instructorJasonWhite/c3-scout-robot/05-Factory-CarrierC-v10/README.txt

C3 SCOUT CARRIER C — FACTORY REVISION v10
2026-10-05 America/New_York

Upload these together:
1. C3-CarrierC-v10-Gerbers.zip
2. C3-CarrierC-v10-BOM.csv
3. C3-CarrierC-v10-CPL.csv

Board v10 / schematic v6 saved through Fusion MCP. Native DRC: zero errors; ERC: same 13 power-net-name warnings. 24 BOM groups / 45 placements: 44 SMT + C1 through-hole. Hand-install only U1 SuperMini.

Q1 C7419210; U4 C351410; C1 C713389; J5 C456012. USB-C footprint now has four 0.6 x 1.4 mm plated slots; finished copper lands 1.1 x 1.9 mm after Fusion pad rules. J5 CPL uses body centre (28.6,24), R90. C1 positive pad (23.75,14).

See UPLOAD-GUIDE.html for drawings, source, verification and protection-component qualification notes. New Gerbers are required; do not mix with v8. No order placed.
