instructorJasonWhite/c3-scout-robot/01-Electronics-CarrierC/Carrier-Review.html

SCOUT / Carrier C

Earlier design review · current release is Carrier C v10. Embedded diagrams and part selections below document the earlier design. Q1, U4, C1 and the USB-C connector have since been updated. Open the current factory package, BOM, board previews and Fusion PDFs.

NATIVE FUSION DESIGN · REV C

# A small board. A proper design.

One carrier for the whole rover. Charging, cell protection, motor control and clean logic power—organized around a solder-on ESP32-C3 SuperMini.

Explore the board ↘Schematic PDF ↓

Rebuilt and routed in Fusion Electronics through Fusion MCP.
Circuit review · 04 October 2026 · Silk 03 update · 05 October 2026 · Hardware validation pending.

Carrier C routed board with top and bottom traces

32 × 82 MM2 LAYERS / 1 OZ

Manufacturing corrections verified · Fusion board v8: all nine silk clearance findings, three mask slivers and three copper notches are resolved. Both Genies and component positions are preserved. Native DRC and unrouted count are zero. Read the corrected JLCPCB report ↗. Final CAM and prototype validation remain.

04organized schematic sheets

46fitted components / 56 references

0unrouted connections in Fusion

0reported board DRC errors

ERC contains 13 reviewed supply-name warnings. This is an electrically checked design review; physical fit, current, temperature and assembly availability still require confirmation.

01 / Circuit architecture

## Each function has a place.

Keep high motor current on the cell rail. Generate 5 V for the controller, and isolate its logic signals when the motor supply is off.

USB-C charge inputJ5 · separate 5.1 kΩ CC resistors

→

TP4056 chargerU3 · 500 mA nominal · two status LEDs

→

One 18650 cellJ1 · 4.2 V full · DW01A + FS8205A return protection

Protected cell + RUNF1 2 A hold · J4 offboard switch

→

Two power branchesVMOTOR → TC1508A
MT3608 → 5.10 V → D4

→

Drive + controlTwo N20 motors
SuperMini, ADC and TXU0104

01

### Charge & protect

The raw cell negative is kept separate from the protected ground. Charger thermal pad, bypass capacitors and both USB-C CC resistors are explicit in the schematic.

02

### Switch & regulate

The RUN switch disconnects the drive rail. A compact 4.7 µH boost stage supplies the SuperMini through a blocking diode; the motor supply follows the cell.

03

### Control & measure

A four-channel level translator drives the motor inputs. Pull-downs establish disabled defaults; a 330 kΩ / 100 kΩ divider filters the battery measurement.

Operating rule: RUN OFF while charging or programming. This circuit has no charge-and-run load sharing. TP4056 TEMP is grounded, so cell-temperature sensing is disabled.

02 / Native schematic

## Four sheets. Every part visible.

Functional boundaries, actual pin names, conventional symbols, local wiring and named nets. These previews are printed from the linked Fusion schematic.

01 Charging & protection02 Power & boost03 Controller & sensing04 Motor interface

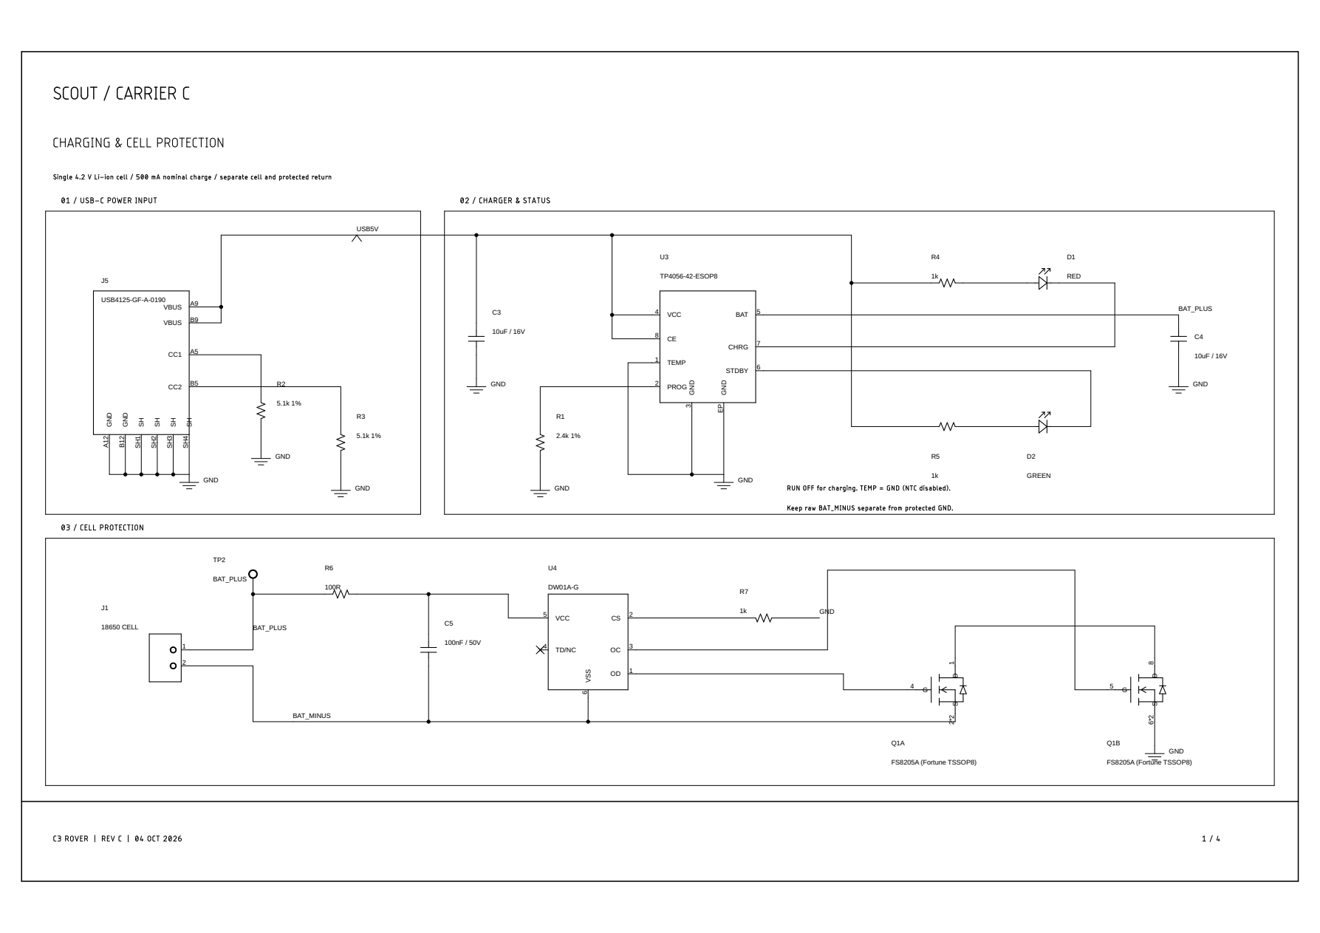
[picture p2: 01-Electronics-CarrierC/assets/schematic-1.png]
Native schematic sheet 1: Charging and cell protection


Sheet 1 / 4 · Charging and cell protection · Select the image to open the vector PDF.

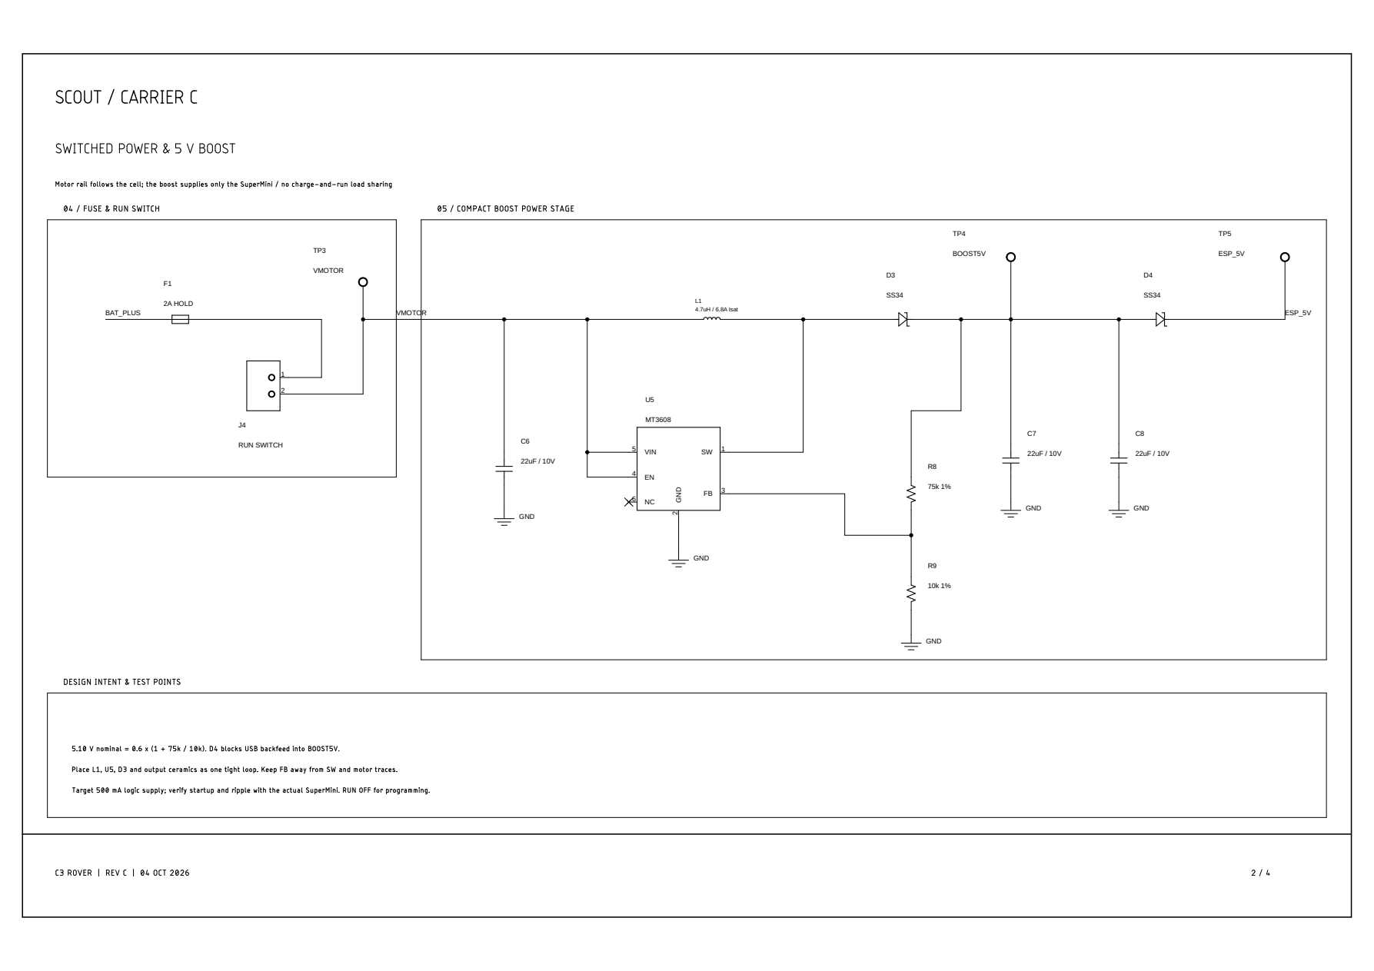
[picture p3: 01-Electronics-CarrierC/assets/schematic-2.png]
Native schematic sheet 2: Switched power and 5 V boost


Sheet 2 / 4 · Switched power and 5 V boost · Select the image to open the vector PDF.

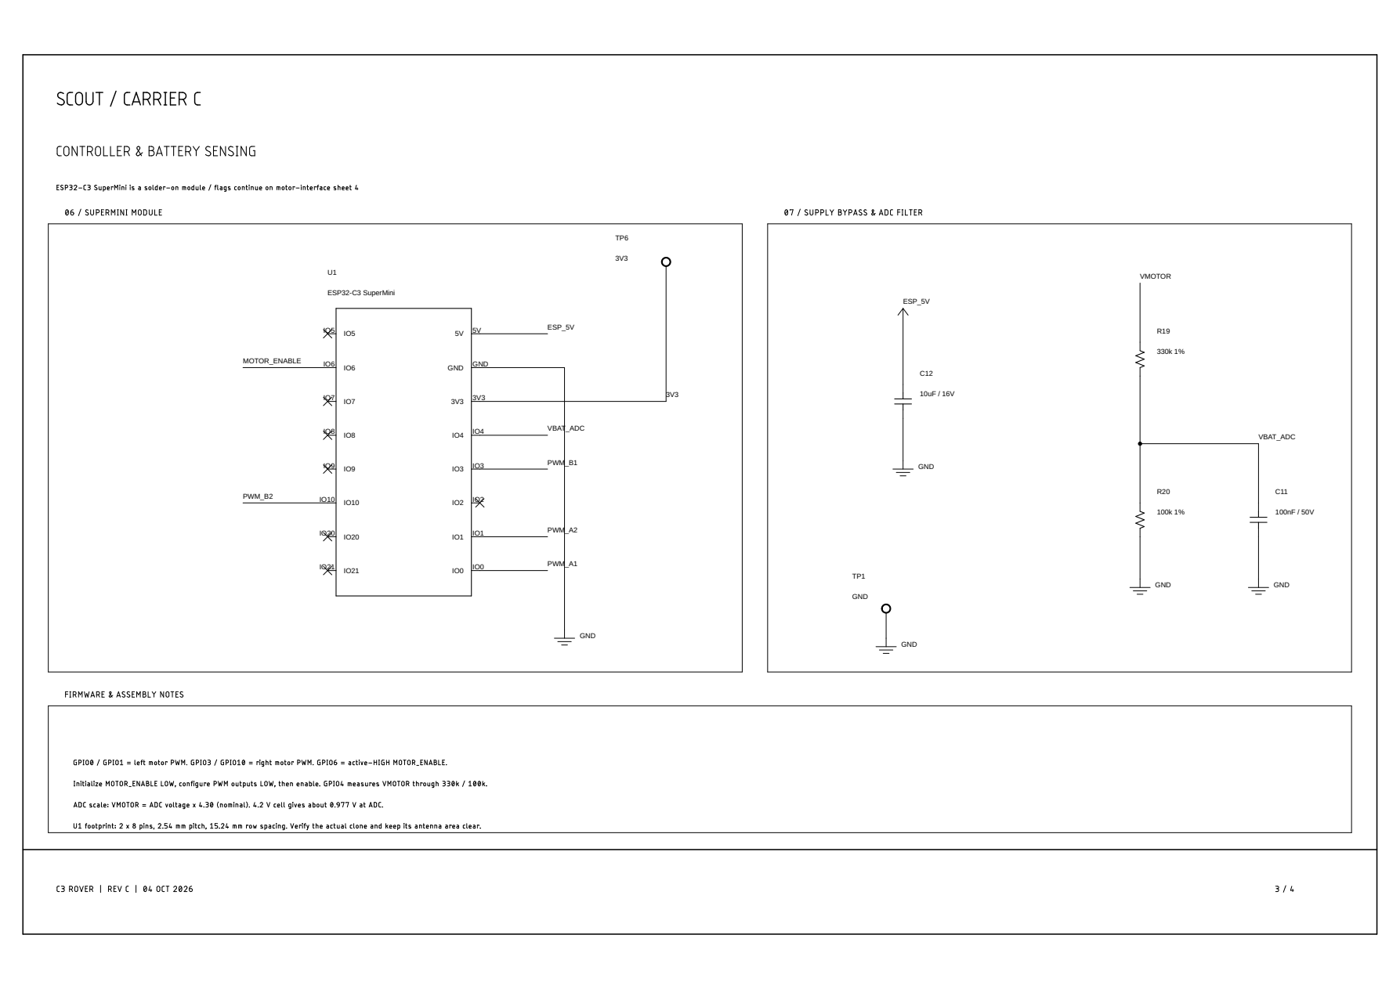
[picture p4: 01-Electronics-CarrierC/assets/schematic-3.png]
Native schematic sheet 3: Controller and battery sensing


Sheet 3 / 4 · Controller and battery sensing · Select the image to open the vector PDF.

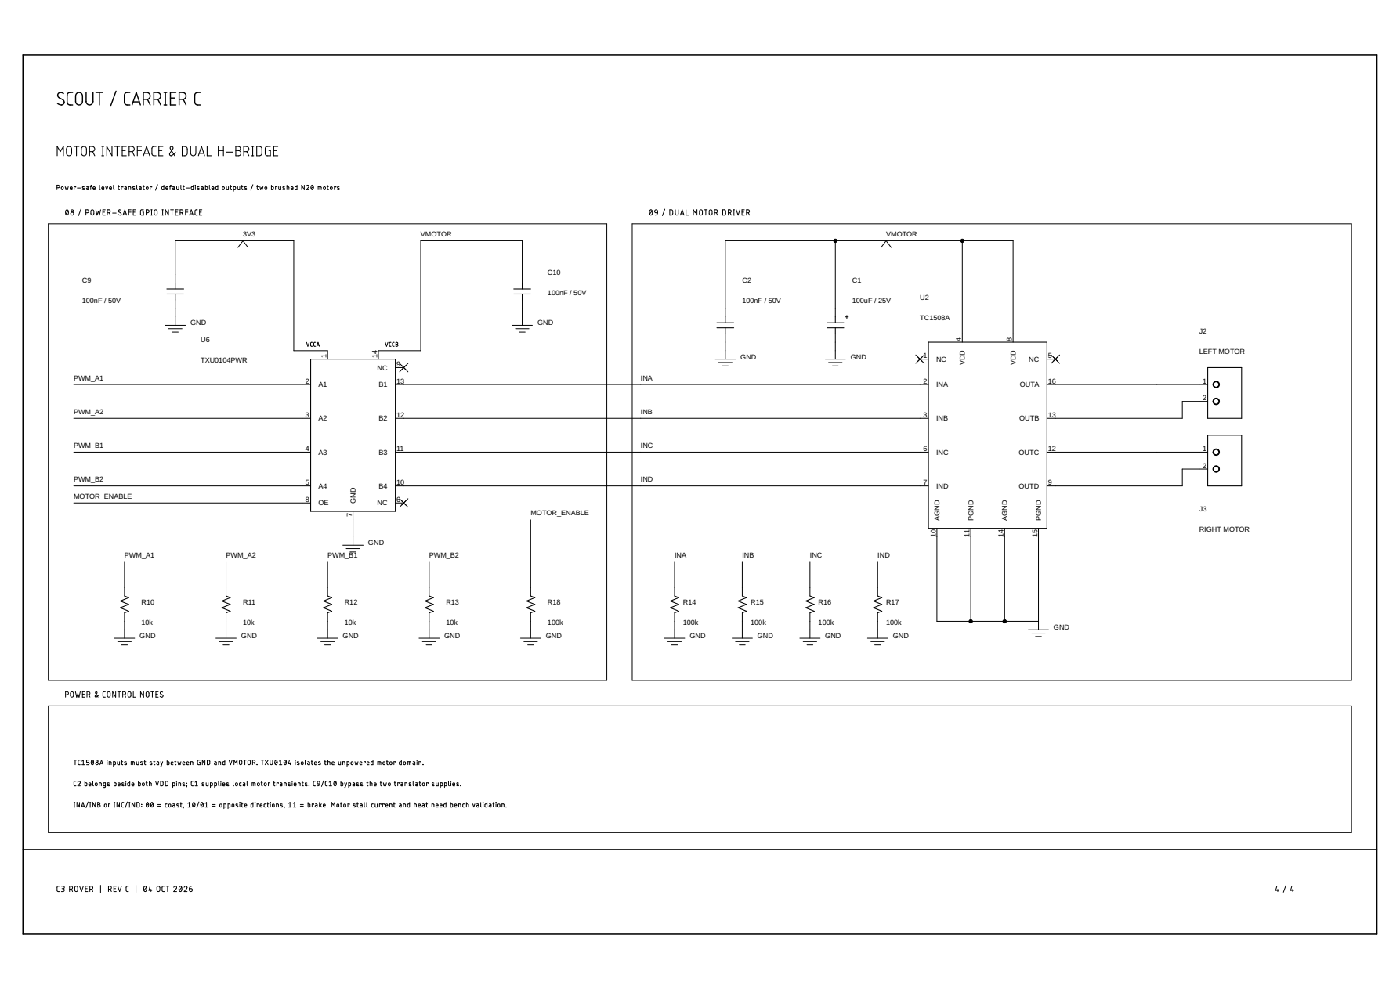
[picture p5: 01-Electronics-CarrierC/assets/schematic-4.png]
Native schematic sheet 4: Motor interface and dual H bridge


Sheet 4 / 4 · Motor interface and dual H bridge · Select the image to open the vector PDF.

Open all four sheets ↗Editable schematic ↓

03 / Placement & routing

## Follow the copper.

Choose a net to isolate its traces. Select a reference to see its value, footprint, position and connections. Both layers are viewed from the top.

Top copperBottom copper

### Board explorer

Top traces and padsBottom traces and padsComponent referencesHighlight a netFind a component

EnlargeReset

Selected component

### U5

MT3608 · 5 V boost regulator

Click any reference on the board to inspect the native placement.

Coordinate-based view of the exported Fusion board. Ground fills are omitted to expose routing. Hatched zones show antenna and M3 screw clearance. Body outlines are assembly graphics.

### Motor end

U2 sits beside the two motor wire pads. C1 supplies transient current; C2 bypasses the driver rail. Motor routing uses 0.6 mm traces with wider supply spines.

### Power island

The USB input and charger share the side opening. U4/Q1 protect the cell return. L1/U5/D3 and the boost capacitors form the regulation section.

### Controller end

The SuperMini sits above the carrier with an antenna cutout. C11/R19/R20 form the ADC filter. Four 3.4 mm holes preserve the M3 chassis interface.

Native board prints: top traces, bottom traces, assembly and underside labels

Fusion’s native trace print retains solid restriction overlays at the antenna and screws. The PDF explains these explicitly; they represent copper exclusions. Ground fills are hidden for trace review.

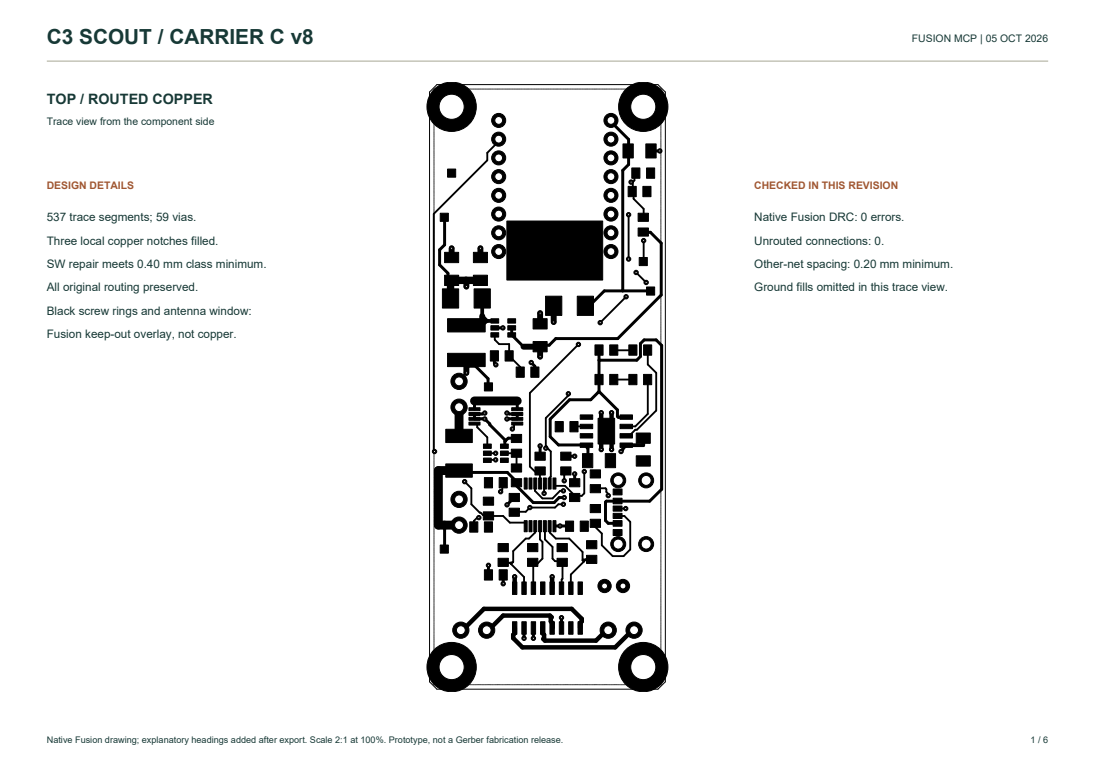
[picture p6: 01-Electronics-CarrierC/assets/layout-1.png]
Top traces, fills hidden


Top traces, fills hidden

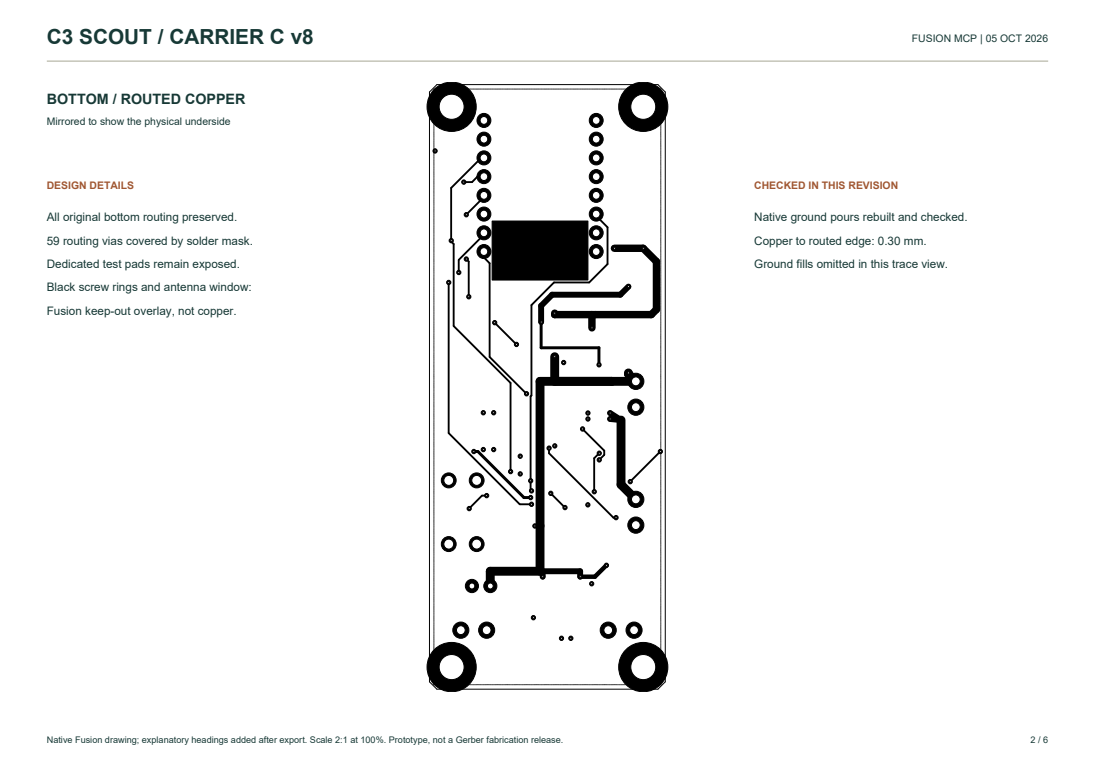
[picture p7: 01-Electronics-CarrierC/assets/layout-2.png]
Bottom traces, viewed through top


Bottom traces, viewed through top

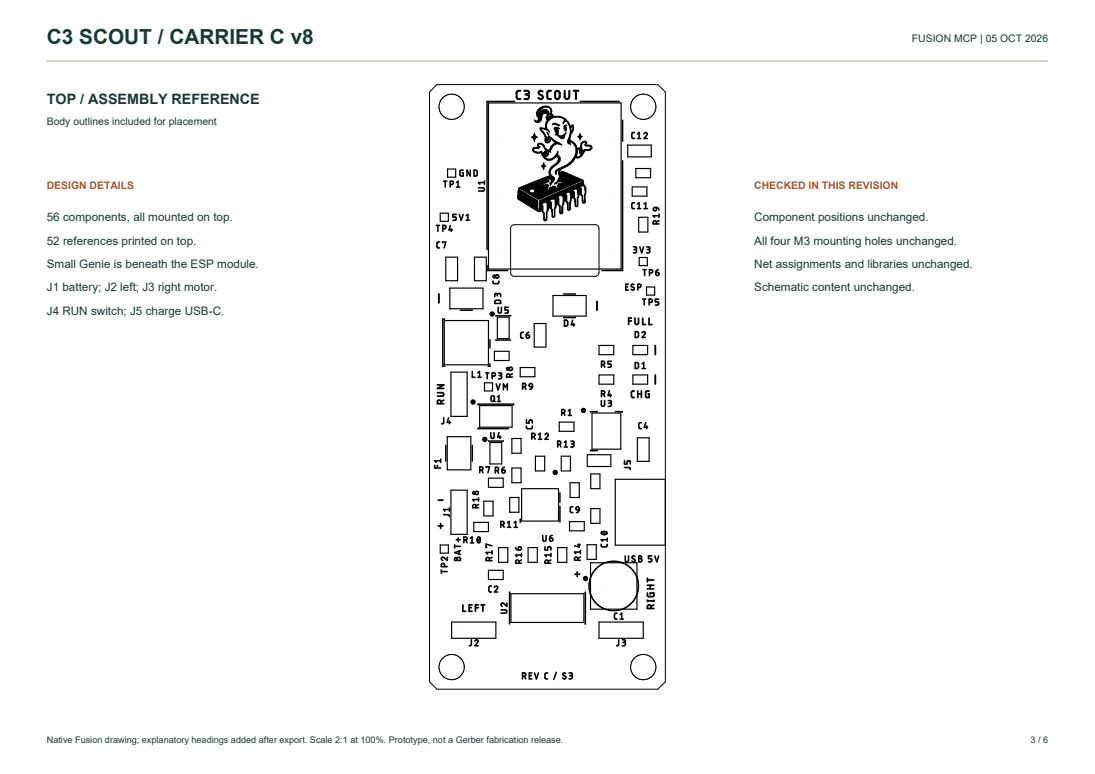
[picture p8: 01-Electronics-CarrierC/assets/layout-3.png]
Top assembly references


Top assembly references

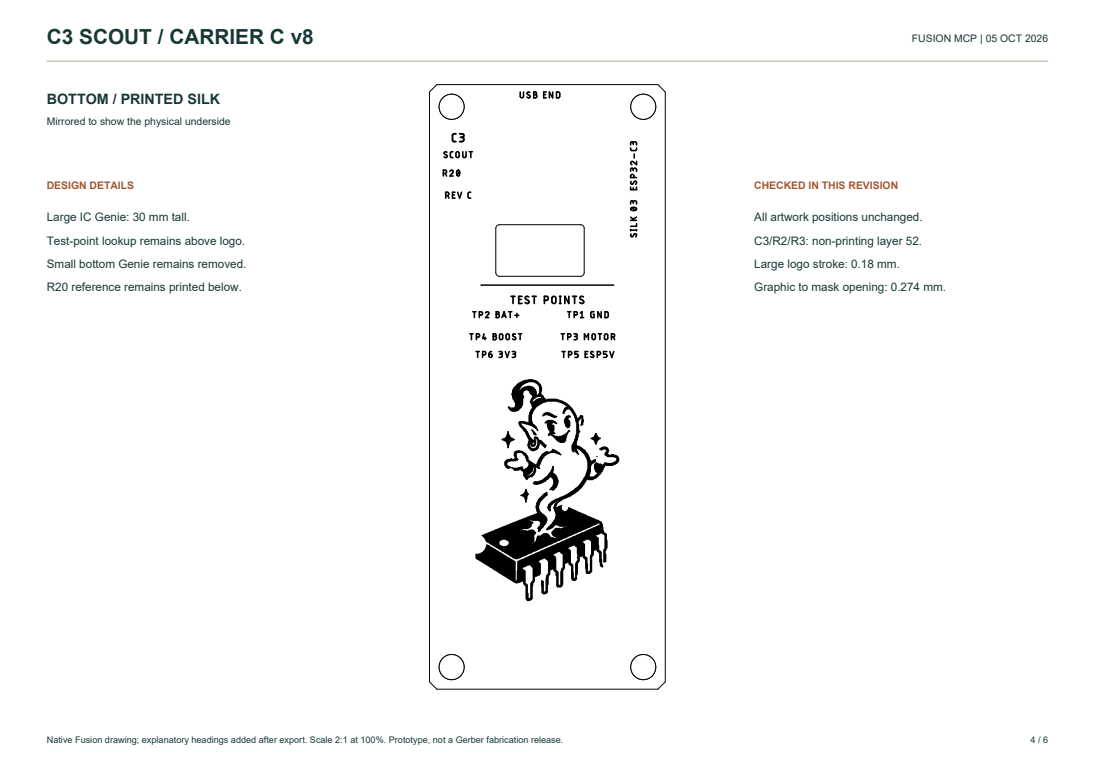
[picture p9: 01-Electronics-CarrierC/assets/layout-4.png]
Underside service silkscreen / Silk 03


Underside service silkscreen / Silk 03

Board layout PDF ↓

04 / Assembly & operation

## Designed to be understood.

All components are on the top. The underside carries readable reference labels. Hand-solder the SuperMini, USB connector and radial bulk capacitor.

### External connections

Reference | Connection | Notes
J1 | 18650 cell | 1 = BAT_PLUS; 2 = raw BAT_MINUS
J2 | Left N20 motor | 1 = OUTA; 2 = OUTB
J3 | Right N20 motor | 1 = OUTC; 2 = OUTD
J4 | RUN switch | 1 = fused battery; 2 = VMOTOR. Use ≥3 A DC switch.
J5 | USB-C charging | 5 V input. No USB data.
U1 USB | Programming | RUN OFF. Verify actual SuperMini clone pinout.

### Controller assignments

GPIO | Function
0 / 1 | Left motor PWM_A1 / PWM_A2
3 / 10 | Right motor PWM_B1 / PWM_B2
6 | MOTOR_ENABLE, active high
4 | VMOTOR ADC; nominal voltage = ADC × 4.30

### Firmware startup intent

Control sequence for implementation; no new firmware is supplied in this revision.

Hold MOTOR_ENABLE low

R18 also holds the translator disabled during startup.

Configure all four PWM outputs low

Input and output pull-downs prevent floating motor commands.

Measure the cell rail

Calibrate GPIO4 ADC. A full 4.2 V cell produces about 0.977 V at the divider.

Enable drive only when ready

Raise GPIO6, then apply PWM. Stop on undervoltage or control loss; choose the threshold for the actual cell and load.

Disable before charging or programming

Set outputs low, disable drive and turn RUN OFF.

### Bench measurement points

TP1 / TP2 | Protected GND / raw cell positive
TP3 | Switched cell rail, VMOTOR
TP4 / TP5 | 5.10 V nominal boost / diode-isolated ESP_5V
TP6 | SuperMini 3V3

Fit checks before fabrication: confirm the actual SuperMini’s 15.24 mm row spacing and 2.54 mm pitch. J5 retains four 1.35 mm round shell holes from the chassis design instead of the connector’s recommended 0.6 × 1.2 mm slots; trial-fit its stakes. Carrier C preserves the board outline and mounting interface; the chassis 3D assembly has not been regenerated in this electrical revision.

05 / Sourcing

## Orderable parts. Visible exceptions.

27 grouped BOM rows cover all 56 references. 43 components are SMT assembly candidates; 3 are planned for hand assembly. Ten references are PCB wire pads or test points.

### Catalog matched

Motor driver, charger, MOSFET, boost IC, translator, inductor, capacitors and common passives have specific JLC/LCSC candidate codes.

### Stock is unresolved

Fortune DW01A-G is cataloged by JLC, but LCSC reports it unavailable. R1, R8 and R19 have LCSC matches; their JLC assembly availability is unverified.

### Quote when ready

Catalog presence is not a stock reservation. No live assembly quote or purchase is included. Recheck stock, extended-part fees and placement rotations when ordering.

BOM workbook ↓

27 grouped rows

References / package | Qty | Specification | Exact candidate | Assembly status | Source / notes
U12 x 8 / 2.54 mm | 1 | ESP32-C3 SuperMiniUser module | ESP32-C3 SuperMini | Hand solderUser supplied | User / PCB featureVerify clone pinout and 15.24 mm row spacing. Antenna over cutout; component side above carrier.
U2SOP-16 | 1 | Dual motor driverShenzhen Fuman | TC1508AC5142992 | ExtendedJLC catalog confirmed; stock not verified | Catalog ↗ (https://jlcpcb.com/partdetail/Shenzhen_FumanElec-TC1508A/C5142992)Validate actual N20 stall current and package temperature.
U3ESOP-8 with exposed pad | 1 | 500 mA chargerTop Power | TP4056-42-ESOP8C16581 | ExtendedJLC catalog confirmed; stock not verified | Catalog ↗ (https://jlcpcb.com/partdetail/TP4056-42-ESOP8/C16581)R1 = 2.4 kohm. RUN OFF while charging. TEMP grounded; no cell-temperature sensing.
U4SOT-23-6 | 1 | Cell protectionFortune | DW01A-GC61503 | ExtendedJLC catalog confirmed; LCSC reports unavailable | Catalog ↗ (https://jlcpcb.com/partdetail/FortuneSemicon-DW01AG/C61503)Source or pre-order exact part. Do not substitute DW01+ without reviewing thresholds.
Q1TSSOP-8 | 1 | Dual common-drain N-MOSFETFortune | FS8205AC14212 | ExtendedJLC catalog confirmed; stock not verified | Catalog ↗ (https://jlcpcb.com/partdetail/LCSC-FS8205A/C14212)Exact Fortune TSSOP-8 pinout. SOT-23-6 parts sharing the name are not equivalent.
U5SOT-23-6 | 1 | 5.10 V boostAerosemi | MT3608C84817 | ExtendedJLC catalog confirmed; stock not verified | Catalog ↗ (https://jlcpcb.com/partdetail/C84817)Nominal 0.6 x (1 + 75k/10k). D4 drop precedes SuperMini 5V input.
U6TSSOP-14 | 1 | 4-channel level translatorTexas Instruments | TXU0104PWRC2938871 | ExtendedJLC catalog confirmed; stock not verified | Catalog ↗ (https://jlcpcb.com/partdetail/TexasInstruments-TXU0104PWR/C2938871)OE pulled low; separates 3V3 control from switched motor domain.
L16 x 6 x 4.5 mm max | 1 | 4.7 uH / 4.5 A Irms / 6.8 A IsatBourns | SRN6045TA-4R7MC2044594 | ExtendedJLC catalog confirmed; stock not verified | Catalog ↗ (https://jlcpcb.com/partdetail/BOURNS-SRN6045TA4R7M/C2044594)Manufacturer land pattern: 5.1 x 1.8 mm pads, 4.7 mm centers. Footprint updated in Fusion.
D3, D4SMA | 2 | SS34 / 3 A / 40 VMDD | SS34C8678 | BasicJLC catalog confirmed; stock not verified | Catalog ↗ (https://jlcpcb.com/partdetail/Mdd-SS34/C8678)Pad 1 = cathode.
F11812 | 1 | 2 A hold / 16 V PTCLittelfuse | 1812L200/16DRC439873 | ExtendedJLC catalog confirmed; stock not verified | Catalog ↗ (https://jlcpcb.com/partdetail/Littelfuse-1812L20016DR/C439873)3.5 A trip rating; temperature derating applies.
D10805 | 1 | Red indicatorNationStar | NCD0805R1C84256 | BasicJLC catalog confirmed; stock not verified | Catalog ↗ (https://jlcpcb.com/partdetail/NCD0805R1/C84256)Footprint pad 1 = anode; verify assembly-library rotation.
D20805 | 1 | Green indicatorKento | KT-0805GC2297 | BasicJLC catalog confirmed; stock not verified | Catalog ↗ (https://jlcpcb.com/partdetail/Hubei_KentoElec-KT0805G/C2297)Footprint pad 1 = anode; verify assembly-library rotation.
C1Radial 6.3 x 11.2 mm; 2.5 mm pitch | 1 | 100 uF / 25 V / low impedancePanasonic | EEUFR1E101 | Hand solderManufacturer dimensions verified; distributor quote required | Catalog ↗ (https://industrial.panasonic.com/kr/products/pt/aluminum-cap-lead/models/EEUFR1E101)Positive pad 1. 455 mA rms ripple at 100 kHz; 130 mohm impedance max.
C2, C5, C9, C10, C110805 | 5 | 100 nF / 50 V / X7R / 10%Samsung | CL21B104KBCNNNCC1711 | CatalogJLC catalog confirmed; stock not verified | Catalog ↗ (https://jlcpcb.com/partdetail/CL21B104KBCNNNC/C1711)
C3, C4, C121206 | 3 | 10 uF / 16 V / X7R / 10%Murata | GRM31CR71C106KA12LC97954 | ExtendedJLC catalog confirmed; stock not verified | Catalog ↗ (https://jlcpcb.com/partdetail/MurataElectronics-GRM31CR71C106KA12L/C97954)
C6, C7, C81206 | 3 | 22 uF / 10 V / X7R / 20%KEMET | C1206C226M8RACTUC2167682 | ExtendedJLC catalog confirmed; stock not verified | Catalog ↗ (https://jlcpcb.com/partdetail/KEMET-C1206C226M8RACTU/C2167682)Confirm effective capacitance under DC bias when qualifying the boost supply.
R10805 | 1 | 2.4 kohm / 1% / 0.125 WUNI-ROYAL | 0805W8F2401T5EC17526 | VerifyLCSC catalog confirmed; JLC availability unverified | Catalog ↗ (https://www.lcsc.com/product-detail/C17526.html)
R2, R30805 | 2 | 5.1 kohm / 1% / 0.125 WUNI-ROYAL | 0805W8F5101T5EC27834 | BasicJLC catalog confirmed; stock not verified | Catalog ↗ (https://jlcpcb.com/partdetail/0805W8F5101T5E/C27834)
R4, R5, R70805 | 3 | 1 kohm / 1% / 0.125 WUNI-ROYAL | 0805W8F1001T5EC17513 | BasicJLC catalog confirmed; stock not verified | Catalog ↗ (https://jlcpcb.com/partdetail/0805W8F1001T5E/C17513)
R60805 | 1 | 100 ohm / 1% / 0.125 WUNI-ROYAL | 0805W8F1000T5EC17408 | BasicJLC catalog confirmed; stock not verified | Catalog ↗ (https://jlcpcb.com/partdetail/0805W8F1000T5E/C17408)
R80805 | 1 | 75 kohm / 1% / 0.125 WUNI-ROYAL | 0805W8F7502T5EC17819 | VerifyLCSC catalog confirmed; JLC availability unverified | Catalog ↗ (https://www.lcsc.com/product-detail/C17819.html)
R9, R10, R11, R12, R130805 | 5 | 10 kohm / 1% / 0.125 WUNI-ROYAL | 0805W8F1002T5EC17414 | BasicJLC catalog confirmed; stock not verified | Catalog ↗ (https://jlcpcb.com/partdetail/0805W8F1002T5E/C17414)
R14, R15, R16, R17, R18, R200805 | 6 | 100 kohm / 1% / 0.125 WUNI-ROYAL | 0805W8F1003T5EC149504 | BasicJLC catalog confirmed; stock not verified | Catalog ↗ (https://jlcpcb.com/partdetail/0805W8F1003T5E/C149504)
R190805 | 1 | 330 kohm / 1% / 0.125 WUNI-ROYAL | 0805W8F3303T5EC17629 | VerifyLCSC catalog confirmed; JLC availability unverified | Catalog ↗ (https://www.lcsc.com/product-detail/C17629.html)
J5USB4125 custom round-stake footprint | 1 | USB-C power inputGCT | USB4125-GF-A-0190 | Hand solderManufacturer part selected; JLC listing not found | Catalog ↗ (https://gct.co/connector/usb4125)Round 1.35 mm shell holes retained. Trial-fit connector before ordering boards; manufacturer drawing specifies slots.
J1, J2, J3, J42-wire solder pads, 3.5 mm pitch | 4 | Battery / motors / RUN switchPCB feature | No fitted connector | PCB featureNo purchased component | User / PCB featureJ4 connects to external switch rated at least 3 A DC. Harness is outside carrier BOM.
TP1, TP2, TP3, TP4, TP5, TP61.1 mm exposed pad | 6 | Rail test pointPCB feature | Test pad | PCB featureNo purchased component | User / PCB feature

Package-specific choices matter. Q1 is the Fortune FS8205A in TSSOP-8, not a same-marking SOT-23 device. L1 uses the Bourns SRN6045TA-4R7M recommended footprint. C1 is the 25 V Panasonic part with 2.5 mm lead spacing.

Silk 03 / 05 October 2026

## Clearer assembly. A finished identity.

Saved in Fusion as Carrier C v8. All 56 component references remain attached to their parts: 52 on top, one below, three on non-printing assembly layer 52. Artwork and placement are unchanged; v8 includes the local copper and mask corrections.

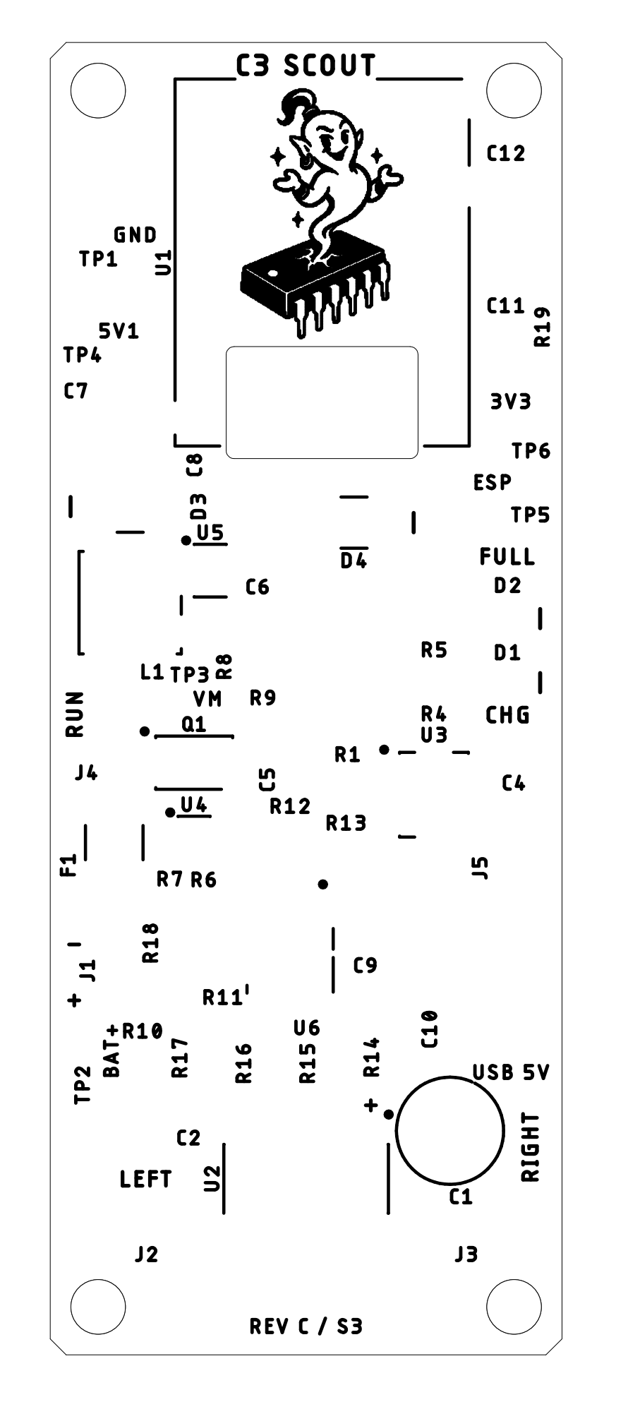
[picture p10: 01-Electronics-CarrierC/assets/top-silk.png]
Native top silkscreen artwork


Top: small IC Genie beneath the ESP, connector labels, polarity, pin 1 and assembly references.

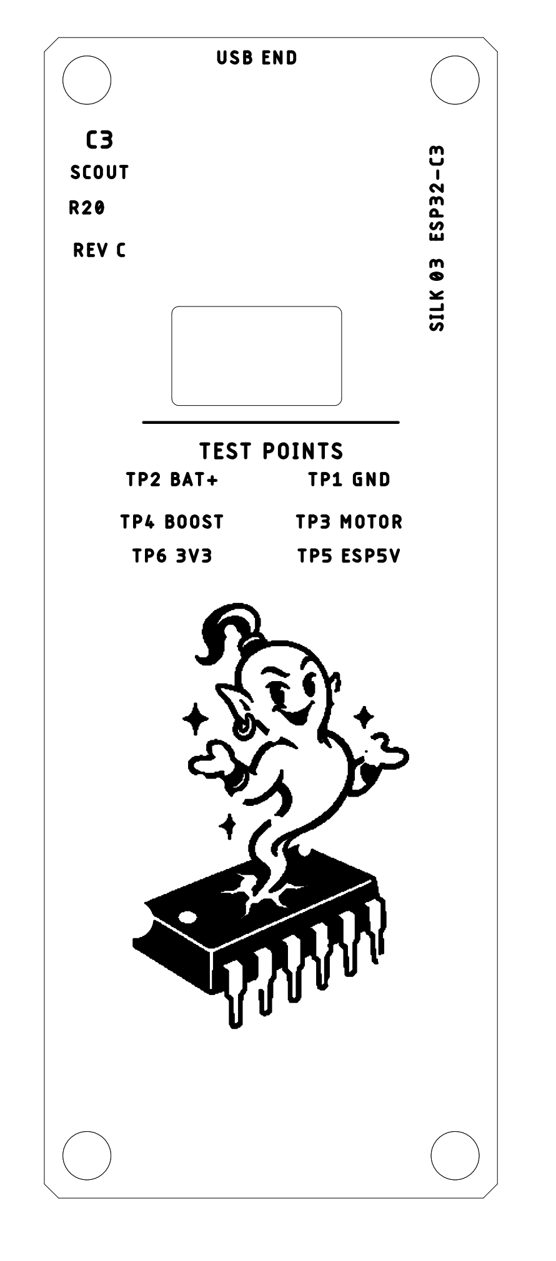
[picture p11: 01-Electronics-CarrierC/assets/bottom-silk.png]
Native bottom silkscreen artwork


Bottom: large IC Genie mascot, compact identity and test-point key.

Explore the silkscreenSilkscreen PDF

Native DRC: 0 errors. Text: at least 1.0 mm high with 0.20 mm strokes. R20 is printed underneath; C3/R2/R3 remain on non-printing assembly layer 52. Verification report.

06 / Verification record

## Measured checks. Documented limits.

The files below contain the actual native Fusion ERC/DRC results and independent connectivity and geometry audit results.

✓

Fusion DRC: 0 errors

Full board check, including copper restrictions, drill clearance and silkscreen checks. No remaining unrouted connections.

✓

Linked schematic and board

56 references, 37 nets and 162 connected contacts match. All native values and packages match. 173 schematic symbol pins inspected.

✓

Independent geometry audit

771 discrete copper objects checked. 537 trace segments and 59 vias. Minimum observed clearance 0.20 mm; minimum drill gap 0.50 mm.

✓

Native drawings visually reviewed

Four schematic sheets, both trace layers, top assembly and the Silk 03 printed artwork. The sourcing workbook covers every reference exactly once.

The independent geometry audit covers discrete traces, pads and vias. Native Fusion DRC verifies filled-plane connectivity and clearance; the independent checker does not reproduce Fusion’s pour engine.

Hardware validation remains

### Before ordering a batch

Trial-fit U1 and J5. Check the actual motor stall current, driver temperature, protection trip behavior and 500 mA charge temperature. Measure boost startup, Wi-Fi load transients and ripple on the actual SuperMini.

Review component orientation in JLC’s assembly preview and resolve the DW01A sourcing gap. No pick-and-place file or fabrication release is claimed from these checks alone.

The electrical design is saved in Fusion as C3 Carrier C. Rev B is preserved.

Why 13 ERC warnings remain

All are Fusion code 104 supply-pin naming warnings. A power pin’s generic name differs from its intentionally named circuit rail—for example VDD on VMOTOR. The DW01A VSS connection to BAT_MINUS is intentional and preserves cell protection. These warnings remain visible in the native report; they are not silently deleted.

Part | Supply pin | Connected net
U1 | 5V | ESP_5V
U2 | VDD | VMOTOR
U2 | VDD | VMOTOR
U2 | AGND | GND
U2 | PGND | GND
U2 | AGND | GND
U2 | PGND | GND
U3 | VCC | USB5V
U4 | VCC | DW_VCC
U4 | VSS | BAT_MINUS
U5 | VIN | VMOTOR
U6 | VCCA | 3V3
U6 | VCCB | VMOTOR

JLCPCB-based design rules

Parameter | Carrier C | Basis / interpretation
Stackup | 2 layers, 1.6 mm FR-4, 1 oz | Ordinary two-layer process
Trace width | 0.20 mm rule; 0.254 mm actual minimum | Above JLC’s listed 0.10 mm minimum for 1 oz two-layer copper
Copper spacing | 0.20 mm | Conservative margin above process minimum
Via drill / diameter | 0.30 / 0.60 mm | 0.15 mm annular ring
PTH annular ring | ≥0.25 mm | JLC recommended value
Drill spacing | ≥0.45 mm rule; 0.50 mm observed | Hole-edge to hole-edge
Copper to routed edge | ≥0.30 mm | Also enforced around antenna cutout
M3 screws | 3.4 mm NPTH; 3.35 mm copper exclusion radius | Cap-head clearance around all four mounts

Source: JLCPCB PCB capabilities (https://jlcpcb.com/capabilities/pcb-capabilities/), reviewed 04 October 2026. The included DRU is a user-generated conservative profile based on those capabilities, not an official JLC-issued rule file.

07 / Review package

## Keep the editable source.

Native electrical files, checked drawings, sourcing information and verification evidence in one folder.

Schematic PDF ↗4 native Fusion sheets · A3 landscapeBoard layout PDF ↗6 native board views, including both mask layersSourcing BOM ↓Filterable workbook · exact candidates and source linksEditable schematic ↓Fusion-exported EAGLE-compatible SCHEditable routed board ↓Matching native BRD exportComponent library ↓Symbols, packages and device pin mappingsDesign rule profile ↓JLCPCB-based conservative rulesNative check summary ↗Linked status and ERC / DRC countsWhole robot project ↗Return to the project file index

Detailed evidence: ERC warnings · DRC results · Connectivity audit · Geometry audit

SCOUT / CARRIER C
One-cell, two-motor rover carrier.Fusion MCP · native schematic + routed PCB
Design review, 04 October 2026
