instructorJasonWhite/c3-scout-robot/01-Electronics-CarrierC/Silkscreen-Review.html

Earlier design review · current release is Carrier C v10. Embedded diagrams and part selections below document the earlier design. Q1, U4, C1 and the USB-C connector have since been updated. Open the current factory package, BOM, board previews and Fusion PDFs.

C3 SCOUT / CARRIER C / SILK 03

# Read the board at a glance.

Your IC Genie artwork on both faces: the compact 15.6 mm mascot is on the top silkscreen beneath the ESP module, and the 30 mm mascot remains underneath below the test-point legend. The updated silkscreen is saved in Fusion; the circuit and component positions are unchanged.

Manufacturing corrections verified · Fusion board v8: all nine silk clearance findings, three mask slivers and three copper notches are resolved. Both Genies and component positions are preserved. Native DRC and unrouted count are zero. Read the corrected JLCPCB report ↗. Final CAM and prototype validation remain.

56component-linked references

0native Fusion DRC errors

1.0 mmminimum text height

0.20 mmminimum text stroke

Silkscreen PDFBoard layout PDFEditable Fusion board

Printed silk Show assembly outlines

Actual top silkscreen printed in Fusion

Top / Assembly and wiringSmall genie under ESP, 52 references, connector functions, polarity and pin-one marks.

Actual underside silkscreen printed in Fusion, mirrored for reading

Bottom / IC Genie and test pointsPhysical underside view. The large mascot stays below the test points. The small mascot has moved to the top face under the ESP.

## Assemble with confidence

Solid dots mark pin 1 on the six IC packages. Cathode bars follow the actual schematic mapping: LED pad 2 and rectifier pad 1. Battery and electrolytic polarity are explicit.

## Legible after assembly

References sit outside component bodies where space allows. R20 remains beneath its component. C3, R2 and R3 are retained on non-printing assembly layer 52, keeping the lower artwork clear. All 56 references remain attached to their components.

## A consistent identity

The supplied IC Genie is converted to native silkscreen strokes. The small top-side mascot sits between the ESP header pads and is covered by the installed module. The large underside mascot stays below the test-point legend. The small top logo has no flagged pad-clearance location; the underside logo now clears exposed pads after tenting the routing vias, as documented in the corrected manufacturing review.

Verified: zero DRC errors and zero unrouted connections. Artwork, placement, holes and library geometry match the cleaned v7 export. Manufacturing corrections update via masking, mask rules and three local copper notches. Comparison report · Fusion save record · Matching schematic.
Text remains at least 1.0 mm high with 0.20 mm strokes. The small and large mascots use 0.15 mm and 0.18 mm native strokes, respectively, meeting JLCPCB's published minimum stroke (https://jlcpcb.com/capabilities/pcb-capabilities/). This remains a prototype design; the existing electrical and mechanical validation work is unchanged.

Native drawings printed through the Fusion MCP server. Only board-outline registration and the selected drawing layers are shown; the assembly toggle includes non-printing library body outlines.
Silkscreen update / 05 October 2026
