instructorJasonWhite/c3-scout-robot/01-Electronics-CarrierC/assets/IC-Genie-source.png

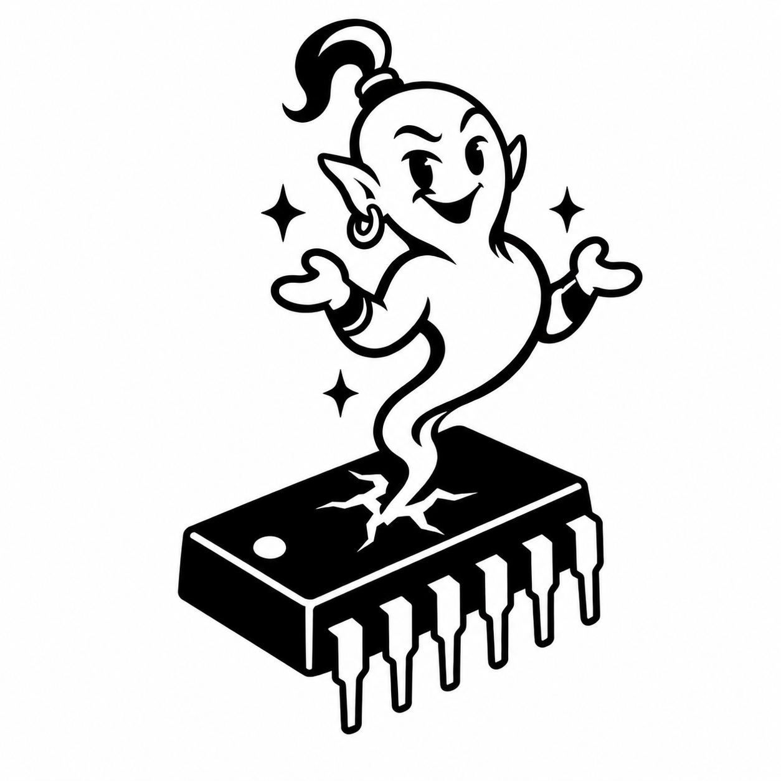
01-Electronics-CarrierC/assets/IC-Genie-source.png
