instructorJasonWhite/c3-scout-robot/02-Mechanical-RevB/C3-Carrier-rover.png

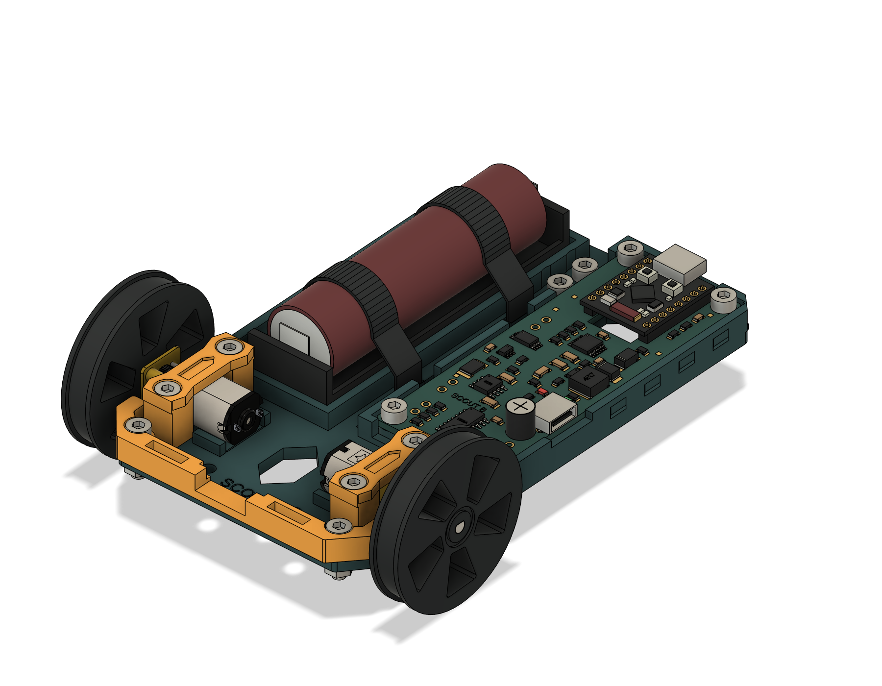
02-Mechanical-RevB/C3-Carrier-rover.png
