instructorJasonWhite/c3-scout-robot/02-Mechanical-RevB/Carrier-in-bay.png

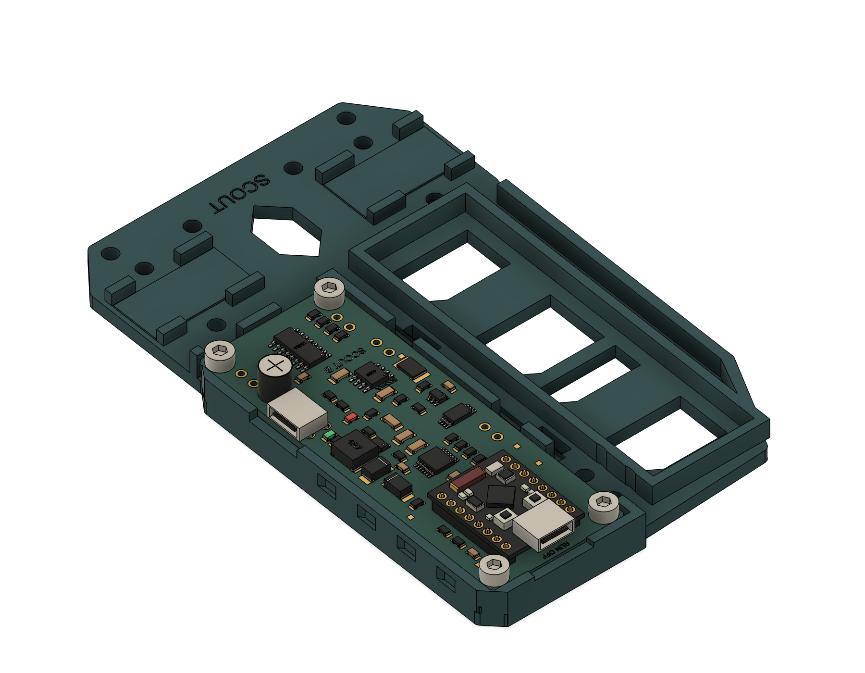
02-Mechanical-RevB/Carrier-in-bay.png
