instructorJasonWhite/c3-scout-robot/02-Mechanical-RevB/Integral-chassis.png

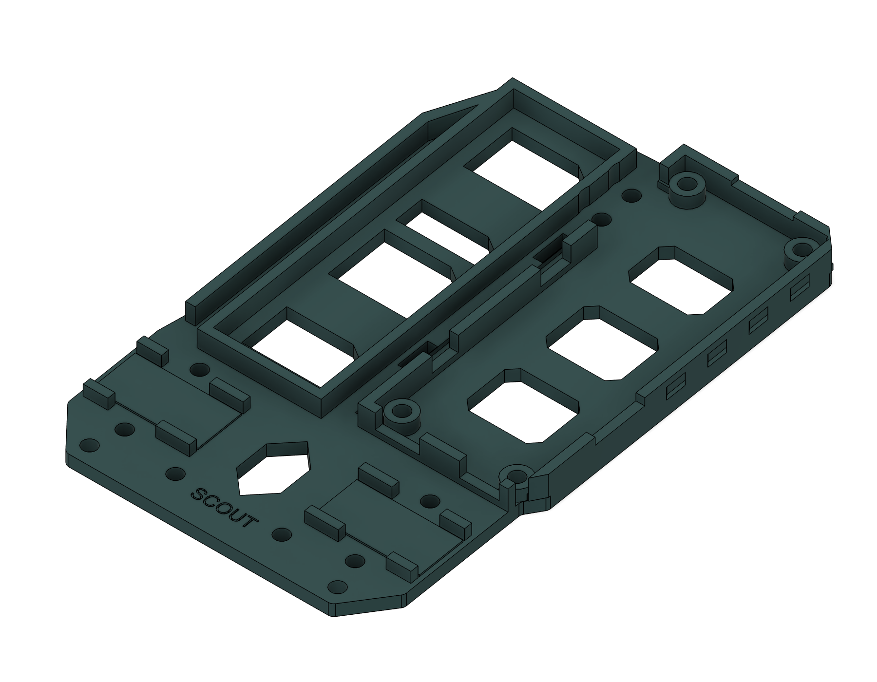
02-Mechanical-RevB/Integral-chassis.png
