instructorJasonWhite/c3-scout-robot/02-Mechanical-RevB/Populated-Carrier-RevB.png

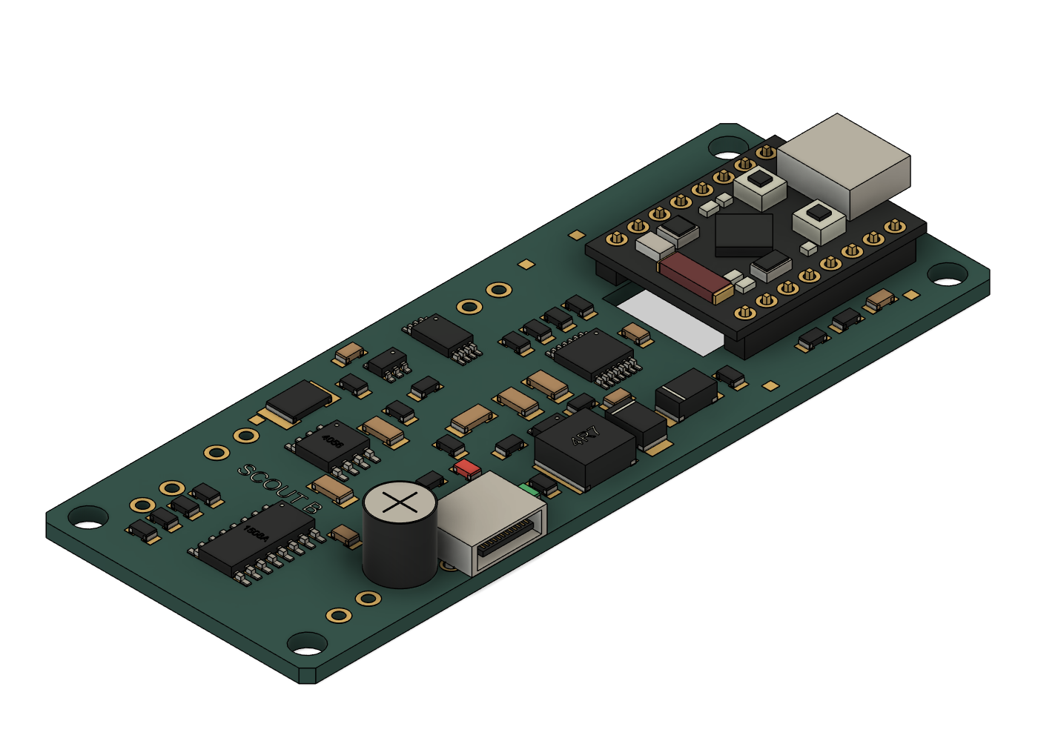
02-Mechanical-RevB/Populated-Carrier-RevB.png
