instructorJasonWhite/c3-scout-robot/07-Bumper-Options/ESP32-CAM/mount-with-camera.png

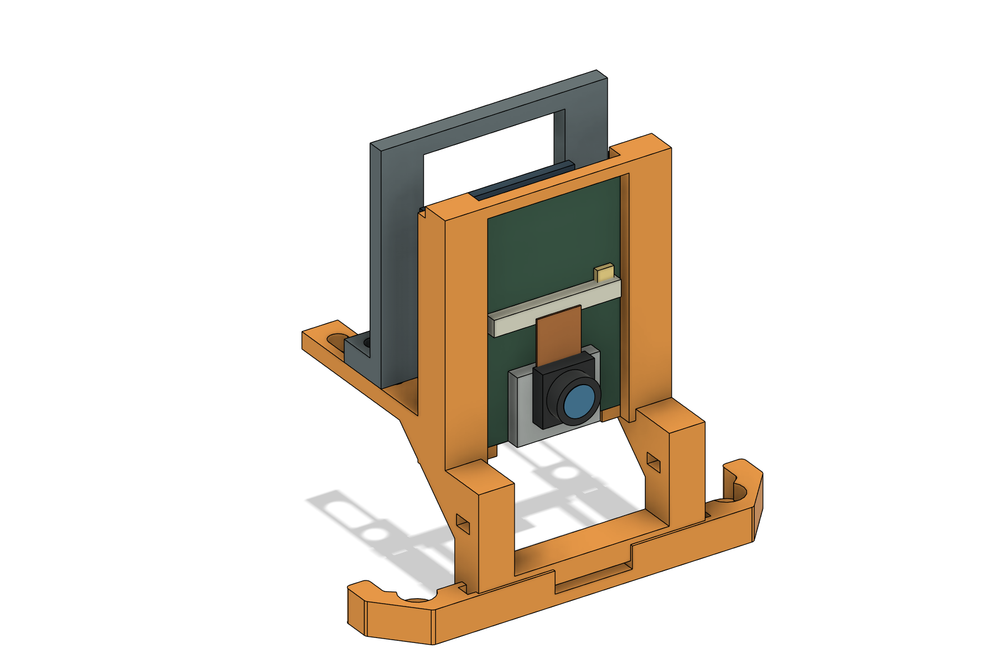
07-Bumper-Options/ESP32-CAM/mount-with-camera.png
