instructorJasonWhite/c3-scout-robot/07-Bumper-Options/ESP32-CAM/scout-camera-detail.png

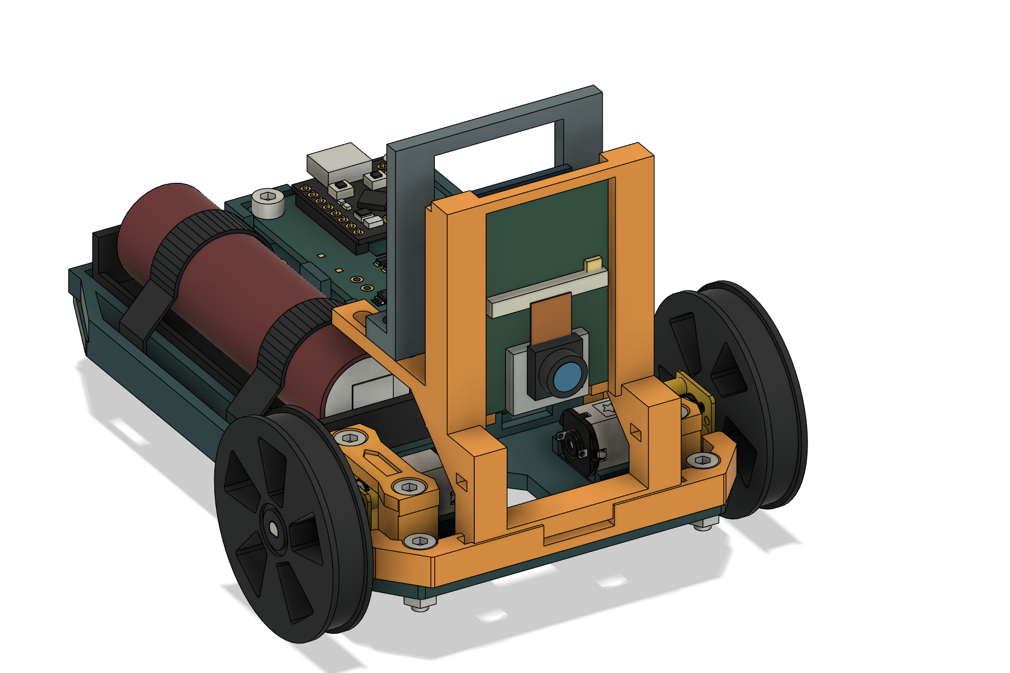
07-Bumper-Options/ESP32-CAM/scout-camera-detail.png
