instructorJasonWhite/c3-scout-robot/07-Bumper-Options/OLED/bumper-with-oled.png

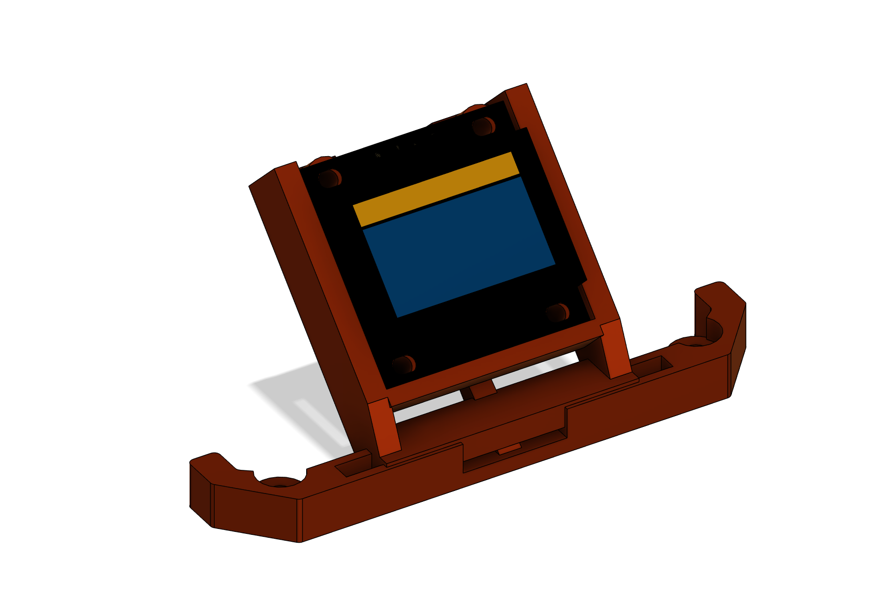
07-Bumper-Options/OLED/bumper-with-oled.png
