instructorJasonWhite/c3-scout-robot/07-Bumper-Options/OLED/scout-oled-detail.png

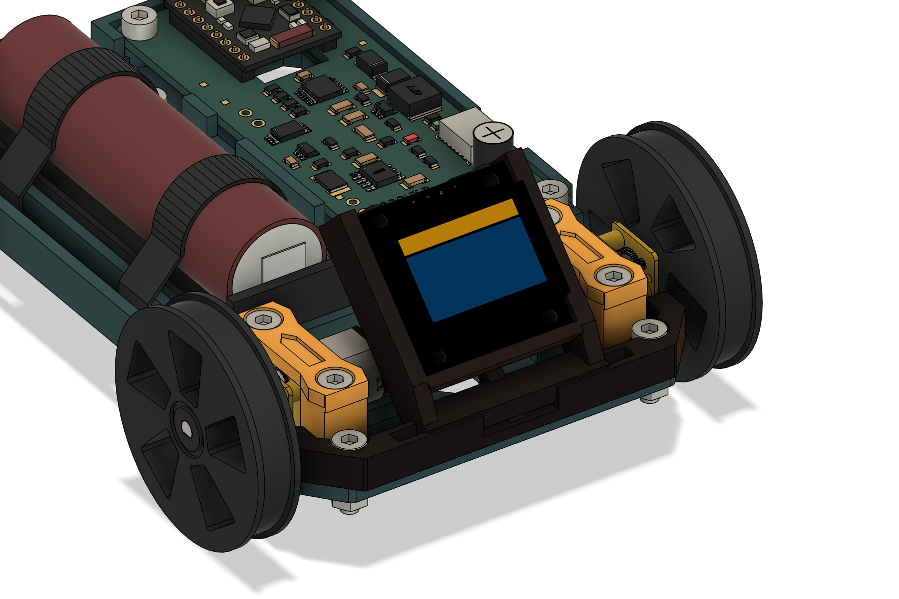
07-Bumper-Options/OLED/scout-oled-detail.png
