instructorJasonWhite/c3-scout-robot/08-Storage-Cases/Bumper/Scout-Bumper-Case-v8-fit.png

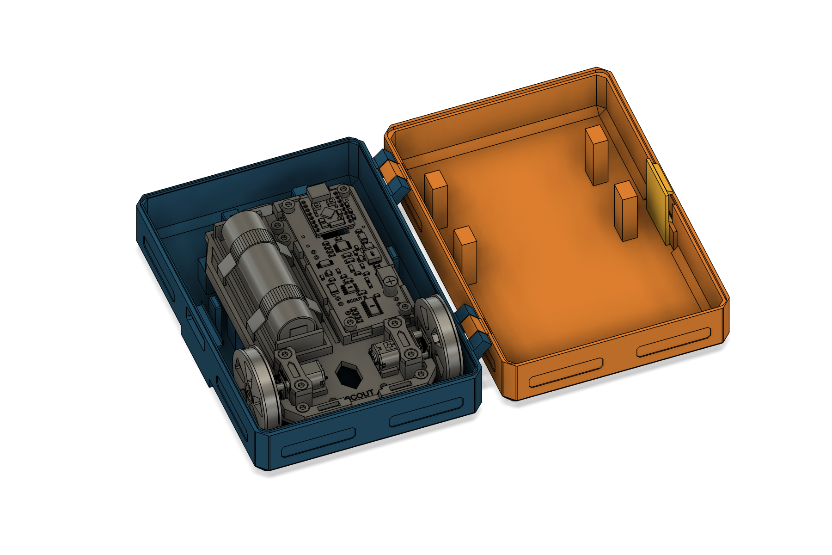
08-Storage-Cases/Bumper/Scout-Bumper-Case-v8-fit.png
