instructorJasonWhite/c3-scout-robot/08-Storage-Cases/ESP32-CAM/Scout-ESP32-CAM-Case-v8-closed.png

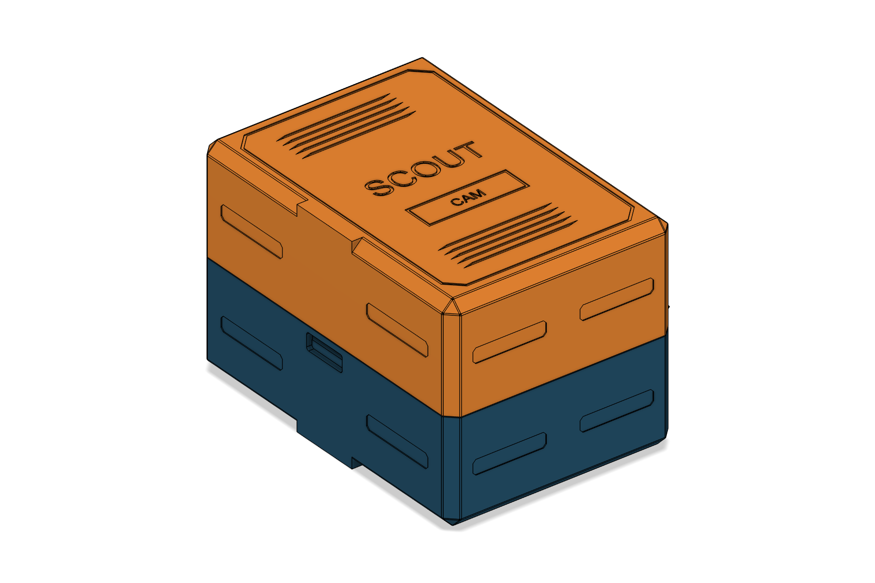
08-Storage-Cases/ESP32-CAM/Scout-ESP32-CAM-Case-v8-closed.png
