instructorJasonWhite/c3-scout-robot/08-Storage-Cases/OLED/Scout-OLED-Case-v8-open.png

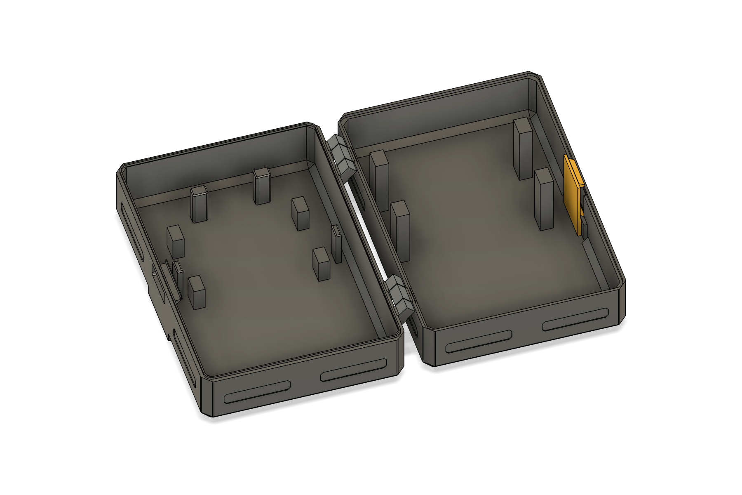
08-Storage-Cases/OLED/Scout-OLED-Case-v8-open.png
