instructorJasonWhite/c3-scout-robot/assets/accessories/oled-bumper.png

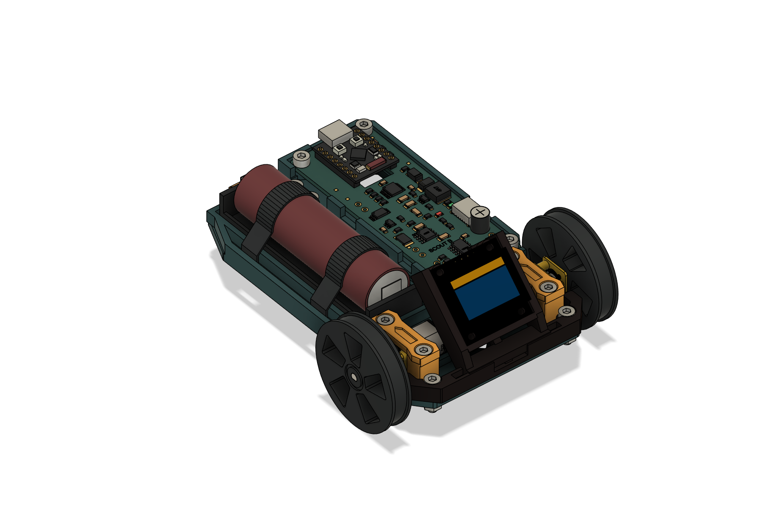
assets/accessories/oled-bumper.png
