instructorJasonWhite/c3-scout-robot/assets/cases/Scout-Bumper-Case-v8-closed.png

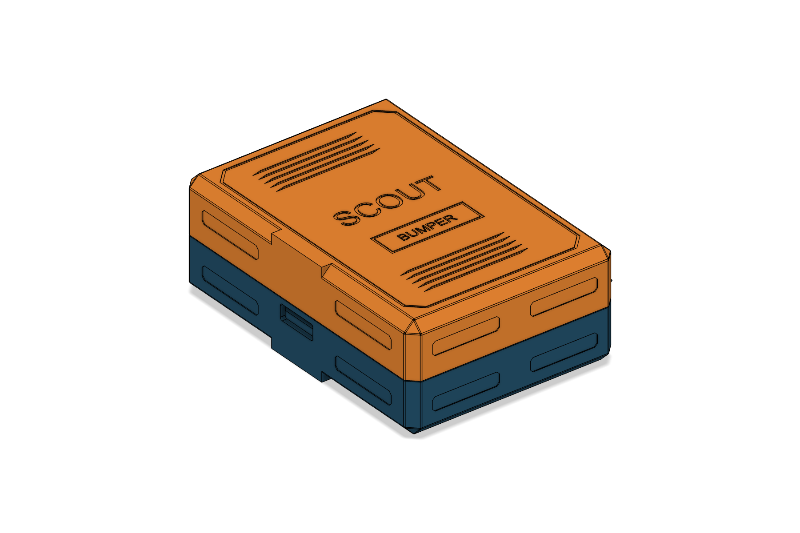
assets/cases/Scout-Bumper-Case-v8-closed.png
