instructorJasonWhite/c3-scout-robot/assets/cases/Scout-Bumper-Case-v8-open.png

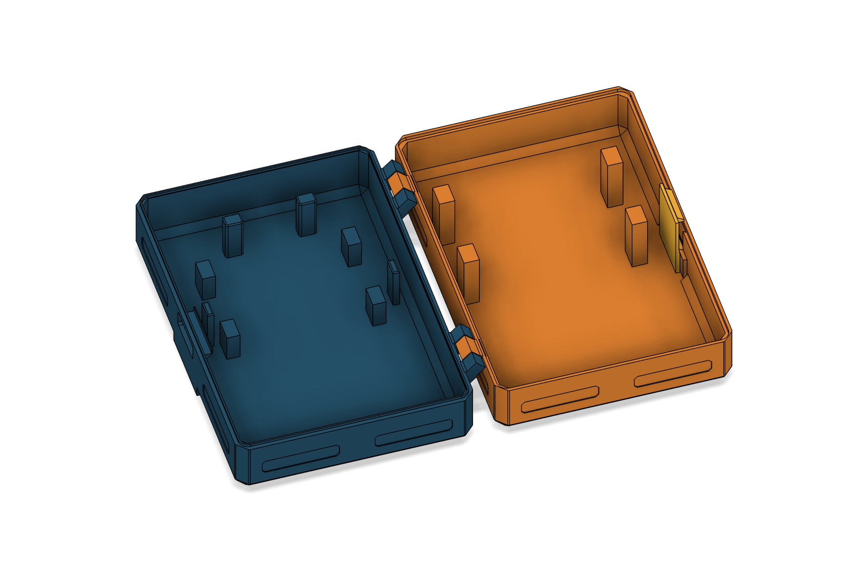
assets/cases/Scout-Bumper-Case-v8-open.png
