instructorJasonWhite/c3-scout-robot/assets/cases/Scout-OLED-Case-v8-closed.png

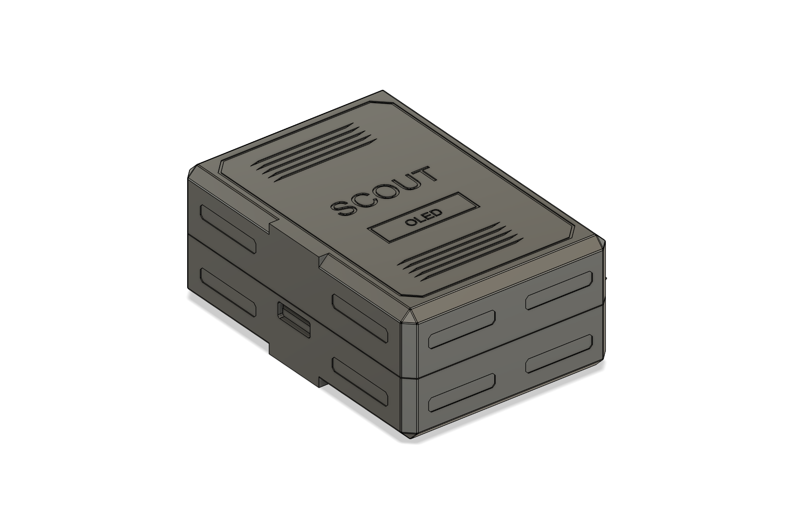
assets/cases/Scout-OLED-Case-v8-closed.png
