instructorJasonWhite/c3-scout-robot/assets/code/faces.gif

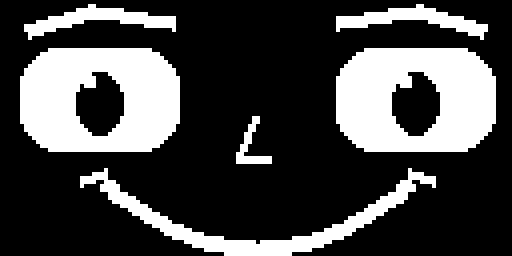
assets/code/faces.gif
