instructorJasonWhite/c3-scout-robot/assets/code/faces.png

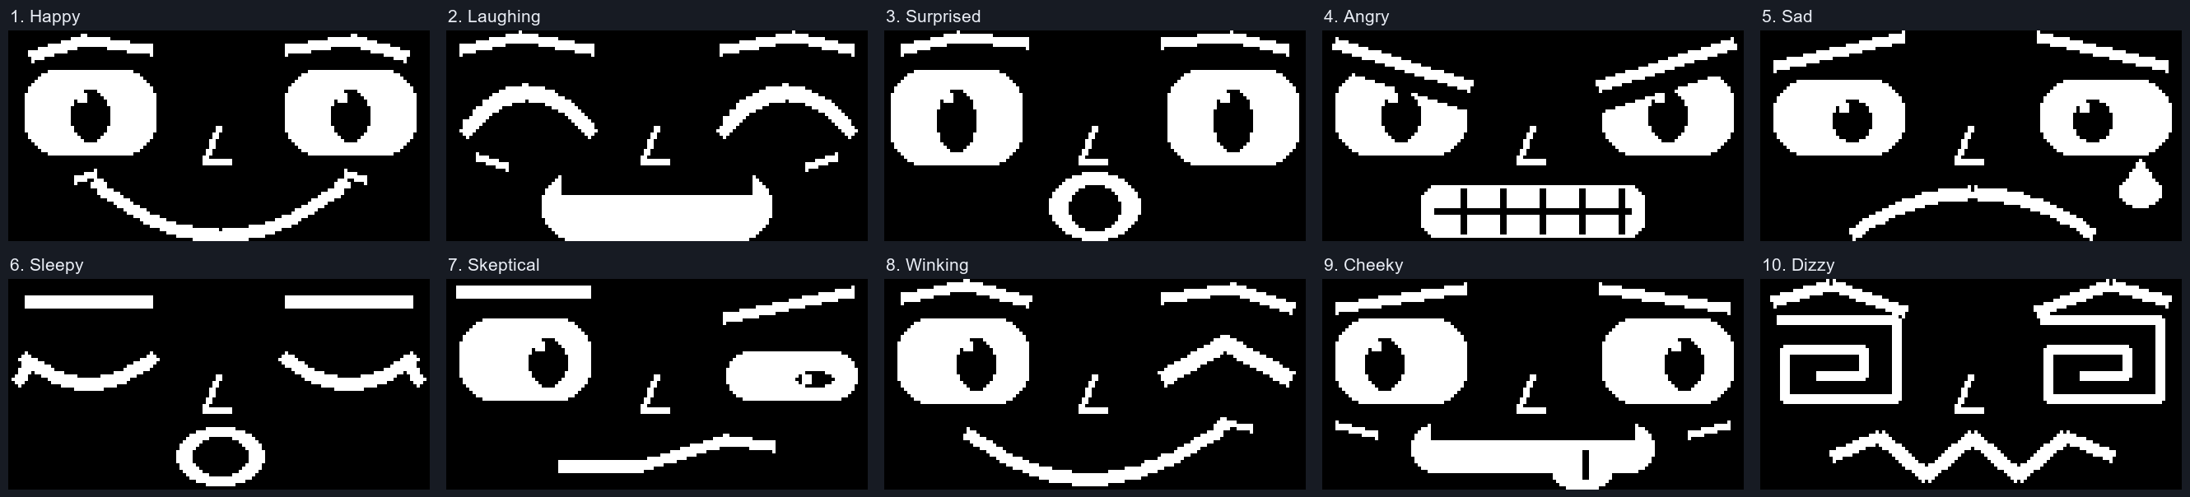
assets/code/faces.png
