instructorJasonWhite/c3-scout-robot/assets/code/web-controller.png

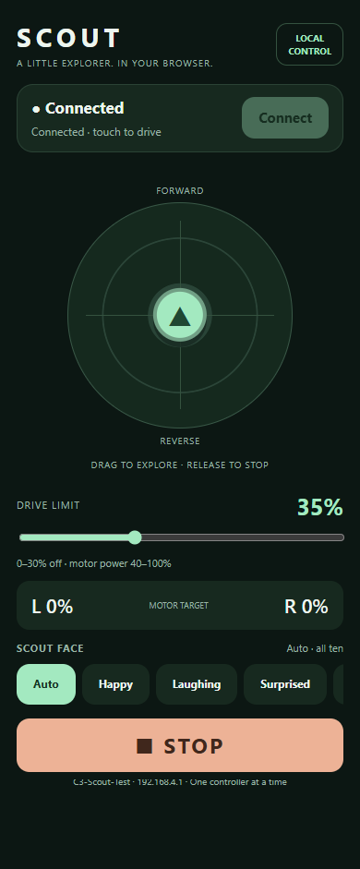
assets/code/web-controller.png
