instructorJasonWhite/c3-scout-robot/04-Component-References/REFERENCE-NOTES.txt

CURRENT v10 SUBSTITUTIONS — 5 October 2026
Q1 TECH PUBLIC 8205A / C7419210; U4 PUOLOP DW01A / C351410;
J5 SHOU HAN TYPE-C 6P / C456012. Exact supplied datasheets are included
under filenames beginning Q1-, U4- and J5-. C1 is Panasonic EEUFM1E101 /
C713389. Consult the v10 upload guide and sourcing workbook for current parts.
The earlier DW01A.pdf, FS8205A.pdf and USB4125.pdf describe superseded selections.

EARLIER REFERENCE RECORD
C3 SCOUT — PERTINENT COMPONENT REFERENCES

Manufacturer/reference CAD and PDFs retain their original ownership.

Motor: Pololu precious-metal micro gearmotor, no encoder. A generic N20
family reference for the user's Coliao motors, not a verified exact match.
Source: https://www.pololu.com/product/992/resources
Read the original included Pololu-Motor-Model-README.txt for variants.
Do not substitute Pololu electrical ratings for the purchased motors.

SuperMini: supplier dimensional reference (not an Espressif board drawing).
Source: https://dl.artronshop.co.th/ESP32-C3%20SuperMini%20datasheet.pdf
Board variants exist; measure the user's actual module and verify pinout.

TC1508A: Fine Made manufacturer datasheet, S&CIC2159, version 1.0.
Source: https://atta.szlcsc.com/upload/public/pdf/source/20221108/FA704C761D3E1A3F8A261A261F561E1F.pdf

DW01A, FS8205A, TP4056, MT3608, TXU0104 and USB4125 PDFs are the
documents used in the Carrier C component/pinout audit. Exact ordering
codes and catalog sources are in 01-Electronics-CarrierC's BOM and review.
FS8205A is specifically the Fortune TSSOP-8 implementation.
TXU0104 manufacturer: https://www.ti.com/product/TXU0104
USB connector: https://gct.co/connector/usb4125

Bourns-SRN6045TA.pdf is the selected inductor family datasheet:
https://www.bourns.com/docs/Product-Datasheets/SRN6045TA.pdf

Alternate DRV8833 and old DIP/socket/boost-module references have been
omitted from this current package; those circuits are no longer used.
