instructorJasonWhite/c3-scout-robot/01-Electronics-CarrierC/C3-Carrier-RevC-BOM.xlsx

Carrier C sourcing BOM
46 fitted components / 45 factory assembly / 1 user module / reviewed 2026-10-05
Catalog listings are not stock reservations. JLC placement rotations require assembly-preview review.
References | Qty | Specification | Package | Manufacturer | MPN | LCSC / JLC code | Assembly category | Availability evidence | Source | Assembly notes
U1 | 1 | ESP32-C3 SuperMini | 2 x 8 / 2.54 mm | User module | ESP32-C3 SuperMini |  | Hand solder | User supplied |  | Verify clone pinout and 15.24 mm row spacing. Antenna over cutout; component side above carrier.
U2 | 1 | Dual motor driver | SOP-16 | Shenzhen Fuman | TC1508A | C5142992 | Extended | JLC catalog confirmed; stock not verified | https://jlcpcb.com/partdetail/Shenzhen_FumanElec-TC1508A/C5142992 | Validate actual N20 stall current and package temperature.
U3 | 1 | 500 mA charger | ESOP-8 with exposed pad | Top Power | TP4056-42-ESOP8 | C16581 | Extended | JLC catalog confirmed; stock not verified | https://jlcpcb.com/partdetail/TP4056-42-ESOP8/C16581 | R1 = 2.4 kohm. RUN OFF while charging. TEMP grounded; no cell-temperature sensing.
U4 | 1 | Cell protection | SOT-23-6 | PUOLOP | DW01A | C351410 | Extended | JLC stock verified 2026-10-05; user selected | https://jlcpcb.com/partdetail/DW01A/C351410 | Pin-compatible SOT-23-6; 2.5 V cutoff / 2.9 V recovery, 150 mV current sense. Allows 0 V battery charging; verify protection behavior.
Q1 | 1 | Dual common-drain N-MOSFET | TSSOP-8 | TECH PUBLIC | 8205A | C7419210 | Extended | JLC stock verified 2026-10-05; user selected | https://jlcpcb.com/partdetail/TECHPUBLIC-8205A/C7419210 | TSSOP-8, common drain at pins 1/8. Lower RDS(on) raises overcurrent trip current; verify prototype protection.
U5 | 1 | 5.10 V boost | SOT-23-6 | Aerosemi | MT3608 | C84817 | Extended | JLC catalog confirmed; stock not verified | https://jlcpcb.com/partdetail/C84817 | Nominal 0.6 x (1 + 75k/10k). D4 drop precedes SuperMini 5V input.
U6 | 1 | 4-channel level translator | TSSOP-14 | Texas Instruments | TXU0104PWR | C2938871 | Extended | JLC catalog confirmed; stock not verified | https://jlcpcb.com/partdetail/TexasInstruments-TXU0104PWR/C2938871 | OE pulled low; separates 3V3 control from switched motor domain.
L1 | 1 | 4.7 uH / 4.5 A Irms / 6.8 A Isat | 6 x 6 x 4.5 mm max | Bourns | SRN6045TA-4R7M | C2044594 | Extended | JLC catalog confirmed; stock not verified | https://jlcpcb.com/partdetail/BOURNS-SRN6045TA4R7M/C2044594 | Manufacturer land pattern: 5.1 x 1.8 mm pads, 4.7 mm centers. Footprint updated in Fusion.
D3, D4 | 2 | SS34 / 3 A / 40 V | SMA | MDD | SS34 | C8678 | Basic | JLC catalog confirmed; stock not verified | https://jlcpcb.com/partdetail/Mdd-SS34/C8678 | Pad 1 = cathode.
F1 | 1 | 2 A hold / 16 V PTC | 1812 | Littelfuse | 1812L200/16DR | C439873 | Extended | JLC catalog confirmed; stock not verified | https://jlcpcb.com/partdetail/Littelfuse-1812L20016DR/C439873 | 3.5 A trip rating; temperature derating applies.
D1 | 1 | Red indicator | 0805 | NationStar | NCD0805R1 | C84256 | Basic | JLC catalog confirmed; stock not verified | https://jlcpcb.com/partdetail/NCD0805R1/C84256 | Footprint pad 1 = anode; verify assembly-library rotation.
D2 | 1 | Green indicator | 0805 | Kento | KT-0805G | C2297 | Basic | JLC catalog confirmed; stock not verified | https://jlcpcb.com/partdetail/Hubei_KentoElec-KT0805G/C2297 | Footprint pad 1 = anode; verify assembly-library rotation.
C1 | 1 | 100 uF / 25 V / low impedance | Radial 6.3 x 11.2 mm; 2.5 mm pitch | Panasonic | EEUFM1E101 | C713389 | THT assembly | JLC: 1130 in stock; 1097 orderable on 2026-10-05 | https://jlcpcb.com/partdetail/PANASONIC-EEUFM1E101/C713389 | FM substitutes FR: same 100 uF/25 V, 6.3 x 11.2 mm, 2.5 mm pitch, 455 mA ripple and 130 mohm impedance. Endurance 2000 h vs 5000 h at 105 C. Pad 1 positive. JLC wave soldering; Economic/Standard supported.
C2, C5, C9, C10, C11 | 5 | 100 nF / 50 V / X7R / 10% | 0805 | Samsung | CL21B104KBCNNNC | C1711 | Catalog | JLC catalog confirmed; stock not verified | https://jlcpcb.com/partdetail/CL21B104KBCNNNC/C1711
C3, C4, C12 | 3 | 10 uF / 16 V / X7R / 10% | 1206 | Murata | GRM31CR71C106KA12L | C97954 | Extended | JLC catalog confirmed; stock not verified | https://jlcpcb.com/partdetail/MurataElectronics-GRM31CR71C106KA12L/C97954
C6, C7, C8 | 3 | 22 uF / 10 V / X7R / 20% | 1206 | KEMET | C1206C226M8RACTU | C2167682 | Extended | JLC catalog confirmed; stock not verified | https://jlcpcb.com/partdetail/KEMET-C1206C226M8RACTU/C2167682 | Confirm effective capacitance under DC bias when qualifying the boost supply.
R1 | 1 | 2.4 kohm / 1% / 0.125 W | 0805 | UNI-ROYAL | 0805W8F2401T5E | C17526 | Verify | LCSC catalog confirmed; JLC availability unverified | https://www.lcsc.com/product-detail/C17526.html
R2, R3 | 2 | 5.1 kohm / 1% / 0.125 W | 0805 | UNI-ROYAL | 0805W8F5101T5E | C27834 | Basic | JLC catalog confirmed; stock not verified | https://jlcpcb.com/partdetail/0805W8F5101T5E/C27834
R4, R5, R7 | 3 | 1 kohm / 1% / 0.125 W | 0805 | UNI-ROYAL | 0805W8F1001T5E | C17513 | Basic | JLC catalog confirmed; stock not verified | https://jlcpcb.com/partdetail/0805W8F1001T5E/C17513
R6 | 1 | 100 ohm / 1% / 0.125 W | 0805 | UNI-ROYAL | 0805W8F1000T5E | C17408 | Basic | JLC catalog confirmed; stock not verified | https://jlcpcb.com/partdetail/0805W8F1000T5E/C17408
R8 | 1 | 75 kohm / 1% / 0.125 W | 0805 | UNI-ROYAL | 0805W8F7502T5E | C17819 | Verify | LCSC catalog confirmed; JLC availability unverified | https://www.lcsc.com/product-detail/C17819.html
R9, R10, R11, R12, R13 | 5 | 10 kohm / 1% / 0.125 W | 0805 | UNI-ROYAL | 0805W8F1002T5E | C17414 | Basic | JLC catalog confirmed; stock not verified | https://jlcpcb.com/partdetail/0805W8F1002T5E/C17414
R14, R15, R16, R17, R18, R20 | 6 | 100 kohm / 1% / 0.125 W | 0805 | UNI-ROYAL | 0805W8F1003T5E | C149504 | Basic | JLC catalog confirmed; stock not verified | https://jlcpcb.com/partdetail/0805W8F1003T5E/C149504
R19 | 1 | 330 kohm / 1% / 0.125 W | 0805 | UNI-ROYAL | 0805W8F3303T5E | C17629 | Verify | LCSC catalog confirmed; JLC availability unverified | https://www.lcsc.com/product-detail/C17629.html
J5 | 1 | USB-C charging inlet | USB-C-SHOUHAN-6P-C456012 | SHOU HAN | TYPE-C 6P | C456012 | Extended | JLC stock verified 2026-10-05; user selected | https://jlcpcb.com/partdetail/C456012 | 6-contact power-only 5 V / 3 A. Footprint updated in Fusion board v9: four 0.60 x 1.40 mm plated slots, 1.00 x 1.80 mm copper lands; body-center placement 28.6,24 mm, R90. Factory SMT assembly; 3000 mating cycles.
J1, J2, J3, J4 | 4 | Battery / motors / RUN switch | 2-wire solder pads, 3.5 mm pitch | PCB feature | No fitted connector |  | PCB feature | No purchased component |  | J4 connects to external switch rated at least 3 A DC. Harness is outside carrier BOM.
TP1, TP2, TP3, TP4, TP5, TP6 | 6 | Rail test point | 1.1 mm exposed pad | PCB feature | Test pad |  | PCB feature | No purchased component
