instructorJasonWhite/c3-scout-robot/03-Print-STL/Fasteners-M3.csv

Location | Item | Quantity | Note
Carrier | M3 x 8 mm ISO 4762 socket cap screw | 4 | 2.5 mm Allen key
Motor clamps | M3 x 16 mm ISO 4762 socket cap screw | 4 | 2.5 mm Allen key
Bumper | M3 x 10 mm ISO 4762 socket cap screw | 2 | 2.5 mm Allen key
Tail skid | M3 x 10 mm ISO 4762 socket cap screw | 2 | 2.5 mm Allen key
All | M3 DIN 934 hex nut | 12 | 5.5 mm across flats; 2.4 mm thick
