instructorJasonWhite/c3-scout-robot/03-Print-STL/Tail-skid-M3.stl

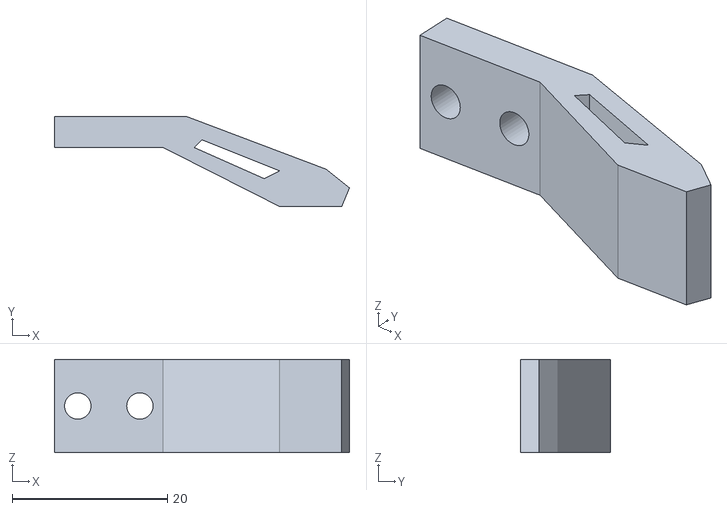
[picture p35: CAD file, 2026-10-04]
03-Print-STL/Tail-skid-M3.stl
38.0 x 11.6 x 12.0
