instructorJasonWhite/c3-scout-robot/04-Component-References/Pololu-Micro-Gearmotor-Precious-Metal-No-Encoder.step

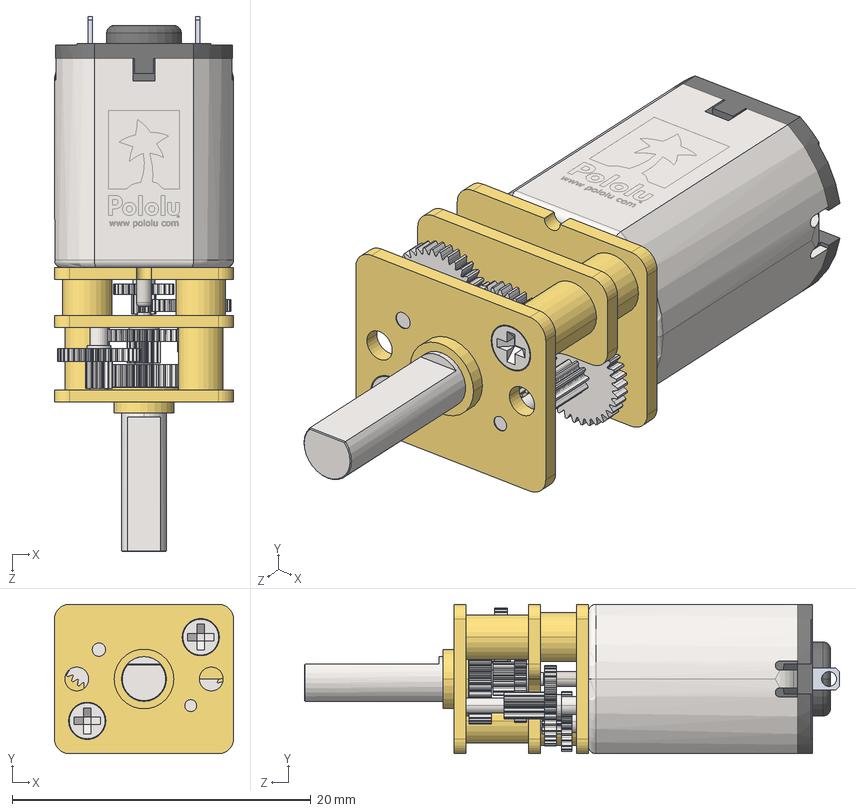
[picture p36: CAD file, 2026-10-04]
04-Component-References/Pololu-Micro-Gearmotor-Precious-Metal-No-Encoder.step
12.0 x 10.0 x 35.8 mm
