instructorJasonWhite/c3-scout-robot/07-Bumper-Options/ESP32-CAM/Scout-ESP32-CAM-Bumper-v1.step

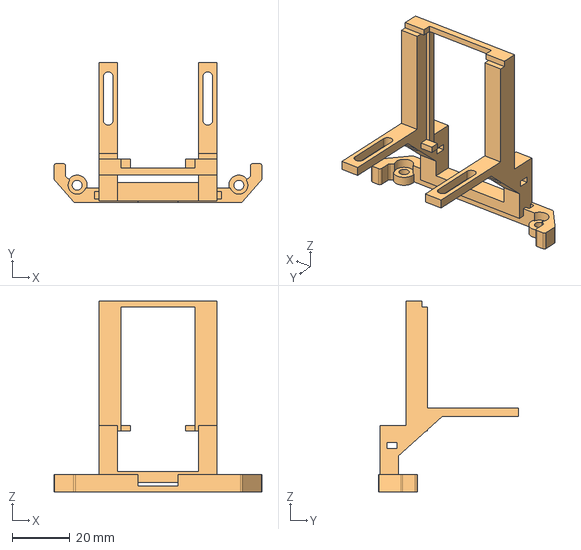
[picture p37: CAD file, 2026-10-22]
07-Bumper-Options/ESP32-CAM/Scout-ESP32-CAM-Bumper-v1.step
72.0 x 48.5 x 66.0 mm
