instructorJasonWhite/c3-scout-robot/07-Bumper-Options/OLED/Scout-OLED-Bumper-v1.step

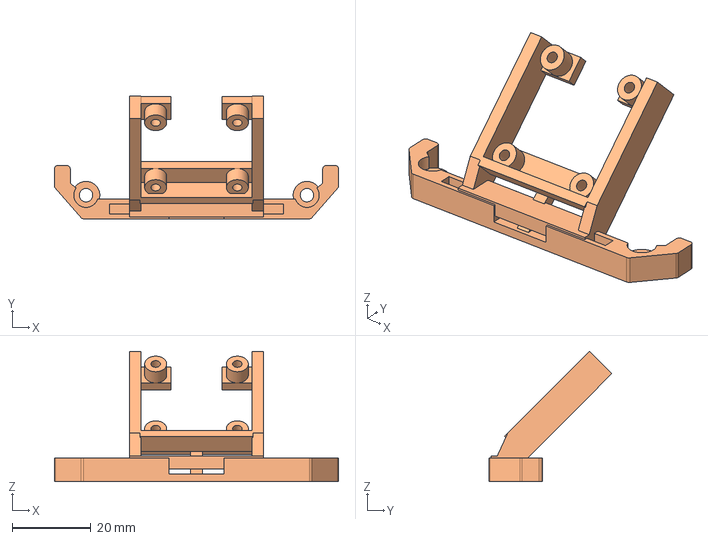
[picture p38: CAD file, 2026-10-22]
07-Bumper-Options/OLED/Scout-OLED-Bumper-v1.step
72.0 x 31.1 x 33.1 mm
