instructorJasonWhite/c3-scout-robot/08-Storage-Cases/ESP32-CAM/Scout-ESP32-CAM-Case-v8-Latch.stl

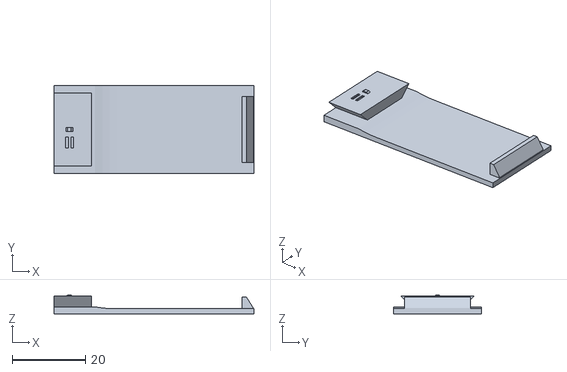
[picture p39: CAD file, 2026-10-22]
08-Storage-Cases/ESP32-CAM/Scout-ESP32-CAM-Case-v8-Latch.stl
54.5 x 24.0 x 5.10
