instructorJasonWhite/c3-scout-robot/08-Storage-Cases/OLED/Scout-OLED-Case-v8-Box.stl

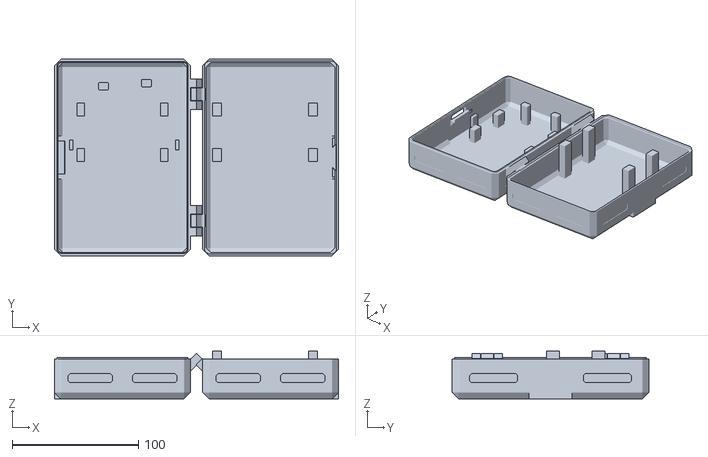
[picture p40: CAD file, 2026-10-22]
08-Storage-Cases/OLED/Scout-OLED-Case-v8-Box.stl
224.8 x 155.6 x 37.8
