instructorJasonWhite/c3-scout-robot/02-Mechanical-RevB/Integral-Chassis-M3-RevB.step

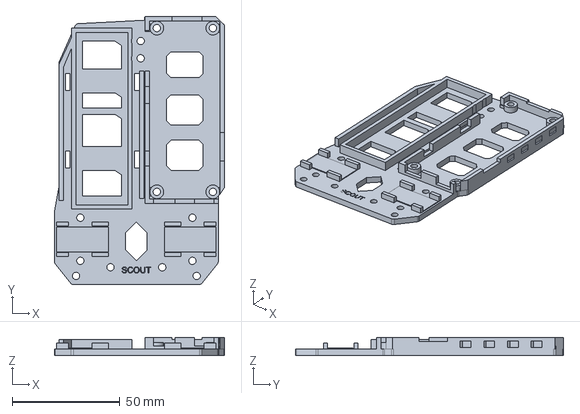
[picture p41: CAD file, 2026-10-04]
02-Mechanical-RevB/Integral-Chassis-M3-RevB.step
78.9 x 124.4 x 8.40 mm
