instructorJasonWhite/c3-scout-robot/03-Print-STL/Wheel-right.stl

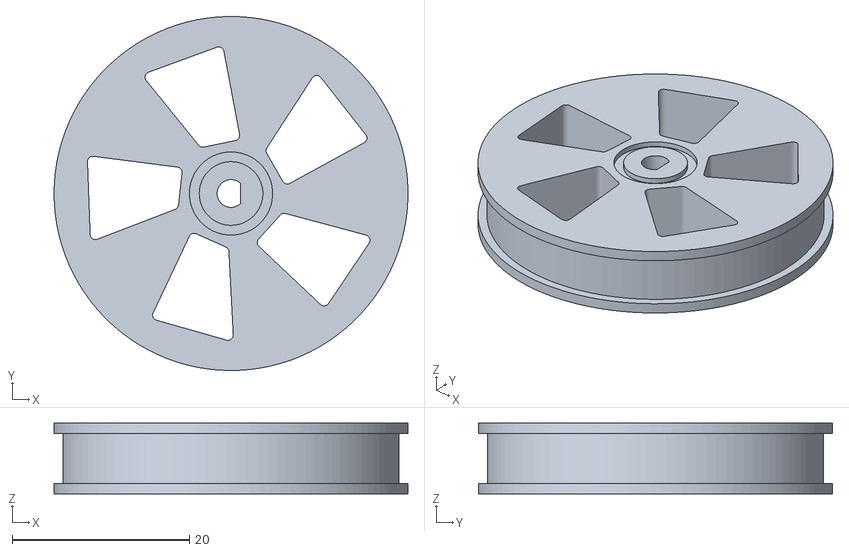
[picture p42: CAD file, 2026-10-04]
03-Print-STL/Wheel-right.stl
40.0 x 40.0 x 8.00
