instructorJasonWhite/c3-scout-robot/07-Bumper-Options/ESP32-CAM/Scout-ESP32-CAM-Rear-Support-v1.step

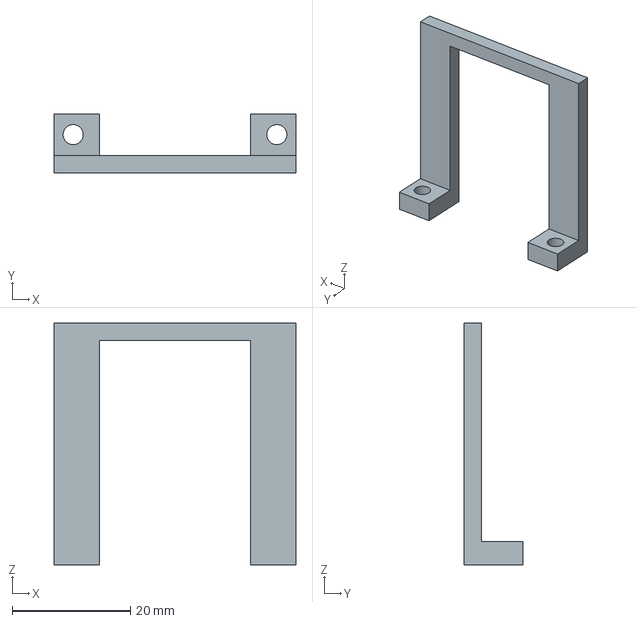
[picture p43: CAD file, 2026-10-22]
07-Bumper-Options/ESP32-CAM/Scout-ESP32-CAM-Rear-Support-v1.step
41.0 x 10.0 x 41.0 mm
