instructorJasonWhite/c3-scout-robot/08-Storage-Cases/Bumper/Scout-Bumper-Case-v8.step

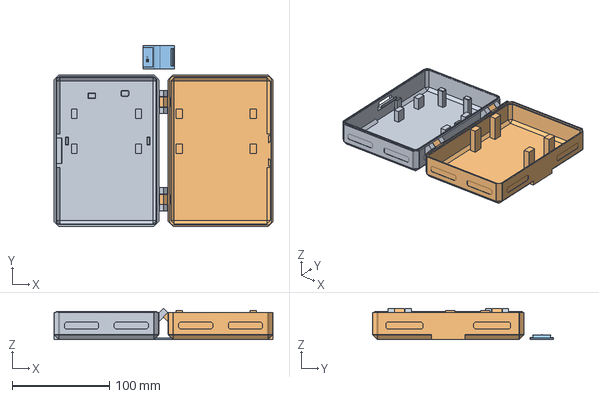
[picture p44: CAD file, 2026-10-22]
08-Storage-Cases/Bumper/Scout-Bumper-Case-v8.step
224.8 x 185.8 x 32.0 mm
