instructorJasonWhite/c3-scout-robot/08-Storage-Cases/ESP32-CAM/Scout-ESP32-CAM-Case-v8.step

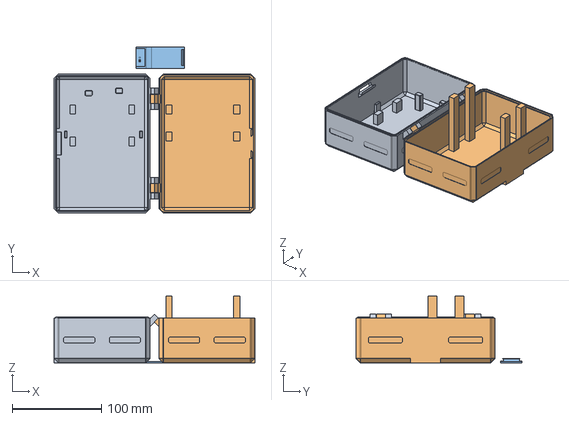
[picture p45: CAD file, 2026-10-22]
08-Storage-Cases/ESP32-CAM/Scout-ESP32-CAM-Case-v8.step
224.8 x 185.8 x 74.8 mm
