instructorJasonWhite/c3-scout-robot/08-Storage-Cases/OLED/Scout-OLED-Case-v8-Latch.stl

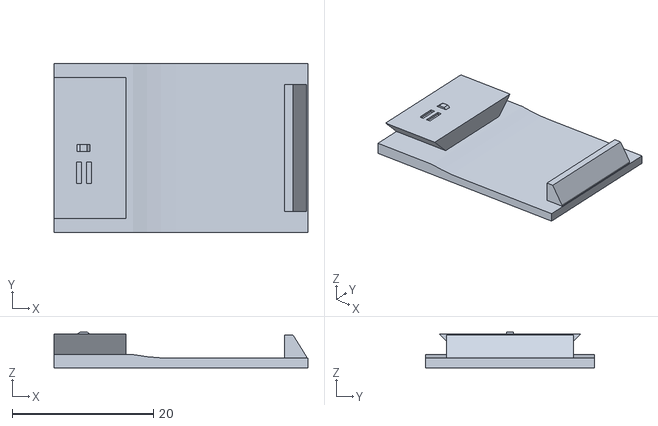
[picture p46: CAD file, 2026-10-22]
08-Storage-Cases/OLED/Scout-OLED-Case-v8-Latch.stl
36.0 x 24.0 x 5.10
