instructorJasonWhite/c3-scout-robot/02-Mechanical-RevB/Populated-Carrier-RevB-Mechanical.step

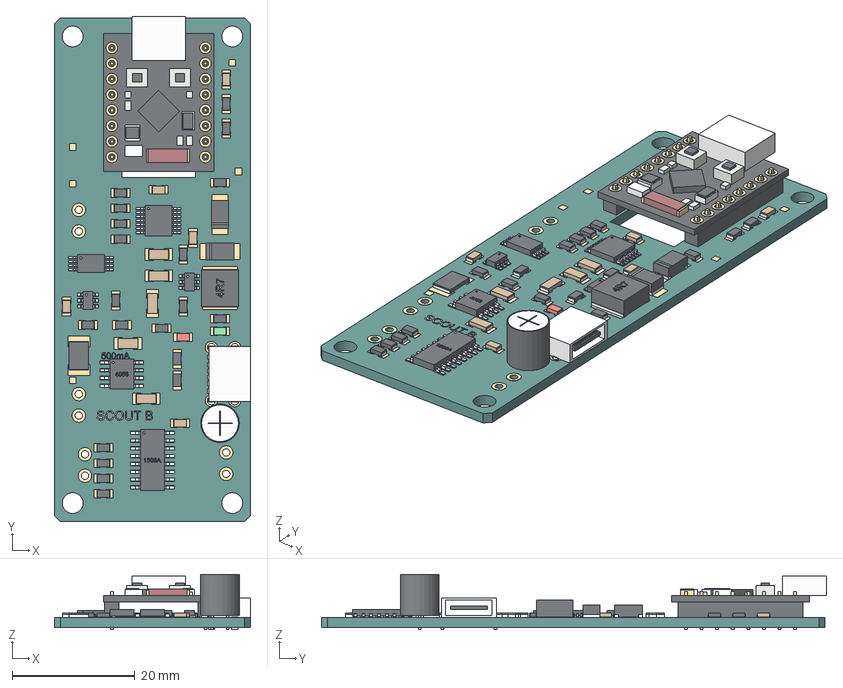
[picture p47: CAD file, 2026-10-04]
02-Mechanical-RevB/Populated-Carrier-RevB-Mechanical.step
32.0 x 82.2 x 9.03 mm
23 ESP32-C3 SUPERMINI - measured-outline reconstruction
41 U2 - TC1508A
41 U3 - TP4056-42-ESOP8
41 U4 - DW01A-G
41 Q1 - FS8205A (Fortune TSSOP8)
41 U5 - MT3608
41 U6 - TXU0104PWR
41 J5 - USB4125-GF-A-0190
41 F1 - 2A hold PTC
41 C1 - 100uF 10V low ESR
41 C2 - 100nF 25V X7R
41 C3 - 10uF 16V X7R
41 C4 - 10uF 10V X7R
41 R1 - 2.4k 1% (500mA)
41 R2 - 5.1k 1%
41 R3 - 5.1k 1%
41 D1 - RED / CHARGING
41 D2 - GREEN / FULL
41 R4 - 1k
41 R5 - 1k
41 R6 - 100R
41 R7 - 1k
41 C5 - 100nF 25V X7R
41 L1 - 4.7uH shielded >=3A sat
41 D3 - SS34 3A Schottky
41 D4 - SS34 3A isolation
41 C6 - 22uF 10V X7R
41 C7 - 22uF 10V X7R
41 C8 - 22uF 10V X7R
41 R8 - 75k 1%
41 R9 - 10k 1%
41 R10 - 10k
41 R11 - 10k
41 R12 - 10k
41 R13 - 10k
41 R14 - 100k
41 R15 - 100k
41 R16 - 100k
41 R17 - 100k
41 R18 - 100k
41 C9 - 100nF 25V X7R
41 C10 - 100nF 25V X7R
41 R19 - 330k 1%
41 R20 - 100k 1%
41 C11 - 100nF 25V X7R
41 C12 - 10uF 10V X7R
42 SUPERMINI SOLDER HEADERS - 2.5 mm spacer
40 CARRIER PCB - Rev B - M3 clearance
