instructorJasonWhite/c3-scout-robot/03-Print-STL/Bumper-M3.stl

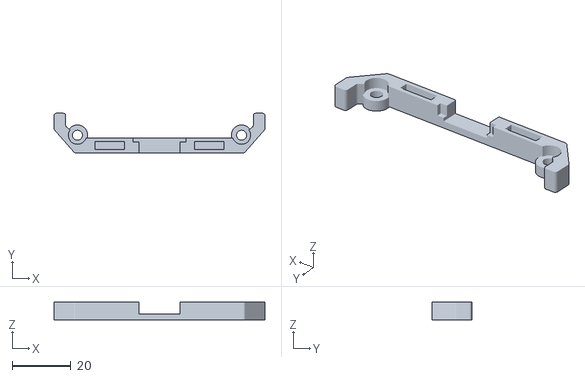
[picture p48: CAD file, 2026-10-04]
03-Print-STL/Bumper-M3.stl
72.0 x 13.5 x 6.00
