instructorJasonWhite/c3-scout-robot/08-Storage-Cases/Bumper/Scout-Bumper-Case-v8-Box.stl

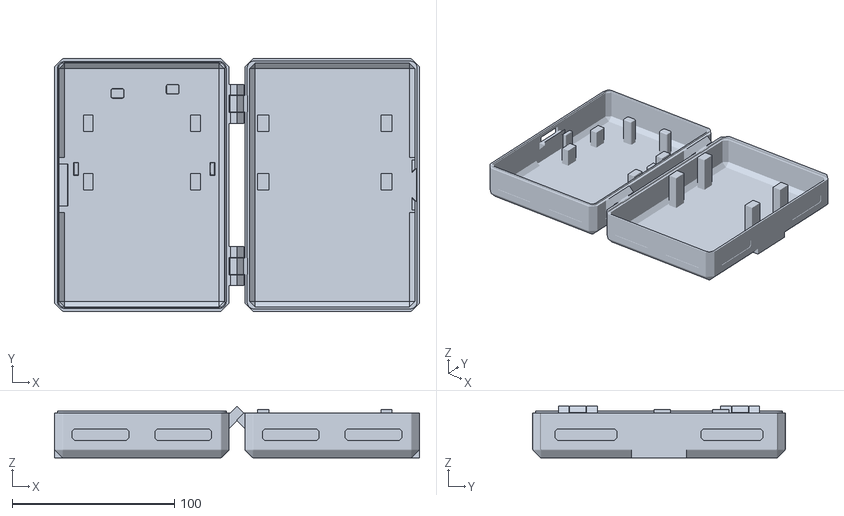
[picture p49: CAD file, 2026-10-22]
08-Storage-Cases/Bumper/Scout-Bumper-Case-v8-Box.stl
224.8 x 155.6 x 32.0
