instructorJasonWhite/c3-scout-robot/08-Storage-Cases/OLED/Scout-OLED-Case-v8.step

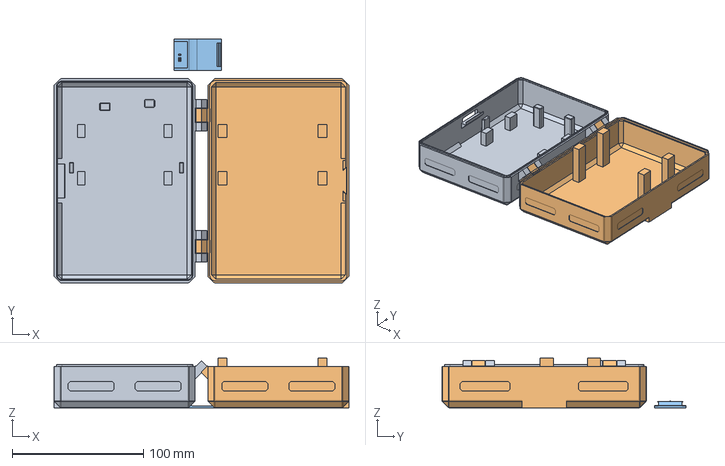
[picture p50: CAD file, 2026-10-22]
08-Storage-Cases/OLED/Scout-OLED-Case-v8.step
224.8 x 185.8 x 37.8 mm
