instructorJasonWhite/c3-scout-robot/03-Print-STL/Optional-Shaft-Fit-Coupon.stl

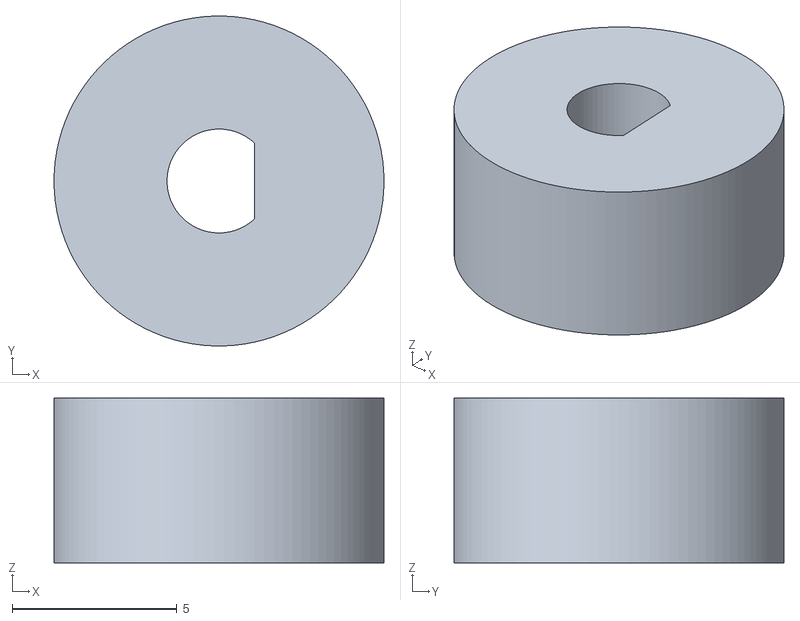
[picture p51: CAD file, 2026-10-04]
03-Print-STL/Optional-Shaft-Fit-Coupon.stl
10.0 x 10.00 x 5.00
