instructorJasonWhite/c3-scout-robot/08-Storage-Cases/Bumper/Scout-Bumper-Case-v8-Latch.stl

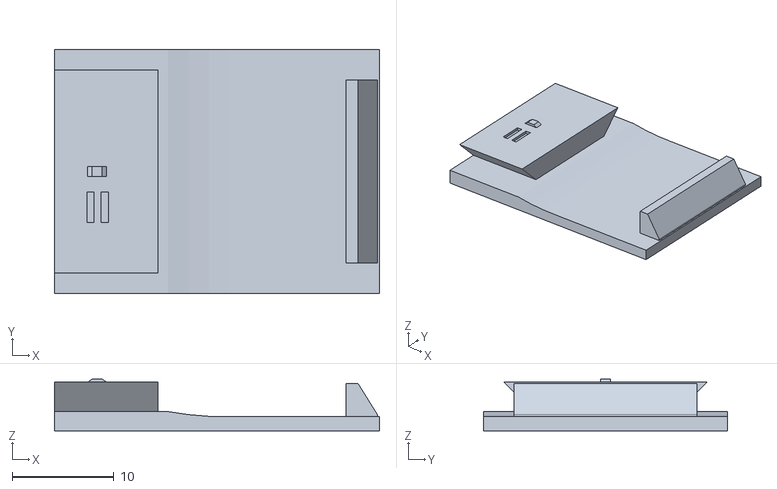
[picture p52: CAD file, 2026-10-22]
08-Storage-Cases/Bumper/Scout-Bumper-Case-v8-Latch.stl
32.0 x 24.0 x 5.10
