instructorJasonWhite/c3-scout-robot/08-Storage-Cases/ESP32-CAM/Scout-ESP32-CAM-Case-v8-Box.stl

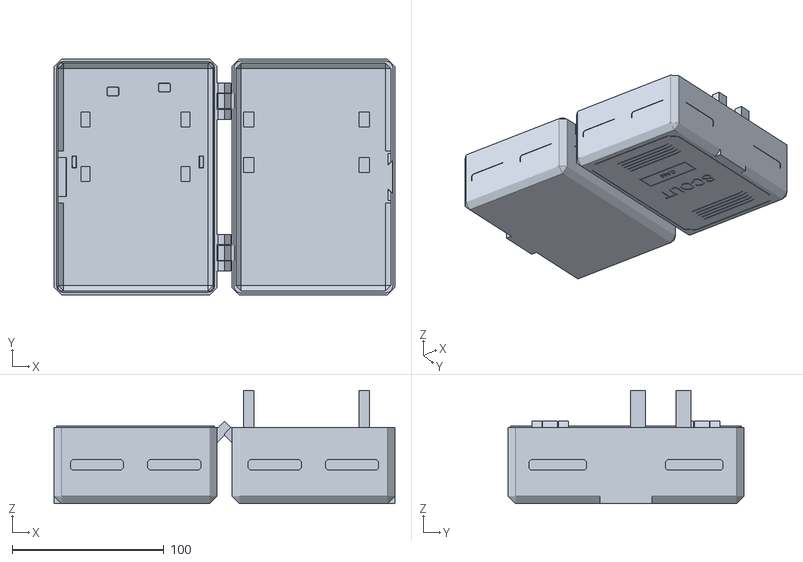
[picture p53: CAD file, 2026-10-22]
08-Storage-Cases/ESP32-CAM/Scout-ESP32-CAM-Case-v8-Box.stl
224.8 x 155.6 x 74.8
