instructorJasonWhite/c3-scout-robot/03-Print-STL/Motor-clamp-left-M3.stl

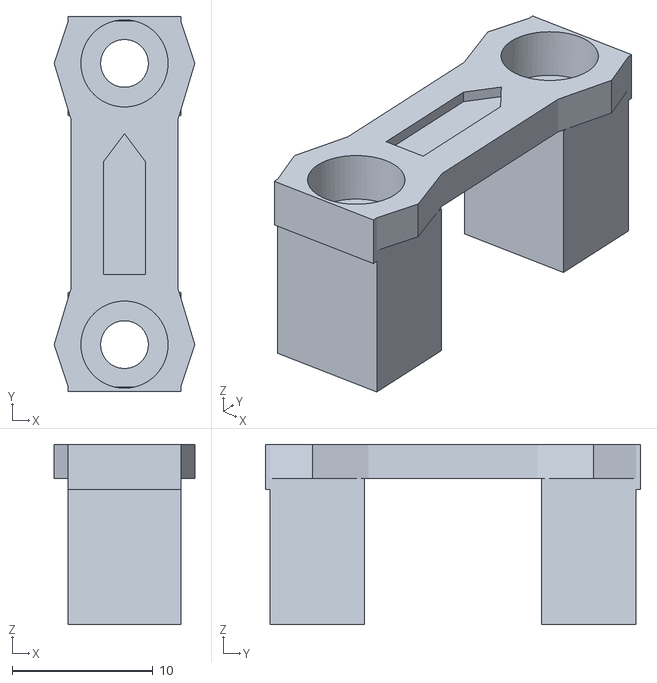
[picture p54: CAD file, 2026-10-04]
03-Print-STL/Motor-clamp-left-M3.stl
10.0 x 26.7 x 12.8
