instructorJasonWhite/c3-scout-robot/(list of files, cad)

Other CAD files:
08-Storage-Cases/Bumper/Scout-Bumper-Case-v8-P1S-PLA-print.gcode.3mf
08-Storage-Cases/ESP32-CAM/Scout-ESP32-CAM-Case-v8-P1S-PLA-print.gcode.3mf
08-Storage-Cases/OLED/Scout-OLED-Case-v8-P1S-PLA-print.gcode.3mf
08-Storage-Cases/Bumper/Scout-Bumper-Case-v8-P1S-PLA-print.3mf
08-Storage-Cases/ESP32-CAM/Scout-ESP32-CAM-Case-v8-P1S-PLA-print.3mf
08-Storage-Cases/OLED/Scout-OLED-Case-v8-P1S-PLA-print.3mf
03-Print-STL/Integral-chassis-M3.stl
02-Mechanical-RevB/C3-Scout-Carrier-RevB.f3d
02-Mechanical-RevB/Integral-Chassis-M3-RevB.f3d
02-Mechanical-RevB/Populated-Carrier-RevB-Mechanical.f3d
07-Bumper-Options/ESP32-CAM/Scout-ESP32-CAM-Adjustable-Mount-v1.f3d
07-Bumper-Options/ESP32-CAM/Scout-ESP32-CAM-Assembly-v1.f3d
07-Bumper-Options/ESP32-CAM/Scout-ESP32-CAM-Bumper-v1.f3d
07-Bumper-Options/ESP32-CAM/Scout-ESP32-CAM-Bumper-v1.stl
07-Bumper-Options/ESP32-CAM/Scout-ESP32-CAM-Rear-Support-v1.f3d
07-Bumper-Options/ESP32-CAM/Scout-ESP32-CAM-Rear-Support-v1.stl
07-Bumper-Options/OLED/Scout-OLED-Assembly-v1.f3d
07-Bumper-Options/OLED/Scout-OLED-Bumper-v1.f3d
07-Bumper-Options/OLED/Scout-OLED-Bumper-v1.stl
08-Storage-Cases/Bumper/Scout-Bumper-Case-v8.f3d
08-Storage-Cases/Bumper/Scout-Bumper-Case-v8.stl
08-Storage-Cases/ESP32-CAM/Scout-ESP32-CAM-Case-v8.f3d
08-Storage-Cases/ESP32-CAM/Scout-ESP32-CAM-Case-v8.stl
08-Storage-Cases/OLED/Scout-OLED-Case-v8.f3d
08-Storage-Cases/OLED/Scout-OLED-Case-v8.stl
