instructorJasonWhite/c3-scout-robot/build.html

Skip to content

SCOUTTHE BUILDER GUIDE

Scout / The Build

# Put Scout together.

Nine illustrated steps, the right hardware at each stage, and the current printable and editable files.

Rev B mechanicsGuide updated 21 October 2026

On this page

See how it fits together.Get your bearingsPrint seven partsSet out the M3 hardwareNine steps from parts to chassisOne picture for all the wiringUse the model, then check the real partsBuild files and editable CAD

Print Scout’s seven mechanical parts, set out the M3 hardware, and build the chassis in nine illustrated steps. Each step tells you what to add and what to check before moving on.

Start with the matching revision.

This guide uses the latest completed Rev B integral chassis. The pictures show a Rev B populated board. The current Carrier C v10 keeps the mounting outline, but its changed components have not been checked in this mechanical model. Trial-fit your actual board, motors and cable plugs as you build. The CAD checks passed; printed fit and the complete Carrier C assembly still need physical validation.

Print the parts Set out the hardware Follow the assembly Wire the robot Get the files

## See how it fits together.

Annotated Scout exploded assembly drawing with parts and fastener sizes

Rev B mechanics. Open the drawing for the full-size view.

Download the assembly drawing · SVG

The mechanical layout

## Get your bearings

The bumper and the word SCOUT mark the front. The swept tail skid is at the rear. Throughout these instructions, left and right mean Scout’s sides when looking forward toward the bumper.

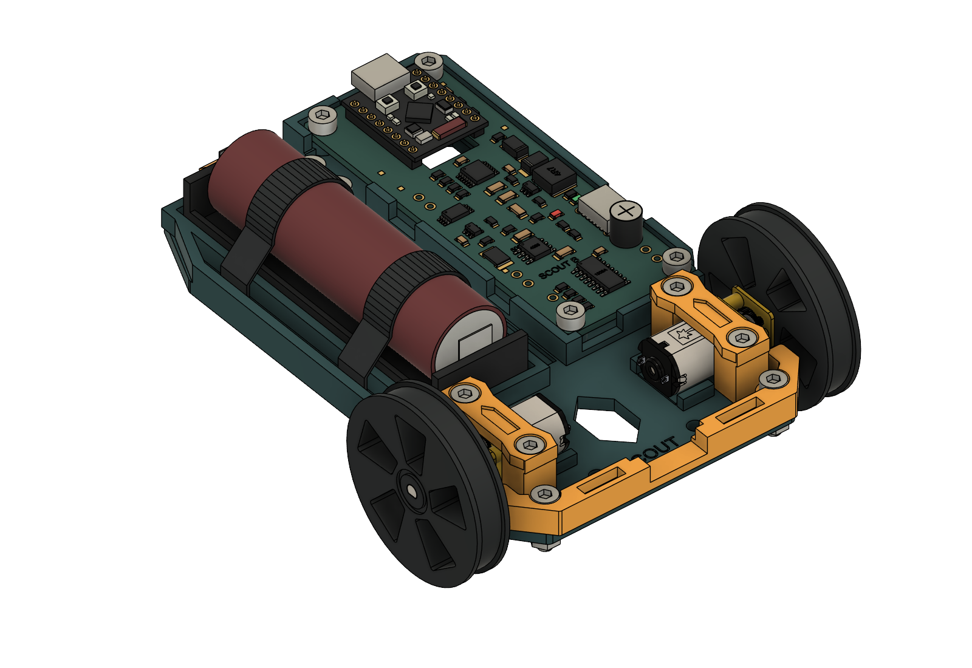
[picture p55: assets/build/09-completed.png]
Assembled Rev B Scout CAD model with the bumper at the front, two drive wheels, a rear tail skid, carrier board and reference battery holder.


Completed Rev B arrangement for orientation. The battery and holder shown are reference geometry; keep the real cell removed throughout the mechanical build.

Remove the battery and unplug both USB connections before starting. Have the populated carrier board, two actual N20 motors and your chosen empty battery holder available for fit checks. Use the Board guide for electrical connections and power procedures.

Before assembly

## Print seven parts

Use the Rev B M3 files together. Print one of each file below; the optional shaft-fit coupon is an extra test piece rather than part of the finished robot.

Part | Quantity | Print orientation
Integral chassis | 1 | Flat
Left motor clamp | 1 | Bridge against the bed
Right motor clamp | 1 | Bridge against the bed
Front bumper | 1 | Flat
Tail skid | 1 | On its side
Left wheel | 1 | On a wheel face
Right wheel | 1 | On a wheel face

Check the orientation in your slicer. The STL units are millimetres, and the files retain their component coordinates. Importing a file does not necessarily place its intended print face on the bed. The two named clamp files are identical, as are the two wheel files; keep the filenames together so the set remains easy to identify.

Clean loose debris from the holes, nut pockets and seating surfaces. Try a real M3 screw and nut before assembly. The design uses 3.4 mm clearance holes and 5.8 mm nut pockets, but your printed result is the fit that matters. Use the optional shaft-fit coupon on both actual motors before fitting the wheels.

No physically validated material and slicer profile is supplied for this Rev B set. Establish fit with your printer and material before committing to the complete build. Read the original Rev B print notes alongside these instructions.

One fastener system

## Set out the M3 hardware

Hardware | Quantity | Where it goes
M3 × 8 mm ISO 4762 socket-cap screw | 4 | Carrier board · Step 5
M3 × 16 mm ISO 4762 socket-cap screw | 4 | Motor clamps · Steps 3 and 4
M3 × 10 mm ISO 4762 socket-cap screw | 4 | Front bumper and tail skid · Steps 6 and 7
M3 DIN 934 hex nut | 12 | 4 carrier, 4 motor clamps, 2 bumper, 2 tail skid

Total: 12 screws and 12 nuts. Screw lengths are measured beneath the head. The specified nuts are 5.5 mm across flats and 2.4 mm thick. No washers are specified in the hardware list; the modeled carrier mounting uses none.

### Tools to have nearby

A 2.5 mm Allen key fits every specified screw. Calipers help check the motor, holes and pockets. Keep your actual charging and programming cable plugs handy for the final unpowered clearance check.

### Tighten gently

Start the screws before tightening the joint, and bring paired screws down evenly. No tightening torque is supplied for these printed parts. The current chassis uses M3 hardware throughout; older M2.5 clamp instructions belong to an earlier build.

Download the fastener checklist

Build in this order

## Nine steps from parts to chassis

The underside carrier nuts and wire routes go in early because the board covers them later. Complete each check before adding the next part. These steps organize the existing CAD design for builders; they do not represent a physically validated assembly trial.

01

### Sort the parts and check the shaft fit

Exploded Rev B Scout showing the integral chassis, two motors and clamps, two wheels, front bumper, tail skid and carrier board.

The front is the SCOUT and bumper end at lower right; the rear is the tail-skid end at upper left. Hardware and battery parts are omitted to show the main pieces.

New hardware

None. Sort 4 × M3 × 8 mm, 4 × M3 × 16 mm, 4 × M3 × 10 mm screws, and 12 M3 nuts.

1. Identify all seven printed parts and compare their mating surfaces with the picture. Remove loose print debris from the seats, holes and nut pockets.
2. Check a real screw and nut in their printed interfaces. Correct a poor print fit before fastening parts together.
3. Align the coupon’s D-flat with each motor shaft and try the fit without forcing the gearbox. Resolve a tight or loose bore before fitting either wheel.

Ready to continue: all parts and hardware are identified, the printed interfaces accept their hardware, and both actual shafts have been checked.

The pictured motors use generic Pololu reference geometry. Confirm the dimensions of the motors you bought.

02

### Fit the carrier nuts and plan the leads

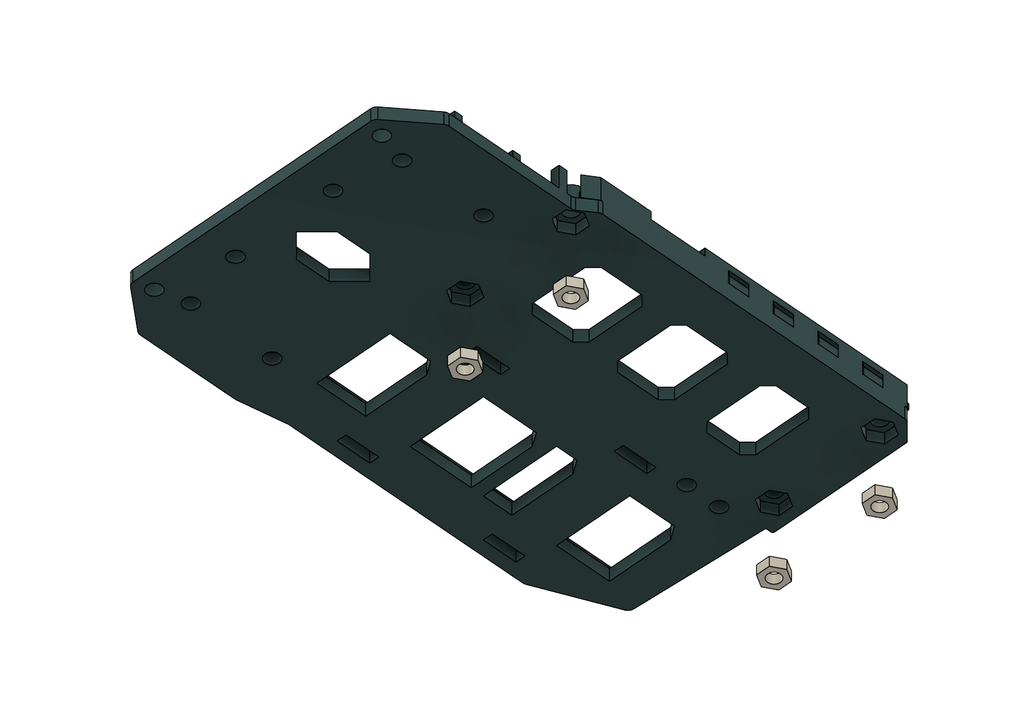
[picture p56: assets/build/02-underside-nuts.png]
Underside of the empty chassis with four carrier mounting nuts separated from their hexagonal pockets.


Underside view. Each of the four nuts fits into a pocket directly below a carrier-board seat.

New hardware

4 × M3 DIN 934 hex nuts. Keep these same nuts in place for Step 5.

1. Turn the empty chassis over. Place one nut into each of the four carrier pockets, flat and aligned with the screw hole.
2. Support the nuts while turning the chassis upright. An added retainer is not specified, so check that none has dropped out.
3. Plan the motor, battery-holder and RUN-switch lead routes through the bay. Keep the board seats, mounting holes and wheel areas clear.
4. Pass any prepared loose leads through before the board covers the bay. Leave room to install both motors, then recheck the routes in Step 5.

Ready to continue: four nuts sit beneath the carrier seats, and the planned leads cross no seating or fastening surface.

This is a routing step. Follow the Board guide for the electrical connections.

03

### Secure the left motor and clamp

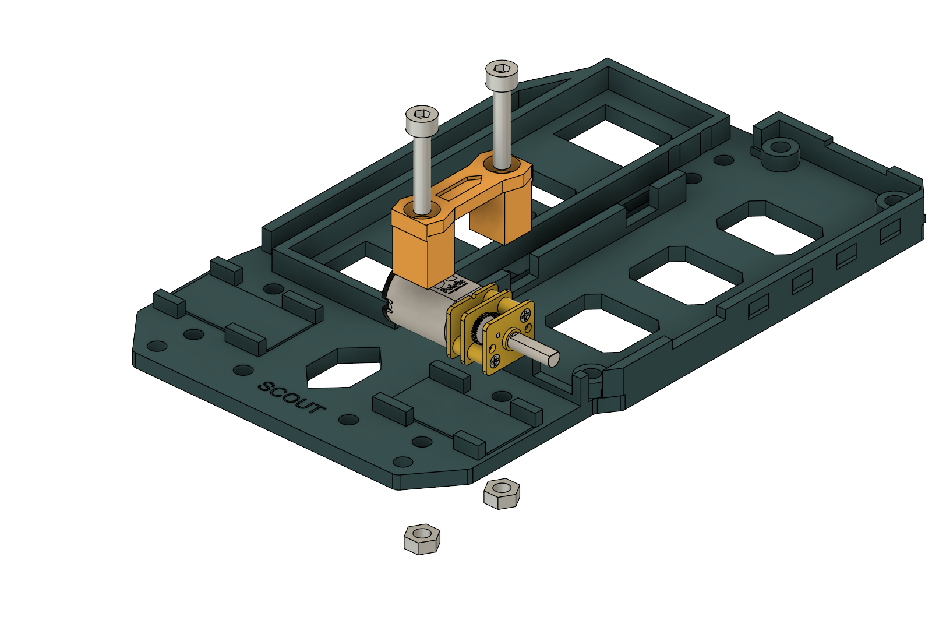
[picture p57: assets/build/04-motor-clamp.png]
Left motor attachment stack showing two screws above the clamp and motor, with two nuts beneath the chassis.


Left motor stack, from top to bottom: screws, clamp, motor, chassis and nuts. Other fitted parts are hidden for clarity.

New hardware

2 × M3 × 16 mm screws + 2 × M3 hex nuts.

1. Place the left motor into its seat with the gearbox face and output shaft toward the outside of the chassis.
2. Guide its paired leads toward the bay. Keep them out from under the motor, clamp and mounting holes.
3. Place the clamp over the motor and align both holes. Insert the two screws from above and fit the nuts beneath the chassis.
4. Tighten gently and evenly with the 2.5 mm Allen key until the motor is held in its seat.

Ready to continue: the left motor is held securely, its shaft is clear, and no wire is pinched.

04

### Secure the right motor and clamp

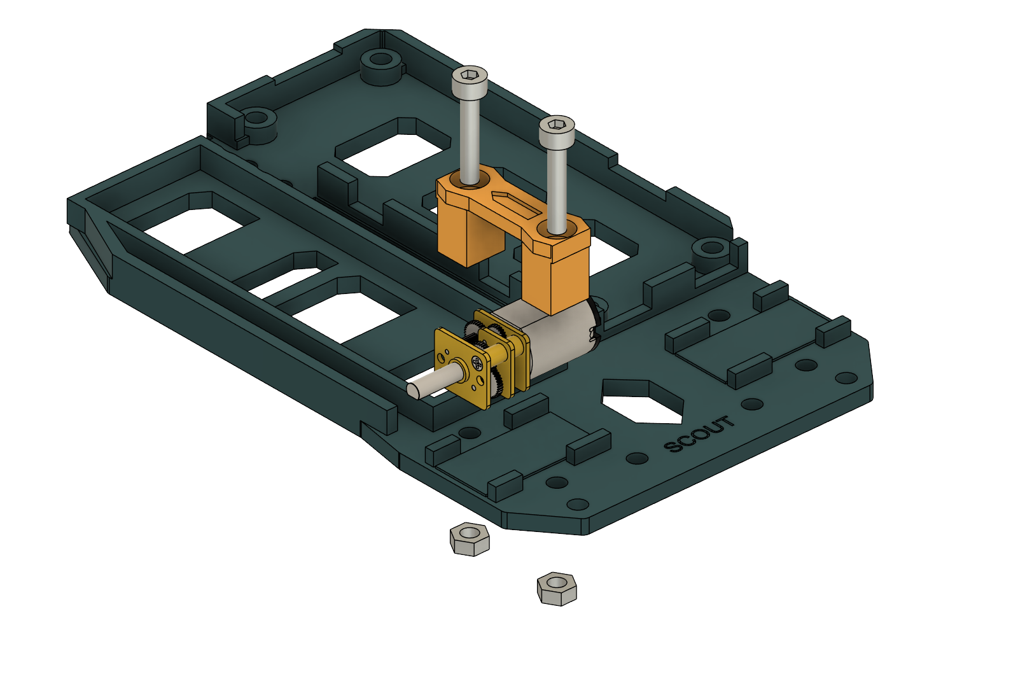
[picture p58: assets/build/03-motor-clamp.png]
Right motor attachment viewed from the opposite side, with the motor, clamp, two screws and two underside nuts separated.


The view changes sides to keep the right motor’s shaft and underside nuts visible. Left and right still refer to Scout looking forward.

New hardware

2 × M3 × 16 mm screws + 2 × M3 hex nuts.

1. Seat the second motor on the right, with its output shaft facing outward.
2. Route its lead pair toward the bay without crossing a clamp seat or screw hole.
3. Fit the clamp, insert both screws from above, and fit the two nuts below the chassis floor. Tighten the screws gently and evenly.
4. Check both motors together. Their shafts should be accessible for the wheels, and both lead pairs should remain free of the clamps.

Ready to continue: both motors are seated and clamped, with all four clamp screws and four clamp nuts installed.

05

### Seat and fasten the carrier board

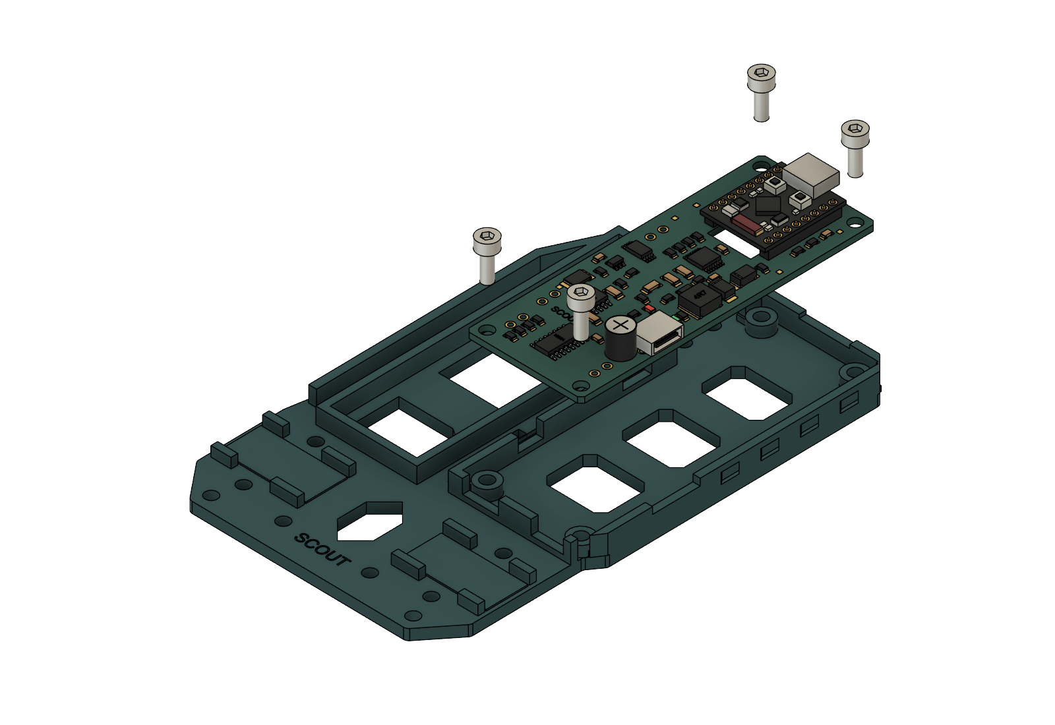
[picture p59: assets/build/05-carrier.png]
Rev B populated carrier board above its four integral chassis seats, with four screws above and four nuts already beneath the chassis.


The screws enter from above. The four nuts installed in Step 2 stay in the underside pockets. This picture shows the Rev B board population.

New hardware

4 × M3 × 8 mm screws. Reuse the 4 carrier nuts from Step 2. No washers.

1. Compare your actual board, components and connectors with the bay. For Carrier C v10, check its changed component placement before treating this Rev B picture as a fit guide.
2. Re-seat the four underside nuts and check the leads again. Orient the board with the SuperMini programming connector toward the rear.
3. Lower the board onto all four integral seats. Its holes should align, and the board should sit flat without being pulled down by screws.
4. Start all four screws into their nuts, then tighten gently from above. Check beneath and around the board for trapped wires, solder tails or components touching the chassis.

Ready to continue: the board rests on all four seats, all four screws engage their nuts, and the actual board and leads clear the chassis.

Do not use screw pressure to overcome a clearance problem. No approved added spacer or washer stack is supplied for this mounting.

06

### Attach the front bumper

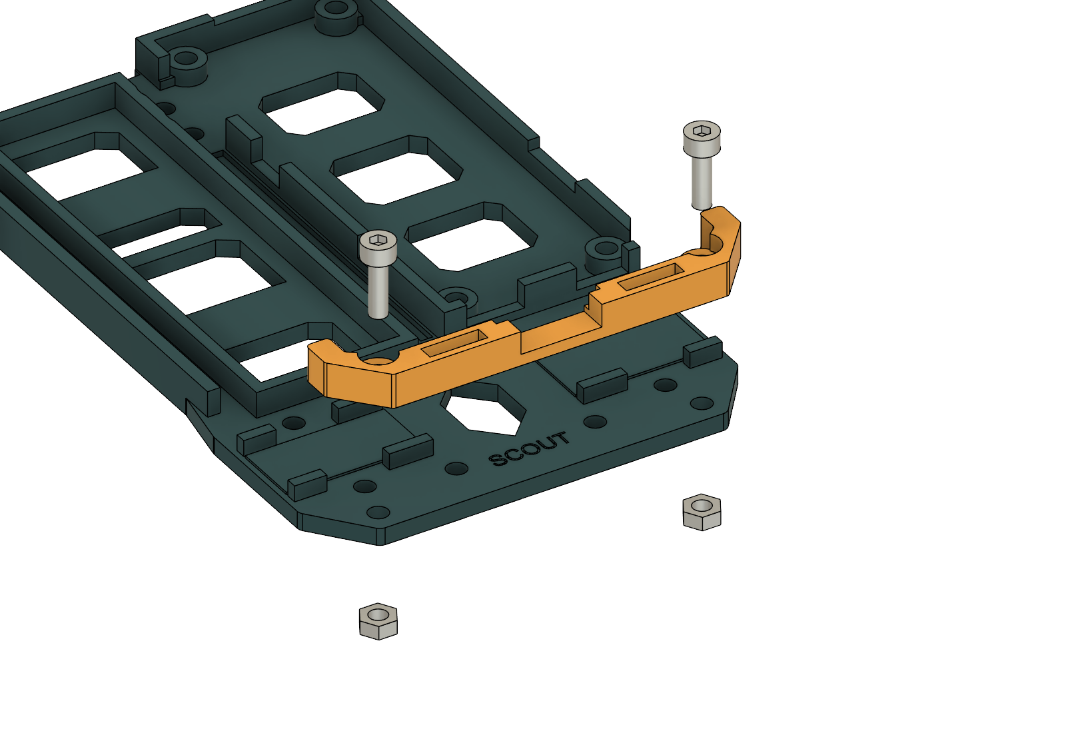
[picture p60: assets/build/06-bumper.png]
Wraparound front bumper aligned with the SCOUT end of the chassis, showing two screws above and two nuts below.


Fit the bumper at the SCOUT end. Its wraparound ends face rearward; the screws pass down through the bumper and chassis into the nuts.

New hardware

2 × M3 × 10 mm screws + 2 × M3 hex nuts.

1. Place the Rev B bumper against the front of the chassis and align its two attachment holes.
2. Insert the screws from above and fit the nuts beneath. Start both screws before tightening either one.
3. Tighten gently and evenly, keeping the mating surfaces seated and the nearby motor leads clear.

Ready to continue: the bumper is seated and held by both screws and nuts, with no nearby lead pinched.

Want a face or camera instead? See the optional OLED and ESP32-CAM replacement bumpers and their separate assembly instructions before choosing the front attachment.

07

### Attach the tail skid

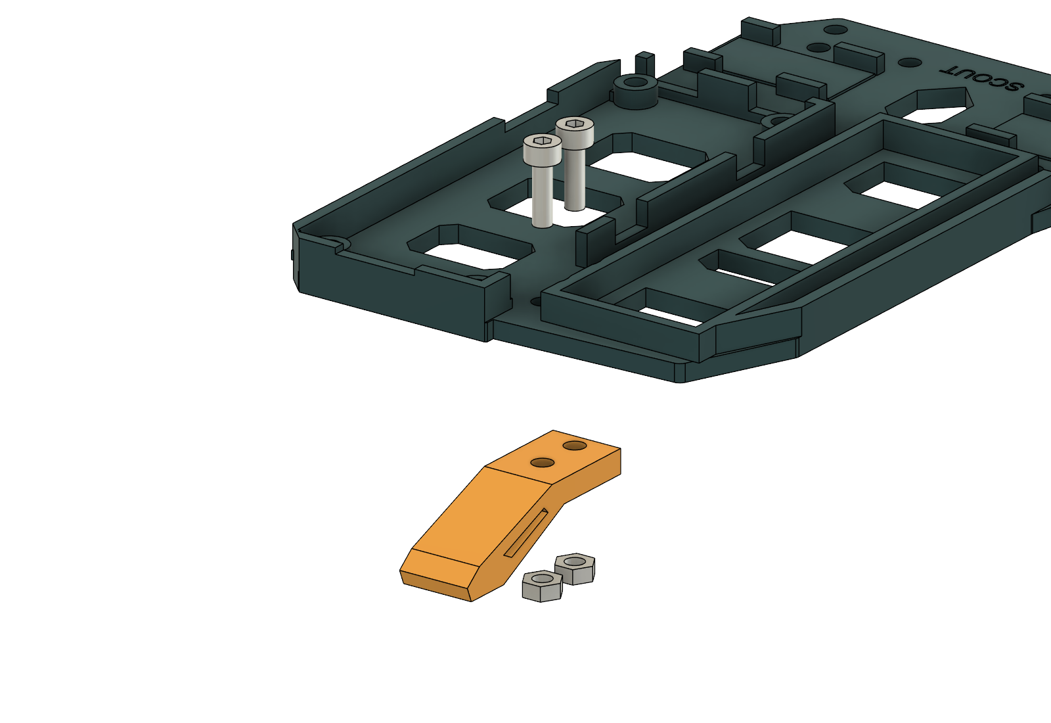
[picture p61: assets/build/07-tail.png]
Rear chassis and swept tail skid separated, with two screws entering from above and nuts beneath the skid.


The skid fits beneath the rear of the chassis, with its toe extending rearward and down. Keep access to both screw heads from above.

New hardware

2 × M3 × 10 mm screws + 2 × M3 hex nuts.

1. Position the skid beneath the rear attachment points and align both holes.
2. Insert the screws from above. Fit the nuts beneath the skid and tighten gently while keeping the skid seated.
3. With the carrier installed, try the Allen key on both screws. Keep wires out of the vertical tool path.

Ready to continue: the tail skid is secure, its toe faces the ground, and both screw heads remain accessible.

The model passed an 8 mm diameter driver-clearance check. Confirm the result with your actual tool, printed parts and board.

08

### Fit the wheels

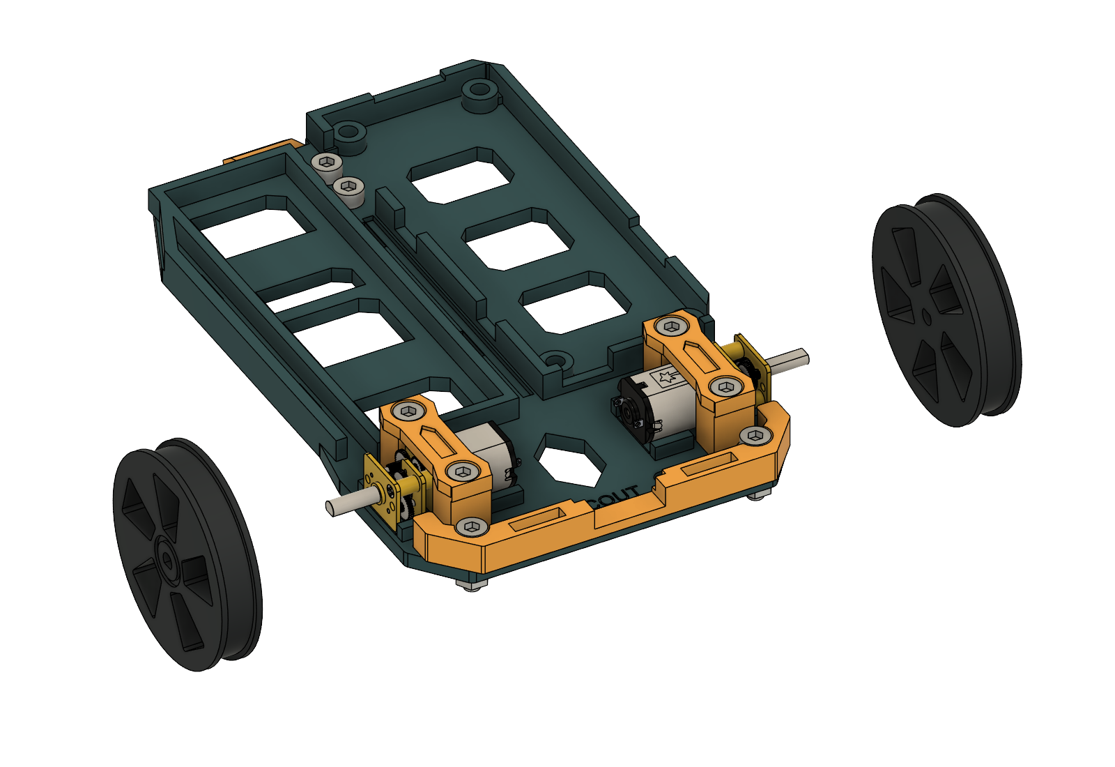
[picture p62: assets/build/08-wheels.png]
Two wheels separated outward along the fitted motors’ shaft axes, showing their D-bore attachment positions.


Slide each wheel inward along its motor shaft, matching the D-flat. The previously fitted board is hidden in this view for clarity.

New hardware

None specified. The modeled wheel interface is a D-bore press fit.

1. Confirm that the shaft-fit check passed on both motors. Align each wheel’s D-shaped bore with its shaft flat.
2. Fit the wheel carefully while supporting the motor. Do not hammer it on or force the gearbox to accept a tight bore.
3. Rotate each wheel gently through a full revolution. Check clearance around the chassis, clamps and bumper.
4. Check that the wheels stay on during gentle handling. Correct a tight or loose fit before proceeding.

Ready to continue: both wheels fit their actual shafts, stay in place during a gentle hand check, and turn without rubbing.

No retaining screw, adhesive, clip or tested retention force is specified. The printed fit still needs a physical check.

09

### Trial-fit the holder and check the whole assembly

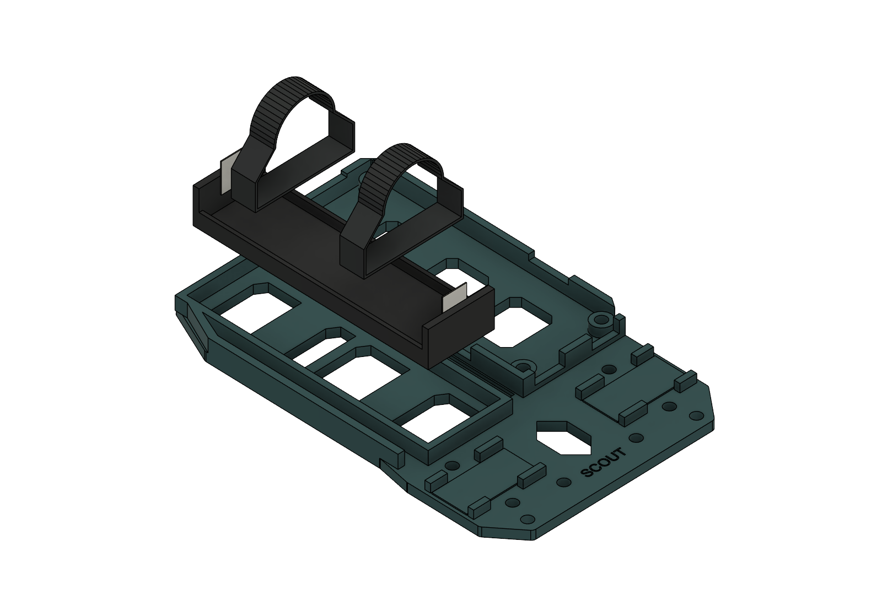
[picture p63: assets/build/09-holder-straps.png]
Reference battery holder and two fabric straps separated above the chassis floor slots, with no battery installed.


Holder and strap placement reference. The modeled straps are 8 mm fabric references; the exact purchased holder, strap length and closure are not specified.

New hardware

No additional M3 hardware specified. Check the installed total: 12 screws and 12 nuts.

1. Trial-fit the actual empty battery holder. Compare it with the bay and floor-slot arrangement shown. Establish a suitable retention method with your chosen holder and straps; this reference view does not establish a tested attachment.
2. Count four M3 × 16 mm clamp screws, four M3 × 8 mm board screws, four M3 × 10 mm bumper/skid screws, and twelve nuts. Check every joint by hand without overtightening.
3. Set the chassis on a level surface. Check the wheel gaps, skid contact and lead routes. Keep loose leads away from the wheels.
4. With the robot still unpowered, insert and remove your actual charging and programming plugs. Check both tail-screw tool paths again.
5. Resolve the battery-holder retention, offboard RUN-switch mounting, wire retention and any Carrier C clearance differences before powered commissioning.

Mechanical handoff: the hardware count matches, wheels and skid clear their surroundings, and actual tool and plug access has been checked. Any unresolved fit or attachment is corrected before adding power.

Keep the cell removed while moving to the Board guide for electrical checks. Use the Code guide when you are ready to load the matching firmware.

Connect the whole robot

## One picture for all the wiring

Use this component-side view for the current Carrier C v10 / Silk 03. It shows the battery holder, both motors, the external RUN switch and the optional OLED together. Remove the cell and unplug both USB cables before soldering or changing any connection. Left and right mean Scout's sides when looking forward toward the bumper.

Complete Scout Carrier C v10 wiring: battery positive to J1 pad 1 and negative to pad 2, left motor to J2, right motor to J3, RUN switch across J4, and OLED to SuperMini 3V3, GND, GPIO5 SDA and GPIO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

Top / component side, with the SuperMini USB at the top. Lines show electrical connections, not the physical cable route. Open the full-size wiring diagram · Download the wiring diagram · SVG

1. Battery holder → J1. Positive goes to pad 1 / BAT_PLUS (lower pad in this view); negative goes to pad 2 / BAT_MINUS (upper pad). Use one 18650 cell. BAT_MINUS is the raw cell return: never join it directly to protected GND.
2. Left motor → J2; right motor → J3. Each motor uses both pads of its connector. These are reversing motor outputs, so neither lead is a permanent ground. Check each motor's direction with the wheels raised and use the controller's saved direction setting if needed.
3. RUN switch → J4. Connect a two-terminal on/off switch between pad 1 / FUSED_BAT (lower) and pad 2 / VMOTOR (upper). Open is off; closed is RUN. This is a two-wire connection across J4, with no ground wire.
4. Optional OLED → U1 header solder joints. VCC goes to 3V3, GND to protected GND, SDA to GPIO5 and SCL to GPIO7. Follow the OLED's printed signal labels; its connector order can vary. The carrier has no separate OLED connector. See the enlarged SuperMini pinout for all header positions.
5. Retain and inspect the leads. Leave service slack, keep wires clear of wheels and screw access, and check battery polarity and solder joints before inserting the cell. Continue with the first-power procedure.

Before using USB: open RUN before connecting the SuperMini's USB cable, and unplug that cable before closing RUN. Keep RUN open while charging through the carrier's J5 USB-C port. The carrier has no charge-and-run load sharing.

What the drawings establish

## Use the model, then check the real parts

The Rev B assembly reported no solid interferences or timeline issues, and the standalone chassis and board files were reopened in Fusion. Tool and representative USB-plug envelopes also cleared the modeled assembly. Those checks help you understand the layout; they do not establish the fit of a particular print, motor, battery holder or cable.

The pictured populated board is Rev B. Carrier C v10 component placement still needs a mechanical fit check. Flexible straps and hidden alternative modules were excluded from the interference checks.

For the underlying results, read the mechanical checks, service-access checks and standalone Fusion reopen checks.

Make it your own

## Build files and editable CAD

Use the print package for a matching set of STL files and hardware notes. Choose the CAD package to inspect or adapt the chassis in Fusion or another STEP-compatible design tool.

Download Rev B print set Download Fusion and STEP CAD

### Individual print files

- Integral chassis · STL
- Left motor clamp · STL
- Right motor clamp · STL
- Standard front bumper · STL
- Tail skid · STL
- Left wheel · STL
- Right wheel · STL
- Optional shaft-fit coupon · STL
- Print notes · Fastener checklist · CSV

### Individual CAD files

- Complete Rev B assembly: Fusion · STEP
- Standalone integral chassis: Fusion · STEP
- Standalone populated Rev B board: Fusion · STEP

The complete assembly retains the full parametric history. The standalone populated board is a component/body snapshot of Rev B; it does not represent Carrier C v10 placement.

← All four guidesContinue to The Board →

Scout builder documentation · Rev B mechanics · Carrier C v10 · web firmware 19 October 2026 · ScoutFaces 1.0.0 · v8 cases

Back to Scout
