instructorJasonWhite/c3-scout-robot/06-Scout-Control/CONTROL-GUIDE.html

C3 SCOUT ROBOT PROJECTGUIDE UPDATED · 19 OCTOBER 2026

Carrier C v10 · Browser controls + Android app 1.2.0 · SCOUT 2

# Scout Web Control and Firmware Guide

Drive Scout with a virtual joystick over its own Wi-Fi network. The ESP32-C3 serves its own controller: joystick, speed limit, Stop, saved motor directions and animated OLED face buttons. Open it from a phone, tablet or computer on Scout Wi-Fi. Browser updates run every 100 ms, replies time out after 800 ms, and the ESP stops browser driving after one second without a valid command. Android retains its 400 ms cutoff.

Wi-Fi local controlProtocol 2Bench tested on Motorola Android 10

Download app, firmware and sourceDownload Android APKFirmware codeAndroid code

The HTML guide contains complete source listings and works offline. The software ZIP includes this guide, editable source, tests, build helpers, the debug APK and matching firmware images.

Scout browser controller showing joystick, drive limit, face selection and Stop

Scout web console · device bench capture

## Drive Scout from a web browser

No app installation is required. Scout serves the controller itself, so a phone, tablet or computer can drive over its local Wi-Fi. Keep the controller tab visible and use one controller at a time.

1. Before connecting ESP USB or uploading firmware, keep RUN OPEN/OFF. The current firmware is included in the software download.
2. Before powered driving, unplug ESP USB, lift the wheels for the first direction check, then close RUN.
3. Join C3-Scout-Test, password ScoutTest42. Choose to stay connected even though it has no Internet.
4. Open http://192.168.4.1/ in your browser, then press Connect. This address works while connected to Scout, not from the public Internet.
5. Start at the default 35% drive limit. Drag the joystick to move and release to send zero. Press Stop to end the session; reconnect deliberately to drive again.

### Controls and animated faces

The page includes the joystick, speed limit, motor targets and a pinned Stop button. Expand Motor directions after stopping to save each motor’s reverse setting. On this Scout both reverse flags are ON; a normal firmware upload preserves them.

Choose Auto to cycle all ten expressions, or choose Happy, Laughing, Surprised, Angry, Sad, Sleepy, Skeptical, Winking, Cheeky or Dizzy. The eyes keep blinking and looking around while driving. Swipe the face row to see every choice. The 128×64 SSD1306 uses SDA GPIO5, SCL GPIO7, 3V3 and GND; the tested address is 0x3C. If the OLED is unavailable, the controller disables the face buttons while retaining motor control.

### 19 October steering and connection update

Reverse turns now follow the intended steering direction. Straight forward/reverse travel and turning on the spot retain their confirmed mapping. Keep both saved motor reverse flags ON for this Scout.

The browser sends the current joystick command every 100 ms without waiting for each earlier reply. Its reply timeout is 800 ms. Browser sessions on the ESP expire after 1 second without an accepted drive command; Android sessions retain their existing 400 ms timeout. Release sends zero immediately, and Stop ends the session immediately when received. After a lost connection the motors may continue for up to one second before the ESP cutoff.

Operator feedback: after the timing update, Scout is reported to be working “way better,” and the direction is confirmed correct. This is a successful driving check, not a range or endurance qualification. Reload the controller page after updating firmware to load the current steering and timing. If a session expires or replies are delayed, check Scout Wi-Fi and press Connect deliberately; movement never automatically resumes.

A hidden page, lost focus, a browser UI stalled for more than 250 ms, missing replies or excessive send backlog still ends control. Face selection does not renew the motor lease. Release blocks a new movement until its zero command is acknowledged. Duplicate, future and stale replies cannot keep a session alive.

### What was verified

- Twelve browser regression test groups, 310 firmware host checks, Android compatibility suites and browser layouts at 390×844, 375×667 and 844×390 passed. Tests cover 600 ms reply latency, the 100 ms update interval, exact timeout boundaries, release, Stop and controller ownership.
- The installed build uses 1,182,293 bytes of application flash and 40,792 bytes of static RAM. Flash hashes verified on COM3; serial checks confirmed ready, OLED ready, zero motor targets, driver disabled, preserved calibration and the 1000 ms browser timeout.
- The operator confirms improved wireless driving after installation. Longer wireless stress, range and endurance tests remain separate work.

### Build and compatibility

The download includes the current ESP firmware, browser sources and tests, Android app 1.2.0, and ScoutFaces 1.0.0. The Android app uses the same single-controller session and protocol 2. Stop the current controller before switching between app and browser.

Install Arduino WebSockets 2.7.2, Adafruit SSD1306/GFX and the included ScoutFaces library. The build helper generates the compressed page from source/firmware/web before compiling. The ESP serves HTTP on port 80, browser drive on WebSocket port 81, and retains UDP 4210 for the Android app. Source and build instructions are included below; local tool paths may need adjustment on another computer.

## Android app setup (optional)

1. Before programming: open RUN or remove its jumper before connecting the ESP module's USB port to the computer. Load the matching SCOUT 2 firmware.
2. Install Scout-Control-debug.apk on the Android phone. It is a debug-signed test build; Android may ask you to allow installation from the app opening the APK.
3. Before powering the motors: unplug the ESP USB cable, lift the wheels clear for the first direction check, then close RUN. Keep RUN open while charging or programming; this carrier has no charge-and-run load sharing.
4. Open Scout, tap Connect, grant the requested Wi-Fi permission, and approve C3-Scout-Test in Android's prompt. On Android 10–12, also turn on the phone's Location switch. The app does not read GPS location.
5. For Android 8–9, join C3-Scout-Test manually first, using password ScoutTest42, and choose to stay connected without Internet.
6. Start at the default 35% drive limit. Push up for forward, down for reverse, or sideways to turn. Release to stop. At full forward travel, 35% requests about 44% motor power.
7. Press STOP to end the session. Tap Connect for a new session; it begins at zero and requires a new joystick touch.

Use Android app 1.2.0 with SCOUT 2 / protocol 2. TEST 04 and SCOUT 1 are earlier firmware and do not support this app's packet drive channel.

## Direction settings

Steering correction in app 1.2.0. After both motor directions were reversed, the original steering mix turned the wrong way. This patch reverses only the steering differential: steering = turn while moving forward or turning on the spot, and −turn while reversing; left = forward − steering, right = forward + steering, before power mapping. Straight forward and reverse commands are unchanged. Keep both saved reverse flags ON for this Scout. The browser correction requires the current ESP firmware; the included APK also contains the reverse-turn correction.

The tested Scout had forward and reverse swapped with the initial motor wiring. Both saved motor-direction switches are now ON: Reverse left motor and Reverse right motor. Saving and reading the settings back from the board confirmed the change.

1. Press Stop, then open Motor directions.
2. For this Scout, enable both reverse switches and tap Save directions.
3. Reconnect and check forward with the wheels lifted. Other builds may need different settings depending on motor wiring.

The ESP stores these flags in nonvolatile storage under scout-motors, using keys leftReverse and rightReverse. A fresh or erased board defaults both flags to OFF. A normal application upload preserves them. Calibration is accepted only while the drive session is ended and the motor outputs are disabled.

Motor targets in the app remain signed forward/reverse commands; the saved flags determine the physical pin polarity. The direction correction is configuration, not a different firmware binary.

## Board and wiring

This software targets the ESP32-C3 SuperMini on Carrier C v10, using the TC1508A motor driver through the TXU0104 level translator. The carrier uses one 18650 cell and two geared N20 motors. Earlier module-wiring examples are superseded by this carrier pin assignment.

Connection | ESP pin | Use
Left motor, J2 | GPIO 0 and GPIO 1 | Opposite TC1508A inputs for direction and PWM
Right motor, J3 | GPIO 3 and GPIO 10 | Opposite TC1508A inputs for direction and PWM
Driver/translator enable | GPIO 6 | Active high; low at startup, Stop and expiration
Motor PWM | Four output channels | 10 kHz, 8-bit duty, one direction input active per motor

Use the Carrier C v10 factory guide for the electrical files and the Scout project index for Rev B mechanical models. The completed mechanical model is still identified separately from Carrier C electrical placement.

Open RUN before attaching the ESP USB cable. Unplug ESP USB before closing RUN. Opening RUN provides a physical motor-power cut independent of the app; the software Stop button is not a physical emergency-stop circuit.

Expansion reference · 16 October 2026

## Adding an OLED and sensors

The ESP32-C3 Super Mini exposes 13 GPIOs. Carrier C v10 uses five for motor control and connects one to battery-voltage sensing, leaving seven GPIOs unused by the carrier. Four are the preferred expansion choices: GPIO5, GPIO7, GPIO20 and GPIO21. The other three—GPIO2, GPIO8 and GPIO9—have startup restrictions.

Look down at the component side, with the module's USB connector at the top. Each arrow ends at its corresponding header pad. The same pin order is used by U1 in the Carrier C v10 board file. This is a simplified pin map, not a photograph or a drawing to scale.

Open the pinout at full size · Download the editable SVG. On a phone, scroll the diagram sideways to read the labels.

### Which pins can we use?

GPIO | Status on Scout | Expansion guidance
5, 7 | Available | Recommended I²C pair: GPIO5 = SDA, GPIO7 = SCL. Neither is wired to a carrier circuit.
20, 21 | Available, with serial caveat | Also UART RX and TX. SCOUT 2 uses USB CDC for its console, so it does not allocate these pins. GPIO21 can emit boot messages before the application starts; avoid connecting an actuator that would respond to them.
2, 8, 9 | Conditional | Boot-strapping pins: attached devices must not force an incorrect level during reset. GPIO8 also drives the usual Super Mini onboard LED; GPIO9 connects to BOOT. Leave these unused for the first expansion. Verify the exact module variant before repurposing them.
4 | Reserved for voltage sensing | Already wired to the 330 kΩ / 100 kΩ divider and 100 nF filter. It senses the switched VMOTOR rail, approximately battery voltage while RUN is closed. Current firmware does not read it; it is not a spare digital pin.
0, 1 / 3, 10 / 6 | In use | Left motor / right motor / driver enable. Keep these connections dedicated to motor control.

### Recommended four-wire I²C OLED connection

Use a four-pin I²C OLED module rated for 3.3 V power and logic, for example an appropriate SSD1306 module. Check the labels on that display: the order of its VCC and GND pins varies between products. The table gives signal names, not a universal connector order.

OLED pin | Connect to Super Mini | Purpose
VCC / VIN | 3V3 | Regulated 3.3 V power; carrier test pad TP6 is on the same net
GND | GND | Common ground; carrier test pad TP1 is on the same net
SDA | GPIO5 | I²C data
SCL | GPIO7 | I²C clock

No dedicated sensor or OLED connector is fitted on Carrier C v10. Attach a short harness to the module header pins or their carrier solder joints. If the module is socketed, a suitable header interposer is another option. Match the printed pin labels before soldering; the underside view is mirrored. Insulate the joints, provide strain relief, and keep wiring away from the motors and antenna.

Power and logic: use 3V3 and GND for the proposed OLED. The pin marked 5V is the carrier's ESP_5V supply rail, downstream of its series diode; its battery-powered voltage can be below 5 V. It is not a GPIO or a 3.3 V logic connection. Do not connect 5 V pull-ups or 5 V sensor outputs directly to the ESP GPIOs. Check the actual module regulator's available current before adding multiple peripherals; no spare-current budget has been qualified for this assembly.

Power off and disconnect the battery and USB before attaching wires. Preserve Scout's existing power procedure: RUN open before ESP USB is connected; ESP USB disconnected before RUN is closed. Use the board's common GND, not the cell's BAT_MINUS terminal, for peripherals.

### Firmware changes and future sensors

The current SCOUT 2 firmware operates the 128×64 SSD1306 OLED with animated ScoutFaces on GPIO5/SDA and GPIO7/SCL. External sensor integration is still future work. An OLED update needs the appropriate display library, an explicit I²C pin assignment and the actual display address. For the wiring above, the bus initialization would be:

#include <Wire.h>

// Inside setup(): SDA = GPIO5, SCL = GPIO7, initial bus speed = 100 kHz.
Wire.begin(5, 7, 100000);

This line only starts the bus; display initialization and drawing are additional. Keep bus operations and display refreshes bounded and outside the motor safety timer and critical sections. Handle a missing display without hanging the control loop. Verify neutral startup, disconnect handling and Stop again after any firmware change.

I²C sensors can share GPIO5/SDA and GPIO7/SCL with the OLED, provided their addresses do not conflict and their power and logic levels are compatible. Use pull-ups to 3.3 V only; modules often include them already, and several sets in parallel can become too strong. After adding the OLED, GPIO20 and GPIO21 remain available, plus the three conditional boot pins. For more digital inputs and outputs, an I²C GPIO expander is an option; keep motor-enable and other timing-critical functions on their existing direct GPIOs.

These counts describe digital I/O, not seven spare analog inputs. GPIO5's ADC2 has chip-revision restrictions; do not assume it is a usable analog input. An external I²C ADC is an option for analog sensors while preserving the existing motor and voltage-sensing connections.

Checked against the Carrier C v10 board, its schematic, and the released firmware. Technical references: Espressif I²C configuration (https://docs.espressif.com/projects/arduino-esp32/en/latest/api/i2c.html), ESP32-C3 GPIO and boot requirements (https://docs.espressif.com/projects/esp-hardware-design-guidelines/en/latest/esp32c3/schematic-checklist.html), ESP32-C3 datasheet and ADC restrictions (https://www.espressif.com/sites/default/files/documentation/esp32-c3_datasheet_en.pdf), Super Mini pin order and onboard functions (https://nuttx.apache.org/docs/latest/platforms/risc-v/esp32c3/boards/esp32c3-supermini/index.html), and OLED power and logic requirements (https://learn.adafruit.com/monochrome-oled-breakouts/power-requirements). Pin allocation has been checked from design files; the OLED addition has not been assembled or bench tested.

Optional printed parts · 16 October 2026

## OLED and ESP32-CAM bumper options

Choose one of two replacement front bumpers. Both reuse Scout’s original two M3 bumper screws and preserve the 56 mm mounting-hole spacing. Each download includes printable STL files, editable Fusion designs, STEP files, assembly instructions and verification reports.

Prototype parts: physical fit remains untested. CAD assembly and closed-mesh checks passed. Test your printed parts, actual electronics and cable before driving. These are optional mechanical changes; the released Scout app and SCOUT 2 firmware are unchanged.

Option | Fit and hardware | Electronics
0.96-inch OLED bumper | One printed bumper with a 45° display cradle. Designed around the DIYmall B01HEBIJKK board: 27.3 mm square, 20.7 × 23.2 mm mounting pattern. Add four M2 × 12 screws and nuts. | Proposed I²C wiring: SDA → GPIO5, SCL → GPIO7, VCC → 3V3, GND → GND. OLED firmware support still needs to be added.
ESP32-CAM bumper USB adapter stays attached | Two printed parts: upright camera bumper and sliding rear support. Adjusts for 10–25 mm stack depth; fixed 28 mm inside width and 41 mm camera seat height. Add two M3 × 12 screws, two nuts and four washers. | The ESP32-CAM is a separate controller with its own camera firmware. Use its adapter’s USB power input with a suitable regulated 5 V supply. It does not replace the OLED on the I²C wires.

### OLED display mount

Fusion model of Scout with an integrated angled OLED bumper

The integrated display cradle replaces the original bumper. The display shown is a reference model.

OLED print and assembly guide · Download OLED package (https://mechatronicsaint.com/downloads/c3-scout/Scout-OLED-Bumper-v1.zip) · Bumper STL · Editable Fusion bumper

Follow the annotated GPIO pinout and power notes above when preparing the display harness. Check the actual OLED’s signal labels before wiring; module pin order varies.

### Forward-facing camera with attached USB adapter

Fusion model of Scout with forward-facing ESP32-CAM and its USB programming adapter retained behind it

The adjustable rear support retains the plugged-in USB adapter. The connector and electronics are illustrative envelopes; actual kit dimensions remain unverified.

ESP32-CAM print and assembly guide · Download camera package (https://mechatronicsaint.com/downloads/c3-scout/Scout-ESP32-CAM-Bumper-v1.zip) · Bumper STL · Rear support STL · Editable Fusion mount

The camera faces forward, with its antenna up and USB/microSD access below. Remove the rear support before inserting the assembled camera and adapter, then reinstall it and slide it into gentle contact with bare PCB edges. It is a locating stop, not a clamp for forcing the boards together. Small cable ties restrain the USB lead through the upright openings.

This prototype targets the HiLetgo ESP32-CAM kit (https://www.amazon.com/dp/B07RXPHYNM). The camera PCB outline is documented, but the assembled USB-adapter stack and connector revision are not. The depth adjustment does not compensate for a board that is too wide or tall. Check component contact, retention and cable clearance against the detailed guide.

Camera power is a separate integration step. Do not power it from a C3 GPIO. Before connecting it to Scout’s battery system, verify regulator capacity and supply stability under motor load. Camera streaming and control-app integration are not included in this mechanical release.

The complete robot ZIP includes both options under 07-Bumper-Options/. The smaller software-only ZIP includes this guide; companion CAD files require a bumper package or the complete robot download.

## Motor power mapping

The small gearmotors did not reliably turn below roughly 40% motor power. Each wheel's logical command, after joystick dead-zone handling, mixing and the drive limit, is mapped independently:

magnitude = abs(logical wheel command)
if magnitude <= 30:
    motor target = 0
else:
    motor magnitude = 40 + floor((magnitude - 30) * 60 / 70)
    motor target = original sign * motor magnitude

Logical wheel magnitude | Mapped motor target
0–30% | 0% · off
31% | 40%
35% | 44%
40% | 48%
60% | 65%
65% | 70%
100% | 100%

Reverse uses the same magnitudes with the opposite sign. The threshold applies after mixing and the drive limit, so at the default 35% limit, movement starts near the outer part of joystick travel. The L/R labels display the mapped targets, not measured speed.

The app sends physical motor targets; firmware does not apply the mapping a second time. It independently clamps physical targets below 40% to zero. Every nonzero PWM value is at least 102/255, including the 200 ms acceleration ramp. A direction change holds both inputs low for at least 100 ms before applying opposite power. There is no full-power startup kick.

## Android connection and stopping

Android joysticklatest left/right pair

→

Wi-Fi · UDP 4210commands about every 50 ms

→

ESP motor loopPWM and enable gate

Scout is its own access point: C3-Scout-Test, password ScoutTest42, IP 192.168.4.1. It uses Wi-Fi, not Bluetooth, and needs no cloud account or Internet connection. These are shared development credentials embedded in both source trees; changing them requires updating both builds.

Android 10 and later use an exact-network request and bind the control sockets to Scout's Wi-Fi. The app retains this request while visible. A normal Stop ends the motor session while retaining Wi-Fi for quick reconnect or calibration. Leaving the app stops the session and releases the request. Later radio recovery never automatically resumes driving.

HTTP handles setup, status and calibration in a separate ESP task. Continuous driving uses UDP to avoid the HTTP stalls reproduced on the test phone. A random session token and increasing sequence reject old or foreign drive commands. Acknowledgements also include the board's boot identity.

Condition | Response
Joystick released | An urgent zero pair takes priority over a rapid new touch
Stop pressed | Three global Stop packets plus an independent HTTP Stop attempt; token revoked
No accepted drive command for 400 ms | Independent ESP timer disables the driver and ends the session
No fresh valid acknowledgement for 400 ms | App ends the session and requires reconnect
App UI stale for more than 250 ms | Held input is discarded; reconnect required
App paused, hidden, or active window loses focus | Session is ended; repeated lifecycle exits share one cleanup
Firmware setup or PWM fault | Not ready; outputs remain disabled

The ESP checks expiration every 10 ms independently of web requests. This is a software cutoff with scheduler and hardware response time, not a certified stop-time guarantee. The board has no wheel encoders, battery telemetry, or current feedback in this release.

## Build and install

Unzip the software download, then work inside its source directory. The APK and firmware images at the package root are the tested builds.

Tool | Tested version or setting
Android SDK | Platform 35; build-tools 35.0.0; platform-tools/ADB
Android Gradle plugin / Gradle | 8.7.0 / 8.11.1
Java | Temurin 21.0.12; source/target compatibility Java 17
Android support | Minimum API 26; target API 35; actual device test Android 10 / API 29
Firmware toolchain | Arduino ESP32 core 3.3.12; ESP32-C3; USB CDC enabled
Arduino board identifier | esp32:esp32:esp32c3:CDCOnBoot=cdc

### Android

# From the extracted source directory, with Java, Gradle and SDK installed:
./scripts/build-android.ps1
./scripts/install-android.ps1

# Override tool paths when needed:
./scripts/build-android.ps1 -SdkPath "C:\Android\Sdk" -JdkPath "C:\Java\jdk-21" -GradlePath "C:\Gradle\gradle-8.11.1\bin\gradle.bat"

The build helper runs the host suites, builds a debug APK and verifies its signature. There is no bundled Gradle wrapper; supply Gradle or import source/android into Android Studio using the listed versions. Installation requires USB debugging and authorization of the computer on the phone. On Android 13 and later, grant Nearby devices; on Android 10–12, grant the Wi-Fi-related Location permission and turn Location on.

### ESP firmware

In Arduino IDE, open source/firmware/ScoutDrive/ScoutDrive.ino with both headers in the same folder. Select ESP32C3 Dev Module with USB CDC On Boot enabled. Or use Arduino CLI with the listed core installed:

arduino-cli compile --fqbn esp32:esp32:esp32c3:CDCOnBoot=cdc --output-dir firmware/output firmware/ScoutDrive

# RUN must be OPEN before ESP USB is connected. Replace COM3 with your port:
arduino-cli upload --fqbn esp32:esp32:esp32c3:CDCOnBoot=cdc --port COM3 --input-dir firmware/output firmware/ScoutDrive

The PowerShell firmware helper accepts -ArduinoCli and -ArduinoData; its defaults describe the original development computer, so set them to your installed toolchain. The guarded upload helper expects its matching generated configuration:

./scripts/build-firmware.ps1 -ArduinoCli "C:\Tools\arduino-cli.exe" -ArduinoData "$env:LOCALAPPDATA\Arduino15"
./scripts/upload-firmware.ps1 -Port COM3 -RunOpenAndEspUsbConnected -ArduinoCli "C:\Tools\arduino-cli.exe"

Use a normal application upload to preserve motor calibration. Do not erase the whole flash unless you intend to reset saved settings. After a fresh flash, set both direction switches ON for the wiring used on this Scout.

### Host checks

./android/test-host.ps1
./firmware/test-host.ps1

The firmware host script uses MSVC and accepts a toolchain path through scripts/test-firmware.ps1 -MsvcRoot. It builds a minimal Windows import library rather than requiring the full Windows SDK. Local HTTP tests need permission to open loopback sockets.

## Protocol reference

Protocol 2 pairs SCOUT 2 firmware and app 1.1. HTTP is local cleartext on port 80; drive traffic and acknowledgements use UDP port 4210. The token prevents stale sessions from controlling the motors; it is not encryption.

HTTP endpoint | Purpose
GET /status | Read version, readiness, boot identity, session state, mapped targets, direction flags and timeout
POST /session · empty body | Open a neutral session and return its 32-character hexadecimal token; reject another live session
POST /stop | Global Stop and token invalidation; available even if extra fields are supplied
POST /config | Form fields leftReversed=0|1, rightReversed=0|1; session must be ended
POST /drive | Retained diagnostic handler with token, seq, left, right; the app uses UDP instead

Status includes protocol, version, drivePort, boot, ready, connected, enabled, left, right, leftReversed, rightReversed, timeoutMs and message. Only the session response adds token.

### Drive packet · 45 bytes

Byte offset | Length | Field
0 | 4 | ASCII SCT2
4 | 1 | D drive or S global Stop
5 | 32 | Lowercase hexadecimal session token; app Stop uses 32 zeros
37 | 4 | Unsigned sequence; drive starts at 1 and increases
41 | 2 | Signed left motor percentage, −100 to +100
43 | 2 | Signed right motor percentage, −100 to +100

### Acknowledgement · 50 bytes

Byte offset | Length | Field
0 | 4 | ASCII ACK2
4 | 32 | Echoed token
36 | 4 | Echoed unsigned sequence
40 | 1 | Result: 0 accepted, 1 conflict, 2 invalid, 3 unavailable
41 | 4 | Unsigned boot identity
45 | 1 | Flags: ready 1, connected 2, enabled 4
46 | 2 | Left requested target
48 | 2 | Right requested target

All multibyte integers use big-endian network order. Malformed drive frames are discarded. Expired, wrong-token or non-increasing drive commands cannot renew the lease. Reordered acknowledgements cannot renew the app's reply timer. Stop invalidates the token, so a delayed drive packet cannot restart an ended session.

## Earlier Android integration checks

Checks were performed on 15 October 2026 using an actual Moto G Play (2021), Android 10, and the ESP32-C3 on Carrier C v10. The operator confirmed that the motors turned and that the revised robot control worked.

Check | Observed result
Android control math | 429 checks passed: threshold range, symmetry, monotonicity, mixed targets and bounds
Android session, HTTP and packet suites | Passed: release priority, stale UI/replies, reconnect, network ownership, lifecycle cleanup, bounded responses and packet rejection
Firmware core and codec | 268 checks passed, including lease expiry, token/sequence checks, reversal and the nonzero PWM floor throughout the ramp
Build and upload | APK signature verified; ESP upload hashes verified; actual startup ready, disabled, zero targets
15 October firmware size (historical) | 1,022,277 bytes program storage; 38,664 bytes static RAM
Wi-Fi retention | 30-second packet-channel check stayed connected without link errors; subsequent brief drive checks retained the session
Power mapping on phone | 35% limit showed +44%/+44%; 30% full-stick check showed zero/zero
Release, Stop and reconnect | Release returned targets to zero; Stop ended the session; reconnect was neutral
Leave and return | Session ended; final build returned stopped without duplicate Stop warnings or logged crashes
Saved direction correction | Both reverse flags changed to ON and read back from the board

These are bench and operator checks, not a measured range, endurance, stall-current or electrical-protection qualification. Displayed percentages are commands, not wheel-speed measurements.

Earlier HTTP drive builds reproduced timeouts even while the phone remained on Scout Wi-Fi. This release uses UDP for continuous control and a separate web task. Local tool output also contained a non-blocking Android SDK metadata-version warning.

## Troubleshooting

Symptom | Action
Scout does not appear in Android's prompt | Check robot power, Wi-Fi permission, and Location on Android 10–12. Cancel a stale prompt, then retry Connect.
Connected, no Internet | Expected for Scout's local network. Stay connected; Internet is not required to drive.
Link ends or replies are lost | Stop, check robot power and distance, then reconnect. Motors do not automatically resume when the radio returns.
Firmware update needed | Install matching SCOUT 2; app 1.2.0 does not drive SCOUT 1 or TEST 04.
Motors remain still at low input | Logical wheel targets at or below 30% are intentionally off. Start at 35% with full joystick travel, then raise the limit gradually if needed.
Forward runs backward | Stop and adjust Motor directions. On the tested Scout, both reverse switches are ON.
One wheel runs backward | Change only that wheel's saved reverse flag and repeat the wheels-lifted direction check.
Another live session exists | Press Stop, then reconnect. A stopped or expired session's old token cannot be reused.

## ScoutFaces: reusable animated OLED library

Give a future OLED project Scout’s ten funny faces, with blinking and glances. Oversized eyes, eyebrows, a small nose and expressive mouths fill the 128 × 64 screen. Each expression lasts about six seconds before the next one appears.

Download ScoutFaces 1.0.0 Arduino library · includes editable source, artwork, API documentation and two example sketches.

Happy, laughing, surprised, angry, sad, sleepy, skeptical, winking, cheeky and dizzy OLED faces

All ten expressions. The library adds blinks and left, right, up and down glances to these faces.

### Install and try it

1. Download the ZIP above. In Arduino IDE select Sketch → Include Library → Add .ZIP Library… and choose it.
2. Install Adafruit SSD1306 and Adafruit GFX Library with their dependencies through Library Manager.
3. Open File → Examples → ScoutFaces → AutoCycle. Choose your board and set its SDA/SCL pins. The example is configured for Scout’s ESP32-C3: SDA GPIO5, SCL GPIO7, 3V3 and GND. It checks 0x3C and 0x3D; Scout’s OLED responds at 0x3C.
4. For Scout, keep RUN OPEN before connecting ESP USB and enable USB CDC On Boot. The examples hold motor enable GPIO6 LOW. Remove that Scout-specific pin assignment on other boards when appropriate. Uploading a demo replaces the drive firmware; restore ScoutDrive when you want phone driving again. Unplug ESP USB before RUN ON.

### Add it to your own sketch

Create and initialize your display as usual, then bind the library to it. Call update() regularly; flush the driver’s framebuffer only when it returns true.

#include <Wire.h>
#include <Adafruit_SSD1306.h>
#include <ScoutFaces.h>

Adafruit_SSD1306 display(128, 64, &Wire, -1, 100000, 100000);
ScoutFaces faces(display);

void setup() {
  // ESP32 pin setup. Adapt this call for other board families.
  Wire.begin(5, 7, 100000);
  if (!display.begin(SSD1306_SWITCHCAPVCC, 0x3C, false, false)
      || !faces.begin()) while (true) delay(1000);
}

void loop() {
  if (faces.update()) display.display();
  // Other application work goes here.
}

The integration snippet assumes your project already handles any motor-enable pins. For a standalone Scout test use the supplied examples, which explicitly disable its motor driver.

### Choose an expression or adjust timing

// Keep this expression, while its eyes continue to blink and glance:
faces.setExpression(ScoutFaces::Expression::Cheeky);

// Resume cycling from the current expression:
faces.setAutoCycle(true);

// Default timing: 48 ticks × 120 ms = 5.76 seconds per expression.
faces.setFrameInterval(120);

API | Behavior
begin() | Starts the timeline; returns false unless display dimensions are 128 × 64 in landscape.
update() | Draws only changed poses; returns true when you should flush the framebuffer. Does not initialize or communicate with hardware.
setExpression(expression) | Selects one face and turns expression cycling off; eye animation continues. Resets its timeline.
setAutoCycle(true/false) | Enables or disables expression cycling and restarts its timeline.
setFrameInterval(ms) | Sets milliseconds per tick, minimum 20. Use 120 for the tested 100 kHz connection.
expression(), pose(), autoCycle() | Read current state; expression/pose reflect the latest update.
ScoutFaces::name(expression), expressionCount() | Get the expression name or the count of ten expressions.

Expression names: Happy, Laughing, Surprised, Angry, Sad, Sleepy, Skeptical, Winking, Cheeky, Dizzy. Prefix each with ScoutFaces::Expression::. See the ZIP’s README for clock arguments and pose names.

### Compatibility and limits

Compiled for ESP32-C3 with Arduino ESP32 3.3.12, SSD1306 2.5.17 and GFX 1.12.6. Other 128 × 64 GFX framebuffer drivers can be bound to the renderer; their initialization and flush calls remain your responsibility. Artwork occupies 92,160 bytes of flash, so an ATmega328P Uno or classic Nano cannot hold it. Other boards need sufficient memory and their own Wire configuration.

The library has no animation delays or pin, Wire, Serial or motor calls. It clears the full framebuffer when drawing and skips missed poses if the main loop is late. Your display flush still takes about 100 ms at 100 kHz; keep it out of timing-critical motor control. Faster timing requires a faster compatible bus. Geometry checks do not detect missing hardware; check wiring and the address if the screen is blank. If frames never appear, confirm you call display.display() after a true update result.

The original animated demo ran a complete verified USB cycle on Scout. Packaging the library does not replace the firmware on the robot.

## Complete firmware source

The sketch and headers below include the current browser controller, OLED integration and motor safety logic used to build SCOUT 2. Expand a file to read or copy it. The download contains the same files under source/firmware/ScoutDrive.

firmware/ScoutDrive/BrowserControl.h

Download this source file

#pragma once
#include "DriveDatagram.h"
#include "FaceControl.h"
namespace scout {
constexpr uint32_t BROWSER_COMMAND_TIMEOUT_MS = 1000;
enum class WebAction { Connect, Stop, Face };
struct WebCommand { WebAction action; int face = -1; };
inline bool parseWebText(const uint8_t* bytes, unsigned size, WebCommand& command) {
  if (!bytes) return false;
  if (size == 1 && (bytes[0] == 'C' || bytes[0] == 'S')) {
    command.action = bytes[0] == 'C' ? WebAction::Connect : WebAction::Stop;
    return true;
  }
  if ((size == 3 || size == 4) && bytes[0] == 'F' && bytes[1] == ',') {
    char id[3] = {char(bytes[2]), size == 4 ? char(bytes[3]) : char(0), 0};
    if (parseFaceId(id, command.face)) { command.action = WebAction::Face; return true; }
  }
  return false;
}
// Call under safetyMux. Socket ownership is in addition to the session token;
// delayed disconnects cannot affect a newer browser or Android session.
struct BrowserControl {
  int owner = -1;
  char token[33] = {};
  bool matches(const DriveCore& core, uint8_t client) const {
    if (owner != client || !core.connected) return false;
    for (unsigned i = 0; i != 33; ++i) if (token[i] != core.token[i]) return false;
    return true;
  }
  bool owns(const DriveCore& core, uint8_t client, uint64_t now) const {
    return matches(core, client) && core.ready && now < core.deadline;
  }
  Result claim(DriveCore& core, uint8_t client, const char* fresh, uint64_t now) {
    const Result result = core.session(fresh, now, BROWSER_COMMAND_TIMEOUT_MS);
    if (result == Result::Ok) {
      owner = client;
      for (unsigned i = 0; i != 33; ++i) token[i] = fresh[i];
    }
    return result;
  }
  Result drive(DriveCore& core, uint8_t client, const DrivePacket& packet, uint64_t now) {
    if (packet.stop) return Result::Invalid;
    if (!owns(core, client, now)) return Result::Conflict;
    return core.drive(packet.token, packet.sequence, packet.left, packet.right, now);
  }
  bool release(DriveCore& core, uint8_t client, uint64_t now) {
    const bool owned = matches(core, client);
    if (owned) core.stop(now);
    if (owner == client) { owner = -1; token[0] = 0; }
    return owned;
  }
};
}

firmware/ScoutDrive/DriveCore.h

Download this source file

#pragma once
#include <stdint.h>
namespace scout {
enum class Result { Ok, Invalid, Conflict, Unavailable };
struct Motor {
  int requested = 0;
  int pwm = 0;
  int lastDirection = 0, rampFrom = 0;
  uint64_t lowSince = 0, deadUntil = 0, rampAt = 0;
  static int sign(int n) { return (n > 0) - (n < 0); }
  static int magnitude(int n) { return n < 0 ? -n : n; }
  void cut(uint64_t now) {
    if (pwm != 0) lowSince = now;
    pwm = 0;
  }
  void advance(uint64_t now) {
    if (!requested || now < rampAt || now < deadUntil) { cut(now); return; }
    const int goal = (magnitude(requested) * 255 + 50) / 100;
    const uint64_t elapsed = now - rampAt;
    const int base = rampFrom < 102 ? 102 : rampFrom; // 40% PWM: never energize in the stalled low range.
    const int64_t change = (goal - base) * static_cast<int64_t>(elapsed);
    const int duty = elapsed >= 200 ? goal : base +
      static_cast<int>((change + (change < 0 ? -100 : 100)) / 200);
    pwm = sign(requested) * duty;
    if (pwm) lastDirection = sign(pwm);
  }
  void target(int value, uint64_t now) {
    if (magnitude(value) < 40) value = 0;
    advance(now);
    if (value == requested) return; // Repeated samples never restart a ramp.
    if (!value) { stop(now); return; }
    const int direction = sign(value);
    if (lastDirection && direction != lastDirection) {
      cut(now);
      const uint64_t earliest = lowSince + 100;
      if (earliest > deadUntil) deadUntil = earliest;
    }
    rampFrom = magnitude(pwm);
    if (!requested || direction != sign(requested) || now < deadUntil) rampFrom = 0;
    rampAt = now < deadUntil ? deadUntil : now;
    requested = value;
  }
  void stop(uint64_t now) { cut(now); requested = rampFrom = 0; }
};
struct DriveCore {
  bool ready = false, connected = false;
  uint64_t deadline = 0;
  uint32_t commandTimeoutMs = 400;
  uint32_t sequence = 0, generation = 0;
  char token[33] = {};
  Motor motors[2];
  bool expire(uint64_t now) {
    if (!connected || now < deadline) return false;
    stop(now); return true;
  }
  void stop(uint64_t now) { connected = false; token[0] = 0; motors[0].stop(now); motors[1].stop(now); ++generation; }
  Result session(const char* freshToken, uint64_t now, uint32_t timeoutMs = 400) {
    expire(now);
    if (!ready) return Result::Unavailable;
    if (connected) return Result::Conflict;
    stop(now);
    for (unsigned i = 0; i != 32; ++i) token[i] = freshToken[i];
    commandTimeoutMs = timeoutMs;
    token[32] = 0; sequence = 0; deadline = now + commandTimeoutMs; connected = true;
    return Result::Ok;
  }
  Result drive(const char* supplied, uint32_t seq, int left, int right, uint64_t now) {
    expire(now);
    if (left < -100 || left > 100 || right < -100 || right > 100) return Result::Invalid;
    if (!ready) return Result::Unavailable;
    if (!connected || !seq || seq <= sequence) return Result::Conflict;
    unsigned i = 0;
    while (i < 32 && supplied[i] && supplied[i] == token[i]) ++i;
    if (i != 32 || supplied[32] != 0) return Result::Conflict;
    motors[0].target(left, now); motors[1].target(right, now);
    sequence = seq; deadline = now + commandTimeoutMs;
    return Result::Ok;
  }
  void advance(uint64_t now) { expire(now); motors[0].advance(now); motors[1].advance(now); }
  bool canEnable(uint64_t now) const {
    return ready && connected && now < deadline && (motors[0].pwm || motors[1].pwm);
  }
};
inline bool parseSequence(const char* text, uint32_t& result) {
  if (!text || !*text) return false;
  uint32_t value = 0;
  for (; *text; ++text) {
    if (*text < '0' || *text > '9') return false;
    const uint32_t digit = *text - '0';
    if (value > (UINT32_MAX - digit) / 10) return false;
    value = value * 10 + digit;
  }
  result = value; return true;
}
inline bool parsePercent(const char* text, int& result) {
  if (!text) return false;
  const bool negative = *text == '-';
  uint32_t value;
  if (!parseSequence(text + (negative ? 1 : 0), value) || value > 100) return false;
  result = negative ? -static_cast<int>(value) : static_cast<int>(value); return true;
}
}

firmware/ScoutDrive/DriveDatagram.h

Download this source file

#pragma once
#include "DriveCore.h"
namespace scout {
constexpr unsigned DRIVE_PACKET_SIZE = 45, ACK_PACKET_SIZE = 50;
struct DrivePacket { bool stop; char token[33]; uint32_t sequence; int left, right; };
inline uint32_t read32(const uint8_t* b) { return (uint32_t(b[0])<<24)|(uint32_t(b[1])<<16)|(uint32_t(b[2])<<8)|b[3]; }
inline int read16(const uint8_t* b) { unsigned n = (unsigned(b[0])<<8)|b[1]; return n >= 32768 ? int(n)-65536 : int(n); }
inline void write32(uint8_t* b, uint32_t n) { b[0]=uint8_t(n>>24); b[1]=uint8_t(n>>16); b[2]=uint8_t(n>>8); b[3]=uint8_t(n); }
inline void write16(uint8_t* b, int n) { b[0]=uint8_t(unsigned(n)>>8); b[1]=uint8_t(n); }
inline bool decodeDrive(const uint8_t* b, unsigned size, DrivePacket& p) {
  if (size!=DRIVE_PACKET_SIZE || b[0]!='S'||b[1]!='C'||b[2]!='T'||b[3]!='2'||(b[4]!='D'&&b[4]!='S')) return false;
  p.stop=b[4]=='S';
  for (unsigned i=0;i<32;++i) { char c=char(b[5+i]); if (!((c>='0'&&c<='9')||(c>='a'&&c<='f'))) return false; p.token[i]=c; }
  p.token[32]=0; p.sequence=read32(b+37); p.left=read16(b+41); p.right=read16(b+43);
  return (p.stop || p.sequence!=0) && p.left>=-100&&p.left<=100&&p.right>=-100&&p.right<=100;
}
inline void encodeAck(uint8_t* b, const DrivePacket& p, uint8_t code, uint32_t boot, uint8_t flags, int left, int right) {
  b[0]='A';b[1]='C';b[2]='K';b[3]='2';
  for(unsigned i=0;i<32;++i)b[4+i]=uint8_t(p.token[i]);
  write32(b+36,p.sequence);b[40]=code;write32(b+41,boot);b[45]=flags;write16(b+46,left);write16(b+48,right);
}
}

firmware/ScoutDrive/FaceControl.h

Download this source file

#pragma once
#include "DriveCore.h"

namespace scout {
inline bool parseFaceId(const char* text, int& id) {
  if (!text) return false;
  if (text[0] == '-' && text[1] == '1' && text[2] == 0) { id = -1; return true; }
  if (text[0] >= '0' && text[0] <= '9' && text[1] == 0) { id = text[0] - '0'; return true; }
  return false;
}
// All access is protected by the firmware's safetyMux. No display/IO calls here.
struct FaceControl {
  bool available = false;
  int selection = -1;
  uint32_t generation = 0;
  Result select(const DriveCore& drive, const char* supplied, int id, uint64_t now) {
    if (id < -1 || id > 9) return Result::Invalid;
    if (!drive.ready || !drive.connected || now >= drive.deadline || !supplied)
      return Result::Conflict;
    unsigned i = 0;
    while (i < 32 && supplied[i] && supplied[i] == drive.token[i]) ++i;
    if (i != 32 || supplied[32] != 0) return Result::Conflict;
    if (!available) return Result::Unavailable;
    selection = id;
    ++generation;
    return Result::Ok;
  }
};
}

firmware/ScoutDrive/ScoutDrive.ino

Download this source file

// Scout protocol 2 / Carrier C v10 / ESP32-C3 / Arduino ESP32 core 3.x.
#include <Arduino.h>
#include <WiFi.h>
#include <WebServer.h>
#include <WiFiUdp.h>
#include <Preferences.h>
#include <esp_timer.h>
#include <esp_random.h>
#include <driver/gpio.h>
#include "DriveCore.h"
#include "FaceControl.h"
#include "DriveDatagram.h"
#include <Wire.h>
#include <Adafruit_SSD1306.h>
#include <ScoutFaces.h>
#include <WebSocketsServer.h>
#include "BrowserControl.h"
#include "WebControlPage.h"

constexpr uint8_t ENABLE_PIN = 6;
constexpr uint8_t MOTOR_PINS[4] = {0, 1, 3, 10};
WebServer server(80);
WebSocketsServer browserSocket(81);
WiFiUDP driveUdp;
Preferences settings;
esp_timer_handle_t watchdog = nullptr;
portMUX_TYPE safetyMux = portMUX_INITIALIZER_UNLOCKED;
scout::DriveCore control;
scout::FaceControl faceControl;
scout::BrowserControl browserControl;
bool attached[4] = {}, reversed[2] = {}, enabled = false;
uint32_t bootId;
const char* eventMessage = "Stopped / ready";

uint64_t nowMs() { return static_cast<uint64_t>(esp_timer_get_time()) / 1000; }

// Runs in the ESP timer task independently of WebServer and its blocking client.
// Never performs PWM, network, serial, allocation or flash work here.
void safetyTick(void*) {
  portENTER_CRITICAL(&safetyMux);
  if (control.expire(nowMs())) {
    gpio_set_level(static_cast<gpio_num_t>(ENABLE_PIN), 0);
    enabled = false;
    eventMessage = "Contact expired / stopped";
  }
  portEXIT_CRITICAL(&safetyMux);
}

void stopAll(const char* message) {
  portENTER_CRITICAL(&safetyMux);
  gpio_set_level(static_cast<gpio_num_t>(ENABLE_PIN), 0);
  enabled = false;
  control.stop(nowMs());
  eventMessage = message;
  portEXIT_CRITICAL(&safetyMux);
  for (unsigned i = 0; i < 4; ++i) if (attached[i]) ledcWrite(MOTOR_PINS[i], 0);
}

void updateOutputs() {
  int pwm[2]; bool directions[2]; uint32_t generation;
  portENTER_CRITICAL(&safetyMux);
  if (control.expire(nowMs())) {
    gpio_set_level(static_cast<gpio_num_t>(ENABLE_PIN), 0);
    enabled = false; eventMessage = "Contact expired / stopped";
  }
  control.advance(nowMs());
  pwm[0] = control.motors[0].pwm; pwm[1] = control.motors[1].pwm;
  directions[0] = reversed[0]; directions[1] = reversed[1];
  generation = control.generation;
  portEXIT_CRITICAL(&safetyMux);

  // LEDC takes internal locks: keep those calls outside the short safety lock.
  bool ok = true;
  for (unsigned i = 0; i < 2; ++i) {
    const bool reverse = (pwm[i] < 0) != directions[i];
    const uint8_t duty = static_cast<uint8_t>(pwm[i] < 0 ? -pwm[i] : pwm[i]);
    // Clear the opposite input before setting PWM; never assert both directions.
    if (attached[2*i + (reverse ? 0 : 1)]) ok = ledcWrite(MOTOR_PINS[2*i + (reverse ? 0 : 1)], 0) && ok;
    if (attached[2*i + (reverse ? 1 : 0)]) ok = ledcWrite(MOTOR_PINS[2*i + (reverse ? 1 : 0)], duty) && ok;
  }
  if (!ok) {
    portENTER_CRITICAL(&safetyMux); control.ready = false; portEXIT_CRITICAL(&safetyMux);
    stopAll("PWM fault / stopped"); return;
  }
  portENTER_CRITICAL(&safetyMux);
  // A trip during PWM writes changes generation and invalidates the token.
  // No stale PWM snapshot can re-enable the driver after stop or expiration.
  if (control.expire(nowMs())) eventMessage = "Contact expired / stopped";
  enabled = generation == control.generation && control.canEnable(nowMs());
  gpio_set_level(static_cast<gpio_num_t>(ENABLE_PIN), enabled ? 1 : 0);
  portEXIT_CRITICAL(&safetyMux);
}

String statusJson(const char* sessionToken = nullptr) {
  safetyTick(nullptr);
  bool isReady, connected, isEnabled, leftReverse, rightReverse;
  int left, right; const char* message;
  portENTER_CRITICAL(&safetyMux);
  isReady = control.ready; connected = control.connected; isEnabled = enabled;
  left = control.motors[0].requested; right = control.motors[1].requested;
  leftReverse = reversed[0]; rightReverse = reversed[1]; message = eventMessage;
  portEXIT_CRITICAL(&safetyMux);
  String json; json.reserve(400);
  json = "{\"protocol\":2,\"version\":\"SCOUT 2\",\"drivePort\":4210,\"boot\":" + String(bootId);
  json += ",\"ready\":"; json += isReady ? "true" : "false";
  json += ",\"connected\":"; json += connected ? "true" : "false";
  json += ",\"enabled\":"; json += isEnabled ? "true" : "false";
  json += ",\"left\":" + String(left) + ",\"right\":" + String(right);
  json += ",\"leftReversed\":"; json += leftReverse ? "true" : "false";
  json += ",\"rightReversed\":"; json += rightReverse ? "true" : "false";
  json += ",\"timeoutMs\":400,\"message\":\""; json += message; json += '"';
  json += ",\"browserTimeoutMs\":" + String(scout::BROWSER_COMMAND_TIMEOUT_MS);
  if (sessionToken) { json += ",\"token\":\""; json += sessionToken; json += '"'; }
  portENTER_CRITICAL(&safetyMux);
  const bool oledReady = faceControl.available;
  const int selectedFace = faceControl.selection;
  portEXIT_CRITICAL(&safetyMux);
  json += ",\"faceControl\":true,\"oledReady\":";
  json += oledReady ? "true" : "false";
  json += ",\"face\":" + String(selectedFace) + ",\"browserControl\":true";
  return json + '}';
}

void sendStatus(const char* token);
void handleFace() {
  int id;
  const String token = server.arg("token"), text = server.arg("id");
  if (server.args() != 2 || !server.hasArg("token") || !server.hasArg("id") ||
      token.length() != 32 || !scout::parseFaceId(text.c_str(), id)) {
    error(400, "Expected session token and face id -1..9"); return;
  }
  safetyTick(nullptr);
  portENTER_CRITICAL(&safetyMux);
  const scout::Result result = faceControl.select(control, token.c_str(), id, nowMs());
  portEXIT_CRITICAL(&safetyMux);
  if (result == scout::Result::Unavailable) { error(503, "OLED unavailable"); return; }
  if (result != scout::Result::Ok) { error(409, "Face selection needs the current drive session"); return; }
  sendStatus(nullptr);
}

// Optional low-priority task: neither the UDP loop nor lease timer waits on I2C.
// This task exclusively owns the driver, framebuffer, Wire and face animation.
void oledTask(void*) {
  Adafruit_SSD1306 oled(128, 64, &Wire, -1, 100000, 100000);
  ScoutFaces faces(oled);
  uint8_t address = 0;
  if (Wire.begin(5, 7, 100000)) {
    Wire.setTimeOut(20);
    for (uint8_t candidate : {0x3C, 0x3D}) {
      Wire.beginTransmission(candidate);
      if (Wire.endTransmission() == 0) { address = candidate; break; }
    }
  }
  bool ok = address && oled.begin(SSD1306_SWITCHCAPVCC, address, false, false) && faces.begin();
  portENTER_CRITICAL(&safetyMux); faceControl.available = ok; portEXIT_CRITICAL(&safetyMux);
  Serial.println(ok ? "OLED animated faces ready" : "OLED unavailable; driving remains available");
  uint32_t generation = 0xFFFFFFFF;
  while (ok) {
    int selected; uint32_t revision;
    portENTER_CRITICAL(&safetyMux);
    selected = faceControl.selection; revision = faceControl.generation;
    portEXIT_CRITICAL(&safetyMux);
    if (revision != generation) {
      if (selected < 0) faces.setAutoCycle(true);
      else faces.setExpression(static_cast<ScoutFaces::Expression>(selected));
      generation = revision;
      Serial.printf("OLED selection: %d\n", selected);
    }
    if (faces.update()) {
      Wire.beginTransmission(address);
      ok = Wire.endTransmission() == 0;
      if (ok) oled.display();
    }
    vTaskDelay(pdMS_TO_TICKS(5));
  }
  portENTER_CRITICAL(&safetyMux); faceControl.available = false; portEXIT_CRITICAL(&safetyMux);
  // Keep the task dormant after failure; reset Scout after repairing the wiring.
  for (;;) vTaskDelay(pdMS_TO_TICKS(2000));
}

void sendStatus(const char* token = nullptr) {
  server.sendHeader("Cache-Control", "no-store");
  server.send(200, "application/json", statusJson(token));
}
void error(int code, const char* message) {
  server.sendHeader("Cache-Control", "no-store");
  server.send(code, "application/json", String("{\"protocol\":2,\"message\":\"") + message + "\"}");
}
bool emptyForm() { if (server.args() == 0) return true; error(400, "Expected empty form"); return false; }

void makeSessionToken(char* token) {
  static const char hex[] = "0123456789abcdef";
  uint8_t random[16]; esp_fill_random(random, sizeof(random));
  for (unsigned i = 0; i < 16; ++i) { token[2*i] = hex[random[i] >> 4]; token[2*i+1] = hex[random[i] & 15]; }
  token[32] = 0;
}
void handleSession() {
  if (!emptyForm()) return;
  char token[33]; makeSessionToken(token);
  safetyTick(nullptr);
  portENTER_CRITICAL(&safetyMux);
  const scout::Result result = control.session(token, nowMs());
  if (result == scout::Result::Ok) { enabled = false; gpio_set_level(static_cast<gpio_num_t>(ENABLE_PIN), 0); eventMessage = "Connected / stopped"; }
  portEXIT_CRITICAL(&safetyMux);
  if (result == scout::Result::Unavailable) { error(503, "Motor setup unavailable"); return; }
  if (result != scout::Result::Ok) { error(409, "A live session already exists"); return; }
  sendStatus(token);
}

void handleDrive() {
  const String token = server.arg("token"), seqText = server.arg("seq");
  const String leftText = server.arg("left"), rightText = server.arg("right");
  uint32_t seq; int left, right;
  if (server.args() != 4 || !server.hasArg("token") || !server.hasArg("seq") ||
      !server.hasArg("left") || !server.hasArg("right") || token.length() != 32 ||
      !scout::parseSequence(seqText.c_str(), seq) ||
      !scout::parsePercent(leftText.c_str(), left) || !scout::parsePercent(rightText.c_str(), right)) {
    error(400, "Invalid drive fields"); return;
  }
  portENTER_CRITICAL(&safetyMux);
  const scout::Result result = control.drive(token.c_str(), seq, left, right, nowMs());
  if (result == scout::Result::Ok) eventMessage = (left || right) ? "Drive accepted" : "Centered / stopped";
  portEXIT_CRITICAL(&safetyMux);
  if (result == scout::Result::Unavailable) { error(503, "Motor setup unavailable"); return; }
  if (result != scout::Result::Ok) { error(409, "Session expired, wrong token or old sequence"); return; }
  sendStatus();
}

void handleConfig() {
  const String left = server.arg("leftReversed"), right = server.arg("rightReversed");
  if (server.args() != 2 || (left != "0" && left != "1") || (right != "0" && right != "1")) {
    error(400, "Expected leftReversed and rightReversed as 0 or 1"); return;
  }
  safetyTick(nullptr);
  portENTER_CRITICAL(&safetyMux);
  const bool live = control.connected; const bool ready = control.ready;
  // Prevent a browser/Android session from claiming control during flash writes.
  if (!live && ready) control.ready = false;
  portEXIT_CRITICAL(&safetyMux);
  if (live) { error(409, "End session before calibration"); return; }
  if (!ready) { error(503, "Motor setup unavailable"); return; }
  stopAll("Calibration / stopped");
  const bool l = left == "1", r = right == "1";
  const bool savedLeft = settings.putBool("leftReverse", l) == 1;
  const bool savedRight = settings.putBool("rightReverse", r) == 1;
  if (!savedLeft || !savedRight) {
    portENTER_CRITICAL(&safetyMux); control.ready = false; portEXIT_CRITICAL(&safetyMux);
    stopAll("Calibration save failed / stopped"); error(500, "Cannot save direction"); return;
  }
  portENTER_CRITICAL(&safetyMux); reversed[0] = l; reversed[1] = r; control.ready = true; portEXIT_CRITICAL(&safetyMux);
  portENTER_CRITICAL(&safetyMux); eventMessage = "Calibration saved / stopped"; portEXIT_CRITICAL(&safetyMux); sendStatus();
}

// The web server may wait for a slow client. It never owns the motor loop.
void webTask(void*) {
  for (;;) { server.handleClient(); vTaskDelay(1); }
}

void socketStatus(uint8_t client, uint32_t ack, const char* token) {
  String json = statusJson(token);
  if (ack) { json.remove(json.length()-1); json += ",\"ack\":" + String(ack) + '}'; }
  browserSocket.sendTXT(client, json);
}
void socketError(uint8_t client, const char* message) {
  String json = String("{\"error\":\"") + message + "\"}";
  browserSocket.sendTXT(client, json);
}
void releaseBrowser(uint8_t client) {
  portENTER_CRITICAL(&safetyMux);
  if (browserControl.release(control, client, nowMs())) {
    gpio_set_level(static_cast<gpio_num_t>(ENABLE_PIN), 0);
    enabled = false; eventMessage = "Browser stopped / session ended";
  }
  portEXIT_CRITICAL(&safetyMux);
}
void socketEvent(uint8_t client, WStype_t type, uint8_t* payload, size_t length) {
  safetyTick(nullptr);
  if (type == WStype_DISCONNECTED) { releaseBrowser(client); return; }
  if (type == WStype_CONNECTED) { socketStatus(client, 0, nullptr); return; }
  if (type == WStype_BIN) {
    scout::DrivePacket packet;
    if (!scout::decodeDrive(payload, length, packet) || packet.stop) {
      releaseBrowser(client); socketError(client, "Invalid browser drive frame"); return;
    }
    portENTER_CRITICAL(&safetyMux);
    const scout::Result result = browserControl.drive(control, client, packet, nowMs());
    if (result == scout::Result::Ok) eventMessage = (packet.left || packet.right) ? "Browser drive accepted" : "Browser centered / stopped";
    portEXIT_CRITICAL(&safetyMux);
    if (result != scout::Result::Ok) { socketError(client, "Session expired or command rejected · reconnect"); return; }
    socketStatus(client, packet.sequence, nullptr); return;
  }
  if (type != WStype_TEXT) {
    // Fragmented application messages are not part of this bounded protocol.
    if (type == WStype_FRAGMENT_TEXT_START || type == WStype_FRAGMENT_BIN_START ||
        type == WStype_FRAGMENT || type == WStype_FRAGMENT_FIN || type == WStype_ERROR)
      releaseBrowser(client);
    return;
  }
  scout::WebCommand command;
  if (!scout::parseWebText(payload, length, command)) {
    releaseBrowser(client); socketError(client, "Invalid browser command"); return;
  }
  if (command.action == scout::WebAction::Connect) {
    char token[33]; makeSessionToken(token);
    portENTER_CRITICAL(&safetyMux);
    const scout::Result result = browserControl.claim(control, client, token, nowMs());
    if (result == scout::Result::Ok) {
      gpio_set_level(static_cast<gpio_num_t>(ENABLE_PIN), 0);
      enabled = false; eventMessage = "Browser connected / stopped";
    }
    portEXIT_CRITICAL(&safetyMux);
    if (result != scout::Result::Ok) { socketError(client, "Scout unavailable or another controller is connected"); return; }
    socketStatus(client, 0, token); return;
  }
  if (command.action == scout::WebAction::Stop) {
    releaseBrowser(client); socketStatus(client, 0, nullptr); return;
  }
  portENTER_CRITICAL(&safetyMux);
  const scout::Result result = browserControl.owns(control, client, nowMs()) ?
      faceControl.select(control, browserControl.token, command.face, nowMs()) : scout::Result::Conflict;
  portEXIT_CRITICAL(&safetyMux);
  if (result != scout::Result::Ok) { socketError(client, "Face unavailable or session ended"); return; }
  socketStatus(client, 0, nullptr);
}
void browserTask(void*) {
  // Library IO can wait for a client. Only this task owns browserSocket;
  // the motor loop, OLED task and independent lease timer do not wait on it.
  for (;;) { browserSocket.loop(); vTaskDelay(1); }
}
void receiveDrive() {
  for (unsigned batch=0; batch<4; ++batch) {
    int size=driveUdp.parsePacket(); if (!size) return;
    uint8_t bytes[scout::DRIVE_PACKET_SIZE];
    if (size!=int(sizeof(bytes))) { while(driveUdp.available()) driveUdp.read(); continue; }
    IPAddress sender=driveUdp.remoteIP(); uint16_t port=driveUdp.remotePort();
    if (driveUdp.read(bytes,sizeof(bytes))!=int(sizeof(bytes))) continue;
    scout::DrivePacket packet;
    if (!scout::decodeDrive(bytes,sizeof(bytes),packet)) continue;
    scout::Result result=scout::Result::Ok;
    if (packet.stop) stopAll("STOP / session ended");
    else {
      portENTER_CRITICAL(&safetyMux);
      result=control.drive(packet.token,packet.sequence,packet.left,packet.right,nowMs());
      if(result==scout::Result::Ok)eventMessage=(packet.left||packet.right)?"Drive accepted":"Centered / stopped";
      portEXIT_CRITICAL(&safetyMux);
    }
    updateOutputs();
    uint8_t flags; int left,right;
    portENTER_CRITICAL(&safetyMux);
    flags=(control.ready?1:0)|(control.connected?2:0)|(enabled?4:0);
    left=control.motors[0].requested;right=control.motors[1].requested;
    portEXIT_CRITICAL(&safetyMux);
    uint8_t ack[scout::ACK_PACKET_SIZE];
    uint8_t code=result==scout::Result::Ok?0:result==scout::Result::Conflict?1:result==scout::Result::Invalid?2:3;
    scout::encodeAck(ack,packet,code,bootId,flags,left,right);
    if(driveUdp.beginPacket(sender,port)){driveUdp.write(ack,sizeof(ack));driveUdp.endPacket();}
  }
}

void setup() {
  digitalWrite(ENABLE_PIN, LOW); pinMode(ENABLE_PIN, OUTPUT);
  bootId = esp_random();
  bool setupOk = true;
  for (unsigned i = 0; i < 4; ++i) {
    digitalWrite(MOTOR_PINS[i], LOW); pinMode(MOTOR_PINS[i], OUTPUT);
    attached[i] = ledcAttach(MOTOR_PINS[i], 10000, 8); setupOk = attached[i] && setupOk;
  }
  stopAll("Startup / stopped");
  const bool storageReady = settings.begin("scout-motors", false);
  setupOk = storageReady && setupOk;
  if (storageReady) { reversed[0] = settings.getBool("leftReverse", false); reversed[1] = settings.getBool("rightReverse", false); }
  esp_timer_create_args_t args = {}; args.callback = safetyTick; args.name = "scout_lease";
  setupOk = (esp_timer_create(&args, &watchdog) == ESP_OK) && setupOk;
  if (watchdog) setupOk = (esp_timer_start_periodic(watchdog, 10000) == ESP_OK) && setupOk;
  Serial.begin(115200);
  WiFi.mode(WIFI_AP);
  const bool wifiReady = WiFi.softAP("C3-Scout-Test", "ScoutTest42", 1, false, 2);
  const bool udpReady = wifiReady && driveUdp.begin(4210)==1;
  setupOk = udpReady && setupOk;
  portENTER_CRITICAL(&safetyMux); control.ready = setupOk; portEXIT_CRITICAL(&safetyMux);
  stopAll(setupOk ? "Stopped / ready" : "Setup failed / stopped");
  server.on("/", HTTP_GET, [] {
    server.sendHeader("Cache-Control", "no-store");
    server.sendHeader("Content-Encoding", "gzip");
    server.sendHeader("X-Content-Type-Options", "nosniff");
    server.send_P(200, "text/html; charset=utf-8", reinterpret_cast<const char*>(WEB_CONTROL_PAGE), sizeof(WEB_CONTROL_PAGE));
  });
  server.on("/status", HTTP_GET, [] { sendStatus(); });
  server.on("/session", HTTP_POST, handleSession);
  server.on("/drive", HTTP_POST, handleDrive);
  // Stop always cuts outputs, including when a caller supplies extra fields.
  server.on("/stop", HTTP_POST, [] { stopAll("STOP / session ended"); sendStatus(); });
  server.on("/config", HTTP_POST, handleConfig);
  server.on("/face", HTTP_POST, handleFace);
  server.onNotFound([] { error(404, "Use Scout Android controller / protocol 2"); });
  if (wifiReady) {
    static const char* originHeaders[] = {"Origin"};
    browserSocket.onValidateHttpHeader([](String name, String value) {
      return !name.equalsIgnoreCase("Origin") || value == "http://192.168.4.1";
    }, originHeaders, 1);
    browserSocket.onEvent(socketEvent);
    browserSocket.begin();
    if (xTaskCreate(browserTask, "scout_socket", 8192, nullptr, 1, nullptr) != pdPASS) {
      browserSocket.close(); Serial.println("Browser controls unavailable; Android control remains available");
    }
    server.begin();
    if(xTaskCreate(webTask,"scout_web",8192,nullptr,1,nullptr)!=pdPASS) {
      portENTER_CRITICAL(&safetyMux);control.ready=false;portEXIT_CRITICAL(&safetyMux);stopAll("Web task setup failed / stopped");
    }
  }
  Serial.println("SCOUT 2 | Wi-Fi C3-Scout-Test | 192.168.4.1 | UDP 4210 | x/SPACE stops; ? status");
  Serial.println("RUN OPEN with ESP USB connected. Unplug ESP USB before RUN ON.");
  Serial.println("Browser control: http://192.168.4.1 | WebSocket port 81");
  if (xTaskCreate(oledTask, "scout_oled", 6144, nullptr, 0, nullptr) != pdPASS)
    Serial.println("OLED task unavailable; driving remains available");
}

void loop() {
  safetyTick(nullptr);
  while (Serial.available()) {
    const char c = Serial.read();
    if (c == 'x' || c == 'X' || c == ' ') { stopAll("Serial STOP / session ended"); Serial.println("STOPPED"); }
    else if (c == '?') Serial.println(statusJson());
  }
  receiveDrive(); updateOutputs(); delay(1);
}

firmware/ScoutDrive/WebControlPage.h

Download this source file

// Generated by scripts/build-web-control.py
#pragma once
#include <Arduino.h>
const uint8_t WEB_CONTROL_PAGE[] PROGMEM = {
  0x1f,0x8b,0x08,0x00,0x00,0x00,0x00,0x00,0x02,0xff,0xa5,0x5c,0xdb,0x72,0xdb,0x48,0x7a,0xbe,0xf7,0x53,0xc0,0xb2,0x2d,0x10,
  0x36,0x09,0xf1,0x24,0x4b,0x22,0x05,0x4e,0x34,0xb2,0xbc,0xf1,0x46,0xb6,0x1c,0x49,0xb3,0xb3,0x5b,0x2e,0x67,0x0d,0x12,0x4d,
  0x11,0x12,0x49,0x30,0x00,0xa8,0xc3,0x50,0xac,0xda,0xfb,0xa4,0x2a,0x17,0xa9,0xda,0xbd,0xcd,0x55,0x1e,0x20,0x37,0xb9,0xcf,
  0xa3,0xcc,0x93,0xe4,0xfb,0xff,0xee,0x06,0x1a,0x20,0x65,0x69,0x12,0x57,0x59,0x22,0x1a,0xdd,0x7f,0xff,0xe7,0x53,0x37,0xb5,
  0xff,0x3c,0x88,0x06,0xe9,0xdd,0x4c,0x58,0xa3,0x74,0x32,0xee,0x3d,0xdb,0xa7,0x5f,0xd6,0xd8,0x9f,0x5e,0x78,0x1b,0x62,0xba,
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
  0x12,0xc2,0x8b,0x46,0xbb,0xb5,0xdd,0x6c,0x2e,0xc9,0x41,0x64,0xfc,0xbb,0x88,0xc3,0x40,0xf2,0x8f,0x89,0x08,0xe2,0xf0,0x1a,
  0xa4,0x2e,0x56,0xf5,0xbd,0xc0,0x70,0xfa,0x51,0x0b,0xc2,0x58,0xd2,0xdb,0x01,0xfc,0xf9,0x64,0xfa,0x14,0xe7,0x21,0x87,0xb1,
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
};

## Complete Android source

These are the complete production Java files, Android manifest, resources and Gradle configuration for app 1.1. No application source is omitted from the listings.

android/app/build.gradle

Download this source file

plugins { id 'com.android.application' }

android {
    namespace 'com.scout.control'
    compileSdk 35
    defaultConfig {
        applicationId 'com.scout.control'
        minSdk 26
        targetSdk 35
        versionCode 4
        versionName '1.2.0'
    }
    compileOptions {
        sourceCompatibility JavaVersion.VERSION_17
        targetCompatibility JavaVersion.VERSION_17
    }
    buildTypes {
        release { minifyEnabled false }
    }
}

android/app/src/main/AndroidManifest.xml

Download this source file

<manifest xmlns:android="http://schemas.android.com/apk/res/android">
    <uses-permission android:name="android.permission.INTERNET" />
    <uses-permission android:name="android.permission.ACCESS_NETWORK_STATE" />
    <uses-permission android:name="android.permission.ACCESS_WIFI_STATE" />
    <uses-permission android:name="android.permission.CHANGE_WIFI_STATE" />
    <uses-permission android:name="android.permission.CHANGE_NETWORK_STATE" />
    <uses-permission android:name="android.permission.ACCESS_COARSE_LOCATION" android:maxSdkVersion="32" />
    <uses-permission android:name="android.permission.ACCESS_FINE_LOCATION" android:maxSdkVersion="32" />
    <uses-permission android:name="android.permission.NEARBY_WIFI_DEVICES" android:usesPermissionFlags="neverForLocation" />
    <application android:label="Scout" android:theme="@style/AppTheme" android:icon="@drawable/ic_scout" android:allowBackup="false" android:usesCleartextTraffic="true" android:supportsRtl="true">
        <activity android:name=".MainActivity" android:exported="true" android:configChanges="orientation|screenSize|keyboardHidden">
            <intent-filter>
                <action android:name="android.intent.action.MAIN" />
                <category android:name="android.intent.category.LAUNCHER" />
            </intent-filter>
        </activity>
    </application>
</manifest>

android/app/src/main/java/com/scout/control/DriveDatagram.java

Download this source file

package com.scout.control;
import java.nio.ByteBuffer;
import java.nio.charset.StandardCharsets;

final class DriveDatagram {
    static final int PORT = 4210;
    static final String ZERO_TOKEN = "00000000000000000000000000000000";
    static byte[] encode(boolean stop, String token, long sequence, int left, int right) {
        if (token == null || !token.matches("[0-9a-f]{32}") || sequence < 0 || sequence > 0xffffffffL || (!stop && sequence==0) || Math.abs(left)>100 || Math.abs(right)>100)
            throw new IllegalArgumentException("Invalid drive packet");
        return ByteBuffer.allocate(45).put(new byte[]{'S','C','T','2'}).put((byte)(stop?'S':'D')).put(token.getBytes(StandardCharsets.US_ASCII))
            .putInt((int)sequence).putShort((short)left).putShort((short)right).array();
    }
    static final class Ack {
        String token; long sequence, boot; int code, flags, left, right;
    }
    static Ack decode(byte[] bytes, int length) {
        if (length != 50 || bytes[0]!='A'||bytes[1]!='C'||bytes[2]!='K'||bytes[3]!='2') return null;
        ByteBuffer b=ByteBuffer.wrap(bytes,0,length);b.position(4);byte[] token=new byte[32];b.get(token);
        Ack a=new Ack();a.token=new String(token,StandardCharsets.US_ASCII);a.sequence=b.getInt()&0xffffffffL;a.code=b.get()&255;
        a.boot=b.getInt()&0xffffffffL;a.flags=b.get()&255;a.left=b.getShort();a.right=b.getShort();
        return a.code<=3&&a.flags<=7&&Math.abs(a.left)<=100&&Math.abs(a.right)<=100 ? a : null;
    }
}

android/app/src/main/java/com/scout/control/FaceSelection.java

Download this source file

package com.scout.control;

/** Latest-only face requests. Caller holds ScoutClient.state's monitor. */
final class FaceSelection {
    static final String[] NAMES = {"Happy", "Laughing", "Surprised", "Angry", "Sad",
        "Sleepy", "Skeptical", "Winking", "Cheeky", "Dizzy"};
    static final class Ticket {
        final long epoch, generation; final String token; final int id;
        Ticket(long epoch, long generation, String token, int id) {
            this.epoch = epoch; this.generation = generation; this.token = token; this.id = id;
        }
    }
    boolean supported, available, pending;
    int selected = -1;
    long generation;
    String message = "Connect to choose a face";
    void initialize(boolean supported, boolean available, int selection) {
        ++generation; pending = false;
        this.supported = supported; this.available = available;
        selected = selection >= -1 && selection < NAMES.length ? selection : -1;
        message = !supported ? "Firmware update needed for face controls" :
            !available ? "OLED unavailable · check wiring and restart Scout" : label(selected);
    }
    static String label(int id) { return id == -1 ? "Auto · all ten expressions" : NAMES[id]; }
    boolean queue(int id) {
        if (!supported || !available || id < -1 || id >= NAMES.length) return false;
        selected = id; pending = true; ++generation;
        message = "Selecting " + label(id) + "…";
        return true;
    }
    Ticket take(long epoch, String token) {
        if (!pending) return null;
        pending = false;
        return new Ticket(epoch, generation, token, selected);
    }
    boolean current(Ticket ticket, long epoch, boolean active) {
        return active && ticket.epoch == epoch && ticket.generation == generation;
    }
    void clear() {
        ++generation; pending = false; supported = available = false;
        message = "Connect to choose a face";
    }
}

android/app/src/main/java/com/scout/control/JoystickView.java

Download this source file

package com.scout.control;

import android.content.Context;
import android.graphics.Canvas;
import android.graphics.Paint;
import android.graphics.Path;
import android.graphics.RadialGradient;
import android.graphics.Shader;
import android.view.MotionEvent;
import android.view.View;

final class JoystickView extends View {
    interface Listener { void move(float forward, float turn, boolean touching); }
    private final Paint paint = new Paint(Paint.ANTI_ALIAS_FLAG);
    private final Listener listener;
    private int pointer = -1;
    private float x, y;
    private boolean driving;
    private final int mint = 0xffa3e9c0;
    JoystickView(Context context, Listener listener) {
        super(context); this.listener = listener;
        setContentDescription("Drive joystick. Drag up to go forward, down to reverse, left or right to turn. Release to stop.");
        setFocusable(true); setImportantForAccessibility(IMPORTANT_FOR_ACCESSIBILITY_YES);
    }
    void ready(boolean value) { driving = value; if (!value) reset(); invalidate(); }
    void reset() { pointer = -1; x = y = 0; invalidate(); }
    private float dp(float value) { return value * getResources().getDisplayMetrics().density; }
    @Override protected void onDraw(Canvas canvas) {
        super.onDraw(canvas);
        float cx = getWidth() / 2f, cy = getHeight() / 2f;
        float radius = Math.max(dp(20), Math.min(getWidth(), getHeight()) / 2f - dp(25));
        paint.setShader(new RadialGradient(cx, cy, radius, new int[] {0xff223c30, 0xff13251d}, null, Shader.TileMode.CLAMP));
        paint.setStyle(Paint.Style.FILL); canvas.drawCircle(cx, cy, radius, paint); paint.setShader(null);
        paint.setStyle(Paint.Style.STROKE); paint.setStrokeWidth(dp(1)); paint.setColor(0xff355044);
        canvas.drawCircle(cx, cy, radius, paint); paint.setColor(0xff294236);
        canvas.drawCircle(cx, cy, radius * .68f, paint); canvas.drawCircle(cx, cy, radius * .34f, paint);
        paint.setColor(0xff365347);
        canvas.drawLine(cx - radius + dp(12), cy, cx + radius - dp(12), cy, paint);
        canvas.drawLine(cx, cy - radius + dp(12), cx, cy + radius - dp(12), paint);
        paint.setStyle(Paint.Style.FILL); paint.setTextAlign(Paint.Align.CENTER);
        paint.setTextSize(dp(10));
        paint.setColor(driving ? 0xffb4d1c1 : 0xff708d7d);
        canvas.drawText("FORWARD", cx, cy - radius - dp(10), paint);
        canvas.drawText("REVERSE", cx, cy + radius + dp(18), paint);
        float travel = radius * .68f;
        float kx = cx + x * travel, ky = cy + y * travel;
        paint.setColor(0x55000000); canvas.drawCircle(kx, ky + dp(5), radius * .23f, paint);
        paint.setColor(driving ? mint : 0xff4f6d5c); canvas.drawCircle(kx, ky, radius * .23f, paint);
        paint.setStyle(Paint.Style.STROKE); paint.setStrokeWidth(dp(1)); paint.setColor(driving ? 0xffd7f7e5 : 0xff789583);
        canvas.drawCircle(kx, ky, radius * .23f - dp(4), paint);
        paint.setStyle(Paint.Style.FILL); paint.setColor(0xff183a28);
        Path arrow = new Path(); float a = radius * .075f;
        arrow.moveTo(kx, ky - a); arrow.lineTo(kx + a, ky + a); arrow.lineTo(kx, ky + a * .45f); arrow.lineTo(kx - a, ky + a); arrow.close();
        canvas.drawPath(arrow, paint);
    }
    @Override public boolean onTouchEvent(MotionEvent event) {
        if (!driving) return true;
        int action = event.getActionMasked();
        if (action == MotionEvent.ACTION_DOWN) {
            pointer = event.getPointerId(0); getParent().requestDisallowInterceptTouchEvent(true); sample(event, 0); return true;
        }
        if (action == MotionEvent.ACTION_MOVE && pointer != -1) {
            int index = event.findPointerIndex(pointer); if (index < 0) release(); else sample(event, index); return true;
        }
        if (action == MotionEvent.ACTION_UP || action == MotionEvent.ACTION_CANCEL ||
            (action == MotionEvent.ACTION_POINTER_UP && event.getPointerId(event.getActionIndex()) == pointer)) {
            release(); if (action == MotionEvent.ACTION_UP) performClick(); return true;
        }
        return true;
    }
    private void sample(MotionEvent event, int index) {
        float radius = Math.max(dp(20), Math.min(getWidth(), getHeight()) / 2f - dp(25)) * .68f;
        x = (event.getX(index) - getWidth() / 2f) / radius;
        y = (event.getY(index) - getHeight() / 2f) / radius;
        float length = (float) Math.hypot(x, y); if (length > 1) { x /= length; y /= length; }
        listener.move(-y, x, true); invalidate();
    }
    private void release() { reset(); getParent().requestDisallowInterceptTouchEvent(false); listener.move(0, 0, false); }
    @Override public boolean performClick() { super.performClick(); return true; }
}

android/app/src/main/java/com/scout/control/MainActivity.java

Download this source file

package com.scout.control;

import android.app.Activity;
import android.app.AlertDialog;
import android.Manifest;
import android.content.pm.PackageManager;
import android.location.LocationManager;
import android.os.Build;
import android.content.Intent;
import android.content.res.Configuration;
import android.graphics.Color;
import android.graphics.Typeface;
import android.graphics.drawable.GradientDrawable;
import android.os.Bundle;
import android.os.Handler;
import android.os.SystemClock;
import android.provider.Settings;
import android.view.Gravity;
import android.view.View;
import android.view.WindowInsets;
import android.view.WindowManager;
import android.widget.Button;
import android.widget.LinearLayout;
import android.widget.SeekBar;
import android.widget.ScrollView;
import android.widget.HorizontalScrollView;
import android.widget.Switch;
import android.widget.TextView;

public final class MainActivity extends Activity implements ScoutClient.Listener {
    private static final int BG = 0xff0c1713, CARD = 0xff17291f, TEXT = 0xffedf6ef;
    private static final int MUTED = 0xff91ab9c, MINT = 0xffa3e9c0, STOP = 0xffedb296;
    private ScoutClient client;
    private JoystickView joystick;
    private TextView statusTitle, statusDetail, leftPower, rightPower, speedValue;
    private Button connect, calibration;
    private final Button[] faceButtons = new Button[11];
    private TextView faceStatus;
    private LinearLayout root;
    private boolean resumed;
    private boolean permissionForCalibration;
    private final Handler main = new Handler();
    private final Runnable heartbeat = new Runnable() {
        @Override public void run() {
            if (resumed && hasWindowFocus()) client.state.heartbeat(SystemClock.elapsedRealtime());
            changed(); main.postDelayed(this, 50);
        }
    };
    @Override public void onCreate(Bundle savedInstanceState) {
        super.onCreate(savedInstanceState);
        getWindow().getDecorView().setSystemUiVisibility(View.SYSTEM_UI_FLAG_LAYOUT_STABLE | View.SYSTEM_UI_FLAG_LAYOUT_FULLSCREEN | View.SYSTEM_UI_FLAG_LAYOUT_HIDE_NAVIGATION);
        getWindow().addFlags(WindowManager.LayoutParams.FLAG_KEEP_SCREEN_ON);
        client = new ScoutClient(getApplicationContext(), this); build(); main.post(heartbeat);
    }
    private int dp(float v) { return Math.round(v * getResources().getDisplayMetrics().density); }
    private GradientDrawable shape(int color, int stroke, int radius) {
        GradientDrawable d = new GradientDrawable(); d.setColor(color); d.setCornerRadius(dp(radius));
        if (stroke != 0) d.setStroke(dp(1), stroke); return d;
    }
    private TextView text(String value, float size, int color, boolean bold) {
        TextView t = new TextView(this); t.setText(value); t.setTextSize(size); t.setTextColor(color);
        t.setIncludeFontPadding(false); if (bold) t.setTypeface(Typeface.create("sans-serif-medium", Typeface.NORMAL)); return t;
    }
    private LinearLayout column() { LinearLayout v = new LinearLayout(this); v.setOrientation(LinearLayout.VERTICAL); return v; }
    private LinearLayout row() { LinearLayout v = new LinearLayout(this); v.setOrientation(LinearLayout.HORIZONTAL); v.setGravity(Gravity.CENTER_VERTICAL); return v; }
    private LinearLayout.LayoutParams size(int w, int h) { return new LinearLayout.LayoutParams(w < 0 ? w : dp(w), h < 0 ? h : dp(h)); }
    private void gap(LinearLayout v, int h) { v.addView(new View(this), size(1,h)); }
    private Button button(String value, int color, int foreground) {
        Button b = new Button(this); b.setText(value); b.setAllCaps(false); b.setTextSize(14); b.setTypeface(Typeface.DEFAULT_BOLD);
        b.setTextColor(foreground); b.setBackground(shape(color, 0, 14)); b.setMinHeight(0); b.setMinimumHeight(0);
        b.setPadding(dp(12), 0, dp(12), 0); b.setStateListAnimator(null); return b;
    }
    private void build() {
        boolean wide = getResources().getConfiguration().orientation == Configuration.ORIENTATION_LANDSCAPE;
        root = column(); root.setBackgroundColor(BG); root.setPadding(dp(18), dp(12), dp(18), dp(12));
        root.setOnApplyWindowInsetsListener((view, insets) -> {
            int l, t, r, b;
            if (android.os.Build.VERSION.SDK_INT >= 30) {
                android.graphics.Insets safe = insets.getInsets(WindowInsets.Type.systemBars() | WindowInsets.Type.displayCutout());
                l=safe.left; t=safe.top; r=safe.right; b=safe.bottom;
            } else { l=insets.getSystemWindowInsetLeft(); t=insets.getSystemWindowInsetTop(); r=insets.getSystemWindowInsetRight(); b=insets.getSystemWindowInsetBottom(); }
            root.setPadding(dp(18)+l, dp(wide ? 8 : 12)+t, dp(18)+r, dp(10)+b); return insets;
        });
        setContentView(root); root.requestApplyInsets();
        LinearLayout header = row();
        LinearLayout branding = column();
        TextView brand = text("SCOUT", 25, TEXT, true); brand.setLetterSpacing(.16f); branding.addView(brand);
        TextView sub = text("A LITTLE EXPLORER. IN YOUR HANDS.", 9, MUTED, true); sub.setLetterSpacing(.10f);
        branding.addView(sub, size(-2, -2)); header.addView(branding, new LinearLayout.LayoutParams(0, -2, 1));
        TextView badge = text("LOCAL\nCONTROL", 9, MINT, true); badge.setGravity(Gravity.CENTER); badge.setLetterSpacing(.08f);
        badge.setBackground(shape(CARD, 0xff34523f, 10)); badge.setPadding(dp(12), dp(7), dp(12), dp(7));
        header.addView(badge); root.addView(header, size(-1, wide ? 48 : 58));
        LinearLayout content = wide ? row() : column();
        root.addView(content, new LinearLayout.LayoutParams(-1, 0, 1));
        LinearLayout controls = column();
        if (wide) {
            LinearLayout pad = column(); joystick = new JoystickView(this, client::input);
            pad.addView(joystick, new LinearLayout.LayoutParams(-1, 0, 1));
            TextView hint = text("DRAG TO EXPLORE  ·  RELEASE TO STOP", 9, MUTED, true); hint.setGravity(Gravity.CENTER);
            pad.addView(hint, size(-1, 20)); content.addView(pad, new LinearLayout.LayoutParams(0, -1, 1.1f));
            View spacer = new View(this); content.addView(spacer, size(18, 1));
            content.addView(controls, new LinearLayout.LayoutParams(0, -1, 1));
            ScrollView scroller = new ScrollView(this); scroller.setFillViewport(false); scroller.setVerticalScrollBarEnabled(false);
            LinearLayout upper = column(); scroller.addView(upper); controls.addView(scroller, new LinearLayout.LayoutParams(-1,0,1));
            connectionCard(upper, true); gap(upper, 8); speedControl(upper, true); gap(upper, 6); powerControl(upper, true);
            gap(upper, 8); faceControls(upper);
            gap(controls, 6); stopButton(controls, 48); footer(controls, true);
        } else {
            connectionCard(content, false);
            joystick = new JoystickView(this, client::input);
            content.addView(joystick, new LinearLayout.LayoutParams(-1, 0, 1));
            TextView hint = text("DRAG TO EXPLORE  ·  RELEASE TO STOP", 10, MUTED, true); hint.setGravity(Gravity.CENTER); hint.setLetterSpacing(.06f);
            content.addView(hint, size(-1, 24));
            speedControl(content, false); gap(content, 8); powerControl(content, false); gap(content, 8); faceControls(content); gap(content, 8); stopButton(content, 58); footer(content, false);
        }
        changed();
    }
    private void connectionCard(LinearLayout parent, boolean compact) {
        LinearLayout card = column(); card.setBackground(shape(CARD, 0xff2b4335, 16)); card.setPadding(dp(13), dp(10), dp(13), dp(10));
        LinearLayout top = row();
        statusTitle = text("○  Disconnected", compact ? 13 : 15, TEXT, true);
        top.addView(statusTitle, new LinearLayout.LayoutParams(0, -2, 1));
        connect = button("Connect", MINT, 0xff143522); connect.setOnClickListener(v -> beginConnection(false)); top.addView(connect, size(88, compact ? 34 : 38));
        card.addView(top, size(-1,-2));
        statusDetail = text("Join C3-Scout-Test to get started", 11, MUTED, false); statusDetail.setMaxLines(3);
        LinearLayout.LayoutParams detail = size(-1,-2); detail.topMargin=dp(5); card.addView(statusDetail, detail);
        parent.addView(card, size(-1,-2));
    }
    private void speedControl(LinearLayout parent, boolean compact) {
        LinearLayout title = row(); TextView label = text("DRIVE LIMIT", 10, MUTED, true); label.setLetterSpacing(.12f);
        title.addView(label, new LinearLayout.LayoutParams(0,-2,1));
        speedValue = text("35%", compact ? 18 : 22, MINT, true); title.addView(speedValue); parent.addView(title, size(-1, compact ? 24 : 28));
        SeekBar seek = new SeekBar(this); seek.setMax(100); seek.setProgress(client.state.cap);
        seek.setContentDescription("Speed limit, percent"); seek.setProgressTintList(android.content.res.ColorStateList.valueOf(MINT));
        seek.setThumbTintList(android.content.res.ColorStateList.valueOf(MINT)); seek.setPadding(dp(8),0,dp(8),0);
        seek.setOnSeekBarChangeListener(new SeekBar.OnSeekBarChangeListener() {
            public void onProgressChanged(SeekBar bar, int value, boolean user) { if (user) client.speed(value); }
            public void onStartTrackingTouch(SeekBar bar) { }
            public void onStopTrackingTouch(SeekBar bar) { }
        }); parent.addView(seek, size(-1, compact ? 30 : 38));
        parent.addView(text("0–30% off  ·  motor power 40–100%", 10, MUTED, false), size(-1,18));
    }
    private void powerControl(LinearLayout parent, boolean compact) {
        LinearLayout powers = row(); powers.setBackground(shape(CARD, 0, 13)); powers.setPadding(dp(14),dp(7),dp(14),dp(7));
        leftPower = text("L  0%", compact ? 17 : 20, TEXT, true); rightPower = text("R  0%", compact ? 17 : 20, TEXT, true); rightPower.setGravity(Gravity.RIGHT);
        leftPower.setContentDescription("Left commanded motor power zero percent");
        powers.addView(leftPower, new LinearLayout.LayoutParams(0,-2,1)); powers.addView(text("MOTOR TARGET", 8, MUTED, true));
        powers.addView(rightPower, new LinearLayout.LayoutParams(0,-2,1)); parent.addView(powers, size(-1, compact ? 42 : 50));
    }
    private void stopButton(LinearLayout parent, int height) {
        Button stop = button("■   STOP", STOP, 0xff40271c); stop.setTextSize(19); stop.setLetterSpacing(.10f);
        stop.setContentDescription("Stop both motors and disconnect"); stop.setOnClickListener(v -> { joystick.reset(); client.stop("Stopped · reconnect to drive"); });
        parent.addView(stop, size(-1,height));
    }
    private void faceControls(LinearLayout parent) {
        LinearLayout heading = row();
        TextView title = text("SCOUT FACE", 10, MUTED, true);
        heading.addView(title, size(84, 22));
        faceStatus = text("Connect to choose a face", 10, MUTED, false);
        faceStatus.setSingleLine(true);
        faceStatus.setEllipsize(android.text.TextUtils.TruncateAt.END);
        heading.addView(faceStatus, new LinearLayout.LayoutParams(0, dp(22), 1));
        parent.addView(heading, size(-1, 22));
        HorizontalScrollView scroller = new HorizontalScrollView(this);
        scroller.setHorizontalScrollBarEnabled(true);
        scroller.setContentDescription("Choose Scout face; swipe for more expressions");
        LinearLayout choices = row();
        for (int index = 0; index < faceButtons.length; ++index) {
            final int id = index - 1;
            Button choice = button(id == -1 ? "Auto" : FaceSelection.NAMES[id], CARD, TEXT);
            choice.setTextSize(12);
            choice.setContentDescription(id == -1 ? "Automatically cycle all faces" : "Choose " + FaceSelection.NAMES[id] + " face");
            choice.setOnClickListener(v -> client.selectFace(id));
            LinearLayout.LayoutParams params = size(-2, 44);
            params.rightMargin = dp(6);
            choices.addView(choice, params); faceButtons[index] = choice;
        }
        scroller.addView(choices);
        parent.addView(scroller, size(-1, 48));
    }
    private void footer(LinearLayout parent, boolean compact) {
        LinearLayout footer = row();
        Button wifi = button("Wi-Fi settings ↗", BG, MUTED); wifi.setTextSize(11); wifi.setOnClickListener(v -> {
            joystick.reset(); client.stop("Wi-Fi settings · reconnect to drive"); startActivity(new Intent(Settings.ACTION_WIFI_SETTINGS));
        });
        calibration = button("Motor directions", BG, MUTED); calibration.setTextSize(11); calibration.setOnClickListener(v -> beginConnection(true));
        footer.addView(wifi, new LinearLayout.LayoutParams(0,-1,1)); footer.addView(calibration, new LinearLayout.LayoutParams(0,-1,1));
        parent.addView(footer, size(-1,compact ? 36 : 42));
    }
    @Override public void changed() {
        if (joystick == null || client == null) return;
        synchronized (client.state) {
            SessionState s = client.state; boolean active = s.active(); joystick.ready(active);
            statusTitle.setText(active ? "●  Connected" : s.mode == SessionState.WAITING_WIFI ? "◌  Joining Scout…" : s.mode == SessionState.CONNECTING ? "◌  Connecting…" : s.mode == SessionState.ERROR ? "○  Connection ended" : "○  Disconnected");
            statusTitle.setTextColor(active ? MINT : s.mode == SessionState.ERROR ? STOP : TEXT);
            statusDetail.setText(s.message); speedValue.setText(s.cap + "%");
            leftPower.setText("L  " + signed(s.left)); rightPower.setText("R  " + signed(s.right));
            leftPower.setContentDescription("Left commanded motor power " + s.left + " percent");
            rightPower.setContentDescription("Right commanded motor power " + s.right + " percent");
            connect.setEnabled(!active && s.mode != SessionState.CONNECTING && s.mode != SessionState.WAITING_WIFI && !client.busy()); connect.setAlpha(connect.isEnabled() ? 1f : .45f);
            calibration.setEnabled(!active && s.mode != SessionState.CONNECTING && s.mode != SessionState.WAITING_WIFI && !client.busy()); calibration.setAlpha(calibration.isEnabled() ? 1f : .35f);
            if (faceStatus != null) {
                FaceSelection f = client.faces;
                faceStatus.setText(active ? f.message : "Connect to choose a face");
                for (int i = 0; i < faceButtons.length; ++i) {
                    Button b = faceButtons[i]; if (b == null) continue;
                    boolean enabled = active && f.supported && f.available;
                    b.setEnabled(enabled); b.setAlpha(enabled ? 1f : .35f);
                    boolean selected = active && i - 1 == f.selected;
                    if (b.isSelected() != selected) {
                        b.setSelected(selected);
                        b.setBackground(shape(selected ? MINT : CARD, 0, 14));
                        b.setTextColor(selected ? 0xff143522 : TEXT);
                    }
                }
            }
        }
    }
    private String signed(int power) { return (power > 0 ? "+" : "") + power + "%"; }
    private void beginConnection(boolean calibrate) {
        permissionForCalibration = calibrate;
        if (Build.VERSION.SDK_INT >= 29) {
            String permission = Build.VERSION.SDK_INT >= 33 ? Manifest.permission.NEARBY_WIFI_DEVICES : Manifest.permission.ACCESS_FINE_LOCATION;
            if (checkSelfPermission(permission) != PackageManager.PERMISSION_GRANTED) {
                String[] requested = Build.VERSION.SDK_INT >= 33 ? new String[] {permission} : new String[] {Manifest.permission.ACCESS_COARSE_LOCATION, permission};
                requestPermissions(requested, 41); return;
            }
            if (Build.VERSION.SDK_INT < 33 && !((LocationManager) getSystemService(LOCATION_SERVICE)).isLocationEnabled()) {
                new AlertDialog.Builder(this).setTitle("Enable Wi-Fi device connections")
                    .setMessage("This Android version requires Location to be on to connect directly to Scout. Scout does not read your GPS location.")
                    .setPositiveButton("Open settings", (d,w) -> startActivity(new Intent(Settings.ACTION_LOCATION_SOURCE_SETTINGS)))
                    .setNegativeButton("Cancel", null).show(); return;
            }
        }
        if (calibrate) client.inspectCalibration(); else client.connect();
    }
    @Override public void onRequestPermissionsResult(int requestCode, String[] permissions, int[] results) {
        super.onRequestPermissionsResult(requestCode, permissions, results);
        if (requestCode == 41) {
            String permission = Build.VERSION.SDK_INT >= 33 ? Manifest.permission.NEARBY_WIFI_DEVICES : Manifest.permission.ACCESS_FINE_LOCATION;
            if (checkSelfPermission(permission) == PackageManager.PERMISSION_GRANTED) beginConnection(permissionForCalibration);
            else client.stop("Wi-Fi permission is needed to connect to Scout");
        }
    }
    private boolean waitingForWifi() { synchronized (client.state) { return client.state.mode == SessionState.WAITING_WIFI; } }
    @Override public void calibration(boolean left, boolean right) {
        LinearLayout body = column(); body.setPadding(dp(22),dp(8),dp(22),dp(8));
        TextView info = text("Flip a motor's direction if forward turns that wheel backward. Scout stays stopped while directions are saved.", 14, MUTED, false);
        body.addView(info); gap(body,16);
        Switch l = new Switch(this); l.setText("Reverse left motor"); l.setTextColor(TEXT); l.setChecked(left); body.addView(l,size(-1,48));
        Switch r = new Switch(this); r.setText("Reverse right motor"); r.setTextColor(TEXT); r.setChecked(right); body.addView(r,size(-1,48));
        new AlertDialog.Builder(this).setTitle("Motor directions").setView(body).setNegativeButton("Cancel",null)
            .setPositiveButton("Save directions",(dialog, which) -> client.configure(l.isChecked(), r.isChecked())).show();
    }
    @Override protected void onResume() { super.onResume(); resumed = true; }
    @Override protected void onPause() {
        resumed = false; if (client != null && !waitingForWifi()) client.leave("App paused · reconnect to drive"); if (joystick != null) joystick.reset(); super.onPause();
    }
    @Override public void onWindowFocusChanged(boolean focus) {
        super.onWindowFocusChanged(focus);
        if (!focus && client != null) {
            synchronized (client.state) {
                if (client.state.mode == SessionState.ACTIVE || client.state.mode == SessionState.CONNECTING)
                    client.stop("Focus lost · reconnect to drive");
            }
            if (joystick != null) joystick.reset();
        }
    }
    @Override protected void onStop() { if (client != null) client.leave("App hidden · reconnect to drive"); super.onStop(); }
    @Override public void onConfigurationChanged(Configuration configuration) {
        super.onConfigurationChanged(configuration); client.stop("Layout changed · reconnect to drive"); build();
    }
    @Override protected void onDestroy() {
        main.removeCallbacksAndMessages(null); if (client != null) client.close(); super.onDestroy();
    }
}

android/app/src/main/java/com/scout/control/Mixer.java

Download this source file

package com.scout.control;

public final class Mixer {
    private Mixer() { }
    public static int[] mix(float forward, float turn, int cap) {
        if (!Float.isFinite(forward) || !Float.isFinite(turn)) return new int[] {0, 0};
        float radius = (float) Math.hypot(forward, turn);
        if (radius <= .08f) return new int[] {0, 0};
        float gain = (Math.min(1, radius) - .08f) / .92f / radius;
        // Scout's motor polarity is calibrated on the ESP; steering uses the
        // opposite differential so left/right match the assembled rover.
        // Reverse steering with travel direction; keep stationary turns unchanged.
        float steering = forward < 0 ? -turn : turn;
        float left = (forward - steering) * gain;
        float right = (forward + steering) * gain;
        float scale = Math.max(1, Math.max(Math.abs(left), Math.abs(right)));
        int limit = Math.max(0, Math.min(100, cap));
        return new int[] {motorPower(Math.round(left / scale * limit)), motorPower(Math.round(right / scale * limit))};
    }
    private static int motorPower(int command) {
        int magnitude = Math.abs(command);
        if (magnitude <= 30) return 0;
        int power = 40 + (Math.min(100, magnitude) - 30) * 60 / 70;
        return command < 0 ? -power : power;
    }
}

android/app/src/main/java/com/scout/control/RobotHttp.java

Download this source file

package com.scout.control;

import java.io.*;
import java.net.Socket;
import java.net.SocketTimeoutException;
import java.nio.charset.StandardCharsets;
import java.util.Locale;

/** Small, bounded HTTP exchange for the fixed local robot; no proxy or connection pool. */
final class RobotHttp {
    static final class Reply {
        final int code; final String body;
        Reply(int code, String body) { this.code = code; this.body = body; }
    }
    static Reply exchange(Socket socket, String path, String body) throws IOException {
        socket.setTcpNoDelay(true);
        String payload = body == null ? "" : body;
        byte[] bytes = payload.getBytes(StandardCharsets.US_ASCII);
        String request = (body == null ? "GET " : "POST ") + path + " HTTP/1.1\r\nHost: 192.168.4.1\r\nAccept: application/json\r\nConnection: close\r\n";
        if (body != null) request += "Content-Type: application/x-www-form-urlencoded\r\nContent-Length: " + bytes.length + "\r\n";
        // Header and body fit in one write, avoiding tiny separate TCP writes.
        socket.getOutputStream().write((request + "\r\n" + payload).getBytes(StandardCharsets.US_ASCII));
        long deadline = System.nanoTime() + 600_000_000L;
        BufferedInputStream input = new BufferedInputStream(socket.getInputStream());
        int[] remainingHeaders = {4096};
        String status = line(socket, input, deadline, remainingHeaders);
        String[] parts = status.split(" ", 3); int code;
        try { if (parts.length < 2 || !parts[0].startsWith("HTTP/1.")) throw new NumberFormatException(); code = Integer.parseInt(parts[1]); }
        catch (NumberFormatException e) { throw new IOException("Invalid Scout response", e); }
        int length = -1;
        while (true) {
            String header = line(socket, input, deadline, remainingHeaders);
            if (header.isEmpty()) break;
            int colon = header.indexOf(':'); if (colon < 1) throw new IOException("Invalid Scout header");
            String name = header.substring(0, colon).trim().toLowerCase(Locale.ROOT);
            String value = header.substring(colon + 1).trim();
            if (name.equals("content-length")) {
                if (length != -1) throw new IOException("Duplicate Scout response length");
                try { length = Integer.parseInt(value); } catch (NumberFormatException e) { throw new IOException("Invalid Scout response length", e); }
                if (length < 0 || length > 8192) throw new IOException("Scout response too large");
            }
            if (name.equals("transfer-encoding")) throw new IOException("Unsupported Scout response");
        }
        if (length < 0) throw new IOException("Missing Scout response length");
        byte[] response = new byte[length]; int count = 0;
        while (count < length) {
            timeout(socket, deadline); int n = input.read(response, count, length - count);
            if (n < 0) throw new EOFException("Truncated Scout response"); count += n;
        }
        return new Reply(code, new String(response, StandardCharsets.UTF_8));
    }
    private static String line(Socket socket, InputStream input, long deadline, int[] remaining) throws IOException {
        ByteArrayOutputStream out = new ByteArrayOutputStream(); int previous = -1;
        while (remaining[0]-- > 0) {
            timeout(socket, deadline); int c = input.read(); if (c < 0) throw new EOFException("Truncated Scout headers");
            if (previous == '\r' && c == '\n') {
                byte[] bytes = out.toByteArray(); return new String(bytes, 0, bytes.length - 1, StandardCharsets.US_ASCII);
            }
            out.write(c); previous = c;
        }
        throw new IOException("Scout headers too large");
    }
    private static void timeout(Socket socket, long deadline) throws IOException {
        long remaining = (deadline - System.nanoTime()) / 1_000_000;
        if (remaining <= 0) throw new SocketTimeoutException("Scout reply timed out");
        socket.setSoTimeout((int) Math.min(600, remaining));
    }
}

android/app/src/main/java/com/scout/control/ScoutClient.java

Download this source file

package com.scout.control;

import android.content.Context;
import android.net.ConnectivityManager;
import android.net.Network;
import android.net.NetworkCapabilities;
import android.net.NetworkRequest;
import android.net.LinkProperties;
import android.net.LinkAddress;
import android.net.wifi.WifiNetworkSpecifier;
import android.os.Build;
import android.os.Handler;
import android.os.Looper;
import android.os.SystemClock;
import org.json.JSONObject;
import java.net.Socket;
import java.net.InetSocketAddress;
import java.net.DatagramSocket;
import java.net.DatagramPacket;
import java.net.InetAddress;
import java.net.SocketTimeoutException;
import java.io.IOException;
import android.util.Log;

/** One serialized worker; the only drive sample retained is SessionState's latest pair. */
final class ScoutClient {
    interface Listener { void changed(); void calibration(boolean left, boolean right); }
    final SessionState state = new SessionState();
    final FaceSelection faces = new FaceSelection();
    private final ConnectivityManager connectivity;
    private final Handler main = new Handler(Looper.getMainLooper());
    private final Listener listener;
    private final Thread worker;
    private volatile Network wifi;
    private ConnectivityManager.NetworkCallback wifiRequest;
    private boolean closed, inspectPending, configPending, busy;
    private boolean configLeft, configRight;
    private long boot;
    private long nextDrive;
    private DatagramSocket udp; // Owned only by the serialized worker.
    private long lastAck, lastAckSequence;

    ScoutClient(Context context, Listener listener) {
        this.listener = listener;
        connectivity = (ConnectivityManager) context.getSystemService(Context.CONNECTIVITY_SERVICE);
        worker = new Thread(this::loop, "Scout local Wi-Fi"); worker.start();
        new Thread(this::faceLoop, "Scout face controls").start();
    }
    void connect() {
        prepareWifi(false);
    }
    private void prepareWifi(boolean calibration) {
        long epoch;
        synchronized (state) {
            if (closed || busy || state.mode == SessionState.ACTIVE || state.mode == SessionState.CONNECTING || state.mode == SessionState.WAITING_WIFI) return;
            busy = calibration;
            epoch = state.awaitWifi(SystemClock.elapsedRealtime());
        }
        changed();
        if (wifi != null && connectivity.getNetworkCapabilities(wifi) != null) {
            wifiAvailable(epoch, wifi, calibration); return;
        }
        releaseWifi(epoch);
        if (Build.VERSION.SDK_INT < 29) {
            try { wifiAvailable(epoch, findWifi(), calibration); }
            catch (Exception e) { wifiUnavailable(epoch, "Join C3-Scout-Test in Wi-Fi settings"); }
            return;
        }
        ConnectivityManager.NetworkCallback callback = new ConnectivityManager.NetworkCallback() {
            @Override public void onAvailable(Network network) {
                long availableEpoch; boolean begin;
                synchronized (state) {
                    if (wifiRequest != this) return;
                    availableEpoch = state.epoch; begin = state.mode == SessionState.WAITING_WIFI;
                    if (!begin) wifi = network; // Restore routing only; never resume an ended drive.
                }
                if (begin) wifiAvailable(availableEpoch, network, calibration);
            }
            @Override public void onUnavailable() {
                synchronized (state) { if (wifiRequest != this) return; }
                wifiUnavailable(epoch, "Scout Wi-Fi connection was cancelled or unavailable"); releaseWifi(this);
            }
            @Override public void onLost(Network network) {
                synchronized (state) {
                    if (wifiRequest != this || !network.equals(wifi)) return;
                    wifi = null;
                    if (state.mode == SessionState.CONNECTING) {
                        // Android 10 may replace a manual connection with an app-owned
                        // network during pairing. Retry only this still-neutral setup.
                        state.end("Scout Wi-Fi is changing"); state.awaitWifi(SystemClock.elapsedRealtime());
                    } else state.fail(state.epoch, "Scout Wi-Fi lost · reconnect when ready");
                    busy = calibration && state.mode == SessionState.WAITING_WIFI;
                }
                // Keep the app's network request alive while foreground. Recovery
                // restores only routing; an active drive that lost Wi-Fi stays ended.
                changed();
            }
        };
        synchronized (state) { if (state.epoch != epoch) return; wifiRequest = callback; }
        try {
            NetworkRequest request = new NetworkRequest.Builder().addTransportType(NetworkCapabilities.TRANSPORT_WIFI)
                .removeCapability(NetworkCapabilities.NET_CAPABILITY_INTERNET)
                .setNetworkSpecifier(new WifiNetworkSpecifier.Builder().setSsid("C3-Scout-Test").setWpa2Passphrase("ScoutTest42").build()).build();
            // Android's approval dialog may take as long as the user needs.
            // WAITING_WIFI is neutral; Stop or leaving the app cancels it.
            connectivity.requestNetwork(request, callback);
        } catch (Exception e) {
            wifiUnavailable(epoch, "Allow Wi-Fi access and enable Location to connect to Scout"); releaseWifi(callback);
        }
    }
    private void wifiAvailable(long epoch, Network network, boolean calibration) {
        synchronized (state) {
            if (!state.wifiReady(epoch, SystemClock.elapsedRealtime())) return;
            wifi = network;
            if (calibration) { state.connectPending = false; state.mode = SessionState.OFF; inspectPending = true; state.message = "Reading motor directions…"; state.notifyAll(); }
        }
        changed();
    }
    private void wifiUnavailable(long epoch, String message) {
        synchronized (state) { if (state.epoch != epoch) return; state.fail(epoch, message); busy = false; }
        changed();
    }
    private void releaseWifi(long expectedEpoch) {
        ConnectivityManager.NetworkCallback callback;
        synchronized (state) {
            if (state.epoch != expectedEpoch) return;
            callback = wifiRequest; wifiRequest = null; wifi = null;
        }
        unregisterWifi(callback);
    }
    private void releaseWifi(ConnectivityManager.NetworkCallback expectedCallback) {
        synchronized (state) {
            if (wifiRequest != expectedCallback) return;
            wifiRequest = null; wifi = null;
        }
        unregisterWifi(expectedCallback);
    }
    private void unregisterWifi(ConnectivityManager.NetworkCallback callback) {
        if (callback != null) { try { connectivity.unregisterNetworkCallback(callback); } catch (IllegalArgumentException ignored) { } }
    }
    void leave(String reason) {
        synchronized (state) { state.leave(reason); faces.clear(); inspectPending = configPending = false; busy = false; }
        changed();
    }
    void stop(String reason) {
        ConnectivityManager.NetworkCallback cancelled = null;
        synchronized (state) {
            boolean pending = state.mode == SessionState.WAITING_WIFI; state.end(reason);
            faces.clear();
            if (pending) { busy = false; cancelled = wifiRequest; wifiRequest = null; wifi = null; }
        }
        unregisterWifi(cancelled); changed();
    }
    void input(float forward, float turn, boolean touching) { state.input(forward, turn, touching, SystemClock.elapsedRealtime()); changed(); }
    void speed(int cap) { state.speed(cap); changed(); }
    boolean busy() { synchronized (state) { return busy; } }
    void inspectCalibration() {
        prepareWifi(true);
    }
    void configure(boolean left, boolean right) {
        synchronized (state) {
            if (closed || busy || state.mode == SessionState.ACTIVE || state.mode == SessionState.CONNECTING) return;
            configLeft = left; configRight = right; busy = true; configPending = true;
            state.message = "Saving motor directions…"; state.notifyAll();
        }
        changed();
    }
    void close() { synchronized (state) { closed = true; faces.clear(); state.leave("Controller closed"); state.notifyAll(); } }
    void selectFace(int id) {
        synchronized (state) {
            if (closed || !state.active() || !faces.queue(id)) return;
            state.notifyAll();
        }
        changed();
    }
    // Face HTTP can take hundreds of milliseconds. Never do it on the UDP
    // worker, and never let a face reply update drive acknowledgments or leases.
    private void faceLoop() {
        while (true) {
            FaceSelection.Ticket ticket; Network network;
            synchronized (state) {
                if (closed) return;
                if (!state.active()) faces.pending = false;
                ticket = state.active() ? faces.take(state.epoch, state.token) : null;
                network = wifi;
                if (ticket == null) {
                    try { state.wait(100); } catch (InterruptedException ignored) { }
                    continue;
                }
            }
            try {
                if (network == null) throw new IOException("Scout Wi-Fi unavailable");
                JSONObject reply;
                try (Socket socket = network.getSocketFactory().createSocket()) {
                    socket.connect(new InetSocketAddress("192.168.4.1", 80), 600);
                    RobotHttp.Reply result = RobotHttp.exchange(socket, "/face",
                        "token=" + ticket.token + "&id=" + ticket.id);
                    if (result.code != 200) throw new IOException(result.code == 503 ?
                        "OLED unavailable · check wiring and restart Scout" : "Face not confirmed · tap to retry");
                    reply = new JSONObject(result.body);
                    validate(reply);
                    if (reply.getLong("boot") != boot || !reply.optBoolean("faceControl") ||
                        !reply.optBoolean("oledReady") || reply.getInt("face") != ticket.id)
                        throw new IOException("Face not confirmed · tap to retry");
                }
                synchronized (state) {
                    if (faces.current(ticket, state.epoch, state.active()) && ticket.token.equals(state.token))
                        faces.message = FaceSelection.label(ticket.id);
                }
            } catch (Exception failure) {
                synchronized (state) {
                    if (faces.current(ticket, state.epoch, state.active()) && ticket.token.equals(state.token))
                        faces.message = failure.getMessage() == null ? "Face not confirmed · tap to retry" : failure.getMessage();
                }
            }
            changed();
        }
    }
    private void changed() { main.post(listener::changed); }
    private void loop() {
        while (true) {
            pollDriveAck();
            int action; long epoch; String token = null; long seq = 0; int left = 0, right = 0;
            synchronized (state) {
                long now = SystemClock.elapsedRealtime(); state.tick(now); epoch = state.epoch;
                if (state.stopPending) { state.stopPending = false; action = 1; }
                    else if (closed) { closeUdp(); return; }
                else if (state.connectPending) { state.connectPending = false; action = 2; }
                else if (inspectPending) { inspectPending = false; action = 3; }
                else if (configPending) { configPending = false; action = 4; }
                else if (state.active() && (state.urgent || now >= nextDrive)) {
                    if (state.sequence >= 0xffffffffL) { state.end("Session complete · reconnect to drive"); continue; }
                    action = 5; token = state.token; seq = ++state.sequence;
                    int[] pair = state.takeTargetPair(); left = pair[0]; right = pair[1]; state.urgent = false; nextDrive = now + 50;
                } else {
                    try { state.wait(25); } catch (InterruptedException ignored) { }
                    continue;
                }
            }
            changed();
            try {
                if (action == 1) {
                    if (udp != null && !udp.isClosed()) {
                        byte[] stop=DriveDatagram.encode(true,DriveDatagram.ZERO_TOKEN,0,0,0);
                        try {
                            for(int repeat=0;repeat<3;++repeat)udp.send(new DatagramPacket(stop,stop.length));
                        } catch (IOException error) {
                            Log.w("ScoutLink", "Packet STOP failed; trying HTTP STOP", error);
                        }
                    }
                    JSONObject result = request("/stop", ""); validate(result);
                } else if (action == 2) {
                    closeUdp();
                    if (wifi == null) wifi = findWifi();
                    JSONObject status = request("/status", null); validate(status);
                    if (!status.getBoolean("ready")) throw new Exception("Scout is not ready");
                    synchronized (state) { if (state.epoch != epoch || state.mode != SessionState.CONNECTING) continue; }
                    JSONObject session = request("/session", ""); validate(session);
                    if (!session.getBoolean("ready") || !session.getBoolean("connected") || session.getBoolean("enabled") || session.getInt("left") != 0 || session.getInt("right") != 0)
                        throw new Exception("Scout did not create a neutral session");
                    DatagramSocket socket = new DatagramSocket();
                    try { wifi.bindSocket(socket); socket.connect(InetAddress.getByName("192.168.4.1"),DriveDatagram.PORT); socket.setSoTimeout(1); }
                    catch(Exception e){socket.close();throw e;}
                    synchronized (state) {
                        state.tick(SystemClock.elapsedRealtime());
                        if (state.acceptSession(epoch, session.getString("token"))) {
                            boot = session.getLong("boot"); udp=socket;lastAck=SystemClock.elapsedRealtime();lastAckSequence=0;
                            faces.initialize(session.optBoolean("faceControl"), session.optBoolean("oledReady"), session.optInt("face", -1));
                        } else { socket.close(); if (state.epoch == epoch) throw new Exception("Invalid Scout session token"); }
                    }
                } else if (action == 3) {
                    if (wifi == null) wifi = findWifi(); JSONObject status = request("/status", null); validate(status);
                    if (status.getBoolean("connected")) throw new Exception("Scout has a live session · press STOP first");
                    boolean l = status.getBoolean("leftReversed"), r = status.getBoolean("rightReversed");
                    synchronized (state) {
                        if (state.epoch == epoch) {
                            state.message = "Motor directions ready";
                            main.post(() -> { synchronized (state) { if (state.epoch != epoch || state.active() || state.mode == SessionState.CONNECTING) return; } listener.calibration(l, r); });
                        }
                    }
                } else if (action == 4) {
                    if (wifi == null) wifi = findWifi();
                    JSONObject status = request("/config", "leftReversed=" + (configLeft ? 1 : 0) + "&rightReversed=" + (configRight ? 1 : 0)); validate(status);
                    if (status.getBoolean("connected") || status.getBoolean("enabled")) throw new Exception("Scout did not confirm stopped calibration");
                    synchronized (state) { if (state.epoch == epoch) state.message = "Motor directions saved"; }
                } else {
                    if(udp==null)throw new IOException("Drive channel unavailable");
                    byte[] command=DriveDatagram.encode(false,token,seq,left,right);
                    udp.send(new DatagramPacket(command,command.length));
                }
            } catch (Exception error) {
                String detail = error.getMessage();
                Log.w("ScoutLink", "Request " + action + " failed: " + error.getClass().getSimpleName() + ": " + detail);
                if (error instanceof IOException) detail = "Scout link interrupted · check the robot's power and Wi-Fi";
                if (detail == null || detail.isEmpty()) detail = "Wi-Fi request failed";
                synchronized (state) {
                    if (action != 1) state.fail(epoch, detail + " · reconnect when ready");
                    else if (state.epoch == epoch && state.mode == SessionState.OFF)
                        state.message = "Stop unconfirmed · check Scout's Wi-Fi connection";
                }
            } finally {
                if(action==1)closeUdp();
                ConnectivityManager.NetworkCallback released = null;
                synchronized (state) {
                    // Consume cleanup and detach its exact request atomically. A later
                    // Stop or Connect cannot consume cleanup or replace this callback.
                    if (action == 1 && state.takeWifiCleanup(epoch)) {
                        released = wifiRequest; wifiRequest = null; wifi = null;
                    }
                    if (action == 3 || action == 4) busy = false;
                }
                unregisterWifi(released);
                changed();
            }
        }
    }
    private void closeUdp(){if(udp!=null){udp.close();udp=null;}}
    private void pollDriveAck(){
        if(udp==null)return;
        synchronized(state){if(!state.active())return;}
        long epoch;String token;
        synchronized(state){epoch=state.epoch;token=state.token;}
        try {
            for(int i=0;i<8;++i){
                byte[] bytes=new byte[128];DatagramPacket packet=new DatagramPacket(bytes,bytes.length);udp.receive(packet);
                DriveDatagram.Ack ack=DriveDatagram.decode(bytes,packet.getLength());
                if(ack==null||!ack.token.equals(token))continue;
                synchronized(state){
                    if(!state.acceptDrive(epoch))return;
                    if(ack.boot!=boot||(ack.flags&3)!=3||ack.code==2||ack.code==3){state.fail(epoch,"Scout session ended · reconnect");break;}
                    if(ack.code==0&&ack.sequence>lastAckSequence&&ack.sequence<=state.sequence){lastAckSequence=ack.sequence;lastAck=SystemClock.elapsedRealtime();}
                }
            }
        }catch(SocketTimeoutException normal){ }
        catch(IOException failure){synchronized(state){state.fail(epoch,"Scout drive link lost · reconnect");}}
        synchronized(state){if(state.acceptDrive(epoch)&&SystemClock.elapsedRealtime()-lastAck>=400)state.fail(epoch,"Scout replies lost · reconnect when ready");}
    }
    private Network findWifi() throws Exception {
        for (Network network : connectivity.getAllNetworks()) {
            NetworkCapabilities c = connectivity.getNetworkCapabilities(network);
            if (c != null && c.hasTransport(NetworkCapabilities.TRANSPORT_WIFI) && !c.hasTransport(NetworkCapabilities.TRANSPORT_VPN)) {
                LinkProperties properties = connectivity.getLinkProperties(network);
                if (properties != null) for (LinkAddress address : properties.getLinkAddresses())
                    if (address.getAddress().getHostAddress().startsWith("192.168.4.")) return network;
            }
        }
        throw new Exception("Join C3-Scout-Test in Wi-Fi settings");
    }
    private JSONObject request(String path, String body) throws Exception {
        long started = SystemClock.elapsedRealtime();
        if (wifi == null) wifi = findWifi();
        try (Socket socket = wifi.getSocketFactory().createSocket()) {
            socket.connect(new InetSocketAddress("192.168.4.1", 80), 600);
            RobotHttp.Reply reply = RobotHttp.exchange(socket, path, body);
            if (reply.code != 200) throw new Exception(reply.code == 409 ? "Scout session conflict or expired lease" : "Scout request rejected (" + reply.code + ")");
            return new JSONObject(reply.body);
        } finally {
            long elapsed = SystemClock.elapsedRealtime() - started;
            if (elapsed > 150) Log.i("ScoutLink", path + " reply took " + elapsed + " ms");
        }
    }
    private static void validate(JSONObject j) throws Exception {
        if (j.optInt("protocol", -1) != 2 || !"SCOUT 2".equals(j.optString("version")) || j.optInt("timeoutMs", 0) != 400 || j.optInt("drivePort",0)!=DriveDatagram.PORT)
            throw new Exception("Firmware update needed · install SCOUT 2");
        long boot = j.getLong("boot");
        if (boot < 0 || boot > 0xffffffffL || Math.abs((long) j.getInt("left")) > 100 || Math.abs((long) j.getInt("right")) > 100)
            throw new Exception("Invalid Scout response");
        j.getBoolean("ready"); j.getBoolean("connected"); j.getBoolean("enabled");
        j.getBoolean("leftReversed"); j.getBoolean("rightReversed"); j.getString("message");
    }
}

android/app/src/main/java/com/scout/control/SessionState.java

Download this source file

package com.scout.control;

/** All fields are guarded by this object, including the serial worker's selections. */
final class SessionState {
    static final int OFF = 0, CONNECTING = 1, ACTIVE = 2, ERROR = 3, WAITING_WIFI = 4;
    int mode, left, right, cap = 35;
    long epoch, lastUi, sequence;
    String token, message = "Ready when you are";
    boolean touching, urgent, stopPending, connectPending, releasePending, releaseWifiPending, leaving;
    float forward, turn;
    synchronized long awaitWifi(long now) {
        clear(); epoch++; lastUi = now; mode = WAITING_WIFI; connectPending = false; releaseWifiPending = false; leaving = false;
        message = "Choose Scout in the Android Wi-Fi prompt"; notifyAll(); return epoch;
    }
    synchronized boolean wifiReady(long requestEpoch, long now) {
        if (epoch != requestEpoch || mode != WAITING_WIFI) return false;
        lastUi = now; mode = CONNECTING; connectPending = true;
        message = "Checking Scout firmware…"; notifyAll(); return true;
    }
    synchronized long connect(long now) {
        clear(); epoch++; lastUi = now; mode = CONNECTING; leaving = false;
        connectPending = true; message = "Checking Scout firmware…"; notifyAll(); return epoch;
    }
    synchronized boolean acceptSession(long requestEpoch, String newToken) {
        if (epoch != requestEpoch || mode != CONNECTING) return false;
        if (newToken == null || !newToken.matches("[0-9a-fA-F]{32}")) return false;
        token = newToken; sequence = 0; mode = ACTIVE; urgent = true;
        message = "Connected · touch to drive"; return true;
    }
    synchronized boolean acceptDrive(long requestEpoch) { return epoch == requestEpoch && mode == ACTIVE; }
    synchronized void input(float f, float t, boolean touch, long now) {
        tick(now);
        if (!active()) return;
        forward = touch ? f : 0; turn = touch ? t : 0; touching = touch; lastUi = now;
        mix(); if (!touch) { urgent = true; releasePending = true; } notifyAll();
    }
    synchronized void speed(int value) { cap = Math.max(0, Math.min(100, value)); mix(); }
    synchronized void heartbeat(long now) { tick(now); lastUi = now; }
    synchronized void tick(long now) {
        if ((mode == ACTIVE || mode == CONNECTING) && now - lastUi > 250) end("Input paused · reconnect to drive");
    }
    synchronized void end(String reason) {
        epoch++; clear(); connectPending = false; mode = OFF; message = reason;
        stopPending = true; notifyAll();
    }
    synchronized void leave(String reason) {
        if (leaving) return;
        leaving = true;
        end(reason); releaseWifiPending = true;
    }
    synchronized void fail(long requestEpoch, String reason) {
        if (epoch != requestEpoch) return;
        end(reason); mode = ERROR;
    }
    private void clear() { forward = turn = 0; left = right = 0; touching = false; token = null; urgent = true; releasePending = false; }
    private void mix() { int[] p = Mixer.mix(forward, turn, cap); left = p[0]; right = p[1]; }
    synchronized boolean active() { return mode == ACTIVE; }
    synchronized int[] takeTargetPair() {
        if (releasePending) { releasePending = false; return new int[] {0, 0}; }
        return new int[] {left, right};
    }
    synchronized boolean takeWifiCleanup(long requestEpoch) {
        if (epoch != requestEpoch || !releaseWifiPending) return false;
        releaseWifiPending = false; return true;
    }
}

android/app/src/main/res/drawable/ic_scout.xml

Download this source file

<vector xmlns:android="http://schemas.android.com/apk/res/android" android:width="108dp" android:height="108dp" android:viewportWidth="108" android:viewportHeight="108">
    <path android:fillColor="#0C1713" android:pathData="M0,0h108v108h-108z" />
    <path android:fillColor="#A3E9C0" android:pathData="M54,17L85,84L54,69L23,84Z" />
    <path android:fillColor="#0C1713" android:pathData="M54,39L54,59L44,64Z" />
</vector>

android/app/src/main/res/values/styles.xml

Download this source file

<resources>
    <style name="AppTheme" parent="android:style/Theme.Material.NoActionBar">
        <item name="android:fontFamily">sans</item>
        <item name="android:windowLightStatusBar">false</item>
        <item name="android:statusBarColor">#0C1713</item>
        <item name="android:navigationBarColor">#0C1713</item>
        <item name="android:colorAccent">#A3E9C0</item>
        <item name="android:windowActionModeOverlay">true</item>
        <item name="android:windowLightNavigationBar">false</item>
        <item name="android:windowBackground">#0C1713</item>
    </style>
</resources>

android/build.gradle

Download this source file

plugins {
    id 'com.android.application' version '8.7.0' apply false
}

android/gradle.properties

Download this source file

org.gradle.jvmargs=-Xmx2048m -Dfile.encoding=UTF-8
org.gradle.daemon=false
android.useAndroidX=false

android/settings.gradle

Download this source file

pluginManagement {
    repositories { google(); mavenCentral(); gradlePluginPortal() }
}
dependencyResolutionManagement {
    repositoriesMode.set(RepositoriesMode.FAIL_ON_PROJECT_REPOS)
    repositories { google(); mavenCentral() }
}
rootProject.name = 'ScoutControl'
include ':app'

## Tests and build scripts

Host regression suites and PowerShell helpers accompany both source trees. Tool paths in the original helpers can be overridden as described above.

android/test-host.ps1

Download this source file

$ErrorActionPreference = 'Stop'
$appRoot = $PSScriptRoot
$classes = Join-Path $appRoot 'build-host'
New-Item -ItemType Directory -Force $classes | Out-Null
& javac -d $classes (Join-Path $appRoot 'app/src/main/java/com/scout/control/Mixer.java') (Join-Path $appRoot 'app/src/main/java/com/scout/control/SessionState.java') (Join-Path $appRoot 'app/src/main/java/com/scout/control/RobotHttp.java') (Join-Path $appRoot 'app/src/main/java/com/scout/control/DriveDatagram.java') (Join-Path $appRoot 'tests/ControlTests.java') (Join-Path $appRoot 'tests/SessionTests.java') (Join-Path $appRoot 'tests/HttpTests.java') (Join-Path $appRoot 'tests/DatagramTests.java')
if ($LASTEXITCODE -ne 0) { throw 'Host test compilation failed' }
& java -cp $classes com.scout.control.ControlTests
if ($LASTEXITCODE -ne 0) { throw 'Mixer tests failed' }
& java -cp $classes com.scout.control.SessionTests
if ($LASTEXITCODE -ne 0) { throw 'Session tests failed' }
& java -cp $classes com.scout.control.HttpTests
if ($LASTEXITCODE -ne 0) { throw 'HTTP tests failed' }
& java -cp $classes com.scout.control.DatagramTests
if ($LASTEXITCODE -ne 0) { throw 'Packet tests failed' }
& javac -d $classes (Join-Path $appRoot 'app/src/main/java/com/scout/control/FaceSelection.java') (Join-Path $appRoot 'tests/FaceTests.java')
if ($LASTEXITCODE -ne 0) { throw 'Face selection test compilation failed' }
& java -cp $classes com.scout.control.FaceTests
if ($LASTEXITCODE -ne 0) { throw 'Face selection tests failed' }

android/tests/ControlTests.java

Download this source file

package com.scout.control;

public final class ControlTests {
    private static int checks;
    static void equal(int want, int got, String why) { checks++; if (want != got) throw new AssertionError(why + ": expected " + want + ", got " + got); }
    static void yes(boolean value, String why) { checks++; if (!value) throw new AssertionError(why); }
    public static void main(String[] args) {
        int[] out = Mixer.mix(1, 0, 35);
        equal(44, out[0], "35 percent drive maps to useful motor power"); equal(44, out[1], "Forward is symmetric");
        out = Mixer.mix(-1, 0, 35); equal(-44, out[0], "Reverse sign"); equal(-44, out[1], "Reverse symmetry");
        out = Mixer.mix(0, 1, 60); equal(-65, out[0], "Right stick reverses left target for Scout's corrected polarity"); equal(65, out[1], "Right stick advances right target");
        out = Mixer.mix(0, -1, 60); equal(65, out[0], "Left stick advances left target"); equal(-65, out[1], "Left stick reverses right target");
        out = Mixer.mix(1, 1, 35); equal(0, out[0], "Forward right arc inner target stays off"); equal(44, out[1], "Forward right arc uses useful power");
        out = Mixer.mix(1, -1, 35); equal(44, out[0], "Forward left arc uses useful power"); equal(0, out[1], "Forward left arc inner target stays off");
        out = Mixer.mix(-1, 1, 35); equal(0, out[0], "Reverse right arc inner target stays off"); equal(-44, out[1], "Reverse right arc follows steering in reverse");
        out = Mixer.mix(-1, -1, 35); equal(-44, out[0], "Reverse left arc follows steering in reverse"); equal(0, out[1], "Reverse left arc inner target stays off");
        out = Mixer.mix(.03f, .04f, 100); equal(0, out[0], "Radial dead zone"); equal(0, out[1], "Radial dead zone symmetry");
        out = Mixer.mix(.5f, 0, 100); equal(53, out[0], "Analog command uses the useful motor range");
        out = Mixer.mix(1, 0, 0); equal(0, out[0], "Zero cap");
        out = Mixer.mix(1, 0, 30); equal(0, out[0], "30 percent is off");
        out = Mixer.mix(-1, 0, 30); equal(0, out[0], "Negative 30 percent is off");
        out = Mixer.mix(1, 0, 31); equal(40, out[0], "First active percent starts at 40 percent motor power");
        out = Mixer.mix(1, 0, 65); equal(70, out[0], "Middle drive range maps proportionally");
        out = Mixer.mix(1, 0, 100); equal(100, out[0], "Full command stays full power");
        int previous = 0;
        for (int cap = 0; cap <= 100; cap++) {
            int forward = Mixer.mix(1, 0, cap)[0], reverse = Mixer.mix(-1, 0, cap)[0];
            yes(cap > 30 || forward == 0, "Entire low range remains off");
            yes(forward == 0 || (forward >= 40 && forward <= 100), "Never command stalled low motor power");
            yes(reverse == -forward, "Mapping preserves reverse symmetry");
            yes(forward >= previous, "Mapping is monotonic"); previous = forward;
        }
        System.out.println("PASS " + checks + " mixer checks");
    }
}

android/tests/DatagramTests.java

Download this source file

package com.scout.control;
import java.nio.ByteBuffer;
import java.nio.charset.StandardCharsets;
public final class DatagramTests {
    static void yes(boolean v,String why){if(!v)throw new AssertionError(why);}
    public static void main(String[] args){
        String token="0123456789abcdef0123456789abcdef";
        byte[] p=DriveDatagram.encode(false,token,0xffffffffL,-44,100);
        yes(p.length==45&&p[3]=='2'&&p[4]=='D',"Drive framing");
        ByteBuffer b=ByteBuffer.wrap(p);yes((b.getInt(37)&0xffffffffL)==0xffffffffL&&b.getShort(41)==-44&&b.getShort(43)==100,"Signed targets and unsigned sequence");
        p=DriveDatagram.encode(true,DriveDatagram.ZERO_TOKEN,0,0,0);yes(p[4]=='S',"Stop requires no live session");
        byte[] ack=ByteBuffer.allocate(50).put(new byte[]{'A','C','K','2'}).put(token.getBytes(StandardCharsets.US_ASCII)).putInt(7).put((byte)0).putInt(0xfedcba98).put((byte)3).putShort((short)-44).putShort((short)100).array();
        DriveDatagram.Ack a=DriveDatagram.decode(ack,50);
        yes(a!=null&&a.token.equals(token)&&a.sequence==7&&a.boot==0xfedcba98L&&a.left==-44&&a.right==100,"Ack identity and targets");
        yes(DriveDatagram.decode(ack,49)==null,"Truncated ack ignored");ack[3]='1';yes(DriveDatagram.decode(ack,50)==null,"Old protocol ignored");
        boolean rejected=false;try{DriveDatagram.encode(false,token,1,101,0);}catch(IllegalArgumentException e){rejected=true;}
        yes(rejected,"Invalid target rejected");
        System.out.println("PASS packet framing, session identity, sequence, signs and rejection checks");
    }
}

android/tests/FaceTests.java

Download this source file

package com.scout.control;

public final class FaceTests {
    static void check(boolean ok) { if (!ok) throw new AssertionError(); }
    public static void main(String[] args) {
        FaceSelection f = new FaceSelection();
        check(!f.queue(1));
        f.initialize(true, true, -1);
        check(f.queue(1)); check(f.queue(8));
        FaceSelection.Ticket t = f.take(7, "token");
        check(t.id == 8 && t.epoch == 7 && t.token.equals("token"));
        check(f.take(7, "token") == null);
        check(!f.current(t, 8, true)); check(!f.current(t, 7, false));
        check(f.queue(-1)); check(!f.current(t, 7, true));
        FaceSelection.Ticket auto = f.take(7, "token");
        check(auto.id == -1 && f.current(auto, 7, true));
        check(!f.queue(10)); check(f.current(auto, 7, true));
        f.clear(); check(!f.current(auto, 7, true)); check(!f.queue(2));
        f.initialize(false, false, -1); check(!f.queue(2));
        f.initialize(true, false, -1); check(!f.queue(2));
        System.out.println("Face selection: coalescing, stale results, lifecycle and bounds passed");
    }
}

android/tests/HttpTests.java

Download this source file

package com.scout.control;

import java.io.*;
import java.net.*;
import java.nio.charset.StandardCharsets;

public final class HttpTests {
    static void yes(boolean value, String why) { if (!value) throw new AssertionError(why); }
    static RobotHttp.Reply exchange(String response, int delay) throws Exception {
        try (ServerSocket server = new ServerSocket(0)) {
            Throwable[] failure = new Throwable[1];
            Thread peer = new Thread(() -> {
                try (Socket socket = server.accept()) {
                    socket.setSoTimeout(1000);
                    InputStream in = socket.getInputStream(); ByteArrayOutputStream headers = new ByteArrayOutputStream();
                    int c; String h;
                    do { c = in.read(); if (c < 0) throw new EOFException(); headers.write(c); h = headers.toString("US-ASCII"); } while (!h.endsWith("\r\n\r\n"));
                    yes(h.startsWith("POST /drive HTTP/1.1\r\n"), "Correct request line");
                    yes(h.contains("Content-Length: 6\r\n"), "Exact body length");
                    byte[] body = new byte[6]; int count = 0;
                    while (count < 6) { int n = in.read(body, count, 6-count); if (n < 0) throw new EOFException(); count += n; }
                    yes(new String(body, StandardCharsets.US_ASCII).equals("left=0"), "Complete command body arrives");
                    Thread.sleep(delay); socket.getOutputStream().write(response.getBytes(StandardCharsets.UTF_8));
                } catch (Throwable e) { failure[0] = e; }
            }); peer.start();
            try (Socket socket = new Socket("127.0.0.1", server.getLocalPort())) {
                try { return RobotHttp.exchange(socket, "/drive", "left=0"); }
                finally { peer.join(2000); if (failure[0] != null) throw new AssertionError(failure[0]); }
            }
        }
    }
    public static void main(String[] args) throws Exception {
        RobotHttp.Reply reply = exchange("HTTP/1.1 200 OK\r\nContent-Length: 2\r\nConnection: close\r\n\r\n{}", 300);
        yes(reply.code == 200 && reply.body.equals("{}"), "A delayed reply above the old 200ms limit is read completely");
        reply = exchange("HTTP/1.1 409 Conflict\r\ncontent-length: 4\r\n\r\nstop", 0);
        yes(reply.code == 409 && reply.body.equals("stop"), "Firmware rejection is preserved");
        boolean rejected = false;
        try { exchange("HTTP/1.1 200 OK\r\nContent-Length: 5\r\n\r\n{}", 0); } catch (EOFException e) { rejected = true; }
        yes(rejected, "Truncated response rejected");
        rejected = false;
        try { exchange("HTTP/1.1 200 OK\r\nContent-Length: 99999\r\n\r\n", 0); } catch (IOException e) { rejected = true; }
        yes(rejected, "Unbounded response rejected");
        rejected = false;
        try { exchange("HTTP/1.1 200 OK\r\n\r\n{}", 0); } catch (IOException e) { rejected = true; }
        yes(rejected, "Missing length rejected");
        System.out.println("PASS direct HTTP, delayed response, rejection, truncation and bounds checks");
    }
}

android/tests/SessionTests.java

Download this source file

package com.scout.control;

public final class SessionTests {
    static void yes(boolean value, String why) { if (!value) throw new AssertionError(why); }
    static SessionState connected(long now) {
        SessionState s = new SessionState();
        long epoch = s.connect(now);
        yes(s.acceptSession(epoch, "0123456789abcdef0123456789abcdef"), "Connect must accept its neutral session");
        return s;
    }
    public static void main(String[] args) {
        SessionState s = connected(1000);
        yes(s.left == 0 && s.right == 0, "Connect creates zero targets");
        s.input(1, 0, true, 1010); yes(s.left == 44 && s.right == 44, "New touch allows remapped driving");
        s.input(0, 0, false, 1020); yes(s.left == 0 && s.right == 0 && s.urgent, "Release schedules zero promptly");
        s.input(1, 0, true, 1030); long old = s.epoch;
        s.end("Stopped"); yes(!s.acceptSession(old, "0123456789abcdef0123456789abcdef"), "In-flight connect cannot resurrect stopped session");
        yes(!s.acceptDrive(old), "In-flight drive response cannot undo STOP");
        yes(s.left == 0 && s.right == 0 && s.stopPending, "Stop clears input and schedules global stop");
        s.input(1, 0, true, 1050); yes(s.left == 0, "Disconnected input ignored");
        long next = s.connect(1100); s.acceptSession(next, "0123456789abcdef0123456789abcdef");
        yes(s.left == 0 && !s.touching, "Reconnect requires new touch");
        s.input(1, 0, true, 1110); s.tick(1361);
        yes(!s.active() && s.stopPending && s.left == 0, "Frozen UI expires held command");
        s = connected(2000); s.input(1, 0, true, 2010); s.heartbeat(2220); s.tick(2400);
        yes(s.active(), "Responsive UI can hold a stationary touch");
        s.tick(2471); yes(!s.active(), "Heartbeat deadline must not renew on worker ticks");
        s = connected(3000); old = s.epoch; s.fail(old, "Network lost");
        yes(!s.active() && s.stopPending && s.left == 0, "Network failure ends session");
        s.connect(3100); s.fail(old, "Old request failure"); yes(s.mode == SessionState.CONNECTING, "Obsolete failure cannot cancel newer Connect");
        s = connected(4000); s.input(1,0,true,4010); s.speed(10); yes(s.left == 0, "Changing cap below threshold stops held target");
        s.end("Paused"); s.speed(100); yes(s.left == 0, "Speed change cannot restart paused session");
        s = connected(5000); s.input(1,0,true,5010); s.heartbeat(5300);
        yes(!s.active() && s.left == 0, "A UI heartbeat returning after its deadline cannot revive an old touch");
        s = connected(6000); s.input(1,0,true,6010); s.input(1,0,true,6300);
        yes(!s.active() && s.left == 0, "A delayed touch event cannot refresh an expired session");
        s = connected(7000); s.input(1,0,true,7010); s.input(0,0,false,7020); s.input(-1,0,true,7030);
        int[] pair = s.takeTargetPair();
        yes(pair[0] == 0 && pair[1] == 0, "Rapid retouch cannot overwrite release's immediate zero");
        pair = s.takeTargetPair(); yes(pair[0] == -44 && pair[1] == -44, "After release zero the worker samples the latest touch");
        s = new SessionState(); old = s.awaitWifi(8000); s.heartbeat(10000); s.tick(20000);
        yes(s.mode == SessionState.WAITING_WIFI && s.left == 0, "System Wi-Fi prompt may wait without driving or UI expiry");
        yes(s.wifiReady(old, 20001), "Only the current Wi-Fi request may begin connecting");
        yes(s.mode == SessionState.CONNECTING && s.connectPending, "Wi-Fi availability begins a neutral connection");
        s = new SessionState(); old = s.awaitWifi(21000); s.end("Cancelled");
        yes(!s.wifiReady(old, 21001), "Late Wi-Fi callback cannot undo Stop");
        s = connected(22000); s.end("Paused"); s.releaseWifiPending = true; old = s.epoch;
        s.end("Hidden"); s.releaseWifiPending = true;
        yes(!s.takeWifiCleanup(old), "An older in-flight Stop cannot consume newer network cleanup");
        yes(s.releaseWifiPending, "Current Stop still owns the pending cleanup");
        yes(s.takeWifiCleanup(s.epoch) && !s.releaseWifiPending, "Current Stop consumes cleanup exactly once");
        s.releaseWifiPending = true; old = s.epoch; s.awaitWifi(23000);
        yes(!s.takeWifiCleanup(old) && !s.releaseWifiPending, "New explicit Connect supersedes old network cleanup");
        s = new SessionState(); old = s.awaitWifi(24000); s.wifiReady(old,24001);
        s.end("Network replaced during neutral setup"); next = s.awaitWifi(24002);
        yes(!s.acceptSession(old,"0123456789abcdef0123456789abcdef"), "Replaced setup cannot accept an old session reply");
        yes(s.wifiReady(next,24003) && s.left == 0 && s.right == 0, "Network replacement can only retry neutral setup");
        s = connected(25000); s.input(1,0,true,25001); s.leave("Paused"); old = s.epoch;
        yes(s.left == 0 && s.stopPending && s.releaseWifiPending, "Leaving schedules stop and Wi-Fi cleanup");
        s.leave("Hidden");
        yes(s.epoch == old, "Repeated lifecycle exit must preserve the in-flight Stop owner");
        s.stopPending = false; yes(s.takeWifiCleanup(old), "First exit owns network cleanup");
        s.leave("Destroyed");
        yes(!s.stopPending && !s.releaseWifiPending, "Later exit cannot queue Stop after Wi-Fi was released");
        next = s.awaitWifi(26000); s.wifiReady(next,26001); s.acceptSession(next,"0123456789abcdef0123456789abcdef");
        s.leave("Paused again");
        yes(s.stopPending && s.releaseWifiPending, "Explicit reconnect permits a new lifecycle Stop");
        System.out.println("PASS session lifecycle, stale-response, reconnect, release and freshness checks");
    }
}

docs/browser-control.md

Download this source file

# Scout browser control

The ESP32-C3 serves the complete controller itself. No Android app, internet,
account, CDN or cloud hosting is required. Use a modern browser on a phone,
tablet or computer.

## Start driving

1. Unplug ESP USB before switching RUN on, following Scout's existing power procedure.
2. Join Wi-Fi **C3-Scout-Test**, password **ScoutTest42**. Stay connected if the
   device says this network has no internet.
3. Open **http://192.168.4.1/** (HTTP, not HTTPS), then press **Connect**.
4. Drag the joystick; release to send zero. Default drive limit is 35%. The
   existing power mapping remains: logical 0–30% is off; above 30% maps to
   physical motor targets of 40–100%.
5. Press **Stop** to stop and end the session. Reconnect deliberately to drive again.

Auto cycles ten animated faces. Tap a named expression to keep that face's
blinking/glancing animation. Swipe the face row for all choices. OLED absence
disables face controls while leaving driving available.

**Motor directions** is an expandable section below the controls; scroll if
needed. Stop first, choose Reverse left/right motor, and save. Settings persist
on Scout. Existing saved values were preserved. Stop remains pinned at the
bottom in portrait and landscape. Arrow keys work while the joystick has focus;
releasing a key sends zero, and Space stops the session.

## Safety and compatibility

The browser, Android app and HTTP protocol share the same single DriveCore
session: only one can drive at a time. Observers cannot claim an existing
session. Closing an observing or obsolete browser connection cannot stop a
newer owner. The Android protocol-2 app and UDP interface remain supported.

Browser sessions use an independent 1000 ms motor lease and hardware-enable
cutoff; Android sessions retain 400 ms. The browser additionally stops after
800 ms without a fresh drive
acknowledgement, a stalled UI (over 250 ms), lost socket, hidden page, window focus loss or page exit. It
does not automatically resume after reconnecting. A release sends zero
immediately, ahead of a new touch; that touch must wait for zero acknowledgement.
The browser sends the current target every 100 ms independently of reply latency.
It bounds unsent socket data to 256 bytes and tracks recent sent sequences so
duplicate, future or stale acknowledgements cannot renew reply freshness.

Only drive packets renew the lease. Face changes, status requests, WebSocket
pings and calibration do not. Calibration holds ready=false while writing
preferences, preventing a concurrent browser/Android session from starting.
HTTP page transfers, WebSocket IO and OLED rendering run outside the motor loop
and independent safety timer. This is the existing software cutoff, not a
certified mechanical stopping-time guarantee.

## Firmware and protocol

Sources: `firmware/web/index.html`, `control-core.js`, `control-app.js`.
`scripts/build-web-control.py` produces deterministic gzip data in
`firmware/ScoutDrive/WebControlPage.h` and a readable preview in
`artifacts/web-control/index.html`. `scripts/build-firmware.ps1` generates it
automatically. Install Arduino **WebSockets 2.7.2** (Links2004/Markus Sattler),
plus the existing Adafruit SSD1306/GFX dependencies and local ScoutFaces library.
WebSockets dependency/reference: https://github.com/Links2004/arduinoWebSockets

GET / returns the self-contained compressed page with no-store caching.
WebSocket port 81 uses subprotocol `arduino`; the Origin must be exactly
`http://192.168.4.1`. The browser port is local to Scout's Wi-Fi network.

- Text `C`: request a fresh neutral session; success returns status with a
  32-character token and boot ID. Busy/unavailable returns an error.
- Binary 45-byte `SCT2D` frames: existing protocol-2 token, big-endian sequence,
  signed left/right motor targets. A reply contains status plus matching `ack`.
  Frames require both the socket's ownership and the current session token.
- Text `F,-1` or `F,0` through `F,9`: select Auto or a face; no lease renewal.
- Text `S`: end only this socket's owned session. Disconnect also releases that
  session. Invalid application frames release an owned session.
- Direction changes use the existing stopped-only HTTP POST /config endpoint.

Status adds `browserControl:true`. Firmware retains SCOUT 2 / protocol 2 identity.
No partition changes are required. Previous firmware images are saved under
`artifacts/recovery/Before-Web-Control-2026-10-18`.

## Verified 18 October 2026

- Firmware: 1,181,613 bytes application flash (90%); 40,792 bytes static RAM (12%).
  Uploaded to COM3 with flash hashes verified. Final application SHA256:
  `f63a578b4ac9d855ed778770c1cd9ab61de0998844ce00985fad0e0c5d5fdbc7`.
- 308 firmware host checks, ScoutFaces timeline checks, and browser-core tests
  passed (mixing/framing, one outstanding frame, release gating, neutrality,
  stale acknowledgements, restart, visibility and UI freshness).
- Browser UI checked at 390×844, 375×667 and 844×390. Face row and joystick stay
  above the pinned Stop button; drive, face selection and release work, and
  calibration is locked while active.
- Real Chromium browser loaded the page from Scout over Wi-Fi and sent
  +44%/+44% commands while selecting Happy, Dizzy and Auto. OLED remained ready.
  Release sent zero without ending the session; Stop ended it. Saving unchanged
  motor directions preserved both existing reverse settings.
- Device checks passed: Android HTTP session exclusion, observer exclusion,
  400 ms lease expiry after a single drive packet, obsolete socket disconnect
  preserving a newer Android-style session, owner disconnect stop, malformed
  frame stop, and rejection of a foreign WebSocket Origin.
- RUN remained OPEN. These were software/electrical bench checks, not powered
  driving, visual animation measurement or radio-range tests. Safari/Firefox
  were not separately device-tested. Final state: zero targets, driver off,
  disconnected, OLED Auto. Host Wi-Fi restored to WC_White.

Results/screenshots: `artifacts/verification/web-control/`. Host/UI test helpers:
`firmware/tests/web-control.test.cjs`, `scripts/test-web-control-ui.cjs`.
`scripts/bench-web-control.ps1` temporarily joins Scout Wi-Fi and always requests
restoration of the original profile. Supply `-RestoreProfile` on another host.

## Settings-related disconnect fix (18 October 2026)

A reproduced browser bug ended the session whenever joystick release found any
WebSocket send backlog, even one ordinary 45-byte drive frame. Speed changes
and moving focus from the joystick to a face button can trigger release, so a
healthy connection could be reported as delayed during those actions.

Release now queues its immediate zero through the same bounded send check used
by other commands. The excessive-backlog cutoff, zero-acknowledgement gate,
250 ms browser checks and independent 400 ms firmware lease are unchanged.
There is no automatic movement restart.

Regression coverage is in `firmware/tests/web-settings.test.cjs`: normal buffered
release on speed/focus change must remain connected and send zero; excessive
backlog must still disconnect. Seven browser test groups, 308 firmware host
checks and the three browser viewport checks passed. This fixes a reproduced
client-side cause; it does not establish the cause of every reported random
disconnect. Uploaded to COM3 with flash verification. Serial checks confirmed ready, OLED ready, unchanged boot and disabled zero motor targets. The computer could not see C3-Scout-Test even after a fresh Wi-Fi scan, so wireless stress verification remains pending; local tests do not establish that all radio/session drops are resolved.

## Reverse steering correction (19 October 2026)

The operator reported correct straight forward/reverse and stationary left/right,
but reversed steering while backing up. Both browser and Android mixers used a
fixed steering differential regardless of travel direction. They now reverse the
steering contribution only when the forward input is negative. Straight travel,
forward arcs, stationary turns, motor calibration and stop behavior are preserved.

Regression tests reproduced the old reverse-right wheel pair [-44, 0] and now
require [0, -44]; reverse-left similarly changes to [-44, 0]. Browser tests also
check both forward arcs and stationary turns, plus bounded motor output across
all speed caps. All eight browser test groups, 429 Android mixer checks and the
308 firmware host checks passed; Android session, HTTP, packet and face tests
passed. Updated software requires installation before physical confirmation.

Both updated builds completed successfully. The Android APK signature verified;
firmware uses 1,181,757 bytes of flash and 40,792 bytes of global RAM. Installation
and physical reverse-turn confirmation are pending the operator's setup check.

ESP installation completed on COM3 after the operator confirmed RUN OPEN and USB
connected. Upload hashes verified. Serial status confirmed ready=true,
enabled=false, left=0, right=0, OLED ready, browser control available and both
saved motor reverse flags still true. Phone installation was skipped at the
operator's request. Physical reverse-turn confirmation remains pending.

The operator confirmed corrected physical steering but reports repeated browser
disconnects showing "Scout link delayed · reconnect". That message conflates
closed transport with bufferedAmount >256. Split these into "Scout connection
closed" and "Scout send queue stalled (N bytes)" to identify the failing branch.
Nine browser test groups pass. This is diagnostic only; no disconnect root cause
has been established, and timeout/backlog protections remain unchanged.

## Delayed replies while driving (19 October 2026)

The operator clarified the actual message as "Scout replies delayed" while using
the joystick. The old browser sent a single command then waited for its reply;
it disconnected if that reply took over 250 ms, before the firmware's 400 ms
lease. A deterministic 300 ms reply-latency regression reproduced stalled command
updates. The browser now transmits the current pair every 50 ms independently of
replies, while keeping the existing 256-byte unsent queue limit. It stops after
400 ms without fresh acknowledged progress. Only increasing, actually sent
sequences younger than 400 ms can update reply freshness. Zero release still
blocks new motion until that zero or a later zero has been acknowledged.
The firmware's independent 400 ms cutoff and hidden/stalled-page stops remain.

All 11 browser test groups, 308 firmware host checks, and three browser viewport
checks passed. This corrects the reproduced sensitivity to reply latency;
physical wireless confirmation remains pending. Separate closed-connection and
send-queue diagnostics are included. No phone changes are part of this update.

Installed the delayed-reply correction on COM3 after fresh operator confirmation
of RUN OPEN and ESP USB connected. Upload hash verification passed. Serial status
confirmed ready, disconnected, driver disabled, zero left/right targets, OLED
ready, browser controller available, both saved reverse flags true. Browser must
be reloaded to load the revised JavaScript. Powered wireless driving confirmation
remains pending; phone app was not installed.

## Timeout adjustment (19 October 2026)

At the operator's request, browser updates now run every 100 ms, reply freshness
is limited to 800 ms, and browser-owned ESP sessions expire after 1000 ms without
a valid command. Release and Stop remain immediate; UI stall (250 ms), hidden
page, focus-loss and send-backlog checks remain. Maximum continued motor drive
after command loss is now one second for browser sessions. Android sessions
retain their 400 ms timeout and existing app compatibility. The status API keeps
timeoutMs=400 for Android and adds browserTimeoutMs=1000; the browser requires
the latter value before driving. Session acquisition always resets the timeout
for the new controller, and observing or conflicting clients cannot change it.

Verification: 12 browser test groups, 310 firmware checks, all Android host suites
and three browser viewport checks passed. Tests cover 600 ms delayed replies,
100 ms command cadence, the exact 800 ms browser reply cutoff, the exact 1000 ms
ESP browser expiry, and returning to 400 ms on the next Android session.

Timing update installed on COM3 after the operator explicitly confirmed RUN
physically OPEN and ESP USB connected. Flash hash verification passed. Serial
startup confirmed ready, driver disabled, zero motor targets, saved motor
calibration preserved, OLED ready and browserTimeoutMs=1000 (Android timeoutMs
remains 400). Reload the browser controller to load the 100 ms update cadence and
800 ms reply timeout. Wireless driving confirmation remains pending.

Operator follow-up after the timing update: direction is confirmed correct and
driving is reported to work "way better." This confirms improvement on Scout;
long-duration wireless stability and range remain unqualified. Documentation
and public software packages are being updated to this installed build.

docs/control-v1.2.md

Download this source file

# Scout Control 1.2.0: faces while driving

The regular SCOUT 2 firmware now runs ScoutFaces in an optional independent
low-priority task. The joystick, UDP motor packets and 400 ms lease remain
protocol 2. The Android face-request worker is separate from the drive worker.

Use the Auto and ten named face buttons above Stop. Swipe horizontally to see
the full list. A chosen expression keeps blinking/glancing until another is
selected; Auto cycles all ten. Face controls enable only after connecting to
firmware that advertises the feature and detects the OLED. App 1.2.0 can still
drive older SCOUT 2 firmware, with face buttons disabled. Older apps can drive
this firmware, with automatic OLED faces by default.

OLED: SSD1306 128×64, VCC=3V3, GND=GND, SDA=GPIO5, SCL=GPIO7. Firmware probes
0x3C and 0x3D at 100 kHz. No OLED, an initialization failure, or a disconnected
OLED disables the face renderer while leaving driving available. Repair the
wiring and reset Scout to retry. The display task owns Wire and the framebuffer;
no I2C transfer runs in the motor loop, HTTP task or safety timer.

## API extension

Status/session JSON adds `faceControl` (true), `oledReady` (boolean), and `face`
(-1 for Auto, 0..9 for a selected expression). These describe the requested
selection, not an optical check of the screen. Expression order matches the
ScoutFaces library: Happy, Laughing, Surprised, Angry, Sad, Sleepy, Skeptical,
Winking, Cheeky, Dizzy.

`POST /face`, form `token=<current session token>&id=-1` or id `0..9`, returns
normal status JSON. Exactly those two fields are required. Bad fields return
400, a wrong/ended/expired session returns 409, and unavailable OLED returns
503. Face requests never renew the drive lease or sequence number. The handler
updates a mailbox; the display task applies the latest selection. Face selection
is volatile, not written to flash. Auto resumes on reboot.

## Build and install

Install Adafruit SSD1306/GFX and dependencies in the configured Arduino CLI
library directory. `scripts/build-firmware.ps1` now includes the local
`libraries/ScoutFaces` library. Build the app using `scripts/build-android.ps1`.
App version: 1.2.0 / code 4. Firmware retains SCOUT 2 / protocol 2 compatibility.

Keep RUN OPEN before ESP USB connection or firmware upload. Unplug ESP USB
before RUN ON. Existing motor reversal preferences are preserved by a normal
upload; no calibration or drive-power mapping was changed. Previous builds are
saved under `artifacts/recovery/Before-Integrated-Faces-2026-10-18`.

## Verification scope

Host regression suites check drive safety, strict face ids, session-gated
selection without lease renewal, rapid taps, stale results, lifecycle cleanup
and animation timing. Firmware/APK builds and device installation results are
recorded in this chat. A real driving/visual check is still an operator test;
USB bench verification uses RUN OPEN and cannot prove wheel motion or radio
range under motor load.

### Completed bench checks, 18 October 2026

- Firmware built: 1,155,407 bytes program flash (88%); 39,424 bytes static RAM.
  Flash uploaded to the ESP32-C3 on COM3 with written hashes verified.
- App 1.2.0/code 4 built, signed and installed on Motorola ZY22CJ2PNG.
  Portrait layout was visually checked: large joystick, horizontal face strip,
  and full Stop button remain visible.
- All 285 firmware checks, 429 Android mixer checks, session/HTTP/datagram/face
  suites, and ScoutFaces timing checks passed. Local HTTP host tests require
  execution outside the restricted sandbox.
- Startup reports ready, OLED ready, Auto selection, zero targets, driver off,
  and both saved motor reverse flags still ON.
- After two initial neutral HTTP setup timeouts during the Android Wi-Fi
  handoff, Connect succeeded. Subsequent face selections and drive checks
  retained the active session without logged link errors.
- Happy, Laughing, Surprised and Auto reached the OLED task from the phone.
  A 24-second serial trace contains 151 status samples, including ten samples
  at +44%/+44% with driver enabled and OLED ready. Stop then returned zero/zero,
  driver disabled, session ended. RUN remained OPEN: this was an electrical/
  software bench check, not a powered-wheel or visual animation measurement.
- Trace and app screenshots: `artifacts/verification/faces-integrated/`.
  Final state: stopped, OLED Auto. Unplug ESP USB before RUN ON.

firmware/ScoutFaces/FaceBitmaps.h

Download this source file

// Generated by scripts/build-oled-faces.py; 128x64, MSB-first rows.
#pragma once
#include <Arduino.h>
constexpr uint8_t FACE_COUNT = 10;
const char* const FACE_NAMES[FACE_COUNT] = {"Happy", "Laughing", "Surprised", "Angry", "Sad", "Sleepy", "Skeptical", "Winking", "Cheeky", "Dizzy"};
constexpr uint8_t POSE_COUNT = 9;
const uint8_t FACE_BITMAPS[FACE_COUNT][POSE_COUNT][1024] PROGMEM = {
  { // Happy
    {
      0x00, 0x00, 0x00, 0x00, 0x00, 0x00, 0x00, 0x00, 0x00, 0x00, 0x00, 0x00, 0x00, 0x00, 0x00, 0x00,
      0x00, 0x00, 0x03, 0x00, 0x00, 0x00, 0x00, 0x00, 0x00, 0x00, 0x00, 0x00, 0x00, 0xc0, 0x00, 0x00,
      0x00, 0x00, 0x1f, 0xfe, 0x00, 0x00, 0x00, 0x00, 0x00, 0x00, 0x00, 0x00, 0x7f, 0xf8, 0x00, 0x00,
      0x00, 0x00, 0xff, 0xff, 0xf8, 0x00, 0x00, 0x00, 0x00, 0x00, 0x00, 0x1f, 0xff, 0xff, 0x00, 0x00,
      0x00, 0x0f, 0xff, 0xff, 0xff, 0xf0, 0x00, 0x00, 0x00, 0x00, 0x0f, 0xff, 0xff, 0xff, 0xf0, 0x00,
      0x00, 0x7f, 0xf8, 0x03, 0xff, 0xf0, 0x00, 0x00, 0x00, 0x00, 0x0f, 0xff, 0xc0, 0x1f, 0xfe, 0x00,
      0x03, 0xff, 0xc0, 0x00, 0x0f, 0xf0, 0x00, 0x00, 0x00, 0x00, 0x0f, 0xf0, 0x00, 0x03, 0xff, 0xc0,
      0x03, 0xfc, 0x00, 0x00, 0x00, 0x10, 0x00, 0x00, 0x00, 0x00, 0x08, 0x00, 0x00, 0x00, 0x3f, 0xc0,
      0x01, 0xe0, 0x00, 0x00, 0x00, 0x00, 0x00, 0x00, 0x00, 0x00, 0x00, 0x00, 0x00, 0x00, 0x07, 0x80,
      0x01, 0x00, 0x00, 0x00, 0x00, 0x00, 0x00, 0x00, 0x00, 0x00, 0x00, 0x00, 0x00, 0x00, 0x00, 0x80,
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
      0x00, 0x00, 0x00, 0x00, 0x00, 0x00, 0x00, 0x18, 0x00, 0x00, 0x00, 0x00, 0x00, 0x00, 0x00, 0x00,
      0x00, 0x00, 0x00, 0x00, 0x00, 0x00, 0x00, 0x1f, 0xf0, 0x00, 0x00, 0x00, 0x00, 0x00, 0x00, 0x00,
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
