instructorJasonWhite/c3-scout-robot/docs/builder-guide/accessories-content.html

Storage cases · all three variants are v8

## A case for each Scout configuration

Choose the case that matches the front of your assembled Scout: standard bumper, angled OLED bumper or upright ESP32-CAM mount. Each has a captive hinge and a separate flat-printed spring latch.

Version 8 keeps the broad shell at a nominal 2.8 mm, with 5 mm bevels, taller side guides and rounded rear locators. Each download includes editable Fusion and STEP files, complete and separate STL meshes, a Bambu Studio project, images and print notes.

Case | Fits | Closed shell, W × L × H | P1S estimate
Bumper v8 | Scout with its standard bumper | 107.6 × 155.6 × 55.6 mm | 3 h 57 min · 177 g PLA
OLED v8 | Scout with its angled OLED bumper | 107.6 × 155.6 × 63.6 mm | 4 h 12 min · 193 g PLA
ESP32-CAM v8 | Scout with the camera and attached USB adapter | 107.6 × 155.6 × 100.6 mm | 5 h 25 min · 266 g PLA

Shell dimensions exclude hinge projections. Estimates come from the supplied P1S slices and depend on material and settings.

Check the printed fit before loading Scout. All three cases passed CAD clearance, sampled opening-motion, mesh and native-file checks against the assembled reference models. Full-case physical fit, printed spring behavior and fatigue remain untested. Check your actual wiring, straps and accessories, then gently cycle the empty case and latch.

Lowest profile

## Standard bumper case v8

This is the shortest case, sized for Scout with its original bumper. Its four supports locate the chassis while the side guides and rear stops help keep the robot registered.

Standard bumper case v8 with its lid closed

Closed shell · 55.6 mm high

Standard bumper case v8 opened to show the captive hinge and interior

Captive base and lid

Standard bumper Scout reference fitted inside the v8 case

Fit checked against the standard Scout reference

Use the matching Bumper latch and the supplied v8 print project. Allow about 4 hours and 177 g of PLA with the included P1S settings.

Download Bumper case v8 Print and assembly notes

Room for the display

## OLED case v8

The OLED variant adds height for Scout’s integrated angled display bumper. Keep the display attached; check its wiring and any projecting connectors against the modeled fit before closing the lid.

OLED case v8 with its lid closed

Closed shell · 63.6 mm high

OLED case v8 opened to show the internal supports

Open case and separate flat latch

Scout with its angled OLED bumper fitted in the v8 OLED case reference

Clearance for the assembled OLED configuration

Use the matching OLED latch. Allow about 4 hours 12 minutes and 193 g of PLA with the included P1S settings.

Download OLED case v8 Print and assembly notes

Height for the camera

## ESP32-CAM case v8

The tallest case accommodates the upright camera mount with its USB programming adapter attached. It is modeled around the Scout camera assembly; check your adapter stack, connector revision and cable routing against that reference.

Tall ESP32-CAM case v8 with its lid closed

Closed shell · 100.6 mm high

ESP32-CAM case v8 opened to reveal the tall lid and supports

Extra height for the camera assembly

Camera-equipped Scout reference fitted inside its v8 case

Camera and USB adapter remain attached

Use the matching ESP32-CAM latch. Allow about 5 hours 25 minutes and 266 g of PLA with the included P1S settings. The camera’s electronics and software are separate from this storage-case package.

Download ESP32-CAM case v8 Print and assembly notes

Shared print setup

## Print the captive pair and its matching latch

Start with the supplied v8 Bambu Studio project. Its orientation keeps the base and lid in their intended hinge relationship and lays the separate spring on its broad face. Keep that relationship when adapting the project to another printer.

Setting | Verified P1S setup
Printer and material | Bambu P1S · 0.4 mm nozzle · PLA Basic, filament 1 · textured PEI
Layers and walls | 0.20 mm layers · 4 walls · 5 top layers · 3 bottom layers
Infill | 15% grid
Supports and adhesion extras | No supports, brim or prime tower in the supplied setup

Use the complete STL or the separate -Box.stl and -Latch.stl files. Loading both sets duplicates the parts. Never independently arrange the captive base and lid. Older v6/v7 sliced plates do not apply to v8.

1. Check the selected printer, plate, material and layer preview before printing. Use the profile as a starting point and confirm fit with your printer and material.
2. Let the print cool, then gently free the captive hinges.
3. With the lid open, align the latch’s thick dovetail foot with the internal entry channel and slide it toward the lid roof until seated. Hold the foot rather than levering the flexible blade.
4. Close gently for the first test. To open, push the catch inward through the front opening, lift the lid through the first few degrees, then release the catch.

Print times are slicer estimates. The complete cases still need a physical fit check. Nominal 2.8 mm walls can be thinner at shallow decorative recesses.

Optional front bumpers · v1 prototypes

## Add an OLED or a camera mount

These replacement bumpers reuse Scout’s two original M3 bumper screws and 56 mm mounting-hole spacing. Choose the matching storage case above when keeping the accessory attached.

### Angled OLED bumper

Scout model with its integrated angled OLED bumper

A 45° cradle brings the OLED into view.

Designed for the 0.96-inch DIYmall B01HEBIJKK board, 27.3 mm square with a 20.7 × 23.2 mm mounting pattern. Add four M2 × 12 screws and nuts. Current Scout firmware supports the display; see OLED wiring and faces.

OLED assembly guide · OLED bumper package

### ESP32-CAM mount

Scout model with the upright ESP32-CAM and attached USB adapter

The rear support adjusts around the retained USB adapter.

The two-piece mount adjusts for a 10–25 mm stack depth, with 28 mm inside width and a 41 mm camera seat height. Add two M3 × 12 screws, two nuts and four washers. Check your actual kit’s dimensions and cable access.

Camera assembly guide · Camera mount package

Both bumper mounts are prototypes awaiting physical fit checks. CAD and mesh checks passed. Camera firmware, streaming and integration with Scout’s power or controller are separate work. The camera needs a suitable regulated supply through its adapter; do not power it from a C3 GPIO. Follow the detailed guides before assembly.

Choose your format

## Accessory downloads

### Bumper case v8

- Complete case ZIP
- Editable Fusion · STEP
- Complete STL
- Box STL · Latch STL
- Bambu Studio project
- Print guide

### OLED case v8

- Complete case ZIP
- Editable Fusion · STEP
- Complete STL
- Box STL · Latch STL
- Bambu Studio project
- Print guide

### ESP32-CAM case v8

- Complete case ZIP
- Editable Fusion · STEP
- Complete STL
- Box STL · Latch STL
- Bambu Studio project
- Print guide

Use the Studio project to check and slice for your printer. Keep the latch matched to its case variant.
