instructorJasonWhite/c3-scout-robot/docs/builder-guide/index-content.html

A small robot you can build yourself

# Build your own Scout.

Print the parts. Assemble the robot. Drive it from your browser. Everything you need is organized into four practical guides.

Start the build →Already built? Start driving

ESP32-C3 · two N20 motors · printed M3 chassis · local Wi-Fi control

Exploded Fusion view of Scout's chassis, motor clamps, wheels, bumper and carrier board

The Rev B mechanical assembly, exported directly from Fusion.

## From parts to first drive.

Choose the guide you need.

Exploded motor-clamp assembly with its two screws and nuts

01 / The Build

## Put Scout together.

A visual parts list, nine illustrated assembly steps, and the exact M3 screws and nuts to set out at each stage.

Assembly guide, STL and Fusion files →

Component side of the Carrier C v10 circuit board

02 / The Board

## Meet the electronics.

Front and back board views, current schematic sheets, connector labels, and the matching files for manufacturing.

Board guide, schematics and factory files →

Scout's browser joystick controller

03 / The Code

## Bring it to life.

Install the current web-control firmware, take your first drive, and try the animated ScoutFaces library examples.

Firmware, Faces library and examples →

Open Scout storage case showing the captive hinge and replaceable latch

04 / The Accessories

## Make room for more.

Choose a storage case for the standard bumper, OLED screen or ESP32-CAM, with print notes and editable designs.

Three case variants and optional mounts →

## Start with a matching set.

The guides use the current released files below. Each guide ends with its own downloads, so the instructions and files stay together.

Part of Scout | Current file set | Where to go
Chassis and printed parts | Rev B · integral bay · all-M3 hardware | Build downloads
Carrier board | Carrier C v10 · Silk 03 | Board downloads
Web-control firmware | 19 October 2026 · SCOUT 2 | Code downloads
Animated Faces library | ScoutFaces 1.0.0 | Faces setup and examples
Storage cases | Bumper, OLED and ESP32-CAM · all v8 | Accessories downloads

A fit check before you build: the Fusion assembly views show the Rev B board model. Carrier C v10 keeps the mounting outline, but its populated components are not synchronized with that model. Check the actual board, motor shafts, battery holder and wire clearances as you assemble. The guides mark the parts that still need a physical fit check.
