instructorJasonWhite/c3-scout-robot/01-Electronics-CarrierC/assets/top-assembly.png

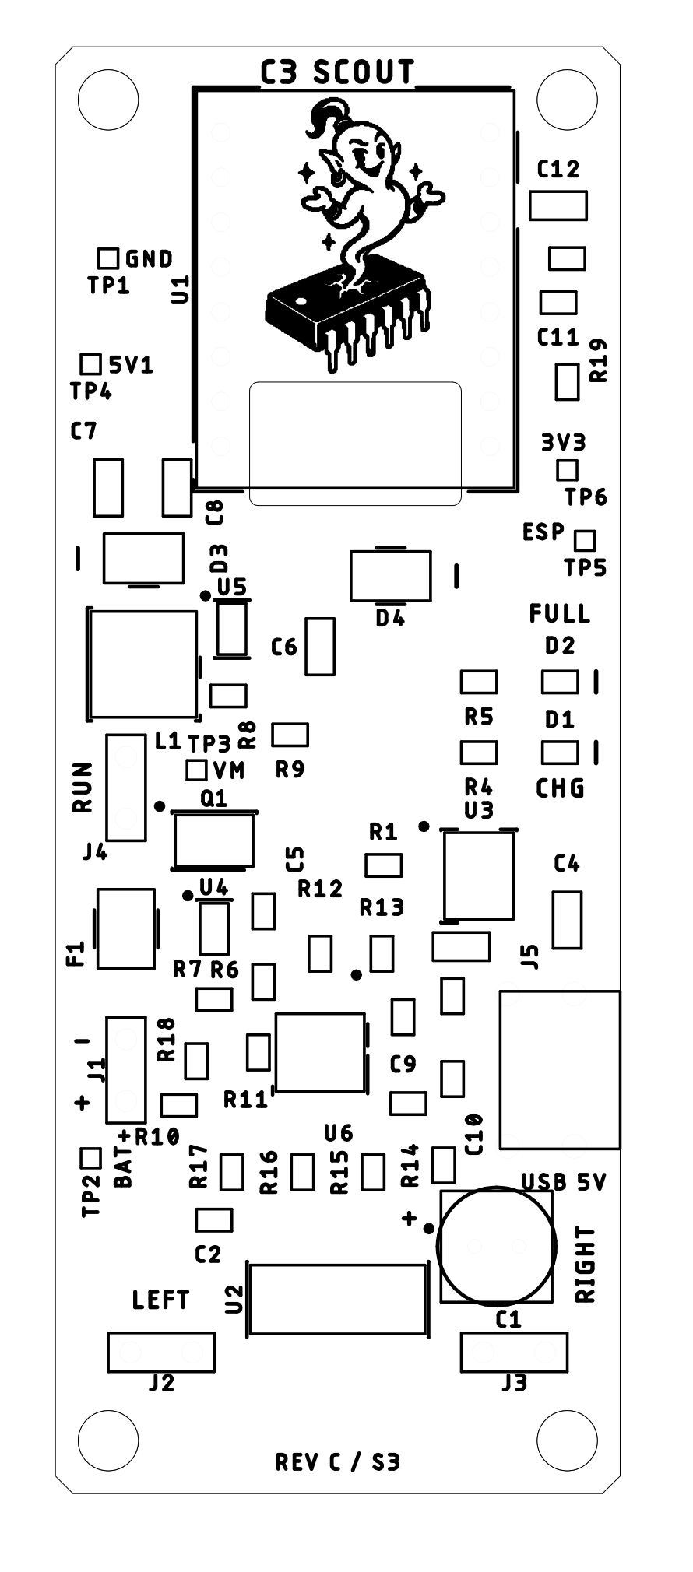
01-Electronics-CarrierC/assets/top-assembly.png
