instructorJasonWhite/c3-scout-robot/01-Electronics-CarrierC/C3-Carrier-RevC-Silkscreen-Review.pdf

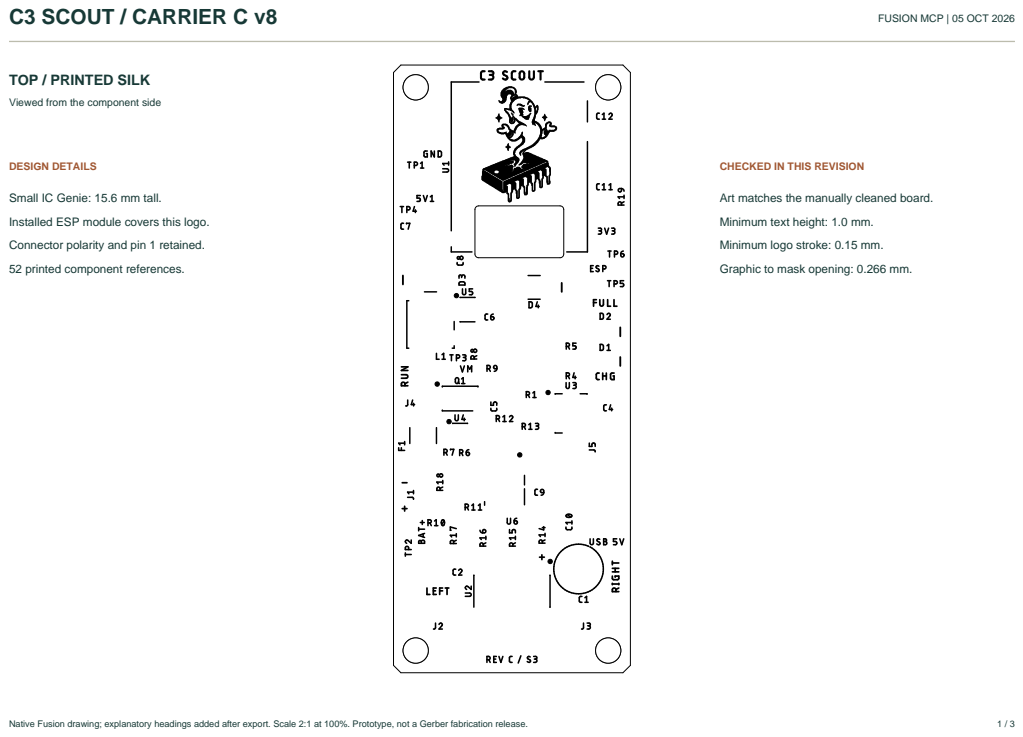
[picture p72: page 1]
C3 SCOUT / CARRIER C v8; FUSION MCP | 05 OCT 2026; DESIGN DETAILS; Native Fusion drawing; explanatory headings added after export. Scale 2:1 at 100%. Prototype, not a Gerber fabrication release.

TOP / PRINTED SILK

Viewed from the component side

CHECKED IN THIS REVISION

Small IC Genie: 15.6 mm tall.
Installed ESP module covers this logo.
Connector polarity and pin 1 retained.
52 printed component references.

Art matches the manually cleaned board.
Minimum text height: 1.0 mm.
Minimum logo stroke: 0.15 mm.
Graphic to mask opening: 0.266 mm.

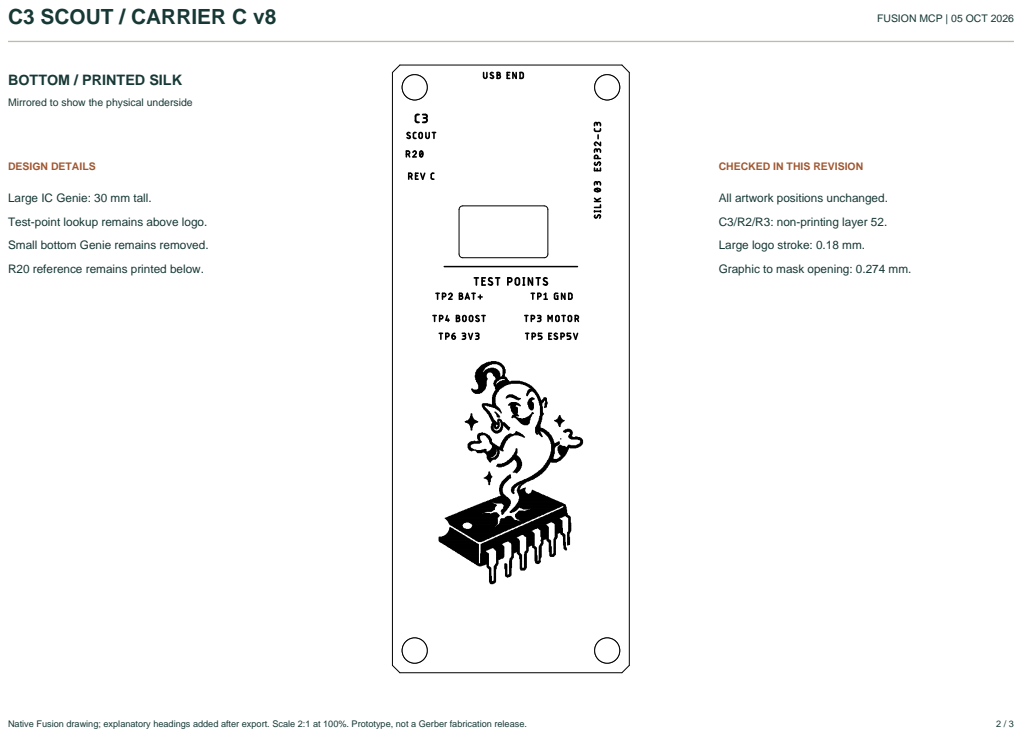
[picture p73: page 2]
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

BOTTOM / PRINTED SILK

Mirrored to show the physical underside

CHECKED IN THIS REVISION

Large IC Genie: 30 mm tall.
Test-point lookup remains above logo.
Small bottom Genie remains removed.
R20 reference remains printed below.

All artwork positions unchanged.
C3/R2/R3: non-printing layer 52.
Large logo stroke: 0.18 mm.
Graphic to mask opening: 0.274 mm.

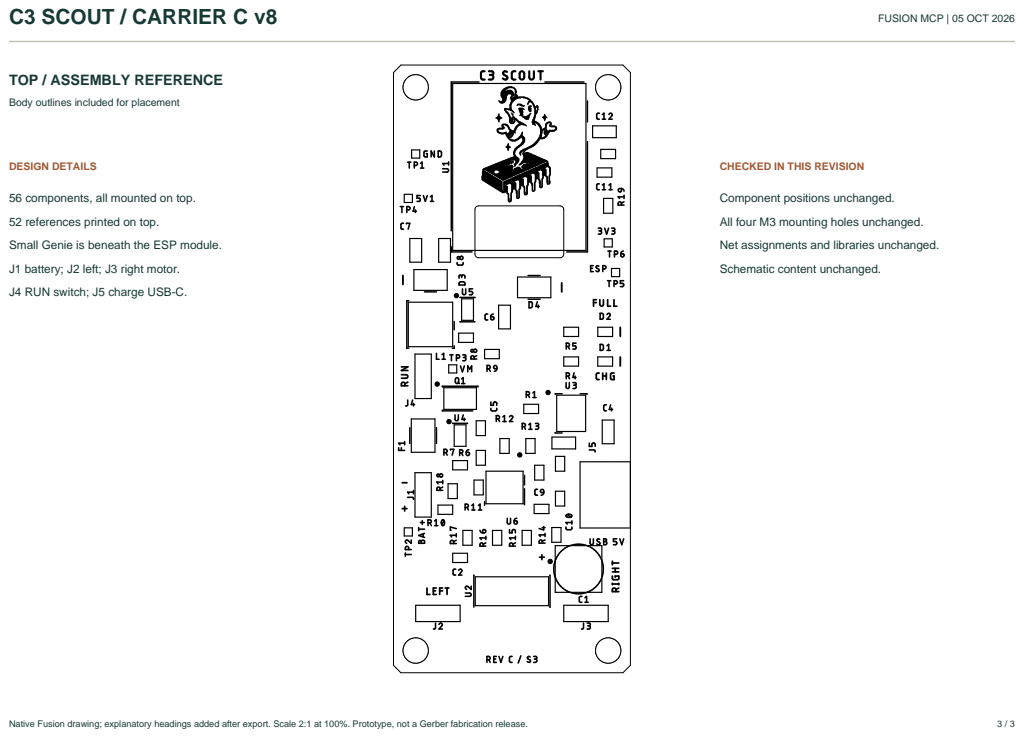
[picture p74: page 3]
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

TOP / ASSEMBLY REFERENCE

Body outlines included for placement

CHECKED IN THIS REVISION

56 components, all mounted on top.
52 references printed on top.
Small Genie is beneath the ESP module.
J1 battery; J2 left; J3 right motor.
J4 RUN switch; J5 charge USB-C.

Component positions unchanged.
All four M3 mounting holes unchanged.
Net assignments and libraries unchanged.
Schematic content unchanged.
