instructorJasonWhite/c3-scout-robot/01-Electronics-CarrierC/C3-Carrier-RevC-Board-Layout.pdf

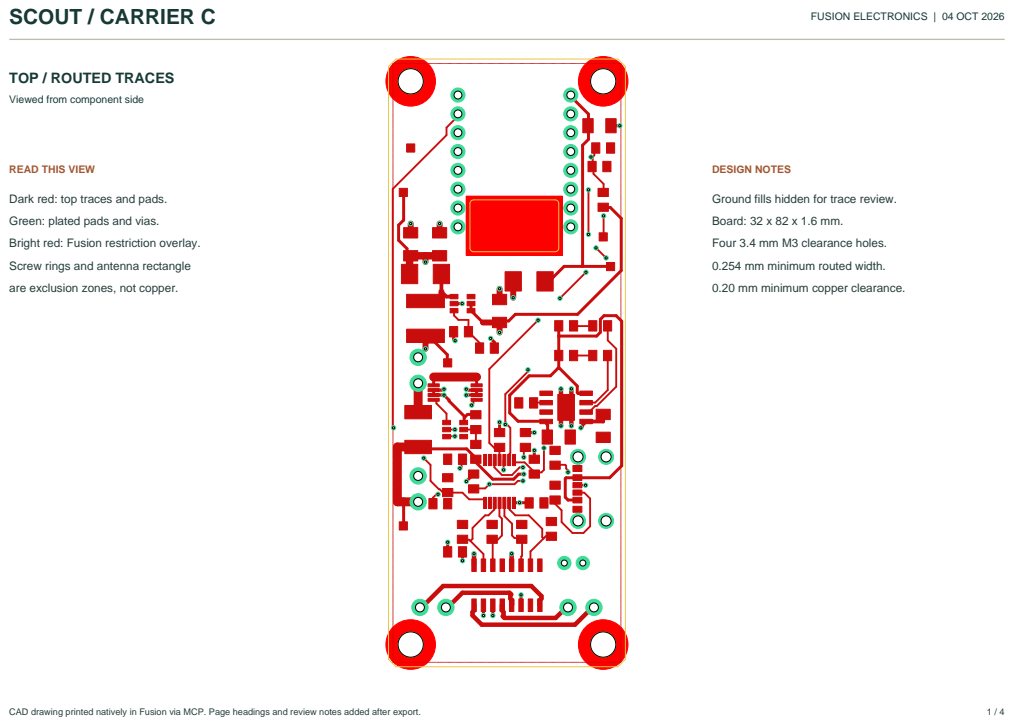
[picture p75: page 1]
SCOUT / CARRIER C; FUSION ELECTRONICS | 04 OCT 2026; DESIGN NOTES; CAD drawing printed natively in Fusion via MCP. Page headings and review notes added after export.

TOP / ROUTED TRACES

Viewed from component side

READ THIS VIEW

Dark red: top traces and pads.
Green: plated pads and vias.
Bright red: Fusion restriction overlay.
Screw rings and antenna rectangle
are exclusion zones, not copper.

Ground fills hidden for trace review.
Board: 32 x 82 x 1.6 mm.
Four 3.4 mm M3 clearance holes.
0.254 mm minimum routed width.
0.20 mm minimum copper clearance.

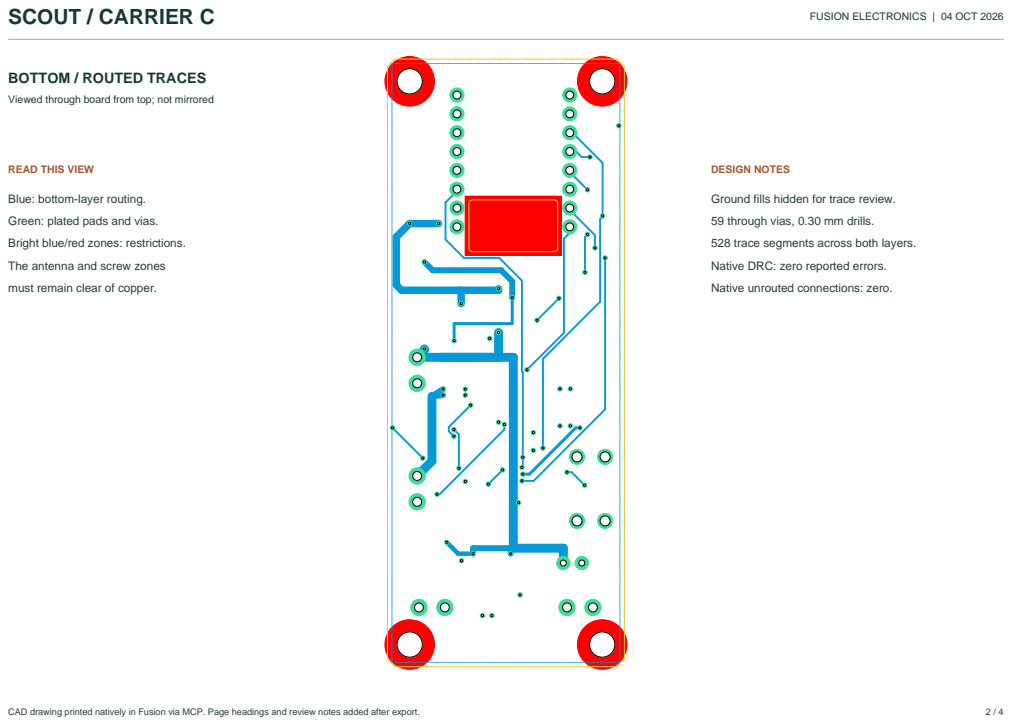
[picture p76: page 2]
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

BOTTOM / ROUTED TRACES

Viewed through board from top; not mirrored

READ THIS VIEW

Blue: bottom-layer routing.
Green: plated pads and vias.
Bright blue/red zones: restrictions.
The antenna and screw zones
must remain clear of copper.

Ground fills hidden for trace review.
59 through vias, 0.30 mm drills.
528 trace segments across both layers.
Native DRC: zero reported errors.
Native unrouted connections: zero.

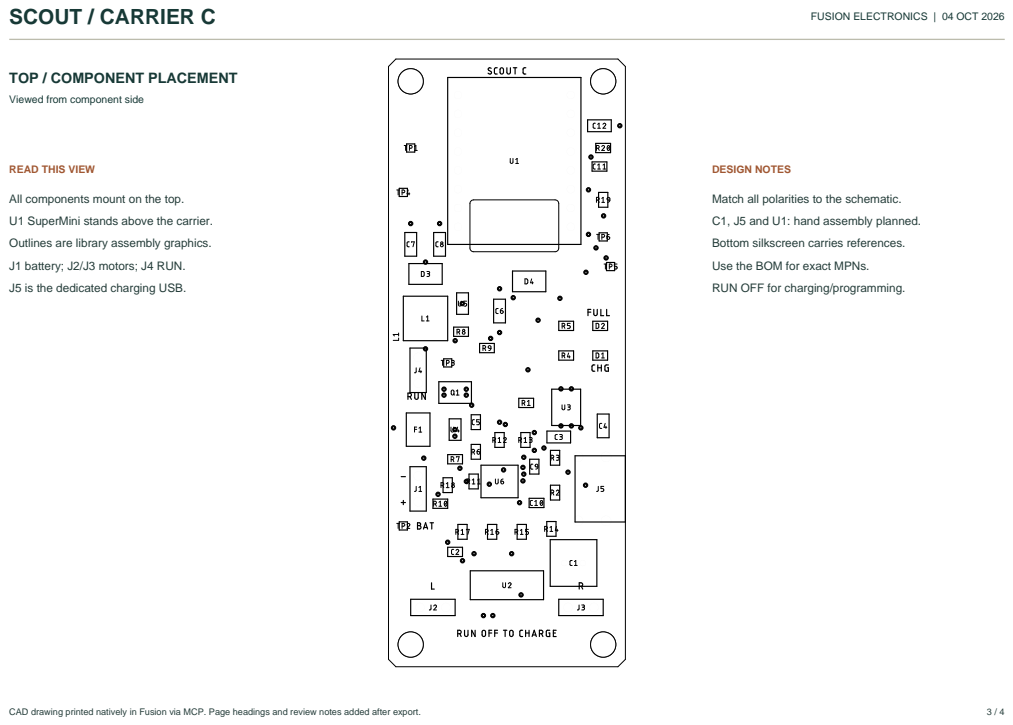
[picture p77: page 3]
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

TOP / COMPONENT PLACEMENT

Viewed from component side

READ THIS VIEW

All components mount on the top.
U1 SuperMini stands above the carrier.
Outlines are library assembly graphics.
J1 battery; J2/J3 motors; J4 RUN.
J5 is the dedicated charging USB.

Match all polarities to the schematic.
C1, J5 and U1: hand assembly planned.
Bottom silkscreen carries references.
Use the BOM for exact MPNs.
RUN OFF for charging/programming.

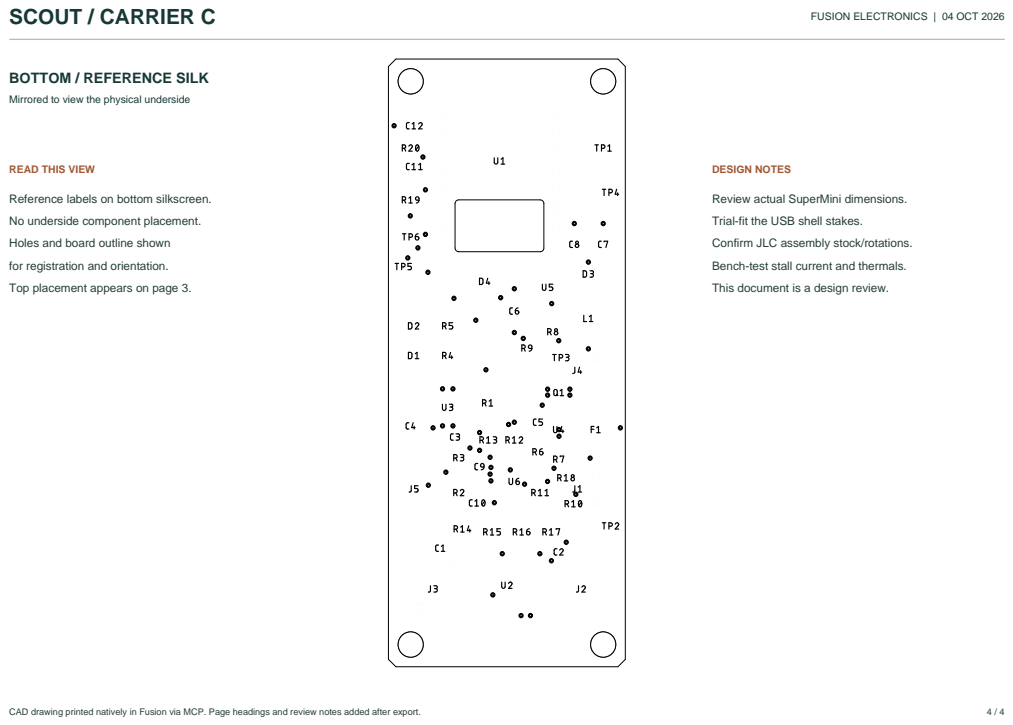
[picture p78: page 4]
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

BOTTOM / REFERENCE SILK

Mirrored to view the physical underside

READ THIS VIEW

Reference labels on bottom silkscreen.
No underside component placement.
Holes and board outline shown
for registration and orientation.
Top placement appears on page 3.

Review actual SuperMini dimensions.
Trial-fit the USB shell stakes.
Confirm JLC assembly stock/rotations.
Bench-test stall current and thermals.
This document is a design review.
