instructorJasonWhite/c3-scout-robot/01-Electronics-CarrierC/C3-Carrier-RevC-Schematic.pdf

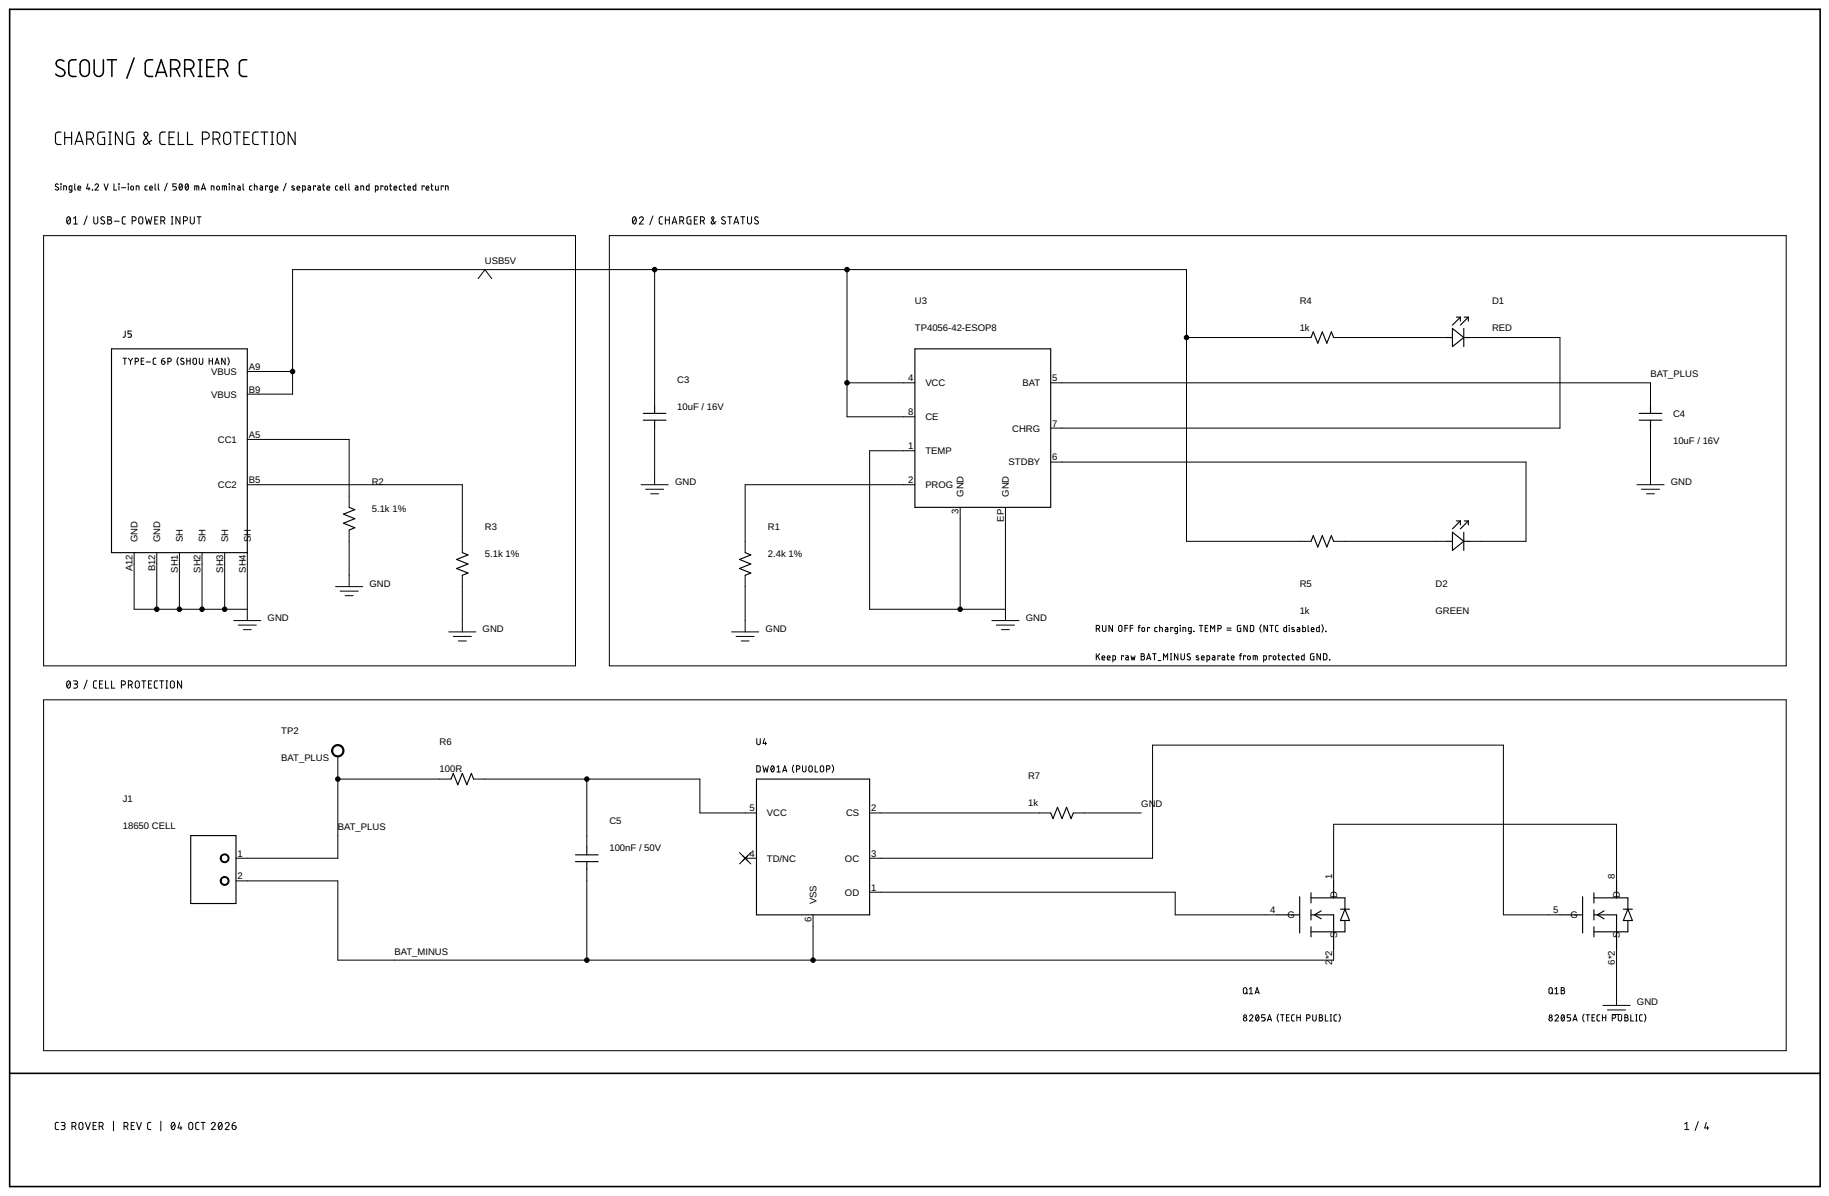
[picture p79: page 1]

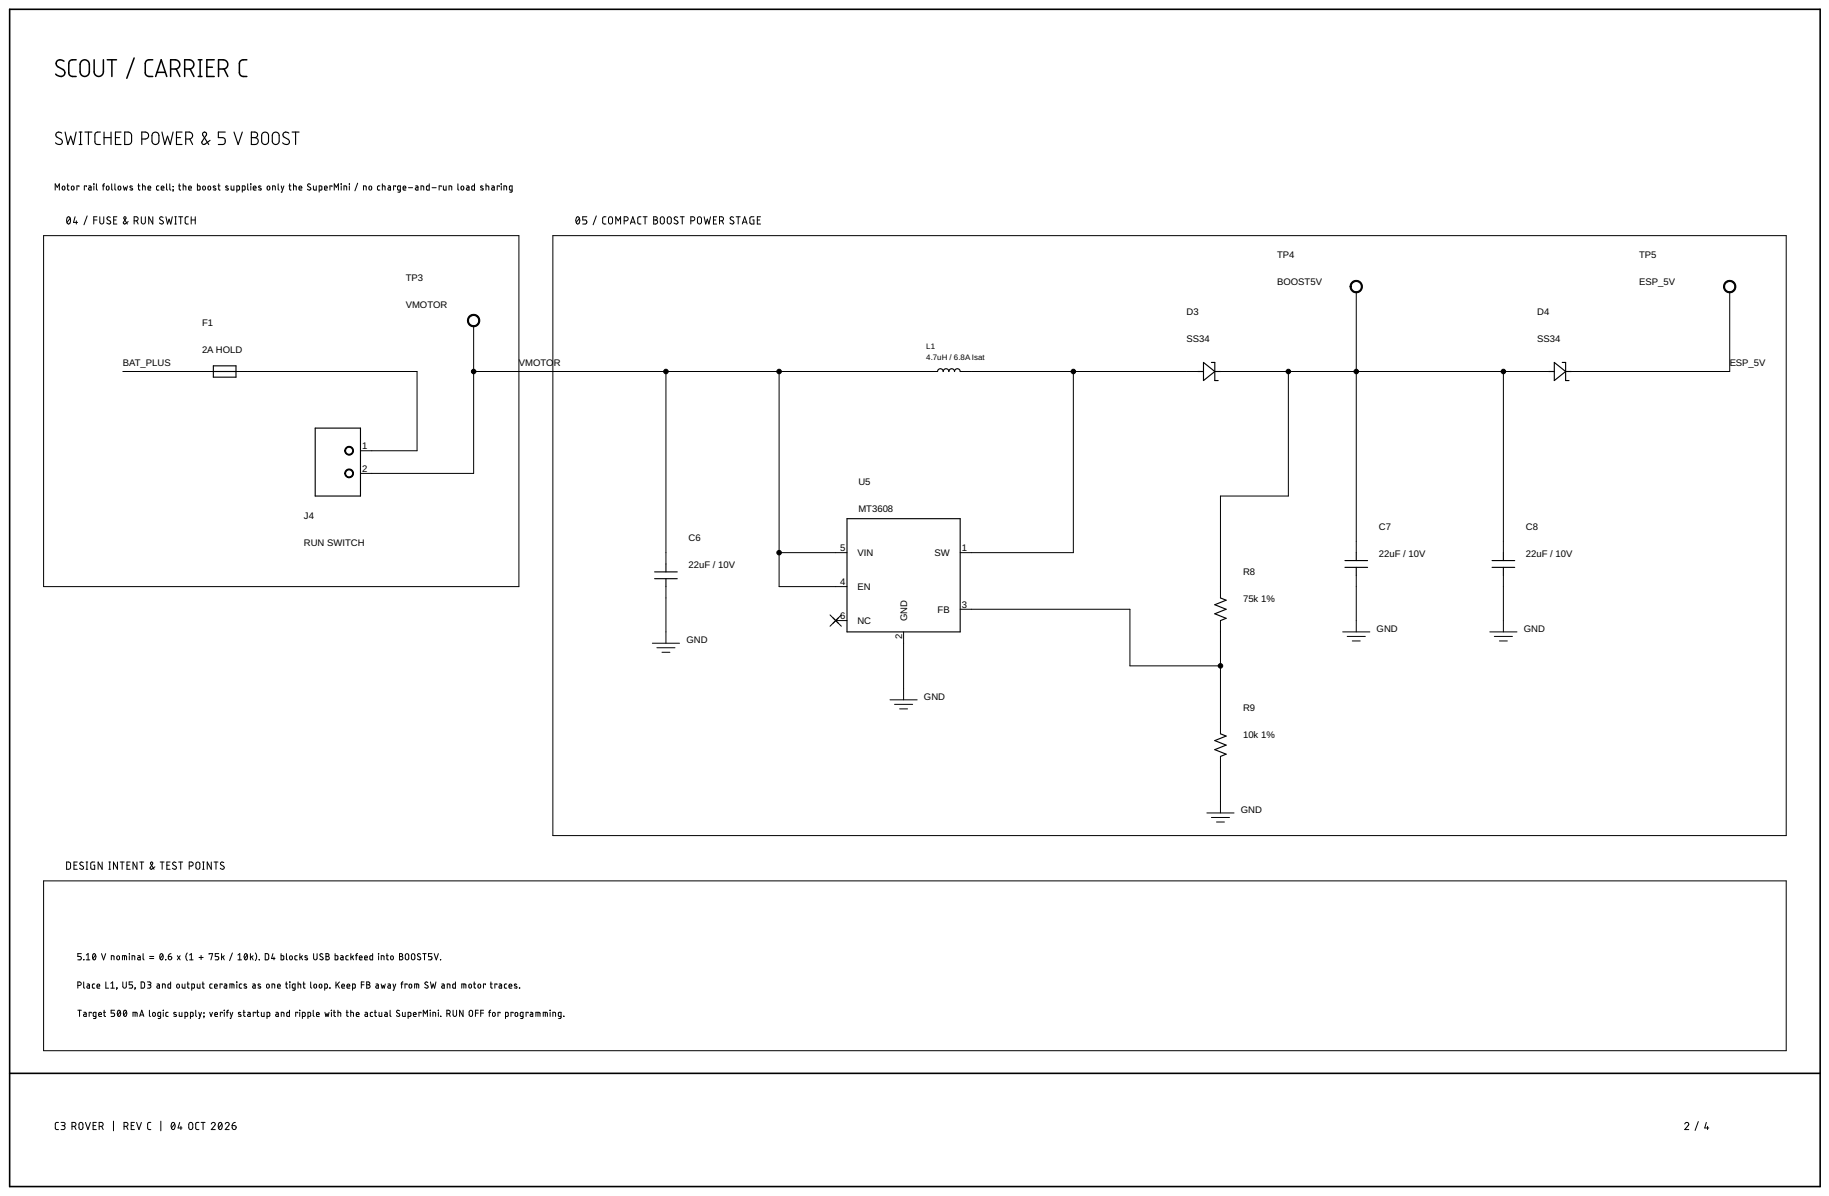
[picture p80: page 2]

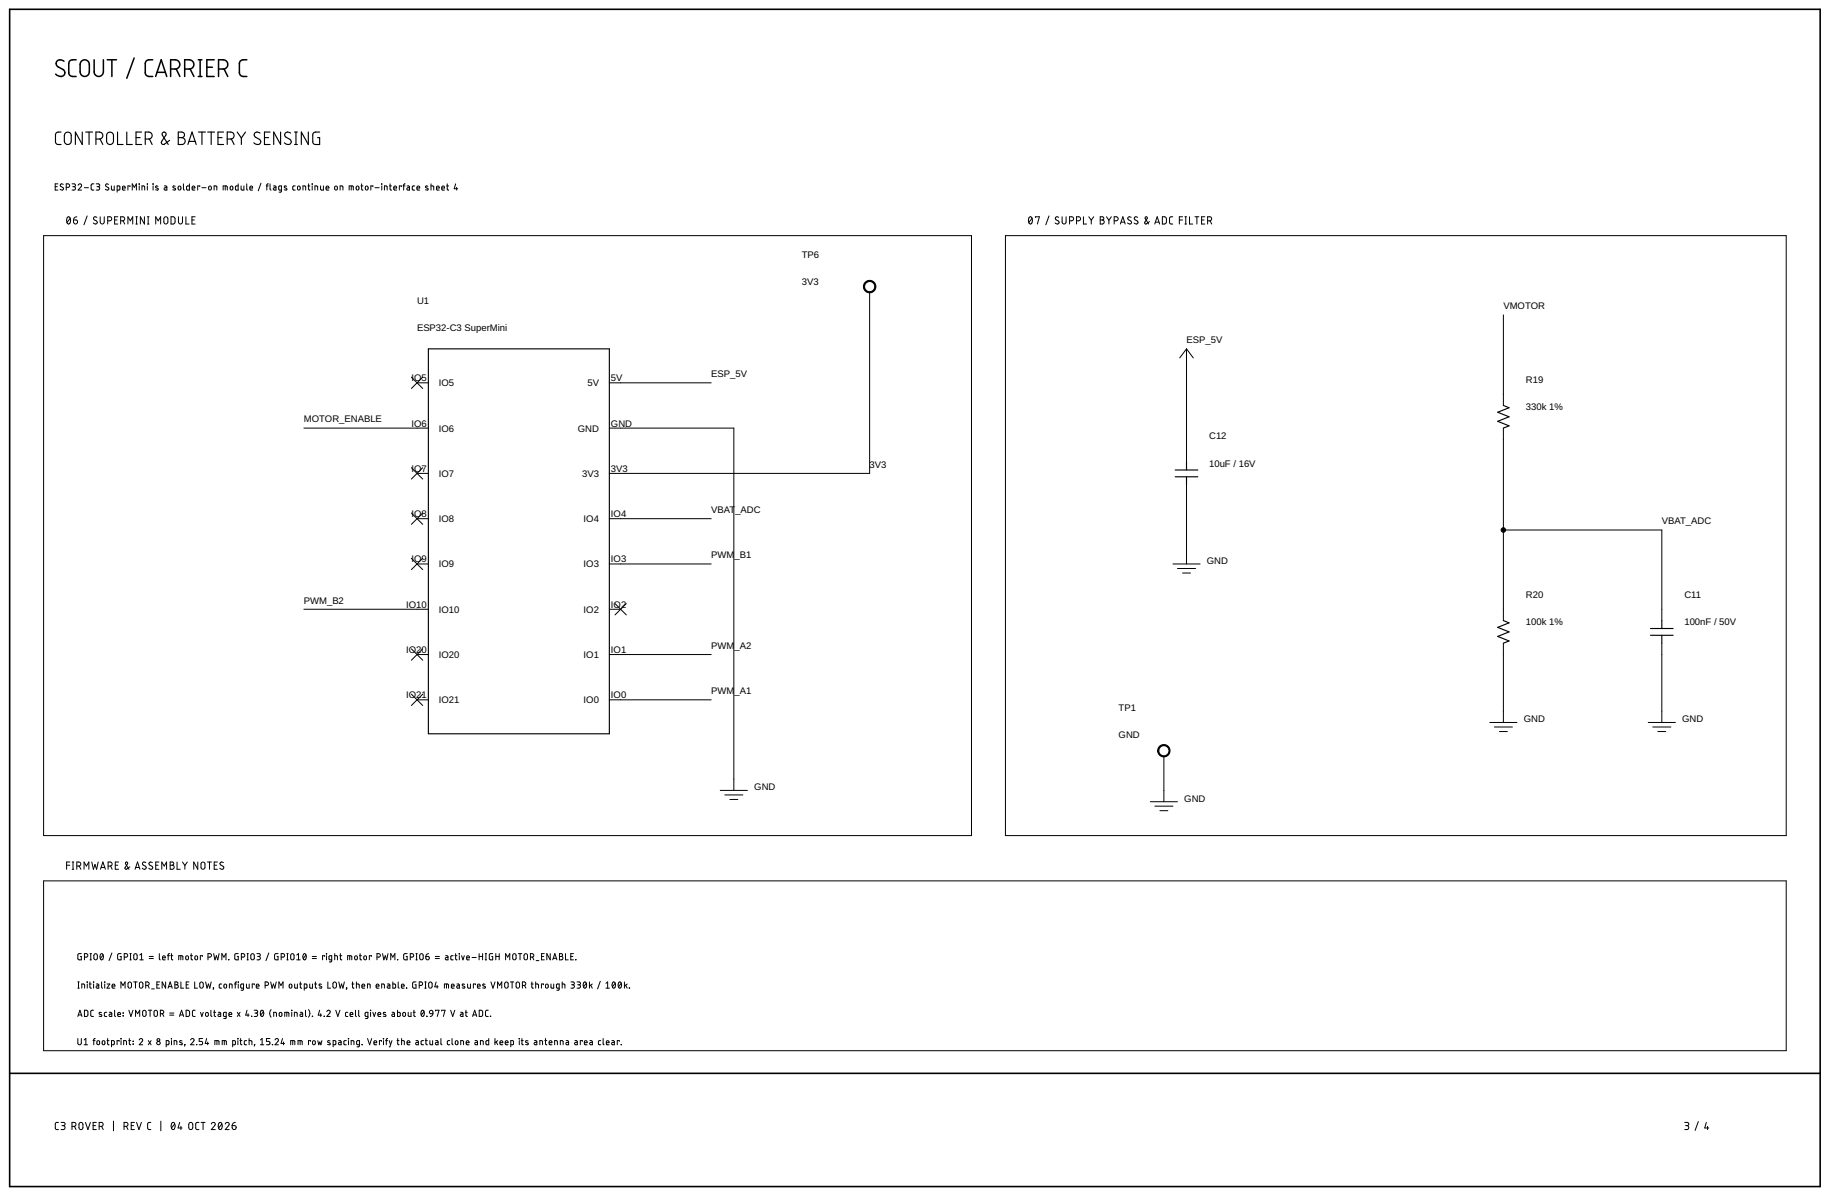
[picture p81: page 3]

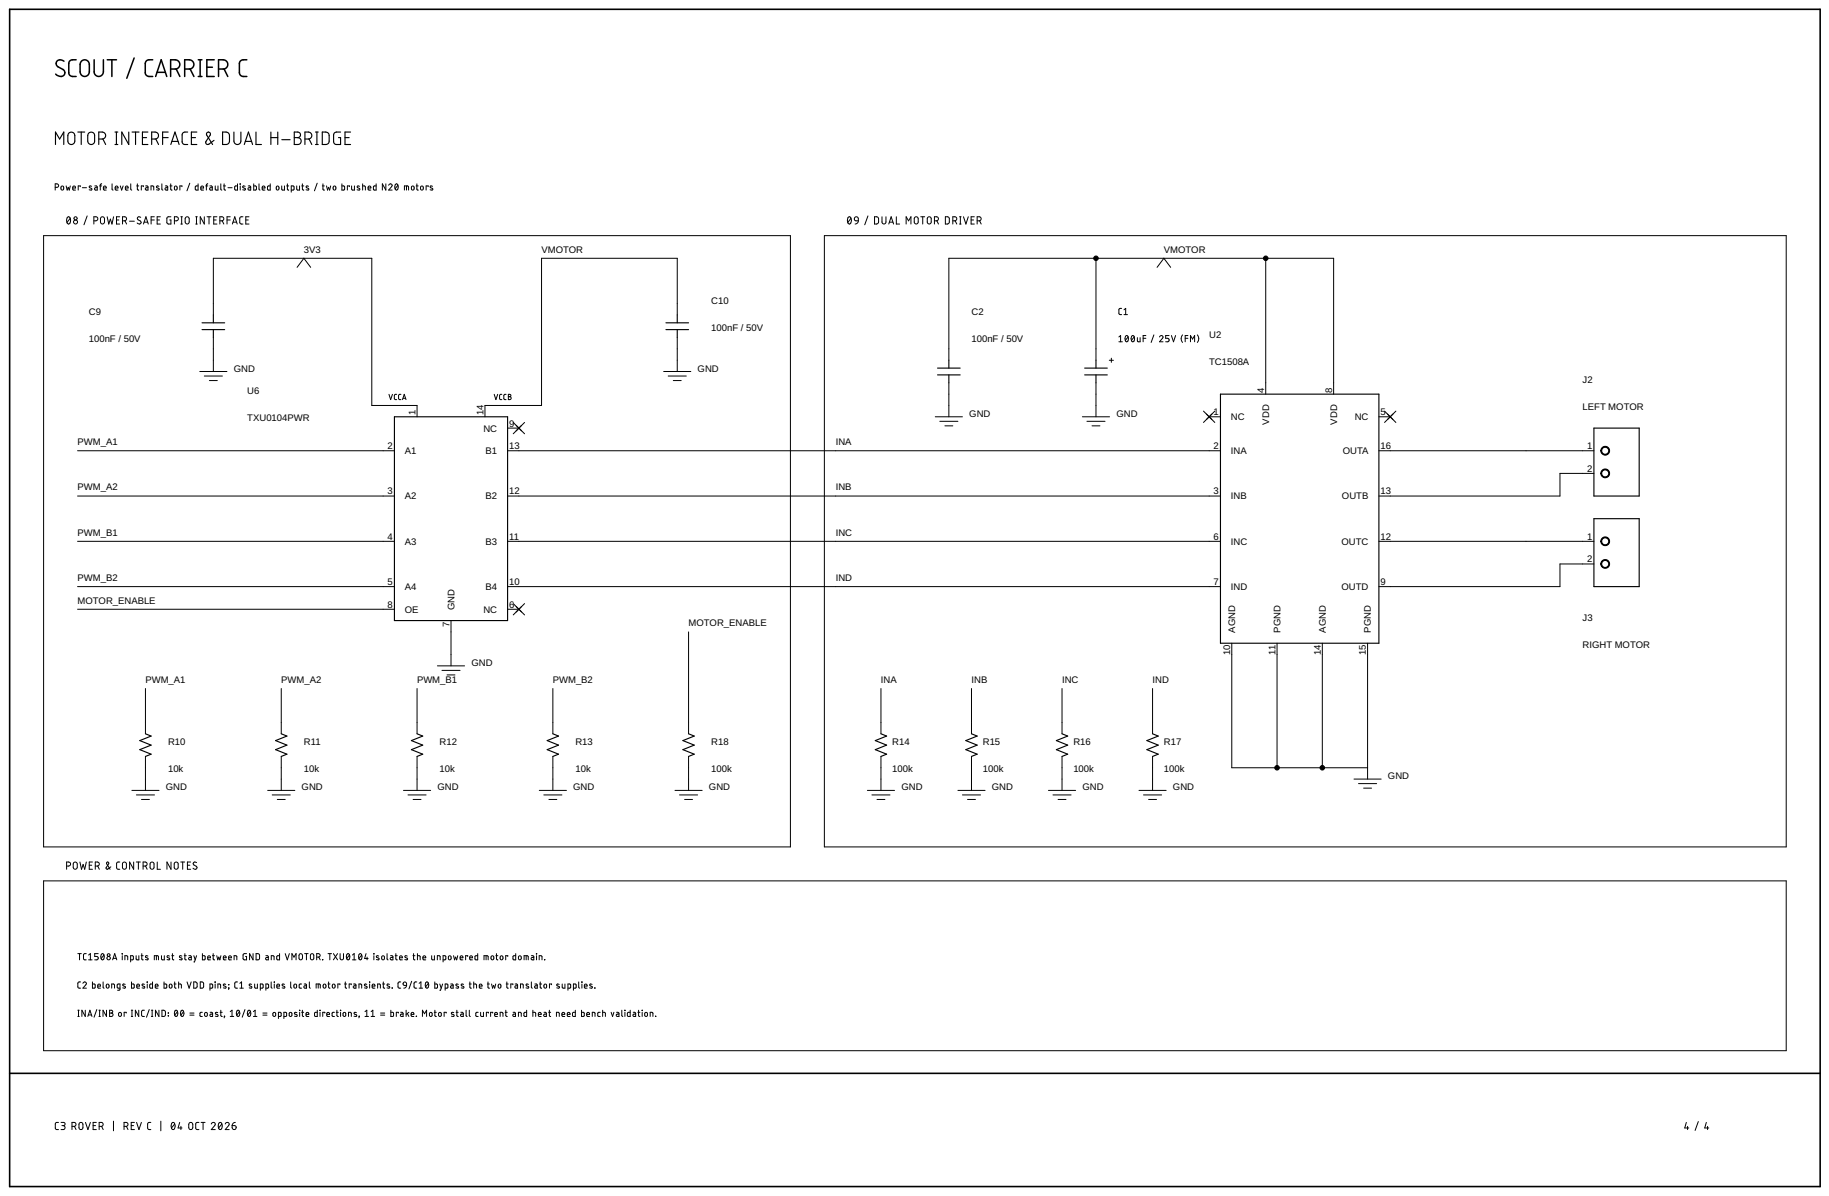
[picture p82: page 4]
