instructorJasonWhite/c3-scout-robot/05-Factory-CarrierC-v10/Fusion-Source/C3-Carrier-RevC-Board-Layout.pdf

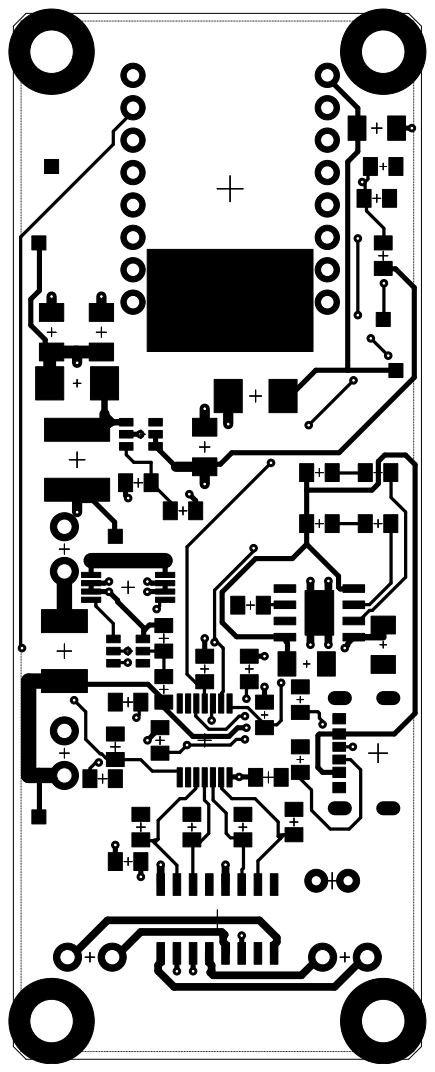
[picture p83: page 1]

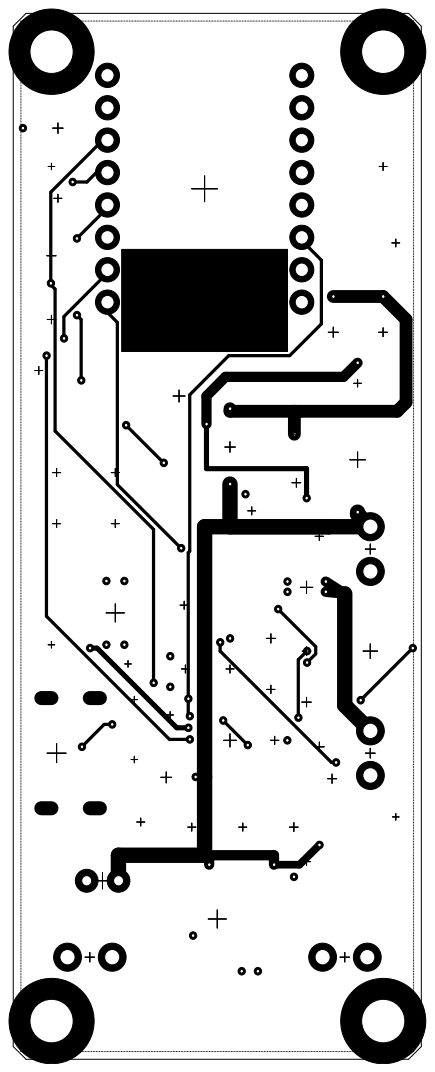
[picture p84: page 2]
