instructorJasonWhite/c3-scout-robot/01-Electronics-CarrierC/C3-Carrier-RevC.brd

## EAGLE design 01-Electronics-CarrierC/C3-Carrier-RevC.brd (2026-10-22)

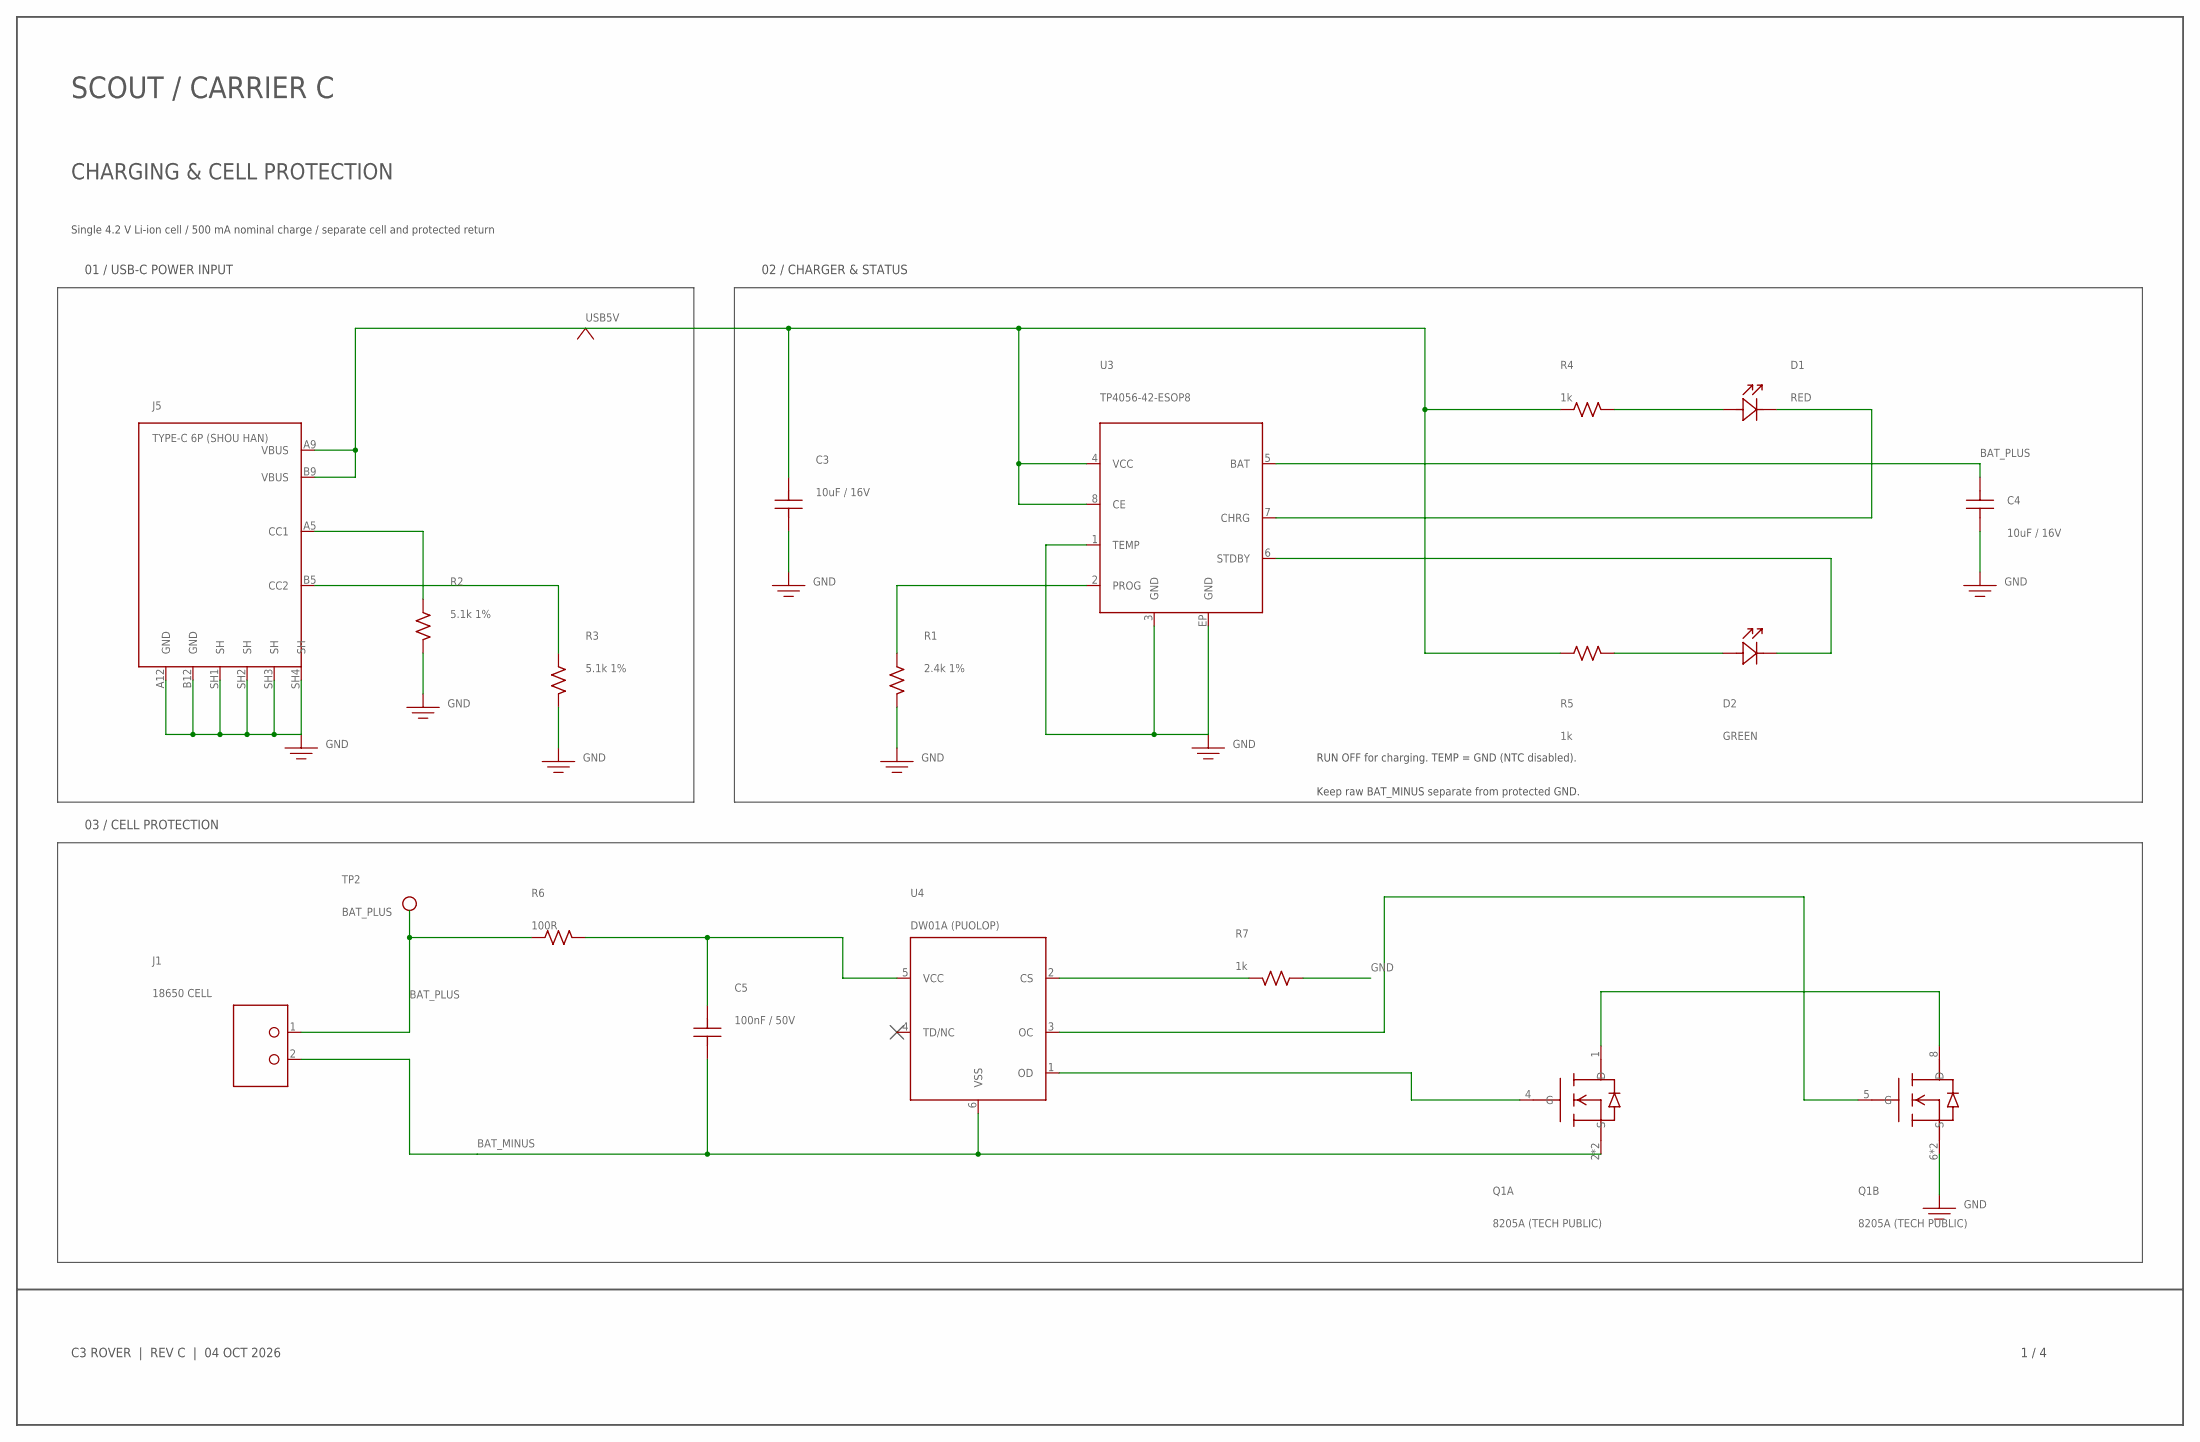
[picture p85: schematic C3-Carrier-RevC.sch, sheet 1, CHARGING & CELL PROTECTION]

Parts:
C3, C4: 10uF / 16V; C1206
C5: 100nF / 50V; C0805
D1: RED; LED0805
D2: GREEN; LED0805
J1: 18650 CELL; WIRE2-3.5
J5: TYPE-C 6P (SHOU HAN); USB-C-SHOUHAN-6P-C456012
Q1: 8205A (TECH PUBLIC); TSSOP8-0.65
R1: 2.4k 1%; R0805
R2, R3: 5.1k 1%; R0805
R4, R5, R7: 1k; R0805
R6: 100R; R0805
TP2: BAT_PLUS; TESTPAD
U3: TP4056-42-ESOP8; ESOP8-EP
U4: DW01A (PUOLOP); SOT23-6

Connections:
BAT_MINUS: C5.2, J1.2, Q1.2 (S), Q1.3 (S), U4.6 (VSS)
BAT_PLUS: C4.1, J1.1, R6.1, TP2.1, U3.5 (BAT); also elsewhere on the board
CC1: J5.A5 (CC1), R2.1
CC2: J5.B5 (CC2), R3.1
CHRG: D1.2, U3.7 (CHRG)
CHRG_LED: D1.1, R4.2
CS: R7.2, U4.2 (CS)
D12: Q1.1 (D), Q1.8 (D)
DW_VCC: C5.1, R6.2, U4.5 (VCC)
FULL_LED: D2.1, R5.2
GND: C3.2, C4.2, J5.A12 (GND), J5.B12 (GND), J5.SH1 (SH), J5.SH2 (SH), J5.SH3 (SH), J5.SH4 (SH), Q1.6 (S), Q1.7 (S), R1.2, R2.2, R3.2, R7.1, U3.1 (TEMP), U3.3 (GND), U3.EP (GND); also elsewhere on the board
OC: Q1.5 (G), U4.3 (OC)
OD: Q1.4 (G), U4.1 (OD)
PROG: R1.1, U3.2 (PROG)
STDBY: D2.2, U3.6 (STDBY)
USB5V: C3.1, J5.A9 (VBUS), J5.B9 (VBUS), R4.1, R5.1, U3.4 (VCC), U3.8 (CE)

Notes on the sheet:
SCOUT / CARRIER C
CHARGING & CELL PROTECTION
Single 4.2 V Li-ion cell / 500 mA nominal charge / separate cell and protected return
C3 ROVER | REV C | 04 OCT 2026
1 / 4
01 / USB-C POWER INPUT
02 / CHARGER & STATUS
03 / CELL PROTECTION
RUN OFF for charging. TEMP = GND (NTC disabled).
Keep raw BAT_MINUS separate from protected GND.

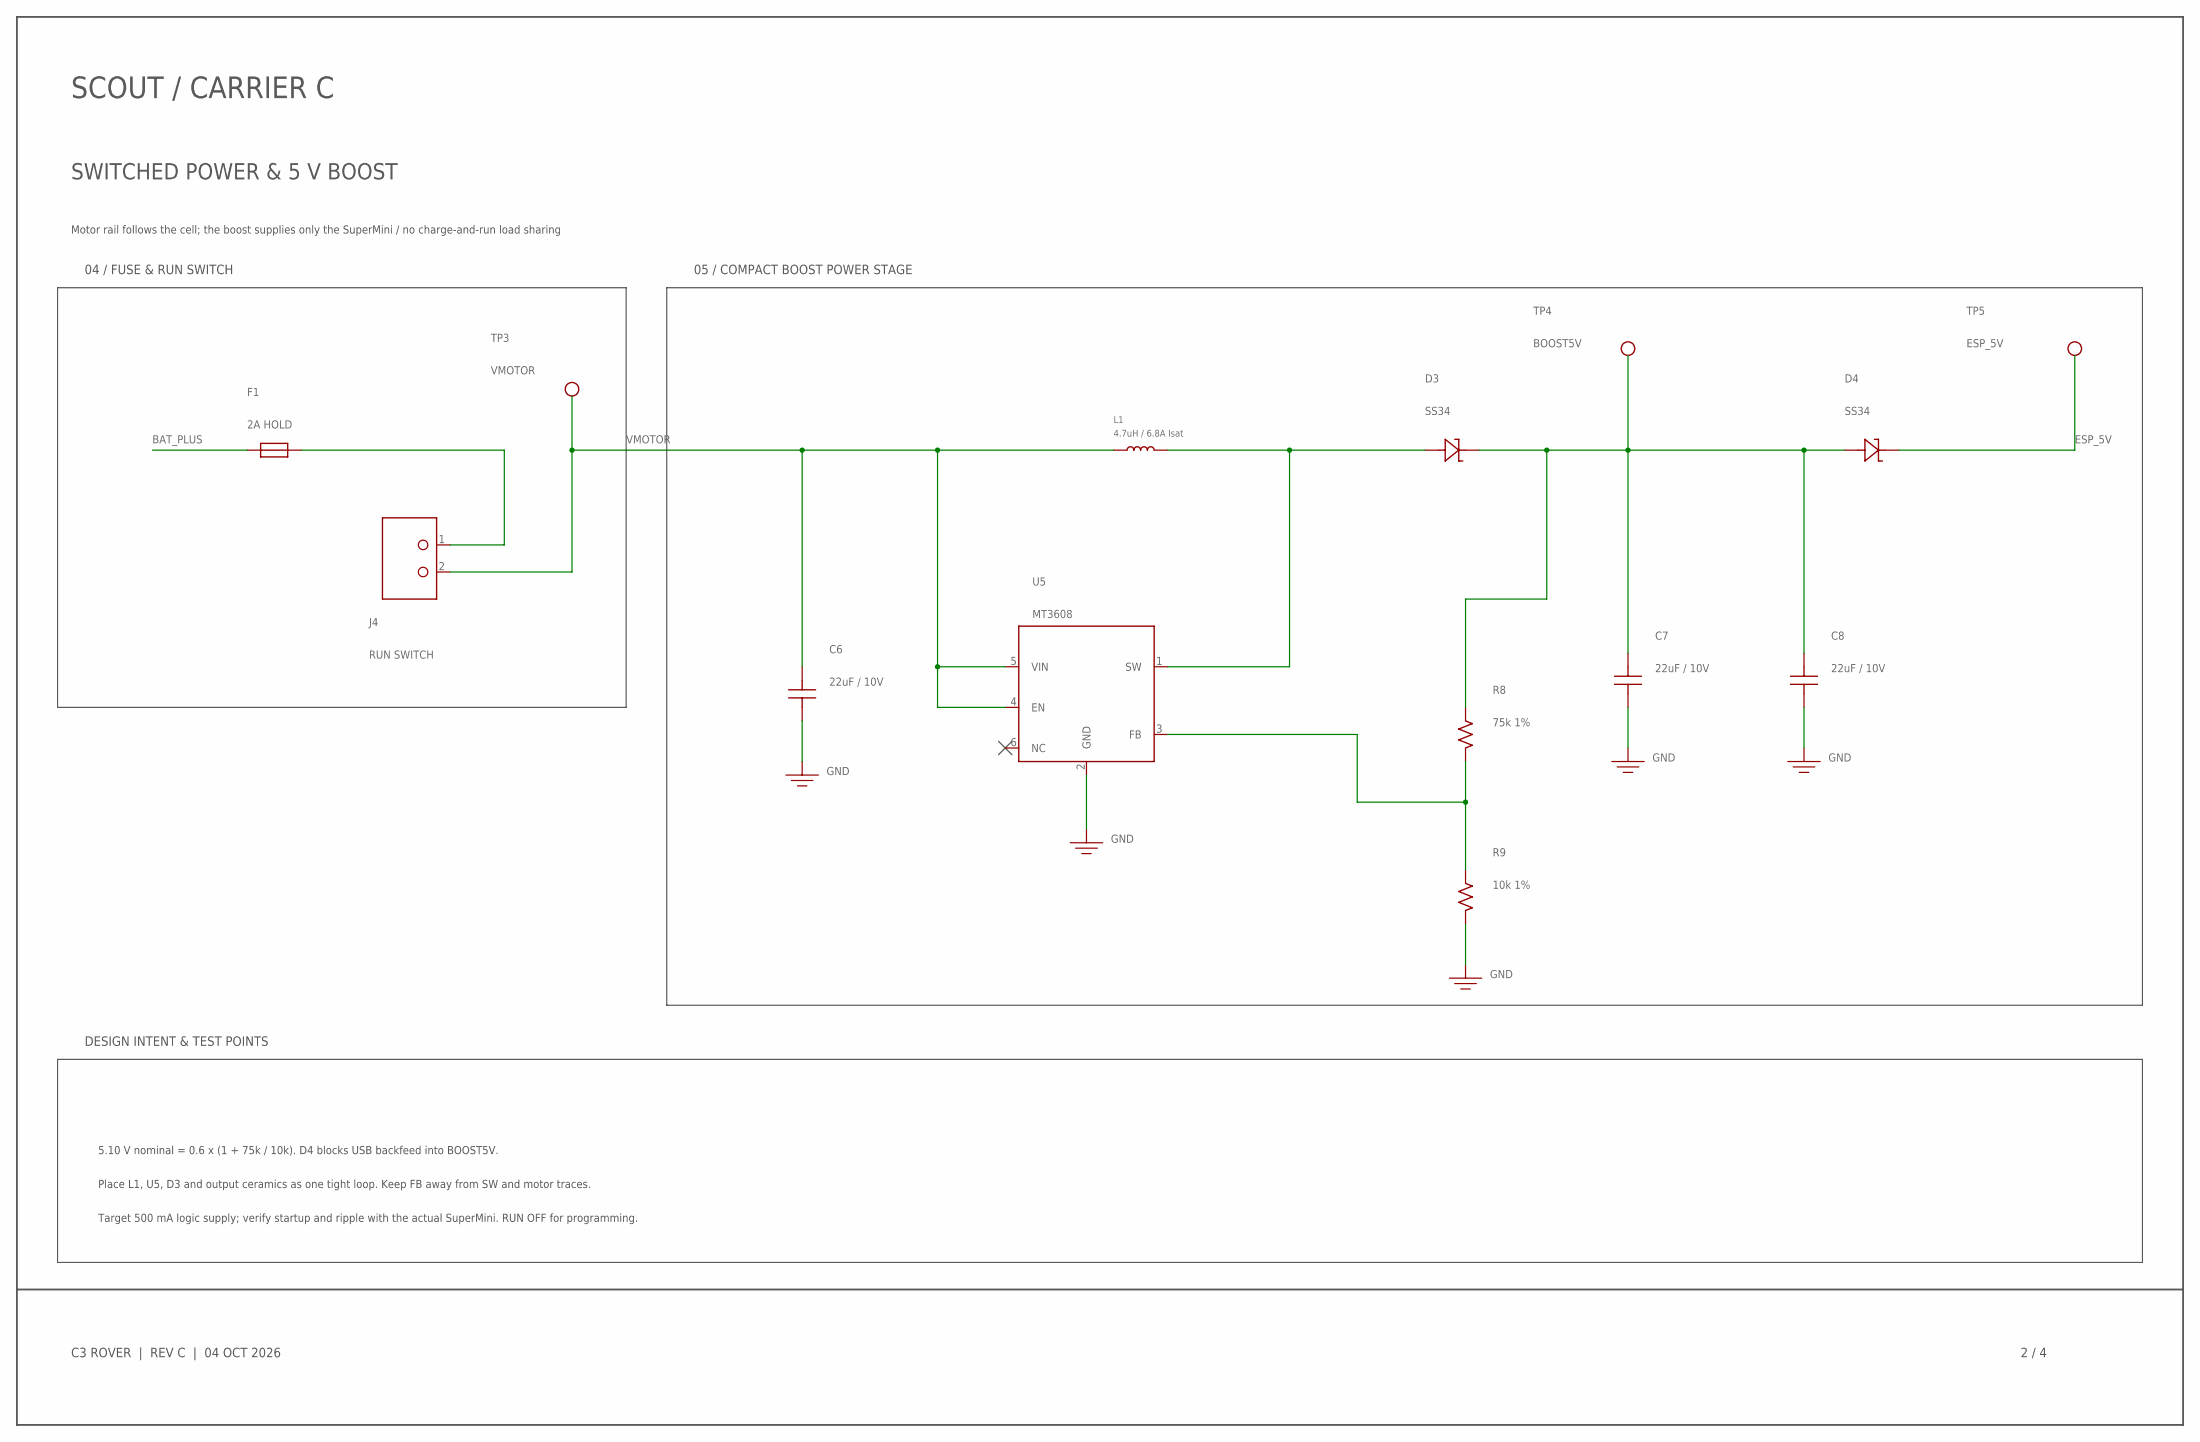
[picture p86: schematic C3-Carrier-RevC.sch, sheet 2, SWITCHED POWER & 5 V BOOST]

Parts:
C6, C7, C8: 22uF / 10V; C1206
D3, D4: SS34; SMA
F1: 2A HOLD; F1812
J4: RUN SWITCH; WIRE2-3.5
L1: 4.7uH / 6.8A Isat; L6
R8: 75k 1%; R0805
R9: 10k 1%; R0805
TP3: VMOTOR; TESTPAD
TP4: BOOST5V; TESTPAD
TP5: ESP_5V; TESTPAD
U5: MT3608; SOT23-6

Connections:
BAT_PLUS: F1.1; also elsewhere on the board
BOOST5V: C7.1, C8.1, D3.1, D4.2, R8.1, TP4.1
ESP_5V: D4.1, TP5.1; also elsewhere on the board
FB: R8.2, R9.1, U5.3 (FB)
FUSED_BAT: F1.2, J4.1
GND: C6.2, C7.2, C8.2, R9.2, U5.2 (GND); also elsewhere on the board
SW: D3.2, L1.2, U5.1 (SW)
VMOTOR: C6.1, J4.2, L1.1, TP3.1, U5.4 (EN), U5.5 (VIN); also elsewhere on the board

Notes on the sheet:
SCOUT / CARRIER C
SWITCHED POWER & 5 V BOOST
Motor rail follows the cell; the boost supplies only the SuperMini / no charge-and-run load sharing
C3 ROVER | REV C | 04 OCT 2026
2 / 4
04 / FUSE & RUN SWITCH
05 / COMPACT BOOST POWER STAGE
DESIGN INTENT & TEST POINTS
5.10 V nominal = 0.6 x (1 + 75k / 10k). D4 blocks USB backfeed into BOOST5V.
Place L1, U5, D3 and output ceramics as one tight loop. Keep FB away from SW and motor traces.
Target 500 mA logic supply; verify startup and ripple with the actual SuperMini. RUN OFF for programming.

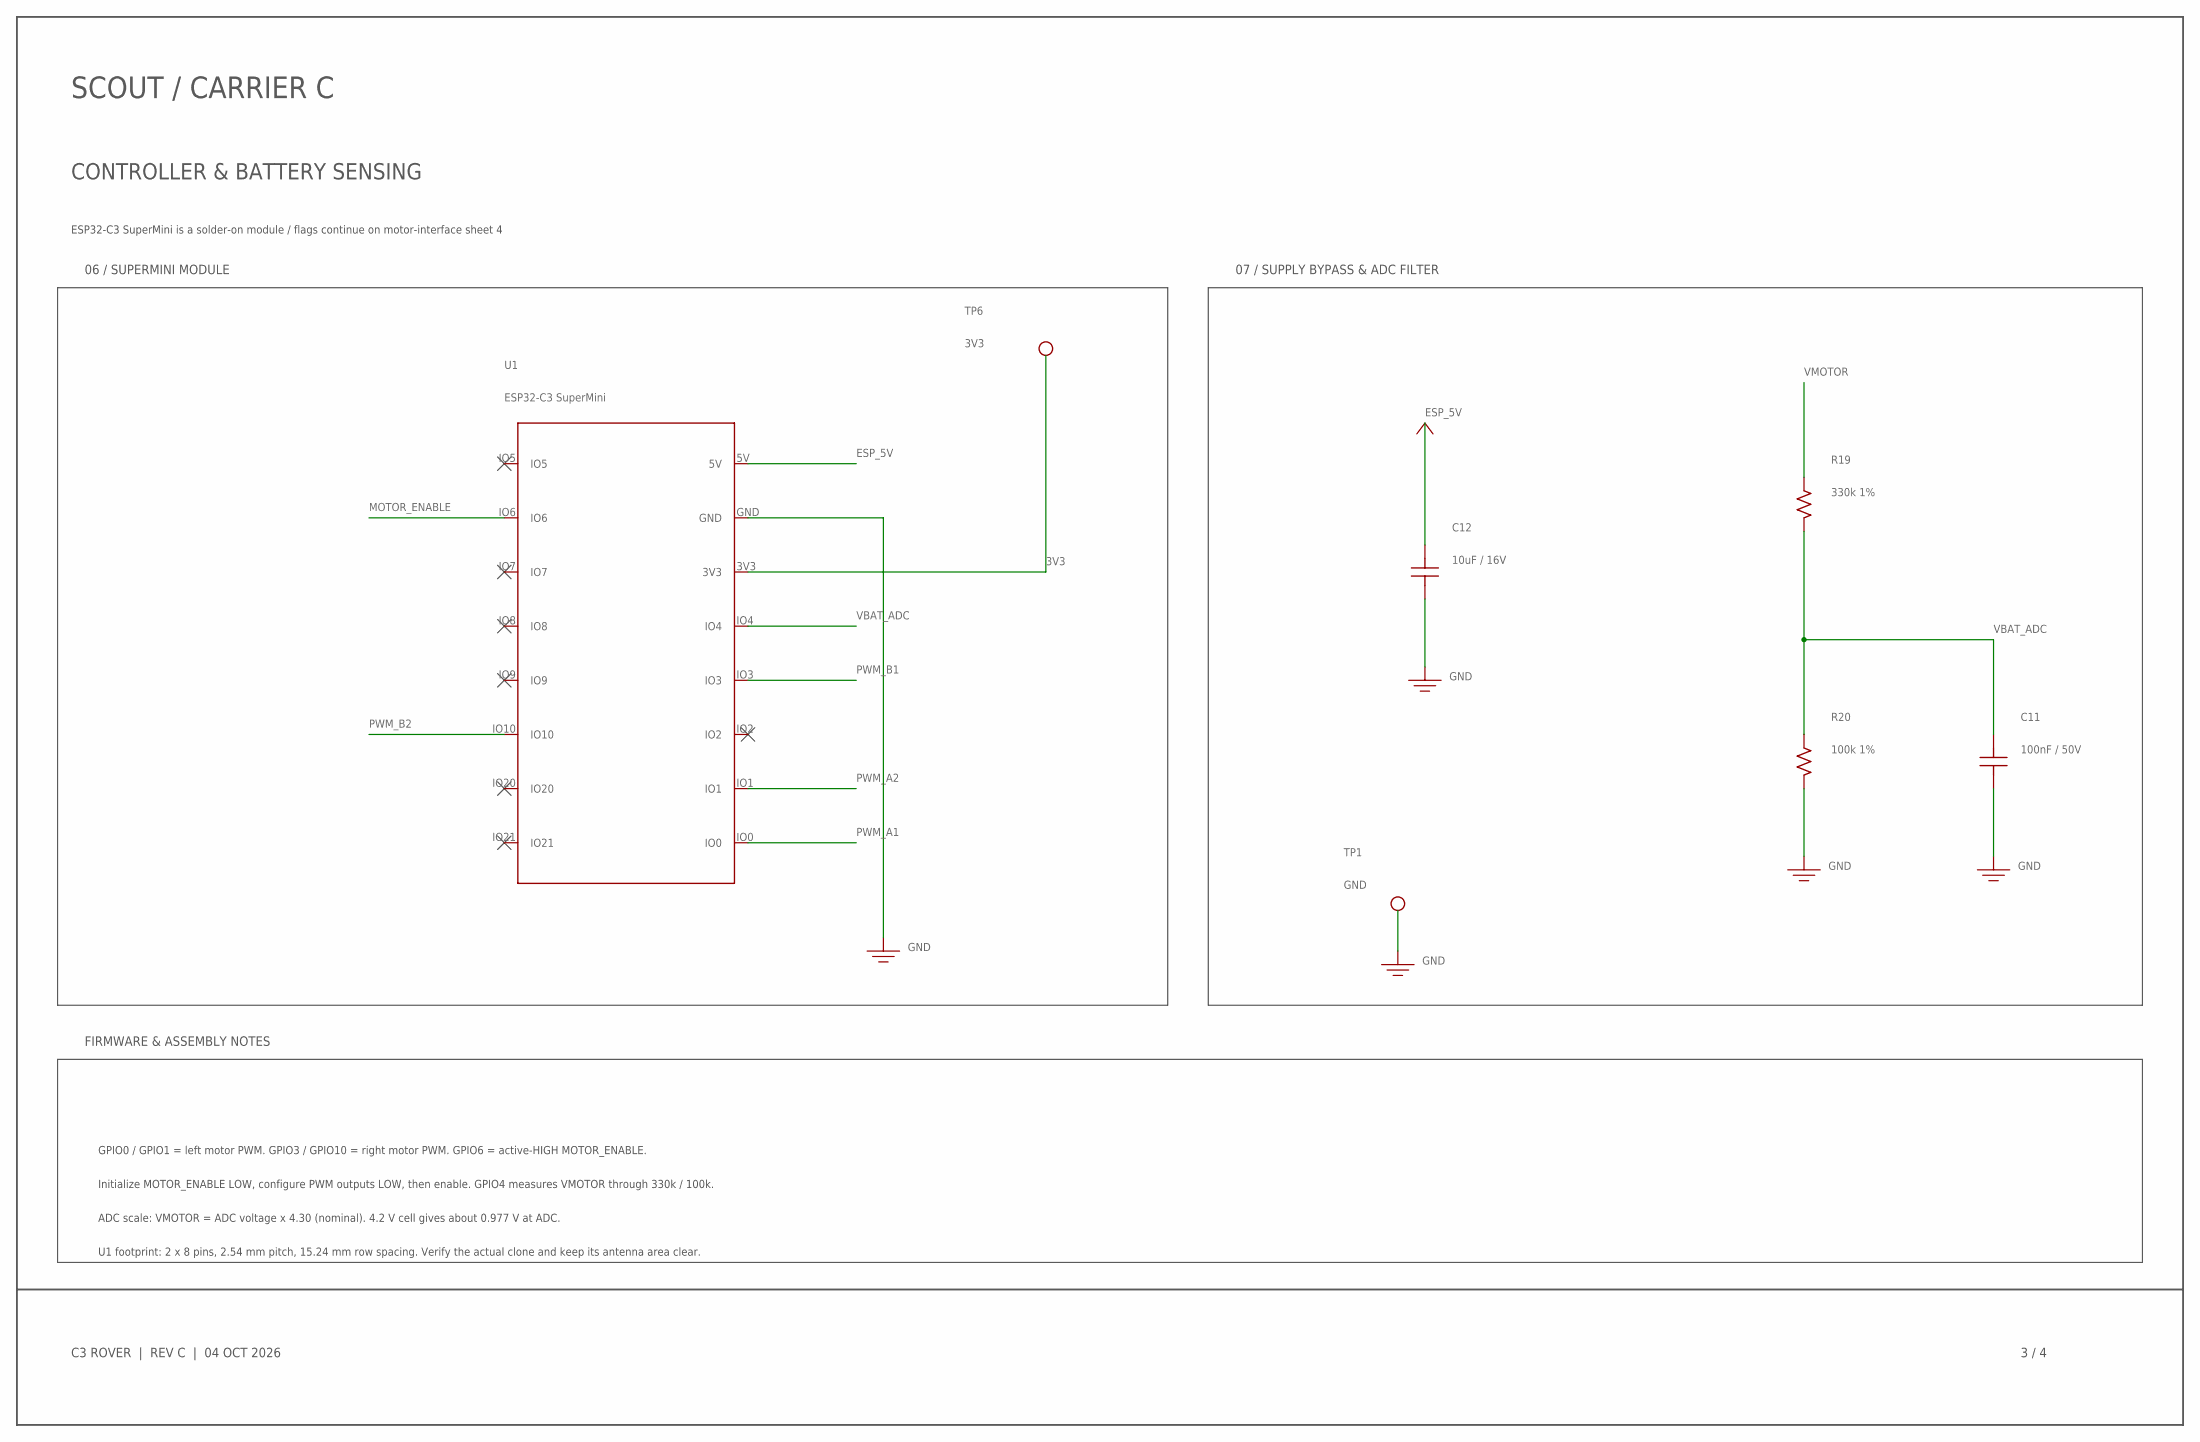
[picture p87: schematic C3-Carrier-RevC.sch, sheet 3, CONTROLLER & BATTERY SENSING]

Parts:
C11: 100nF / 50V; C0805
C12: 10uF / 16V; C1206
R19: 330k 1%; R0805
R20: 100k 1%; R0805
TP1: GND; TESTPAD
TP6: 3V3; TESTPAD
U1: ESP32-C3 SuperMini; SUPERMINI-2X8-15.24

Connections:
3V3: TP6.1, U1.3V3; also elsewhere on the board
ESP_5V: C12.1, U1.5V; also elsewhere on the board
GND: C11.2, C12.2, R20.2, TP1.1, U1.GND; also elsewhere on the board
MOTOR_ENABLE: U1.IO6; also elsewhere on the board
PWM_A1: U1.IO0; also elsewhere on the board
PWM_A2: U1.IO1; also elsewhere on the board
PWM_B1: U1.IO3; also elsewhere on the board
PWM_B2: U1.IO10; also elsewhere on the board
VBAT_ADC: C11.1, R19.2, R20.1, U1.IO4
VMOTOR: R19.1; also elsewhere on the board

Notes on the sheet:
SCOUT / CARRIER C
CONTROLLER & BATTERY SENSING
ESP32-C3 SuperMini is a solder-on module / flags continue on motor-interface sheet 4
C3 ROVER | REV C | 04 OCT 2026
3 / 4
06 / SUPERMINI MODULE
07 / SUPPLY BYPASS & ADC FILTER
FIRMWARE & ASSEMBLY NOTES
GPIO0 / GPIO1 = left motor PWM. GPIO3 / GPIO10 = right motor PWM. GPIO6 = active-HIGH MOTOR_ENABLE.
Initialize MOTOR_ENABLE LOW, configure PWM outputs LOW, then enable. GPIO4 measures VMOTOR through 330k / 100k.
ADC scale: VMOTOR = ADC voltage x 4.30 (nominal). 4.2 V cell gives about 0.977 V at ADC.
U1 footprint: 2 x 8 pins, 2.54 mm pitch, 15.24 mm row spacing. Verify the actual clone and keep its antenna area clear.

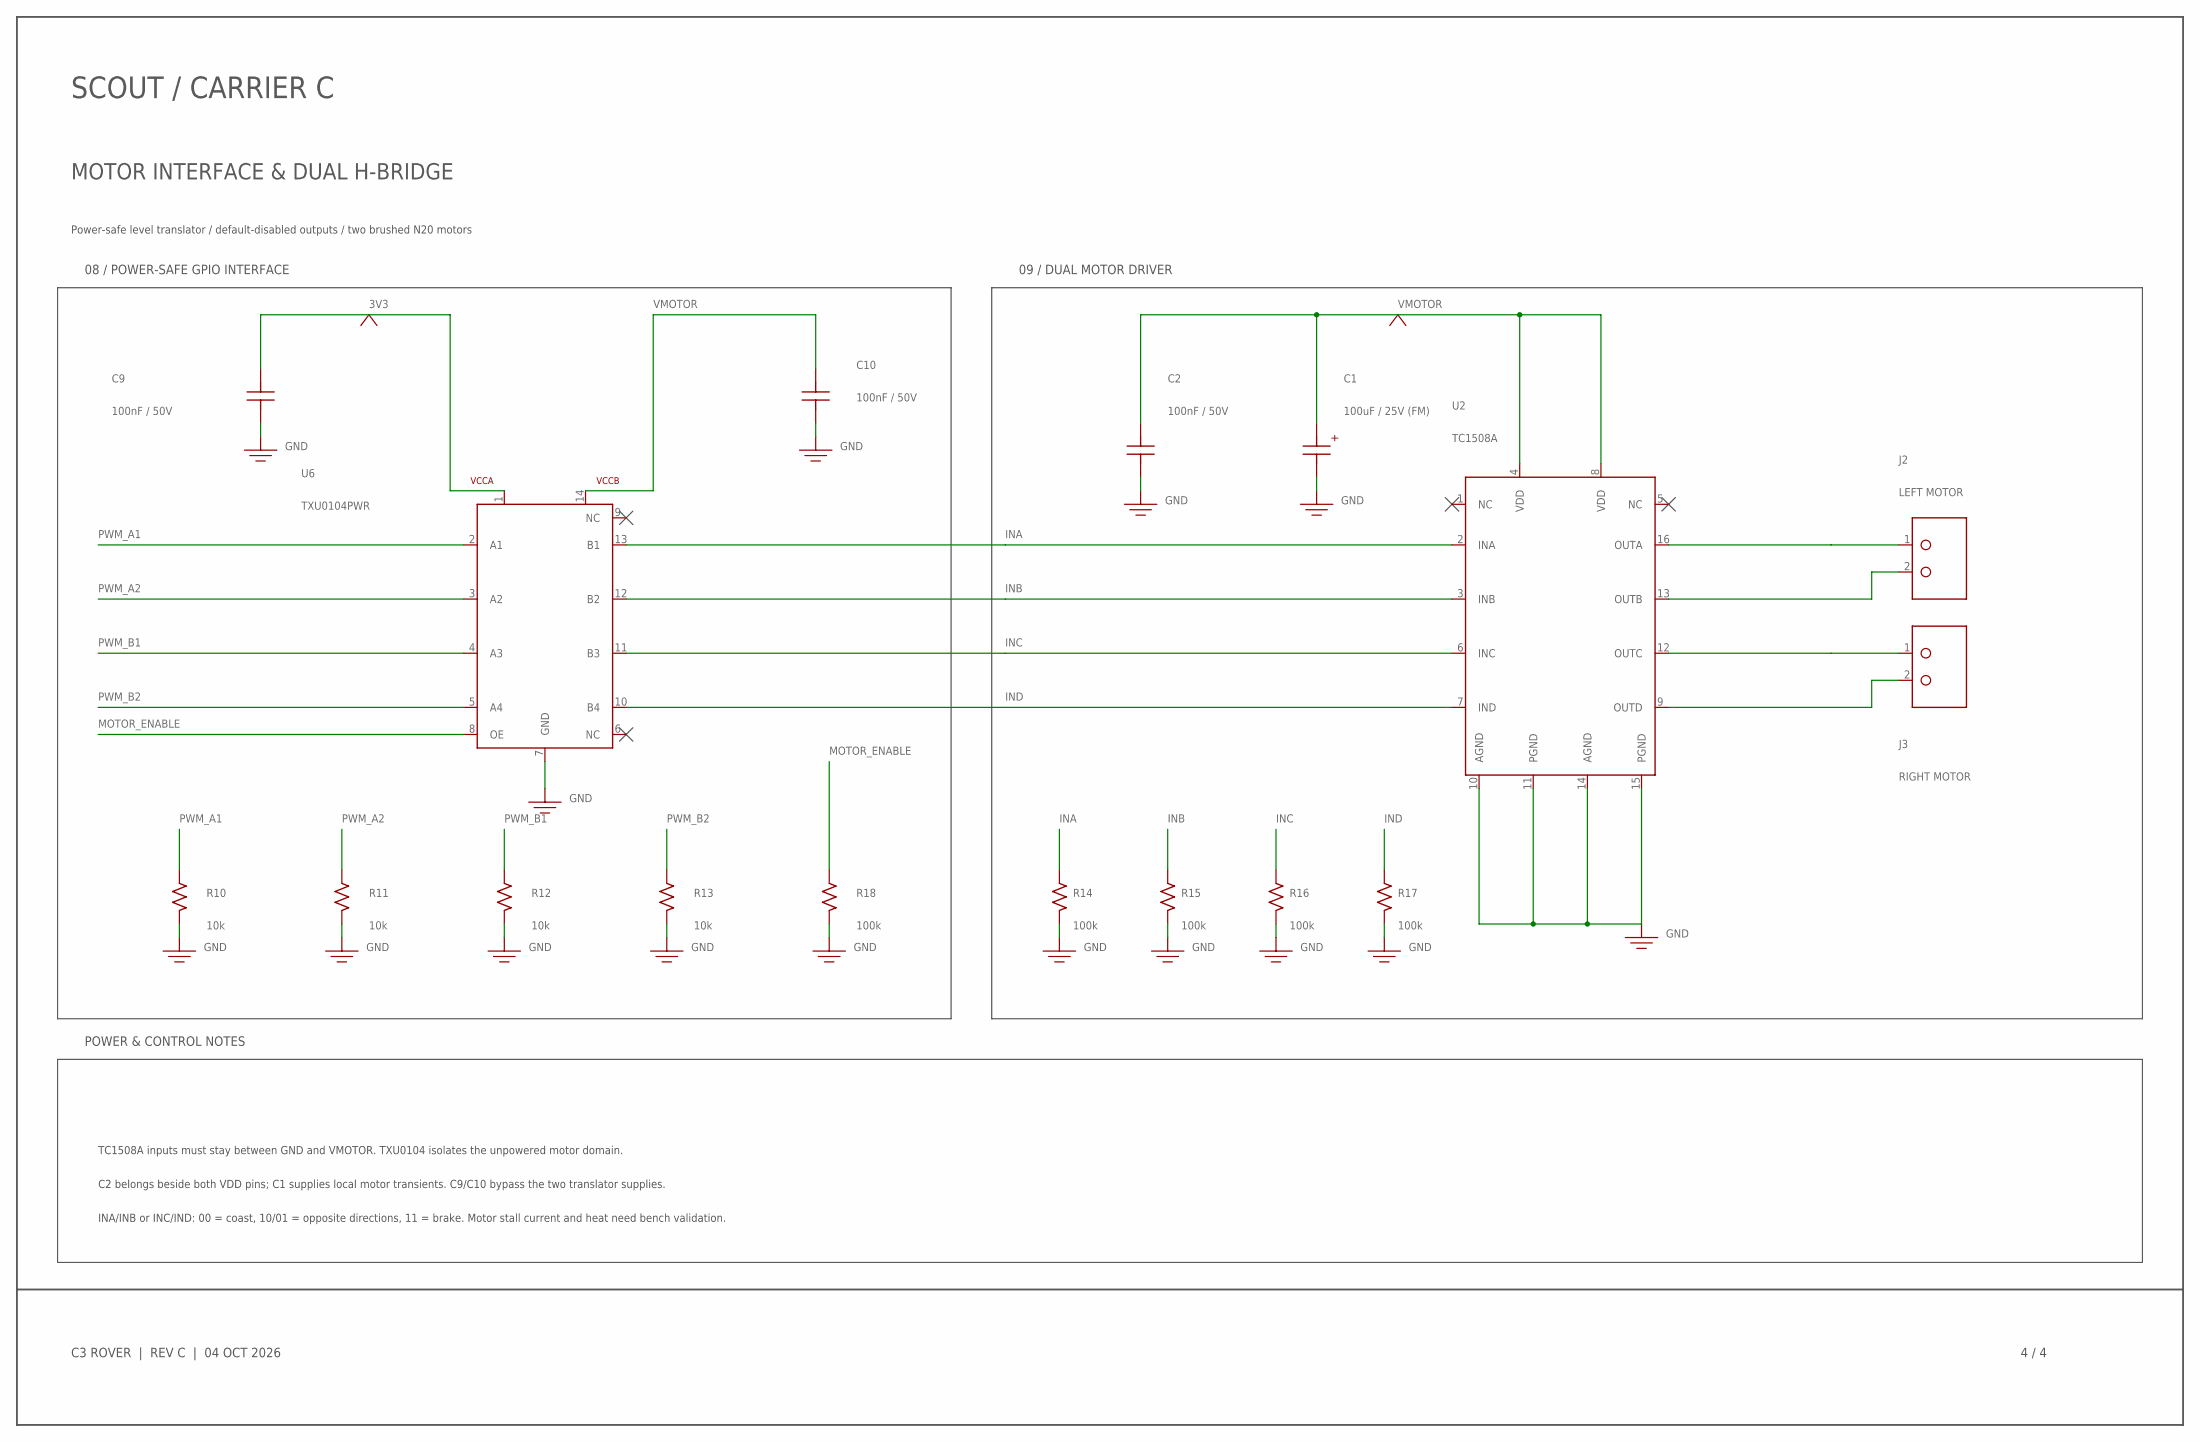
[picture p88: schematic C3-Carrier-RevC.sch, sheet 4, MOTOR INTERFACE & DUAL H-BRIDGE]

Parts:
C1: 100uF / 25V (FM); RADIAL-6.3-2.5
C2, C9, C10: 100nF / 50V; C0805
J2: LEFT MOTOR; WIRE2-3.5
J3: RIGHT MOTOR; WIRE2-3.5
R10, R11, R12, R13: 10k; R0805
R14, R15, R16, R17, R18: 100k; R0805
U2: TC1508A; SOIC16-1.27
U6: TXU0104PWR; TSSOP14-0.65

Connections:
3V3: C9.1, U6.1 (VCCA); also elsewhere on the board
GND: C1.2, C2.2, C9.2, C10.2, R10.2, R11.2, R12.2, R13.2, R14.2, R15.2, R16.2, R17.2, R18.2, U2.10 (AGND), U2.11 (PGND), U2.14 (AGND), U2.15 (PGND), U6.7 (GND); also elsewhere on the board
INA: R14.1, U2.2 (INA), U6.13 (B1)
INB: R15.1, U2.3 (INB), U6.12 (B2)
INC: R16.1, U2.6 (INC), U6.11 (B3)
IND: R17.1, U2.7 (IND), U6.10 (B4)
MOTOR_A1: J2.1, U2.16 (OUTA)
MOTOR_A2: J2.2, U2.13 (OUTB)
MOTOR_B1: J3.1, U2.12 (OUTC)
MOTOR_B2: J3.2, U2.9 (OUTD)
MOTOR_ENABLE: R18.1, U6.8 (OE); also elsewhere on the board
PWM_A1: R10.1, U6.2 (A1); also elsewhere on the board
PWM_A2: R11.1, U6.3 (A2); also elsewhere on the board
PWM_B1: R12.1, U6.4 (A3); also elsewhere on the board
PWM_B2: R13.1, U6.5 (A4); also elsewhere on the board
VMOTOR: C1.1, C2.1, C10.1, U2.4 (VDD), U2.8 (VDD), U6.14 (VCCB); also elsewhere on the board

Notes on the sheet:
SCOUT / CARRIER C
MOTOR INTERFACE & DUAL H-BRIDGE
Power-safe level translator / default-disabled outputs / two brushed N20 motors
C3 ROVER | REV C | 04 OCT 2026
4 / 4
08 / POWER-SAFE GPIO INTERFACE
09 / DUAL MOTOR DRIVER
POWER & CONTROL NOTES
TC1508A inputs must stay between GND and VMOTOR. TXU0104 isolates the unpowered motor domain.
C2 belongs beside both VDD pins; C1 supplies local motor transients. C9/C10 bypass the two translator supplies.
INA/INB or INC/IND: 00 = coast, 10/01 = opposite directions, 11 = brake. Motor stall current and heat need bench validation.

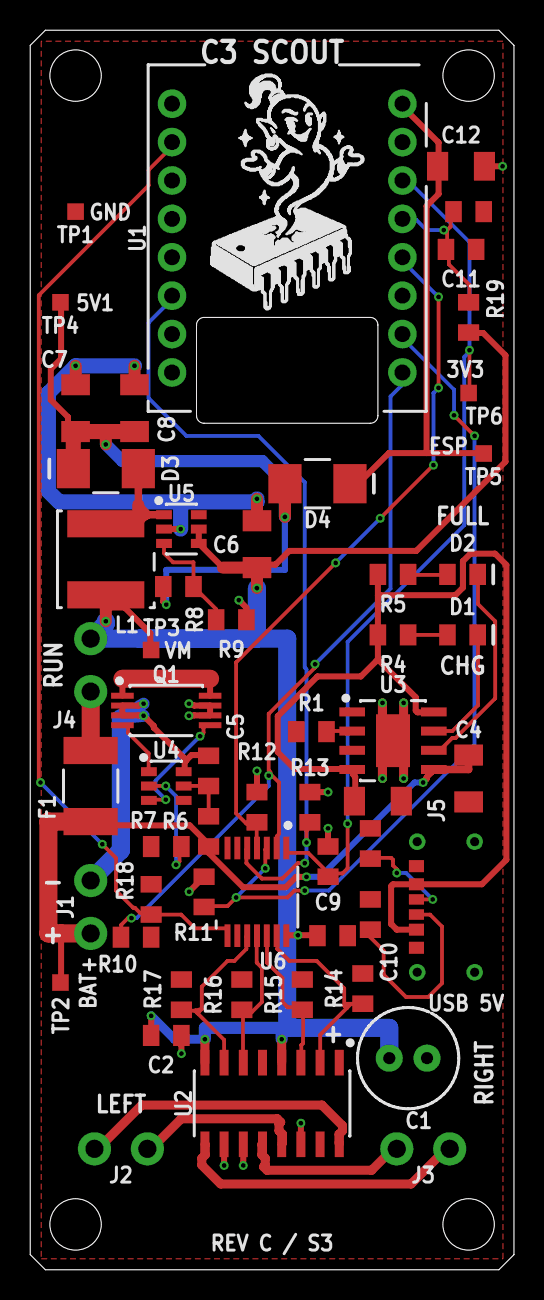
[picture p89: board C3-Carrier-RevC.brd from above]

Board: 2 copper layers, 32.0 x 82.0 mm, 56 parts (0 on the bottom side), 37 nets.
