instructorJasonWhite/c3-scout-robot/(commit log)

2026-10-22 Sync current Scout guide, firmware, Faces and v8 cases
2026-10-25 Document OLED wiring with an ESP32-C3 pinout diagram
2026-10-25 Add complete robot wiring picture and assembly checklist
